mho-jwi/MA/Minitab/Auswertung/160803Präsi.pptx

Problem: Nur Variation der AUL-nicht der ABL-Temperatur
- Vermengung der Effekte von Membrantemperatur und Temperaturdifferenz
- Bei geringen Temperaturdifferenzen (T_AUL = ca. 21 °C) hohe Fehler

Temperaturaußreißer beseitigt
Bei Tm = 25 (T_AUL = 30) läuft der Wärmetransport in die entgegengesetzte Richtung, der k-Wert weicht stark von den anderen ab, sonst keine Anderen Randbedingungen gegenüber den
Bei ca. 18 °C gibt es einen sehr großen Sprung, unwahrscheinlich.
Evtl. durch Nähe zu T_ABL

## Slide 2

Wirkung auf Sensible Größen scheint aber Hauptsächlich von den Temperaturen beeinflusst zu werden

Nur ein Haupteffekt betrachtet, der Wahrscheinlichste
Tm
Wiederanstieg des k-Wertes bei Temperaturen um den Gefrierpunkt (vereisen?)

## Slide 3

Auch Bei den latenten Größen kommt der Haupteinfluss aus den Temperaturgrößen
Gleiches Problem wie eben, keine Trennung von dT und Tm möglich

Manuell keine Effekte erkennbar
