mho-jwi/MA/(B) Klimaprüfstand/Doku/Luftanschluesse.pptx

## Zuluft-Sorptionstrockner

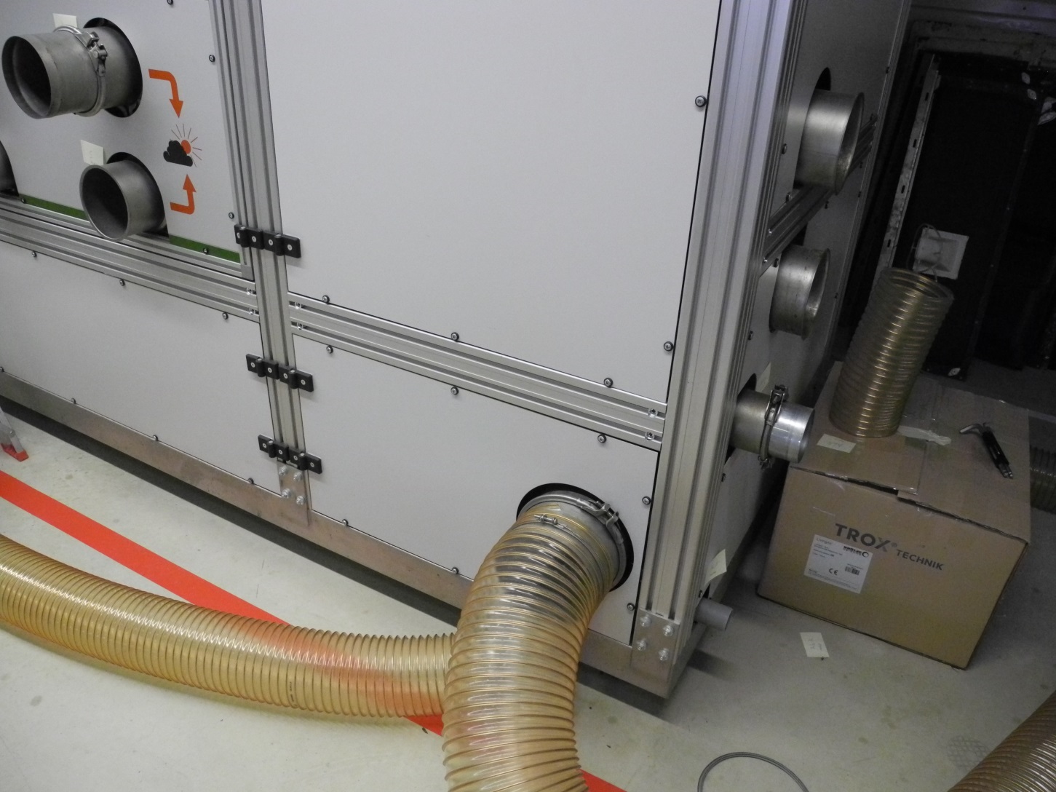
[picture p7: figure]

Ø 200 mm

## Prüfstand-Prüfling

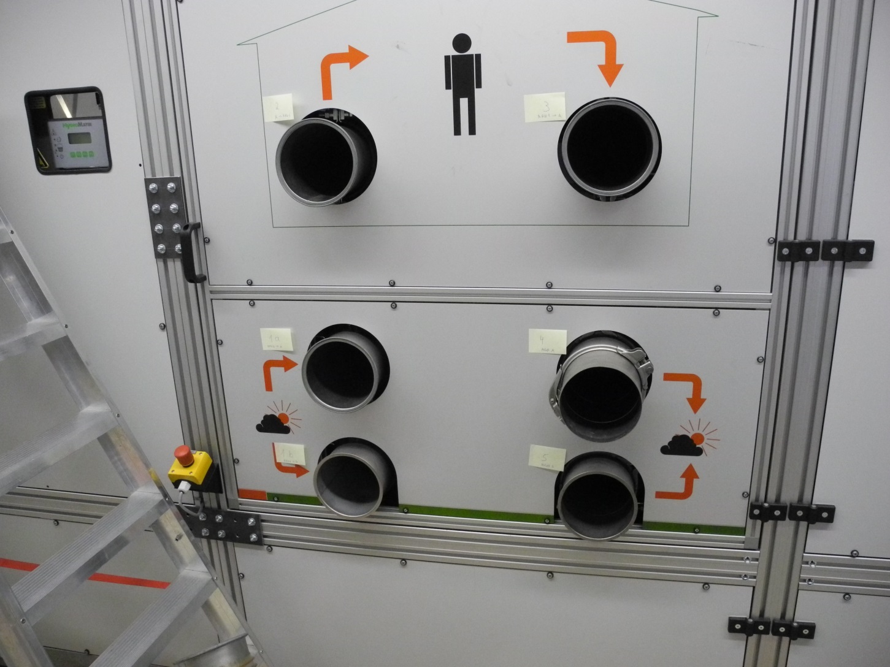
[picture p8: figure]

Ø 150 mm

## Abluft-Sorptionstrockner

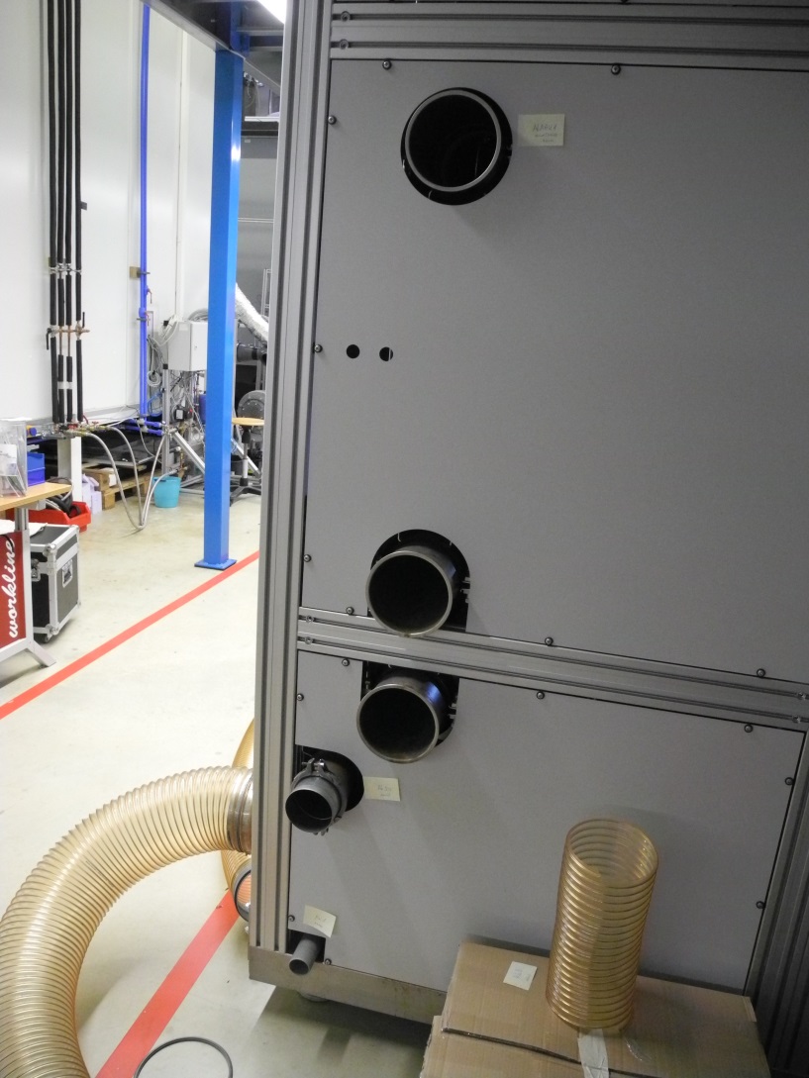
[picture p9: figure]

Ø 100 mm

## Sorptionstrockner

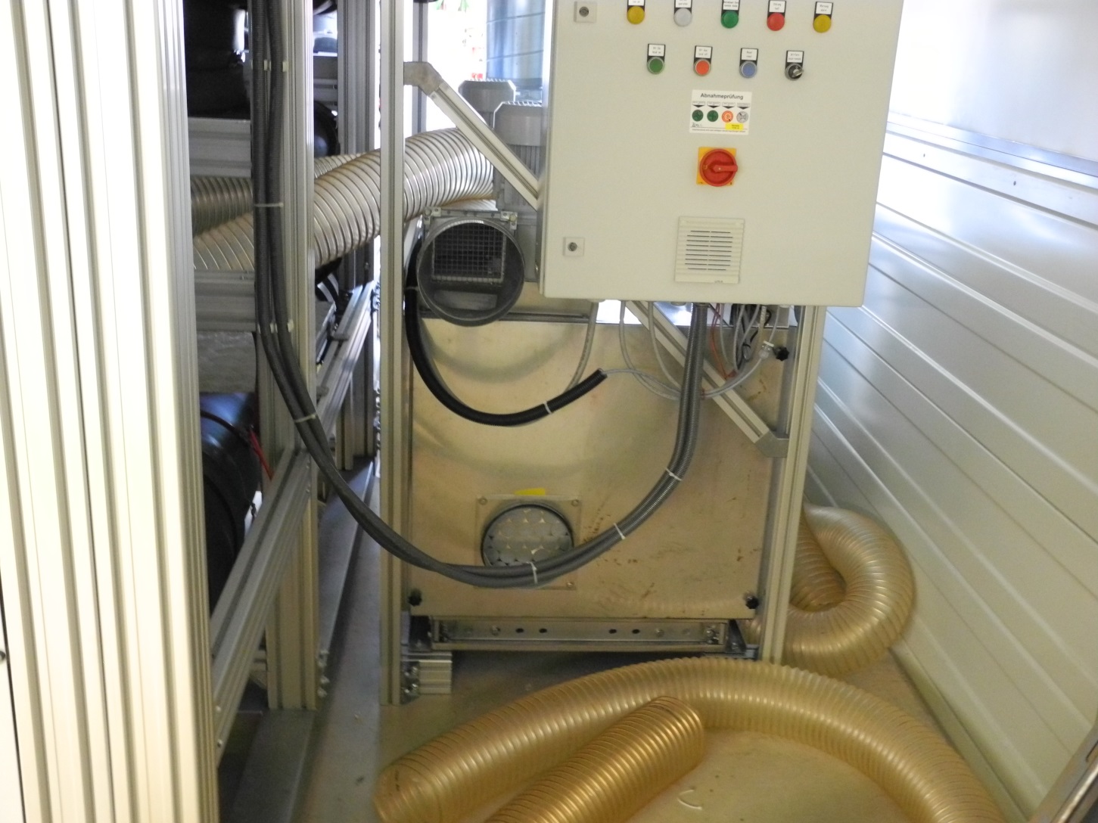
[picture p10: figure]

Ø 195 mm

## Lüfter

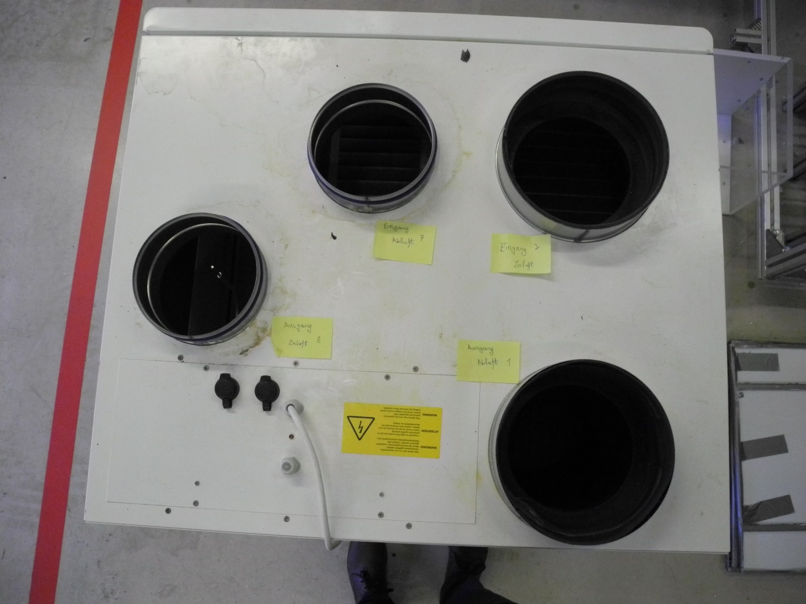
[picture p11: figure]

Ø 160 mm
(Außendurch-messer mit Gummilippe)

ohne Falz und Gummilippe

Ø 210 mm

## Bestellung

- DN 200 Luftschlauch
- Adapterstücke Lüftung:
