mho-jwi/MA/(B) Klimaprüfstand/Spezifikationen/KühlmöglichkeitenV2.pptx

Ausgangssituation

25kW

Prüfstand

22kW

Kältemaschine

Sorptionstrockner

T = 12°C
V`= 6900l/h

T = 6°C
V`= 6900l/h

3kW

T = 6°C
V`= 1230l/h

7kW

T = 6°C
V`= 1000l/h

T = 12°C
V`= 1230l/h

T = 12°C
V`= 1000l/h

## Optionen

1. Tieftemperatur über KM 2 + HIL 1
  1. 2230 l/h Kühlwasser (6/12)
2. Tieftemperatur über Bosch Kältemaschine
  1. 6730 l/h (9130 l/h) Kühlwasser (6/12)
In beiden Fällen: 7,5 °C Vorlauf technisch sinnvoll? Einschränkungen?

## Slide 3

Option 1

Hier müssen Sekundärseitig 10 °C Lufttemp. erreicht werden, =>ist mit höherem Massenstrom und den 8°C Vorlauf die gewünschte Temp. Erreichbar?

Prüfstand

22kW

Sorptionstrockner

T = 12°C

3kW

T = 6°C
V`= 1230l/h

7kW

T = 6°C
V`= 1000l/h

Volumenstrom leicht erhöhen, dazu kann Regeltemperatur (Rücklauftemperatur auf Primärseite) leicht gesenkt werden, z.B. Normtemp = 12°C

T = 12°C

10kW

Wärme-tauscher I

T = 15 / 8 °C
V`= 1070 l/h

T = 8°C
V`= 1140 l/h

10kW

T = 8/ 15°C
V`= 1070 l/h

Wärme-tauscher II

Pinch jeweils an der kleinsten Temp., da cp von Kühlwasser > cp Luft

## Slide 4

Option 1

Kältemaschine

Prüfstand

22kW

Sorptionstrockner

3kW

T = 6/12 °C
V`= 1230 l/h

7kW

Laut Bosch
T = 6/12 °C
V`= 1000 l/h

T = 6/12 °C
V`max= 1000 l/h

10kW

Wärme-tauscher I

T = 8 / 12 °C
V`= 2142 l/h

10kW

Wärme-tauscher II

T = 8/ 12°C
V`= 2142 l/h

Pinch jeweils an der kleinsten Temp., da cp von Kühlwasser > cp Luft

## Slide 5

Option 1

Der Massenstrom, der mit dem Wärmetauscher gekühlt wird, hängt an eine Luftkreislauf mit geringer Hysterese=> es wird normalerweise nicht die volle Range von -17 bis +20°C genutzt werden sondern nur eine kleine Spanne.

25kW

5000 l/h
-17°C

Kältemaschine

1400 l/h ????

20°C

Prüfstand

22kW

3600 l/h
-17 °C???

20°C ???

Kältemaschine

20kW

4100 l/h
-20°C

500 l/h ????

## Slide 6

Mit einem 25 kW Wärmetauscher würde die Leistung genau aufgehen, aber die Temperaturdifferenz zwischen Primär- und Sekundärkreislauf ist geringer als angegeben, daher wird ein 30 kW Wärmetauscher gewählt und die ein höherer Massenstrom durchgesetzt

Option 2

Kältemaschine

T = 8/12°C
V`= 5357l/h
(Bei 25 kW)

25kW

Prüfstand

T = 12°C

22kW

3kW

Sorptionstrockner

T = 8°C
V`= 1230l/h

T = 12°C

7kW

T = 8°C
V`= 1000l/h

Die Temperaturdifferenz zwischen Primär- und Sekundärkreislauf ist geringer als angegeben, daher wird ein 15 kW Wärmetauscher gewählt und die ein höherer Massenstrom durchgesetzt,
Unklar ist die Regelung der Wärmetauscher. Evtl kann der Sorptionstrocker, bzw. der die AHU das nicht selber und man muss eine eigene Regelung mittels eines Bypasses und Drosselklappen implementieren

30kW

Wärme-tauscher I

T = 8/12 °C
V`=6428 l/h

Wärme-tauscher II

15 kW

T = 8/ 12°C
V`= 3214 l/h

## Fragen intern

- Kann ich messen welche Temperatur an den WT rauskommt?
- Welche Temperaturdifferenz zwischen Primär- und Sekundärseite brauch ich im Pinch normalerweise bei einem WT?
- Gibt es Faustformeln mit der ich ermitteln kann welche Auswirkungen eine kleiner Temperaturdifferenz auf die zusätzlich benötigte Leistung hat?
- Wie hoch ist die maximale Strömungsgeschwindigkeit in einer Leitung?
- Gibt es noch eine zweite Kältemaschine? Wo finde ich die? Was kann die?
- Gibt es sonst noch Kühleinheiten mit denen ich die Temperatur aus der Fernkälte einfach auf 6 °C Vorlauf drücken kann, ohne das was Einfriert?
- Kann ich tatsächlich einfach so die Sollrücklauftemperatur in der Steuerung ändern?
- Kann ich den sich entsprechend ergebenen Wärmestrom mit der Annahme einer Konstanten Leistungsübertragung berechnen? Wie sonst (Faustformel)?
- Wie kann ich auf die Steuerung der WT zugreifen?
- Wenn ich größere Wärmeübertrager einbauen will, mit wem spreche ich da? Gibt es da Beschränkungen?

## Slide 8

T = 6/12°C
V`= 1000l/h

Sorp. Trockner

T = 6/12°C
V`= 6900l/h

AHU2

T = 6/12°C
V`= 1230l/h

AHU1

Prüfling B

Prüfling A

## Slide 9
