mho-jwi/MA/(B) Klimaprüfstand/Auslegung/Steuerung_Kuehlung/Regelung Kühlkreisläufe.docx

Regelung Kühlkreisläufe

Tieftemperatur:

Es wird ein Signal an die Kältemaschine übertragen

Ansonsten Ventil vorhanden

Fernkälte AHU1 : Steuermotor da, Proportionalventil nicht

Fernkälte Sorptionstrockner, keine Infos zur Steuerung
