mho-jwi/MA/Vorlage_Latex_dt/Chapters/Formeln.tex

Formeln für die Masterarbeit

Versuchsplanauslegung
	Bewertungsgrößen für die Versuchsplanauswahl
	\squrt{det(A^T*A)}*V(S)
