mho-jwi/MA/(A) Literatur/Paper zu Enthalpieübetragern/AVT_Projekt/Ausschnitt, AVT Projekt, Sebastian Koester.pptx

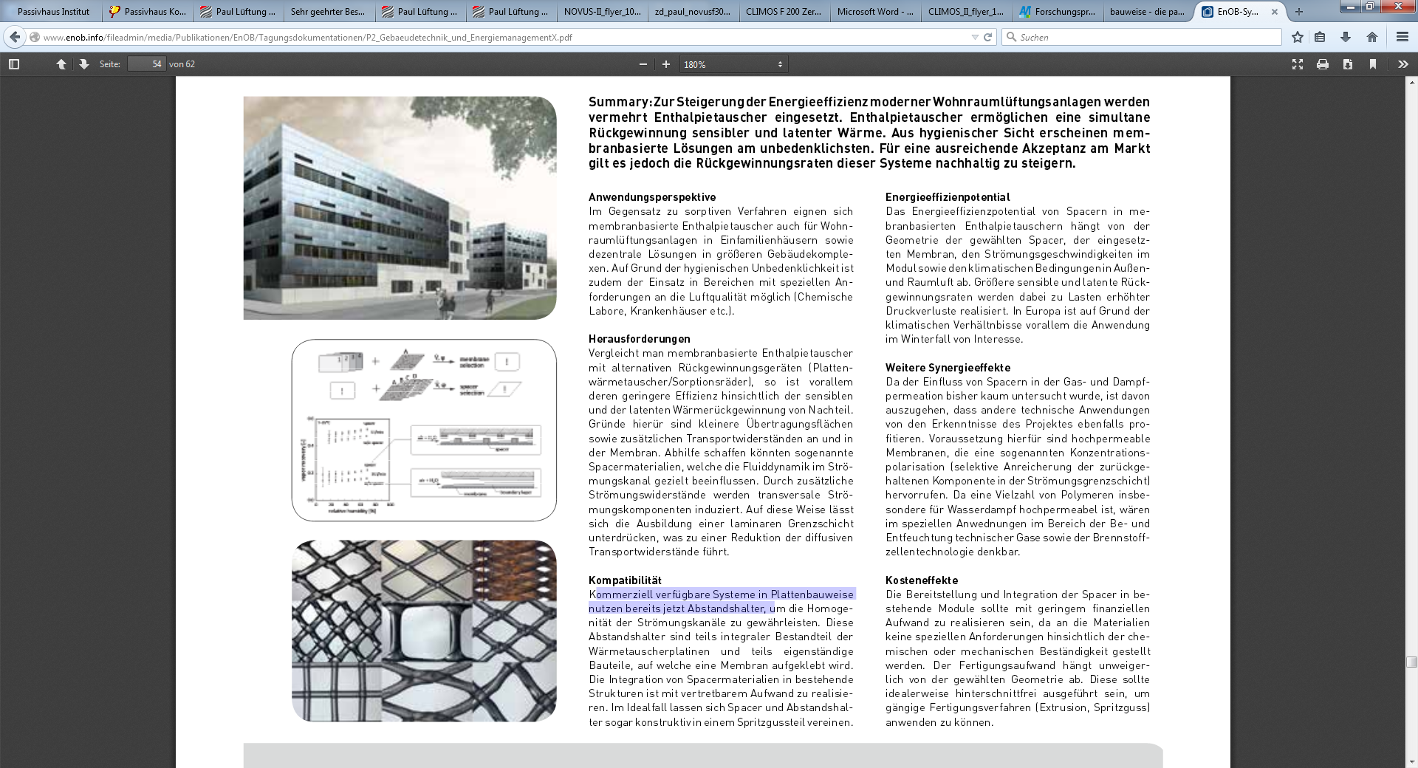
[picture p19: figure]
