mho-jwi/MA/Day_tracker.pptx

27.06.
- Kalibriermessungen mit Silikatkissen
  - Aufbauen des Versuch
  - Durchführen
  - Abbauen
  - Erste Datenaufbereitung
- Wassernachfüllen Fernkälte-Vorkühler-Trockner
- Fenster-Abluft
- Sorpitonstrocknersicherung
- PVC-Stücke für Sensoraufnahme angebracht und bestückt

## Slide 2

28.06
- Endgültiger Abbau Kalibrierversuch
- Einbau Feuchtesensoren
- Box Verschließen
- Boschprofile anbringen
- Datenaufbereitung der Kalibriermessung abschließen
- In Matlabskripte einlesen

## Slide 3
