mho-jwi/MA/Vorlage_Latex_dt/Struktur.docx

1 Einleitung
  1.1 Motivation
  1.2 Enthalpieübertrager
  1.3 Grundlagen der Membrantechnologie
  1.4 Stand der Technik
2 Physikalische Grundlagen
  2.1 Definitionen und asdf
  2.2 Grundlagen des Stofftransportes
    2.2.1 Sorption an der Membranoberfläche
    2.2.2 Diffusion durch dichte Membran
    2.2.3 Diffusion durch poröse Membran
    2.2.4 Stofftransport im Luftstrom
    2.2.5 Zusammenfassung der Transportprozesse
3 Geometrie und Aufbau des Enthalpieübertragers
4 Prüfstand/ Anlagenaufbau
  4.1 Aufbau und Systematik der „Air Handling Unit“
  4.2 Aufbau und Systematik der Anströmbox
  4.3 Genauigkeit der Versuchsrandbedingungen
  4.4 Messsensoren
    4.4.1 Position und Verteilung Temperatursensoren
    4.4.2 Position und Verteilung Feuchtesensoren
5 (Versuchsdurchführung)
6 Auswertung
  6.1 Durchströmung und Homogenität der Fortluft- und Zulufttemperatur
    6.1.1 Korrektur der Zuluft- und Fortlufttemperatur
  6.2 Empirisches Modell, welche Haupteffekte treten auf
  6.3 Einfluss von counterflow und crossflow
7 Fehleranalyse
  7.1 Sensitivitätsanalyse
8 Ausblick
