mho-jwi/MA/Vorlage_Latex_dt/Technischer_plan.pptx

FK

SORP.T.

Regenerationsluft

WÜTV

TK

AHU2

LUE

WÜT2

BF2

LH2

T3-AHU2

T2-AHU2, ϕ1-AHU2

T1-AHU2, ϕ1-AHU2

T

H

T

T

H

Vent-Prüf

T

H

TAUL, ϕAUL

Prüfbox

TABL, ϕABL

Vent-AHU2

FK

TZUL, ϕZUL

T

H

AHU1

T1-AHU1, ϕ1-AHU1

T

H

WÜT1

BF1

T3-AHU1

LH1

TFOL, ϕFOL

T2-AHU1, ϕ2-AHU1

T

T

H

T

H

T

H

## Slide 2

FK

WÜTV

SORP.T.

Regenerationsluft

AHU2

TK

WÜT2

T2-AHU2, ϕ1-AHU2

LUE

BF2

LH2

T3-AHU2

T

H

T1-AHU2, ϕ1-AHU2

T

H

T

Vent-AHU2

Vent-Prüf

TAUL, ϕAUL

5*TZUL

T

H

AHU1

FK

Prüfbox

T

H

T

TZUL-ϕ, ϕZUL

TABL, ϕABL

T1-AHU1, ϕ1-AHU1

T

H

WÜT1

BF1

LH1

T3-AHU1

T

TFOL-ϕ, ϕFOL

T

H

5*TFOL

T

T

H

T2-AHU1, ϕ2-AHU1

T

H
