mho-jwi/MA/Vorlage_Latex_dt/Pictures/Geometrie_Enthalpieuebertrager.pptx

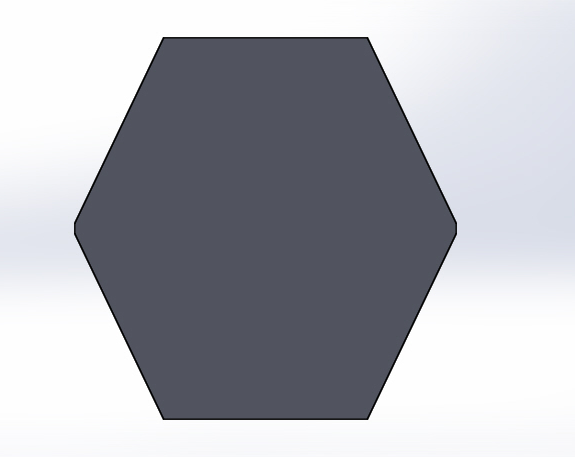
[picture p20: figure]
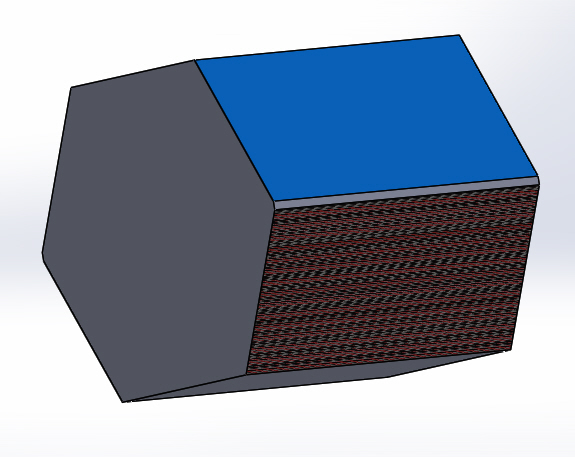
[picture p21: figure]

y

z

x
