mho-jwi/MA/Vorlage_Latex_dt/Pictures/Membran.pptx

Feed

z

Index

f

x

Q

ṁw

m

Sweep

p
