mho-jwi/MA/Vorlage_Latex_dt/Pictures/Schaubilder.pptx

Feed

Index

mf

f

m

q

ṁw

mp

p

Permeate/ sweep

## Slide 2

Feed

Ab

FOL

q

ṁw

ZUL

Permeate

AUL

## Slide 3

Transportprozesse in einer asymmetrischen Membran

4. Sorption an der Membranoberfläche

5. Diffusion und Konvektion durch poröse Membran

6. Diffusion durch Gas in z-Richtung

1. Diffusion durch Gas in z-Richtung

2. Sorption an der Membranoberfläche

3. Diffusion durch dichte Membran

1./6. Aufgrund von Diffusionsprozessen und ggf. Turbulenter Durchmischung wird Wasser zur Membran Transportier
2./5. Sorption an der hydrophilen Membranoberfläche
3. Diffusion durch dichte Membran, Triebkraft chemische Potentialdifferenz,
4. Diffusion durch poröse Membran, Triebkraft chemische Potentialdifferenz,
bei größeren Poren evtl. durch Konvektion

## Slide 4

Umgebung/ AHU1

Außenluft (AUL)

Fortluft (FOL)

Raum/ AHU2

Abluft (ABL)

Zuluft (ZUL)

Kreuz

Gegen

Kreuz

x

z

y

## Wichtige Eigenschaften des Enthalpieübertragers für die Modellbildung

- Geometrie: Cross- oder Counterflow
- Membran: Porous, Dent, combinated, dent membrane with pores

## Wichtige Annahmen

- Strömung:
  - Laminar
  - Grenzschichtbildung
  - Diffusion in Gas als Transportprozess
- Ausgleich Energie von Absorption und Desorption
- Stofftransport in der Membran nur in z-Richtung
- Stofftransport aufgrund von Diffusion in der Gasphase nur in z-Richtung, Wärmeleitung auch, wenn Pe =Re*Pr > 10 bzw 100 ist. Effekt eher bei flüssigen metallen (kleines Pe) wichtig
- mw << ml
- Stationarität
- Konstante Materialeigenschaften der Membran (über T, p und h)
- Linear Steigung von T und theta in der Membran

(o) optional, (g) gängig, (m) zwangsläufig

## Slide 7

mw

mx

mx - mw ≈ mx

## Slide 8

mwy1

mgy1

mwx1

mwx2

mgx1

mgx2

mwy2

mgy1

## Slide 9

feed

mwy1

mgy1

mwx1

mwx2

mx2 ≈ mx1

mx2 ≈ mx1

mgx1

mgx2

mwy2

mgy1

## Slide 10

mwy1

mgy1

mwx1

mwx2

mgx1

mgx2

mwy2

mgy1

## Slide 11

mwy1

mgy1

mwx1

mwx2

mgx1

mgx2

mwy2

mgy1

## Slide 12

mwy1

mgy1

mwx1

mwx2

mgx1

mgx2

mwy2

mgy1
