mho-jwi/MA/(B) Klimaprüfstand/Auslegung/Komponenten/Herstellerdatenblätter/Hygromatik_Prüfberichte Dampfluftbefeuchter.pdf

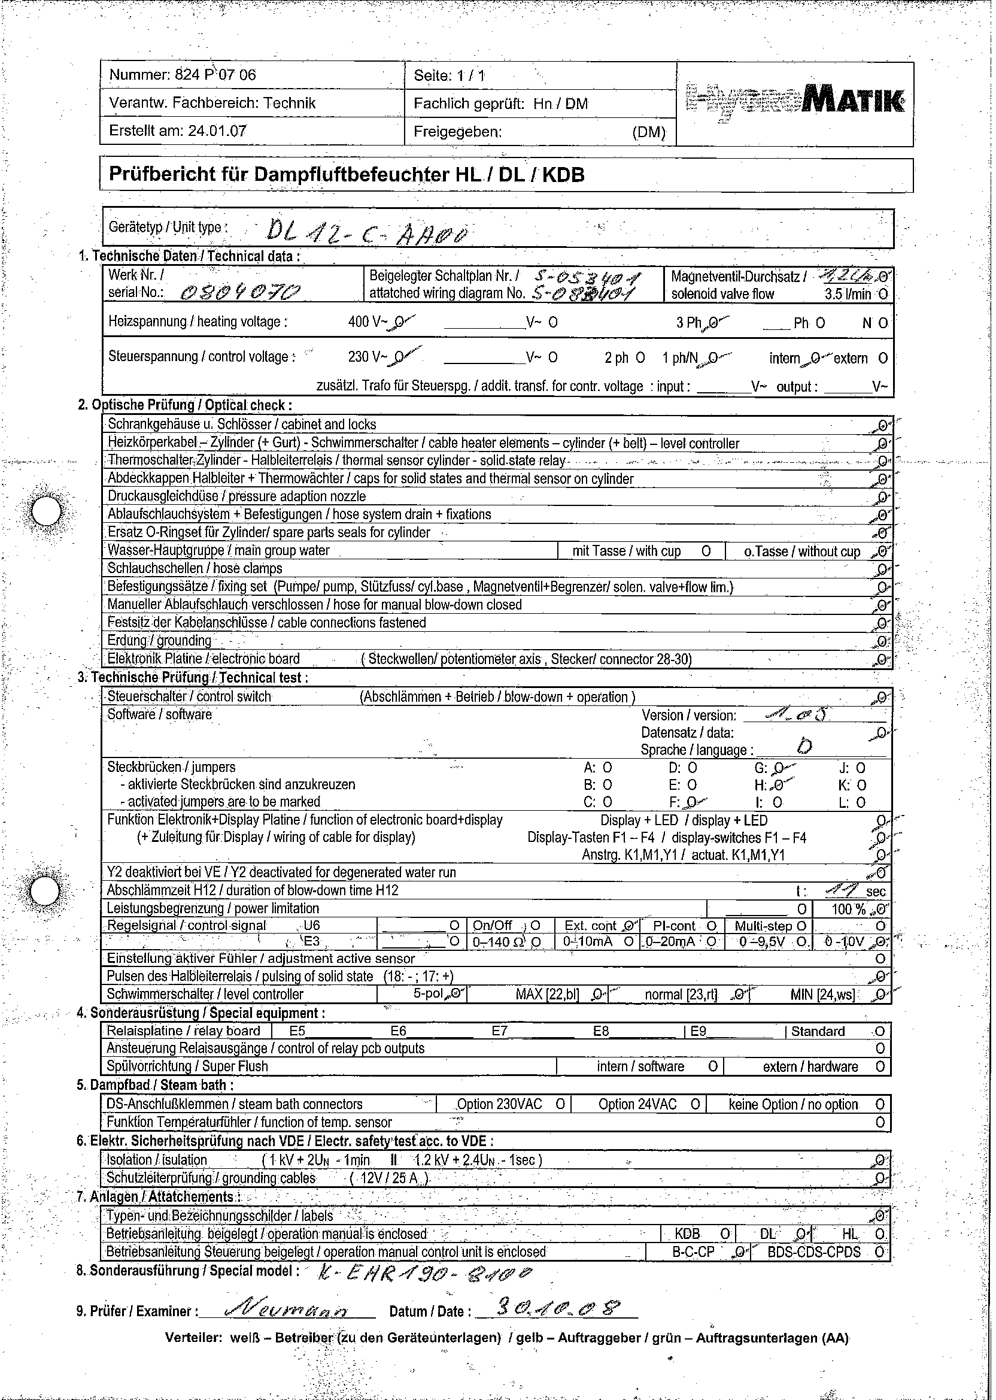
[picture p22: page 1]
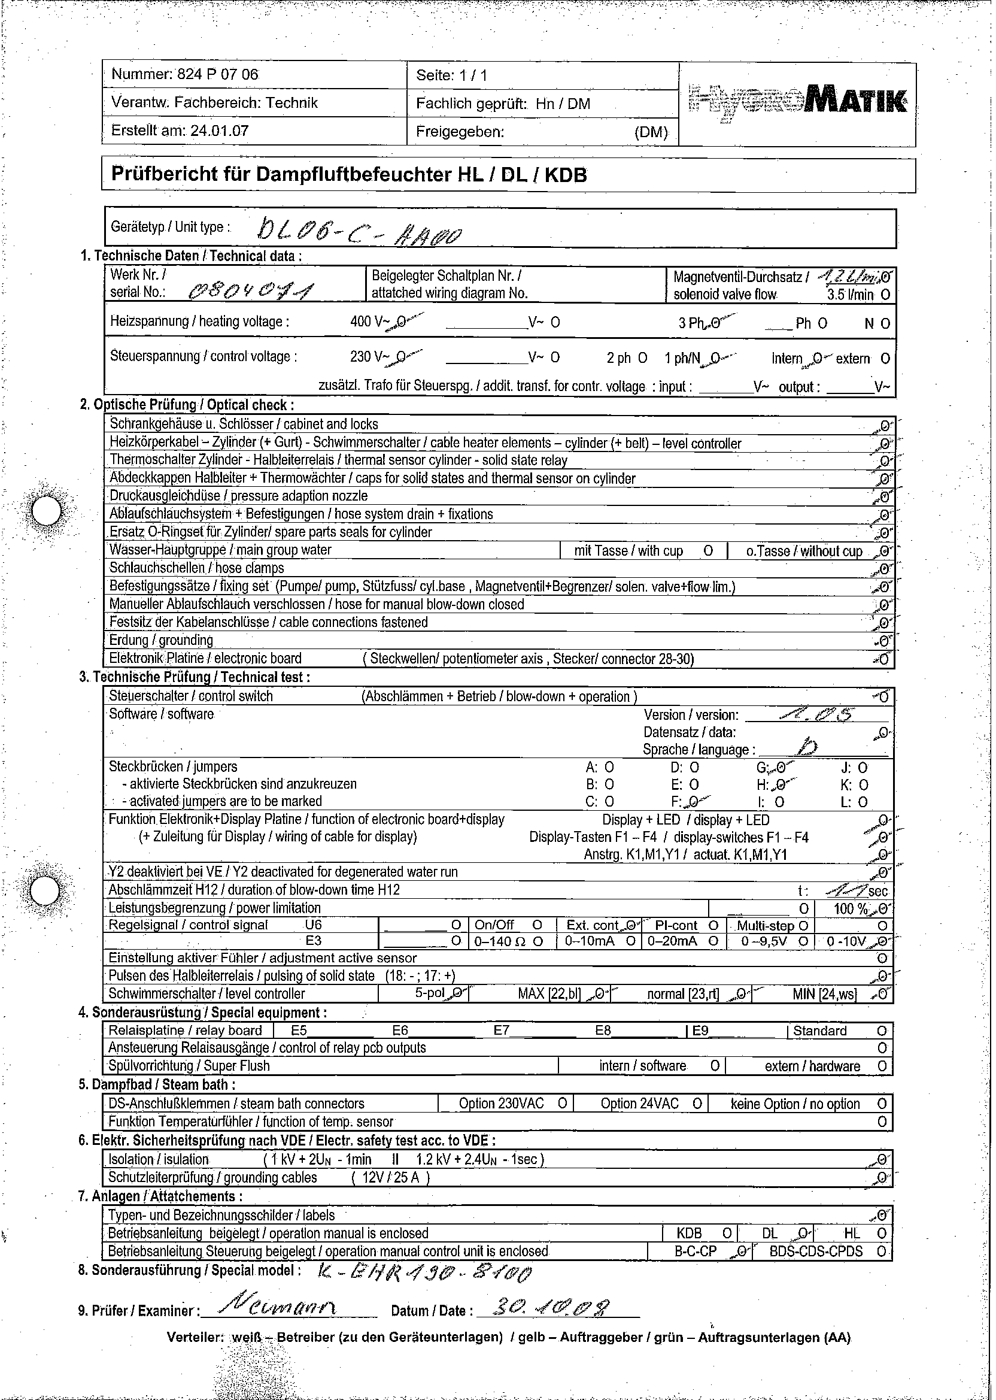
[picture p23: page 2]
