mho-jwi/MA/(A) Literatur/Paper zu Enthalpieübetragern/AVT_Projekt/AVT_Mischgasversuchsschema.jpg

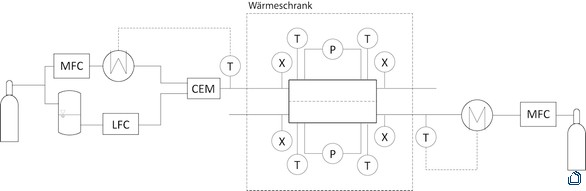
(A) Literatur/Paper zu Enthalpieübetragern/AVT_Projekt/AVT_Mischgasversuchsschema.jpg
