mho-jwi/MA/(A) Literatur/Paper zu Enthalpieübetragern/AVT_Projekt/AVT_Stofftransportschema.jpg

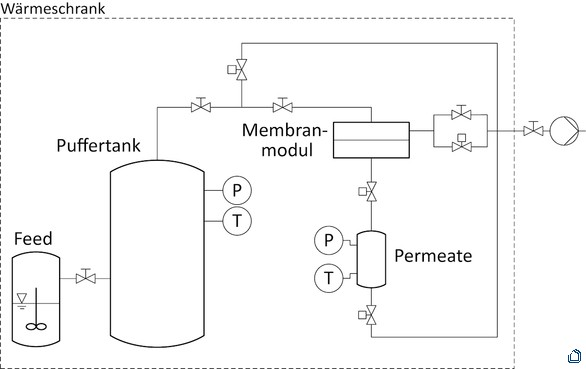
(A) Literatur/Paper zu Enthalpieübetragern/AVT_Projekt/AVT_Stofftransportschema.jpg
