mho-jwi/MA/(B) Klimaprüfstand/Bilder/20150617_165121.jpg

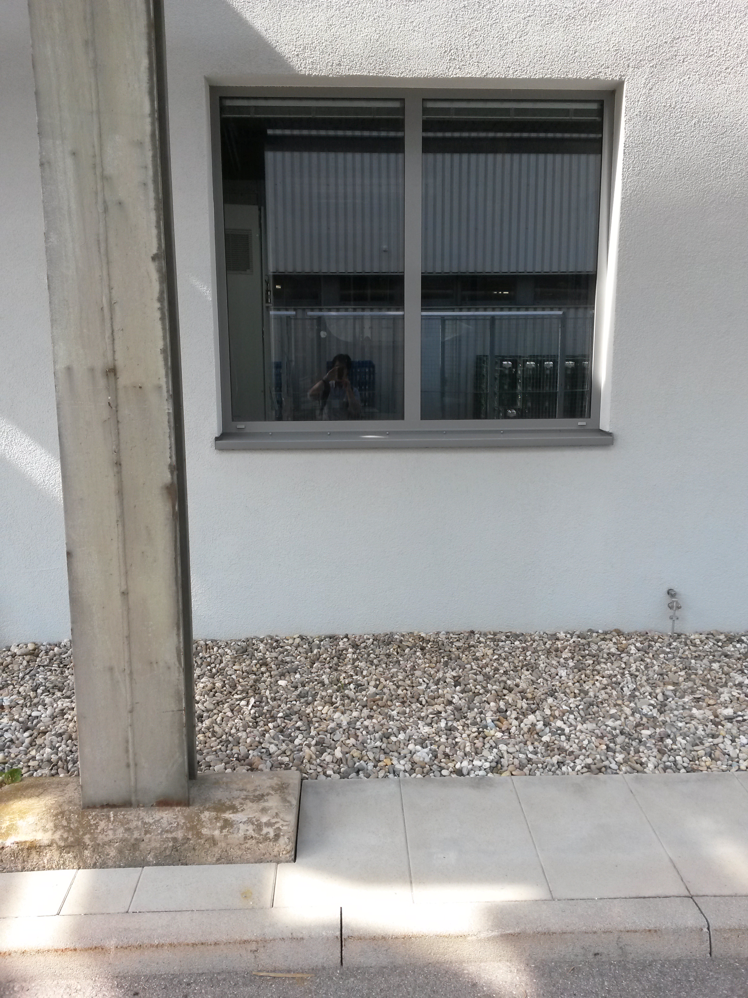
(B) Klimaprüfstand/Bilder/20150617_165121.jpg
