mho-jwi/MA/(B) Klimaprüfstand/Bilder/20150617_171242.jpg

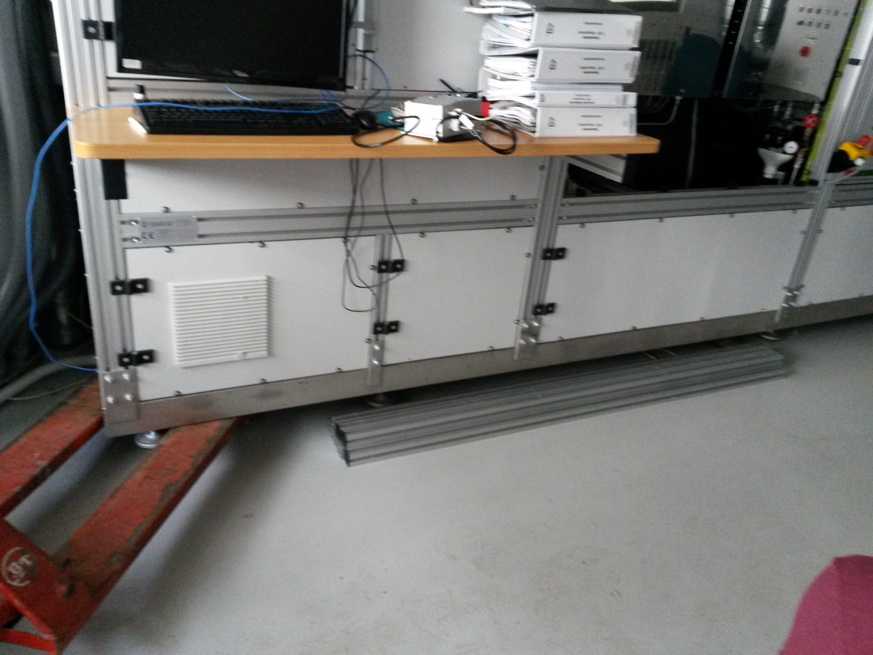
(B) Klimaprüfstand/Bilder/20150617_171242.jpg
