mho-jwi/MA/(B) Klimaprüfstand/Bilder/20150617_171433.jpg

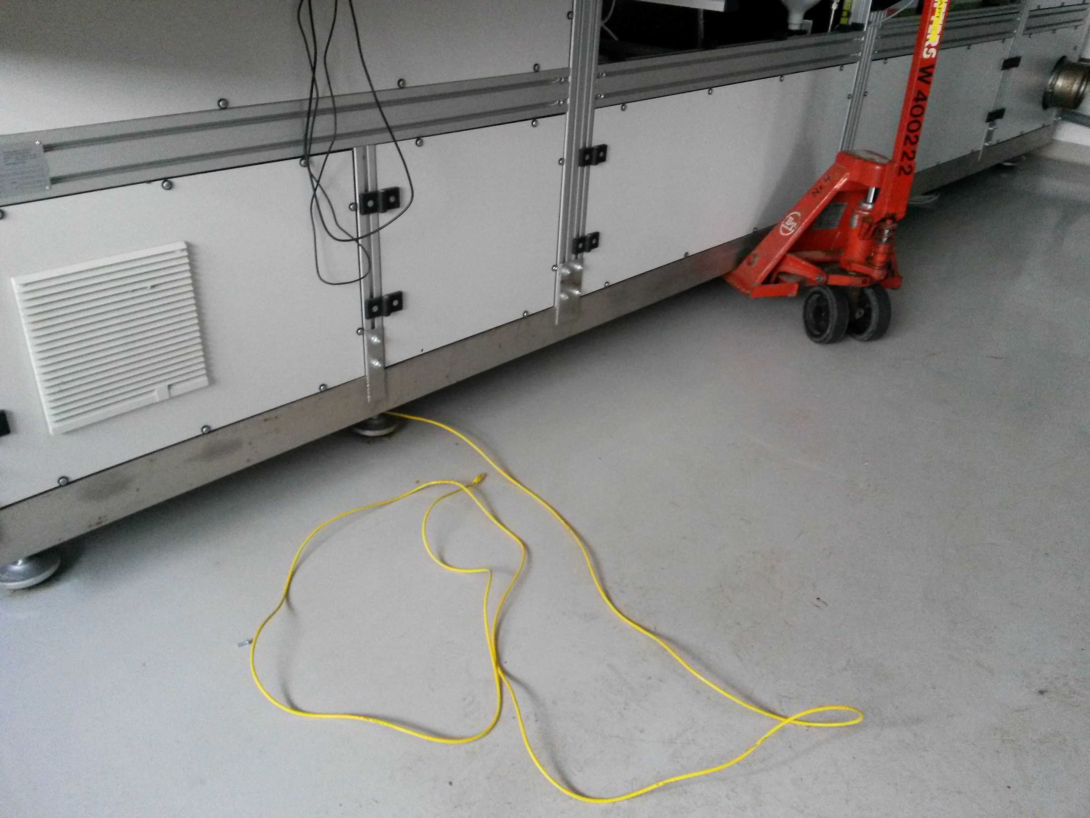
(B) Klimaprüfstand/Bilder/20150617_171433.jpg
