mho-jwi/MA/(B) Klimaprüfstand/Bilder/20150617_171909.jpg

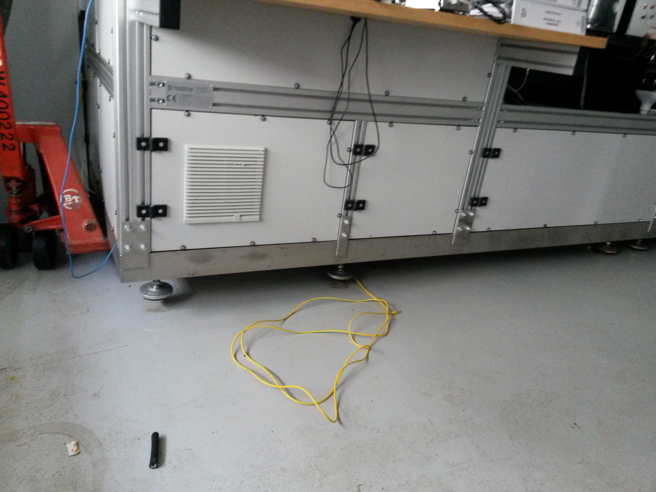
(B) Klimaprüfstand/Bilder/20150617_171909.jpg
