mho-jwi/MA/(B) Klimaprüfstand/Bilder/20150617_172515.jpg

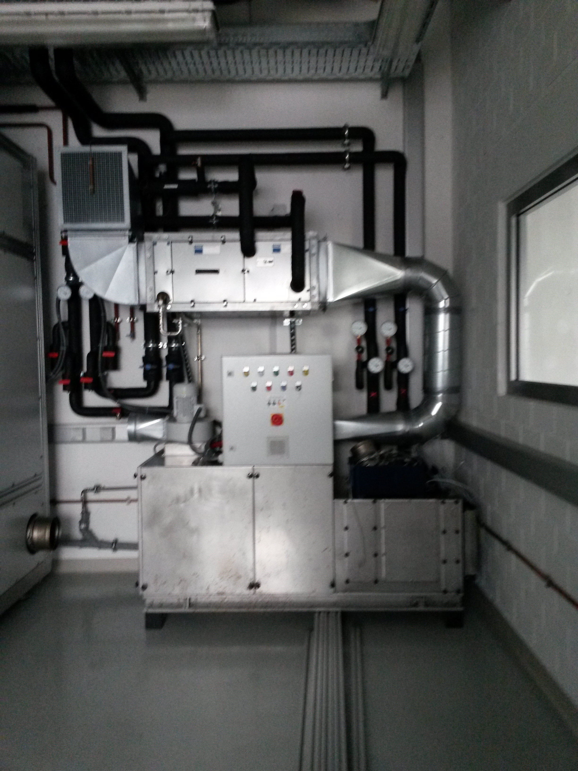
(B) Klimaprüfstand/Bilder/20150617_172515.jpg
