mho-jwi/MA/(B) Klimaprüfstand/Bilder/IMGP1656.JPG

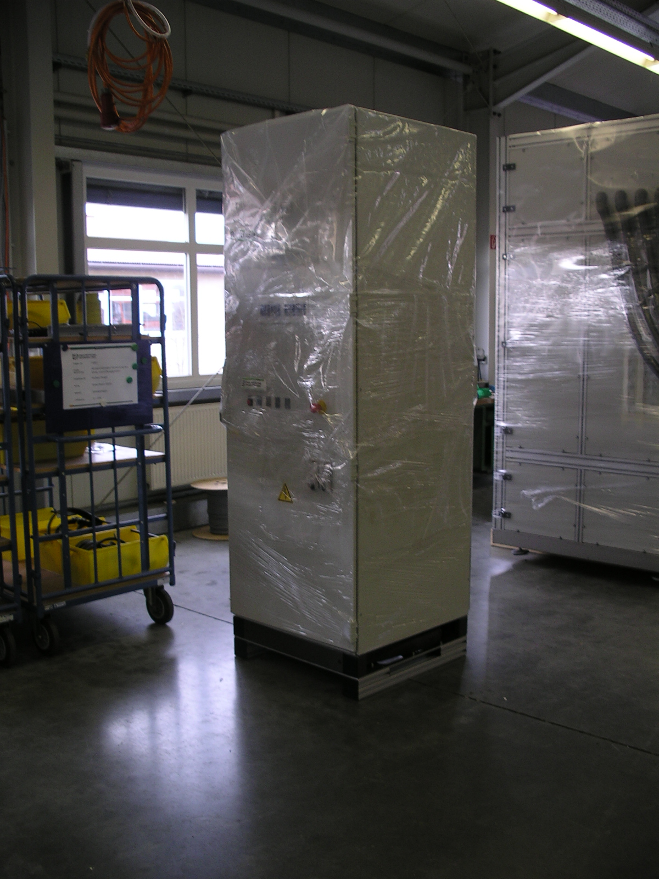
(B) Klimaprüfstand/Bilder/IMGP1656.JPG
