mho-jwi/MA/(B) Klimaprüfstand/Bilder/IMGP1657.JPG

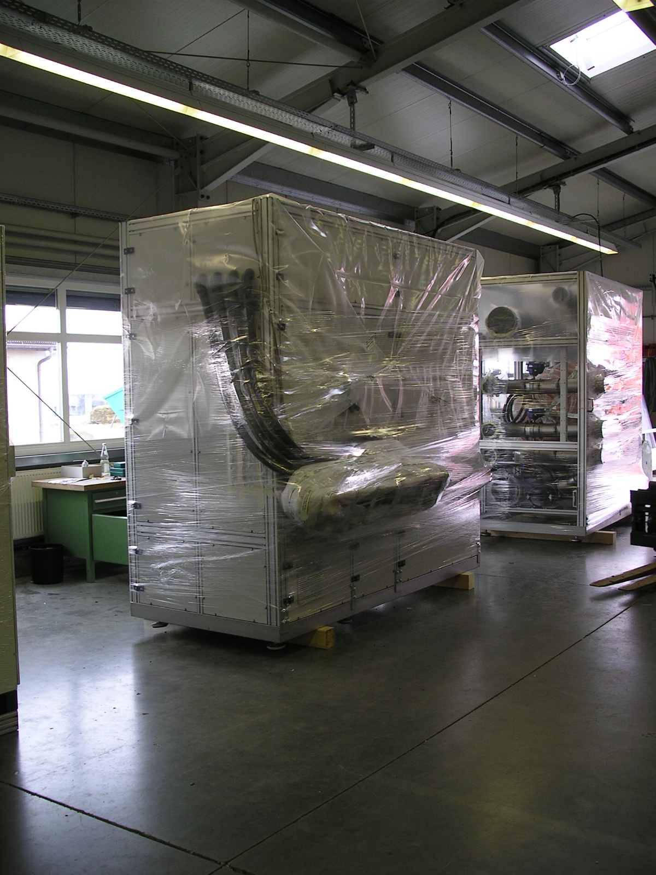
(B) Klimaprüfstand/Bilder/IMGP1657.JPG
