mho-jwi/MA/(B) Klimaprüfstand/Bilder/IMGP1658.JPG

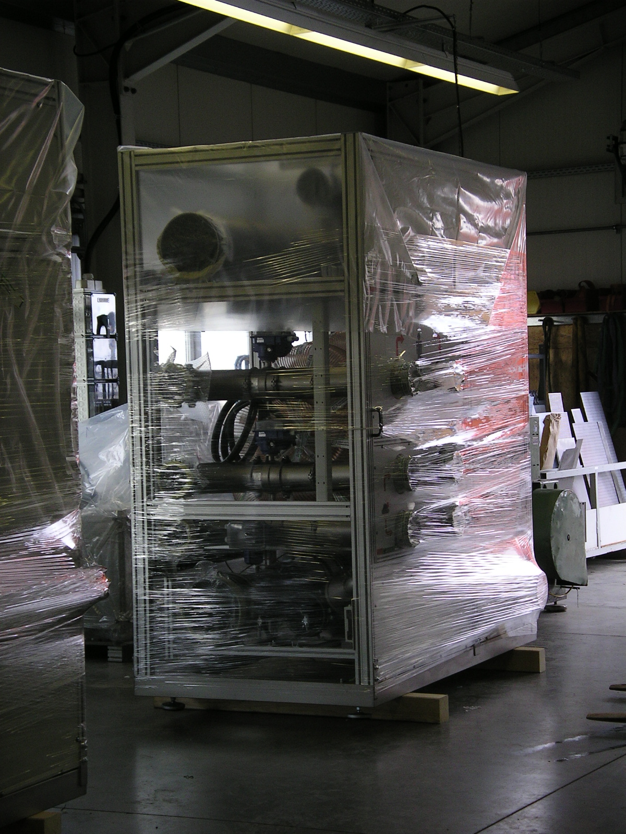
(B) Klimaprüfstand/Bilder/IMGP1658.JPG
