mho-jwi/MA/(B) Klimaprüfstand/Doku/Bilder/Fenster/DSCN5266 (2).JPG

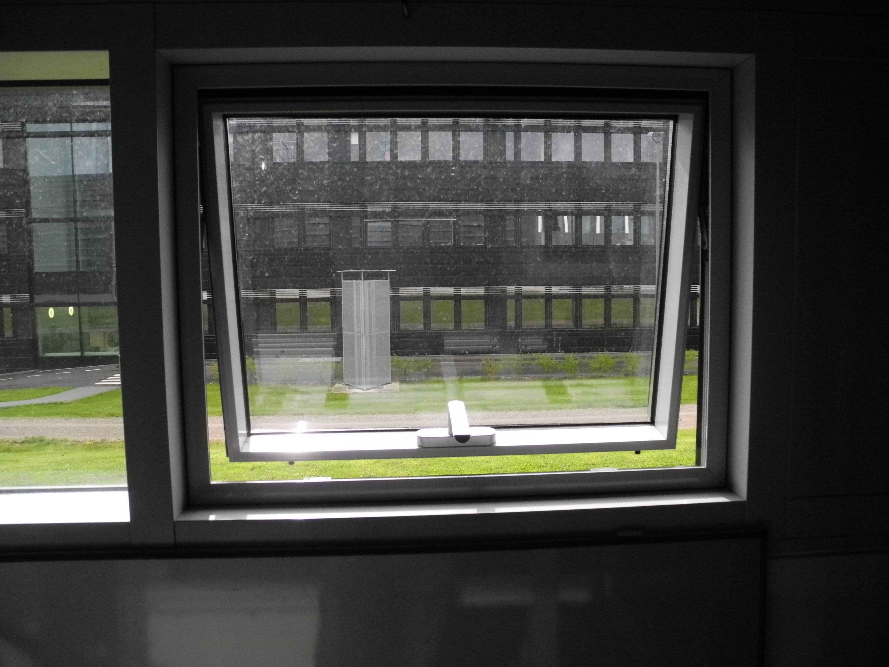
(B) Klimaprüfstand/Doku/Bilder/Fenster/DSCN5266 (2).JPG
