mho-jwi/MA/(B) Klimaprüfstand/Doku/Bilder/Fernkälte/Fernkäte_Wärmeübertrager_1/Beschriftung_FernWUT1.JPG

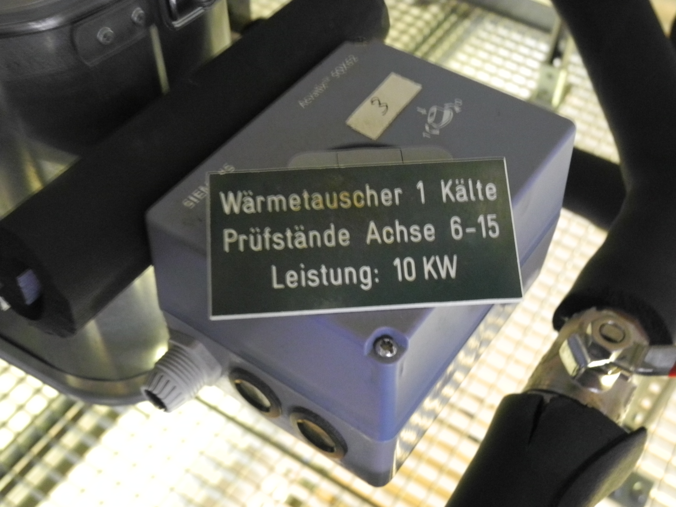
(B) Klimaprüfstand/Doku/Bilder/Fernkälte/Fernkäte_Wärmeübertrager_1/Beschriftung_FernWUT1.JPG
