mho-jwi/MA/(B) Klimaprüfstand/Doku/Bilder/Fernkälte/Fernkäte_Wärmeübertrager_2/Beschriftung_FernWUT2.JPG

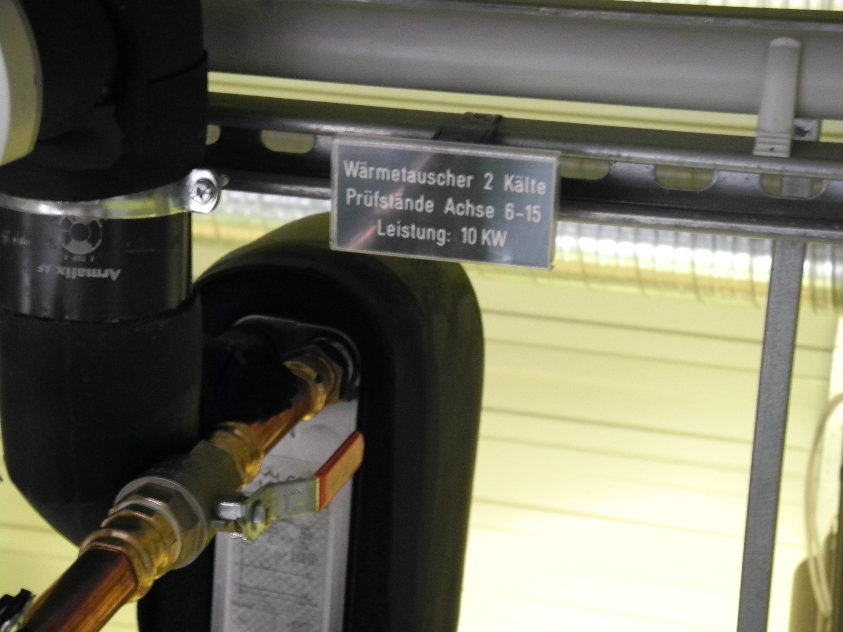
(B) Klimaprüfstand/Doku/Bilder/Fernkälte/Fernkäte_Wärmeübertrager_2/Beschriftung_FernWUT2.JPG
