mho-jwi/MA/(B) Klimaprüfstand/Doku/Bilder/Fernkälte/Fernkäte_Wärmeübertrager_2/Komponenten_FernWUT2_pic1.JPG

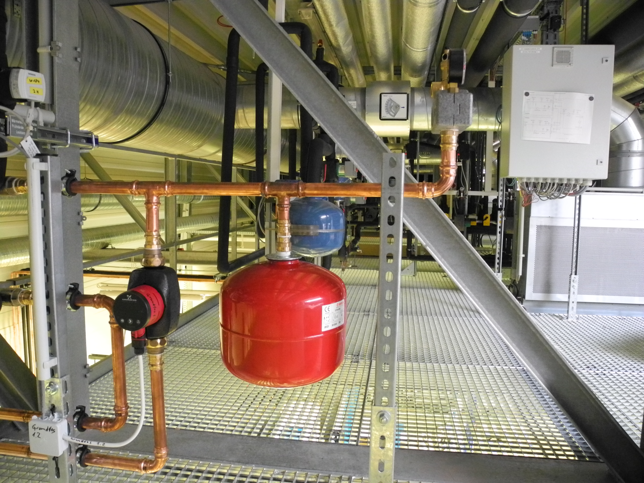
(B) Klimaprüfstand/Doku/Bilder/Fernkälte/Fernkäte_Wärmeübertrager_2/Komponenten_FernWUT2_pic1.JPG
