mho-jwi/MA/(B) Klimaprüfstand/Doku/Bilder/Lüfter/DSCN5268.JPG

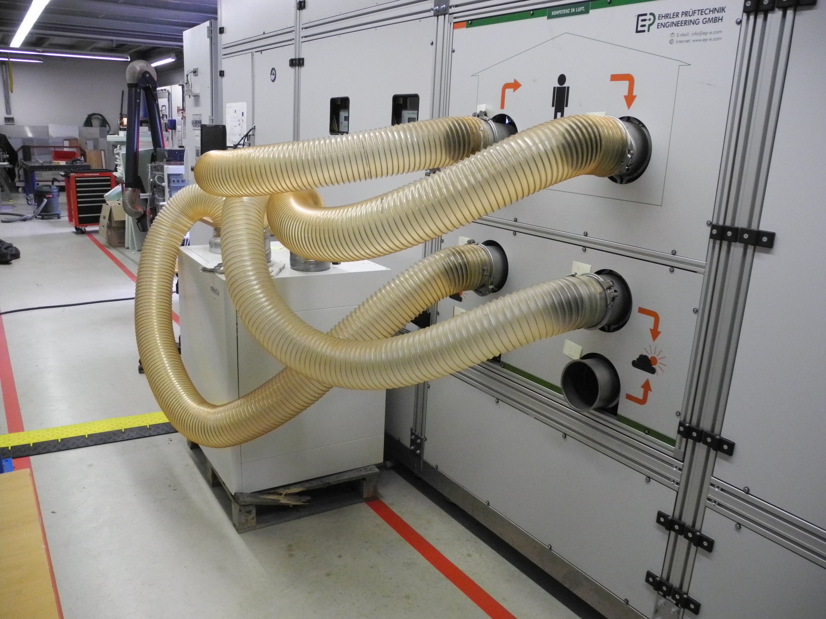
(B) Klimaprüfstand/Doku/Bilder/Lüfter/DSCN5268.JPG
