mho-jwi/MA/(B) Klimaprüfstand/Doku/Bilder/Prüfstand/Kaelteanschluss_Sorptionstrockner_pic2.JPG

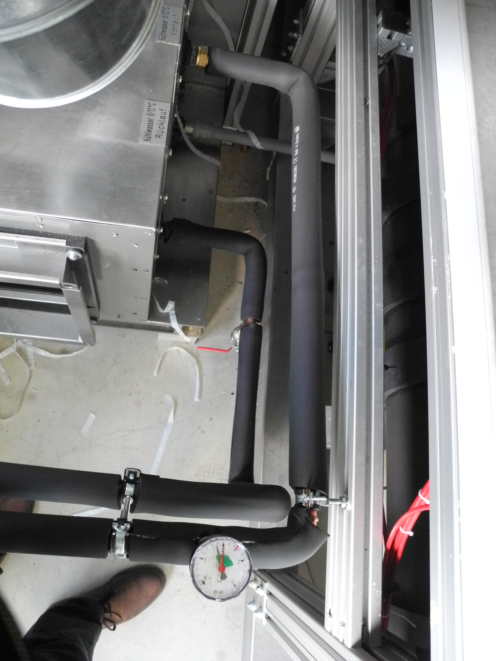
(B) Klimaprüfstand/Doku/Bilder/Prüfstand/Kaelteanschluss_Sorptionstrockner_pic2.JPG
