mho-jwi/MA/(B) Klimaprüfstand/Doku/Bilder/Prüfstand/Ventile_WUT.JPG

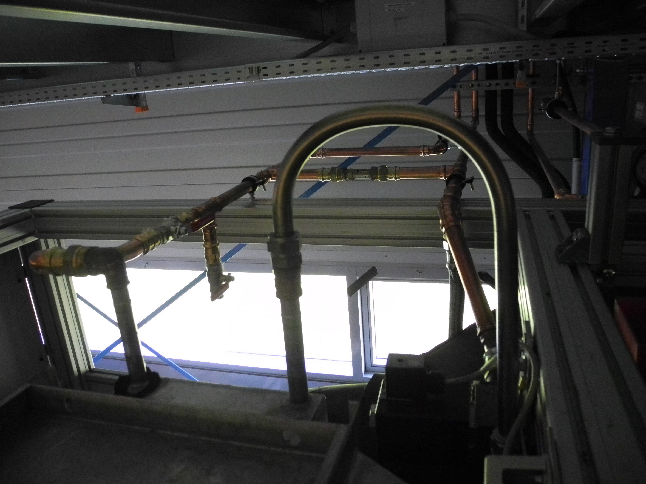
(B) Klimaprüfstand/Doku/Bilder/Prüfstand/Ventile_WUT.JPG
