mho-jwi/MA/(B) Klimaprüfstand/Doku/Bilder/Strömungsbox/DSCN5274.JPG

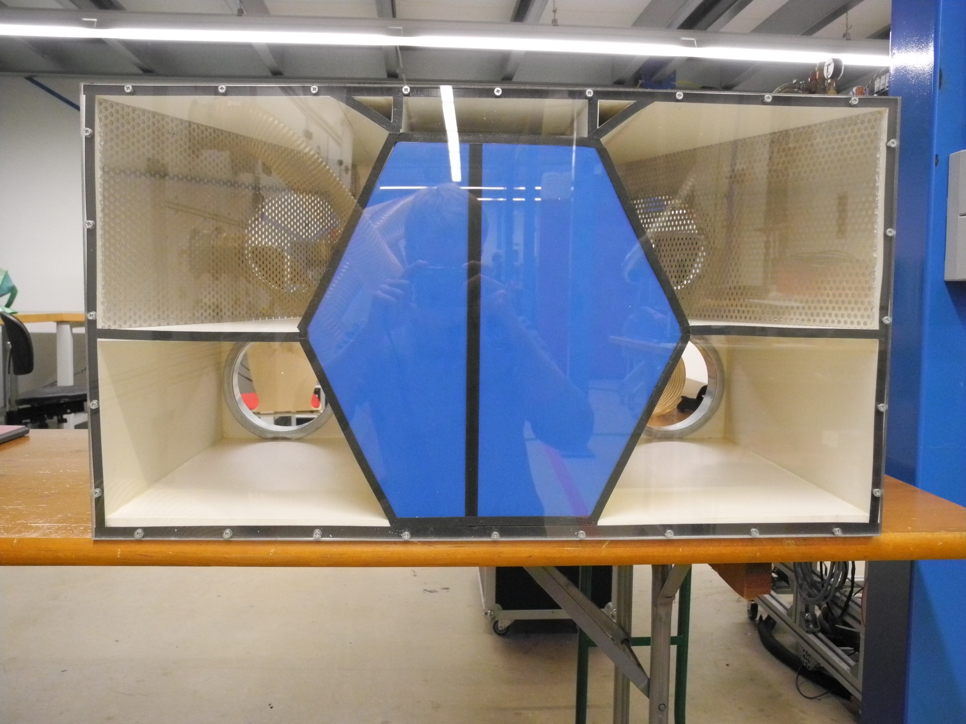
(B) Klimaprüfstand/Doku/Bilder/Strömungsbox/DSCN5274.JPG
