mho-jwi/MA/(B) Klimaprüfstand/Doku/Bilder/Strömungsbox/DSCN5276.JPG

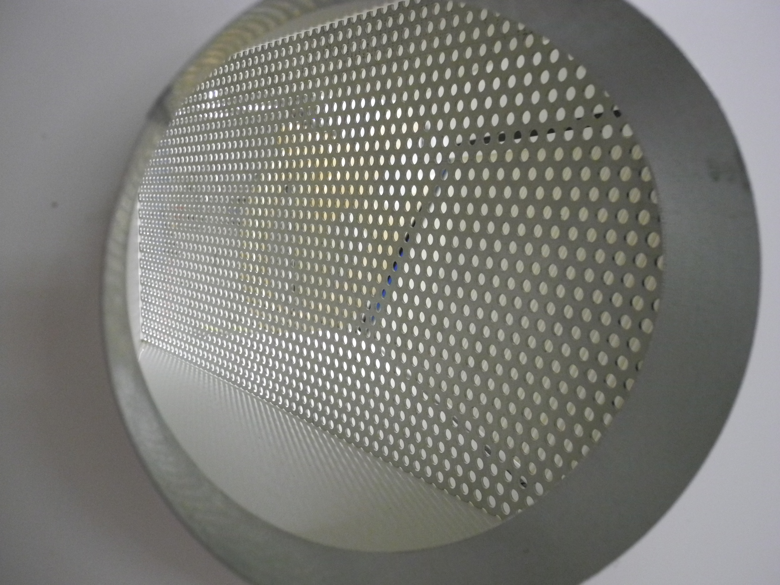
(B) Klimaprüfstand/Doku/Bilder/Strömungsbox/DSCN5276.JPG
