mho-jwi/MA/(B) Klimaprüfstand/Doku/Bilder/Strömungsbox/DSCN5277.JPG

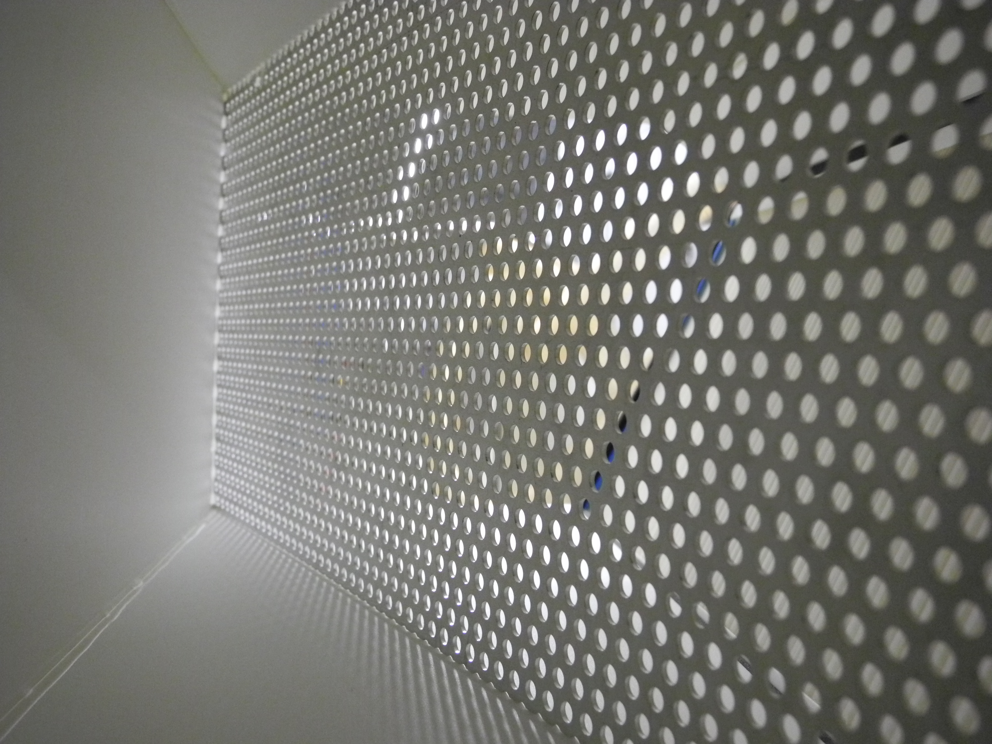
(B) Klimaprüfstand/Doku/Bilder/Strömungsbox/DSCN5277.JPG
