mho-jwi/MA/Konstruktion/Enthalpietauscher_Querschnitt.JPG

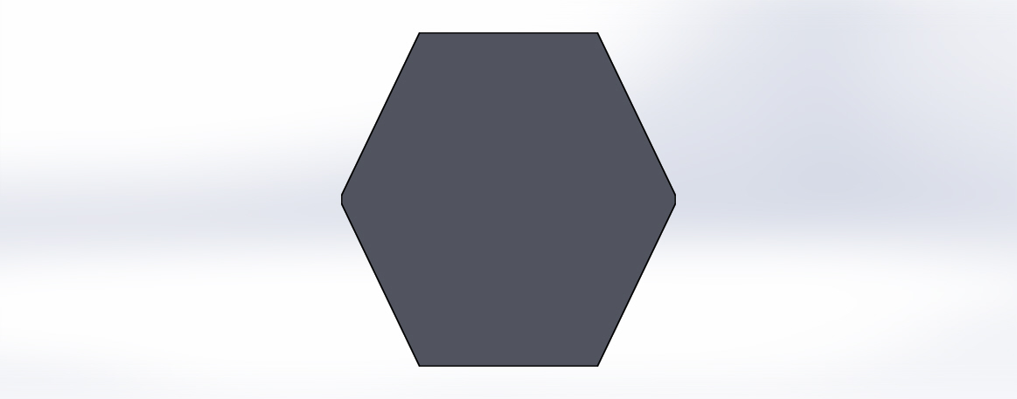
Konstruktion/Enthalpietauscher_Querschnitt.JPG
