mho-jwi/MA/Konstruktion/Enthalpietauscher_stroemung.JPG

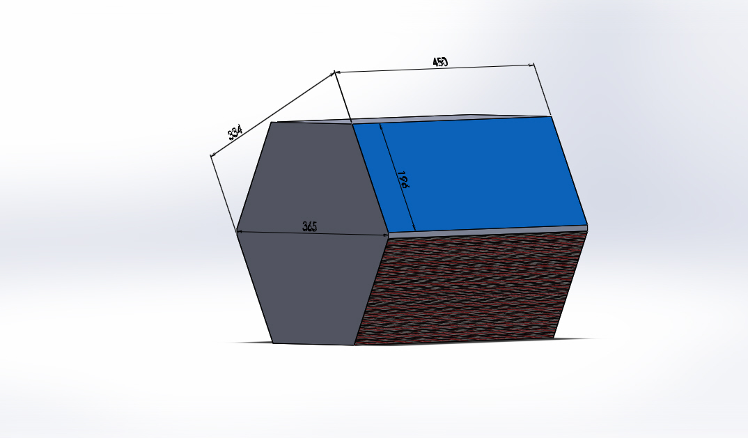
Konstruktion/Enthalpietauscher_stroemung.JPG
