mho-jwi/MA/Konstruktion/Enthalpietauscher_stroemungq.JPG

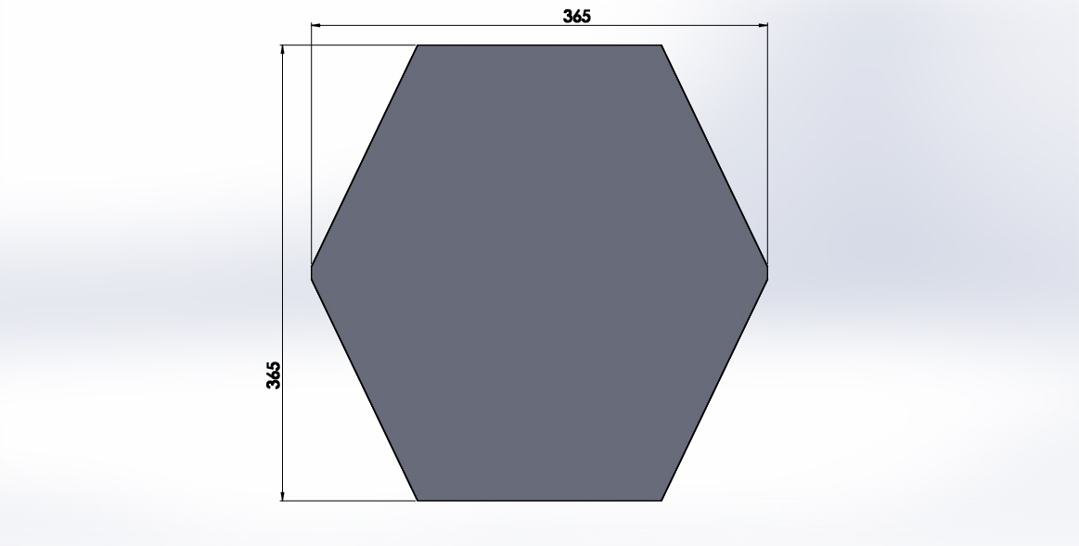
Konstruktion/Enthalpietauscher_stroemungq.JPG
