mho-jwi/MA/MA_safe/Vorlage_Latex_dt/Pictures/RWTHAACHENUNIVERSITY_sw.png

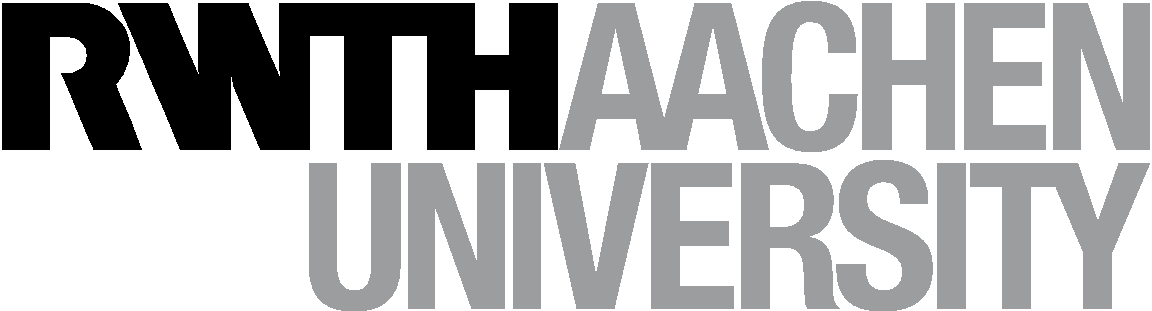
MA_safe/Vorlage_Latex_dt/Pictures/RWTHAACHENUNIVERSITY_sw.png
