mho-jwi/MA/MA_safe/Vorlage_Latex_dt/Pictures/Temperaturnetz_Koordinatensystem.jpg

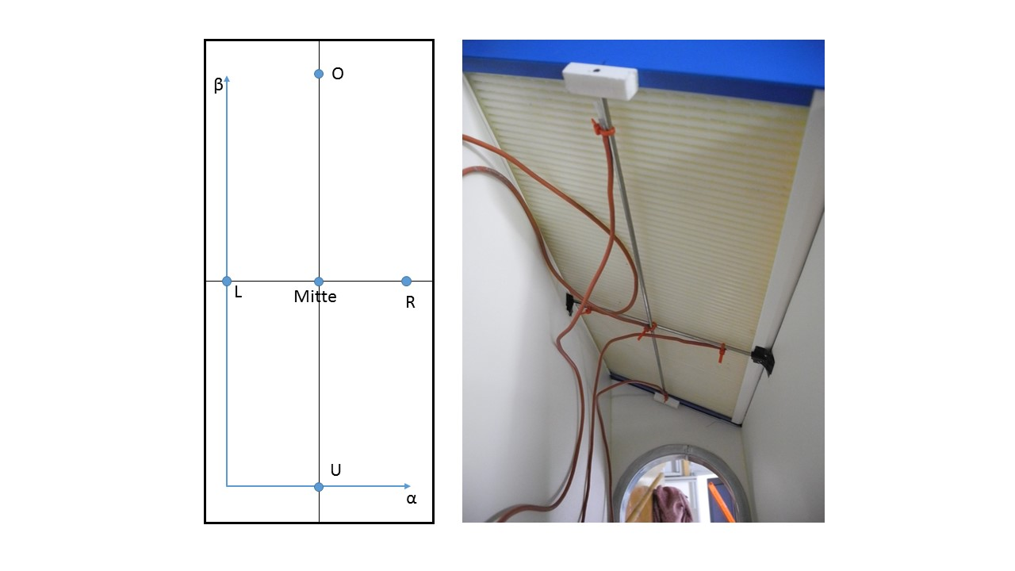
MA_safe/Vorlage_Latex_dt/Pictures/Temperaturnetz_Koordinatensystem.jpg
