mho-jwi/MA/MA_safe/Vorlage_Latex_dt/Pictures/Temperaturprofil_ueber_der_Abstroemflaeche.png

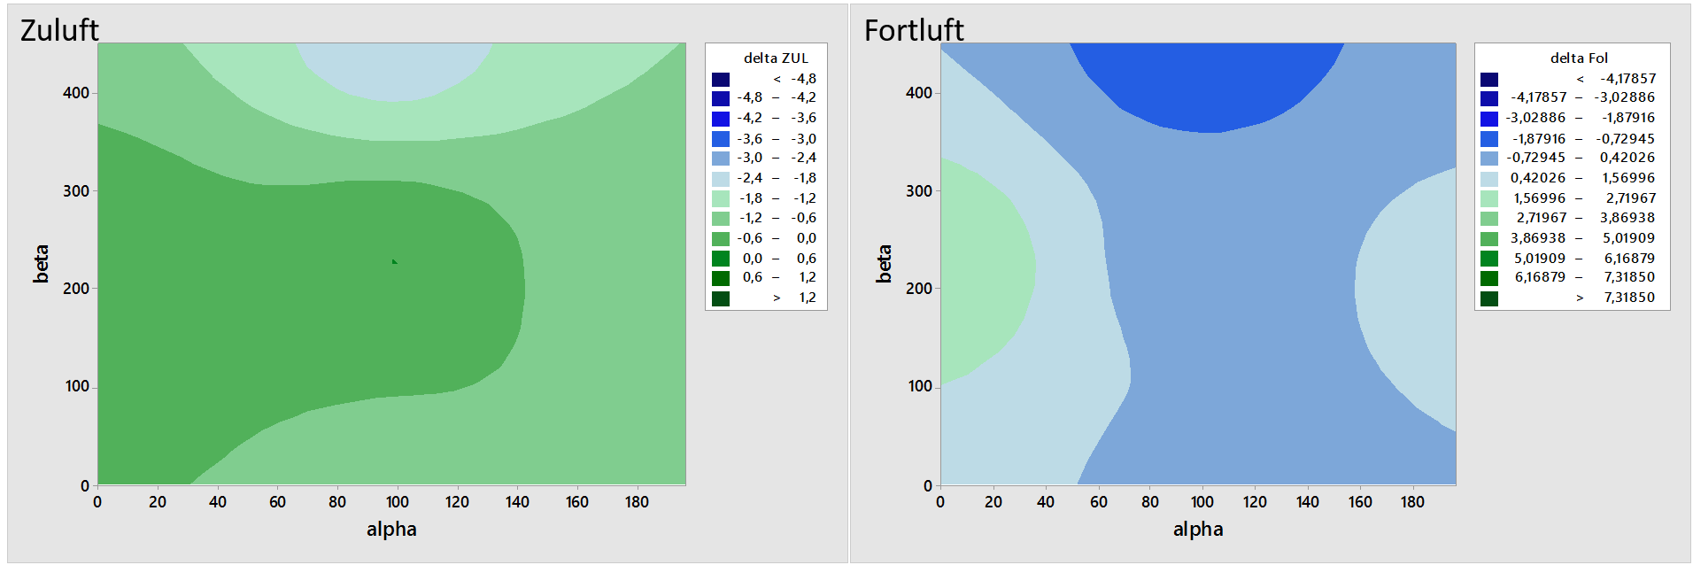
MA_safe/Vorlage_Latex_dt/Pictures/Temperaturprofil_ueber_der_Abstroemflaeche.png
