mho-jwi/MA/Vorlage_Latex_dt/Chapters/Sorptionsformel.png

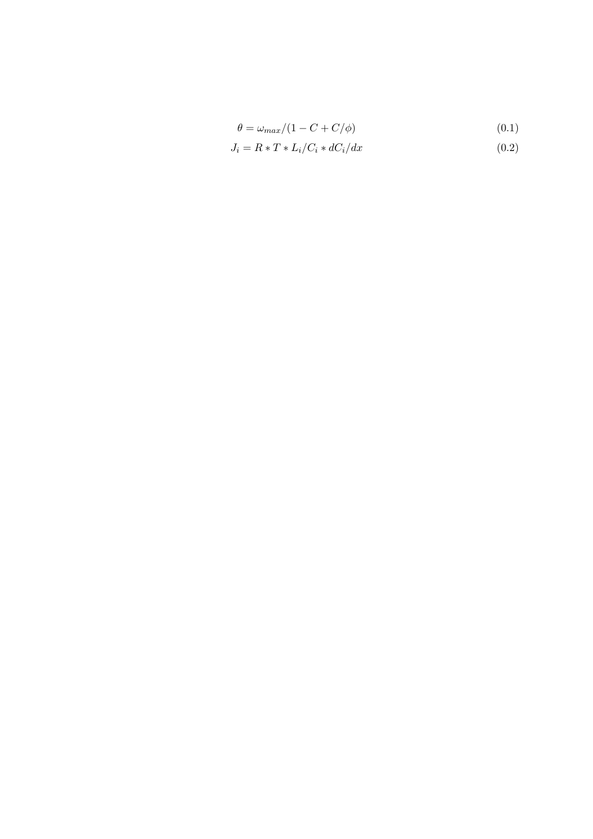
Vorlage_Latex_dt/Chapters/Sorptionsformel.png
