mho-jwi/MA/Vorlage_Latex_dt/Pictures/Technische_Uebersicht_des_Pruefstandes.jpg

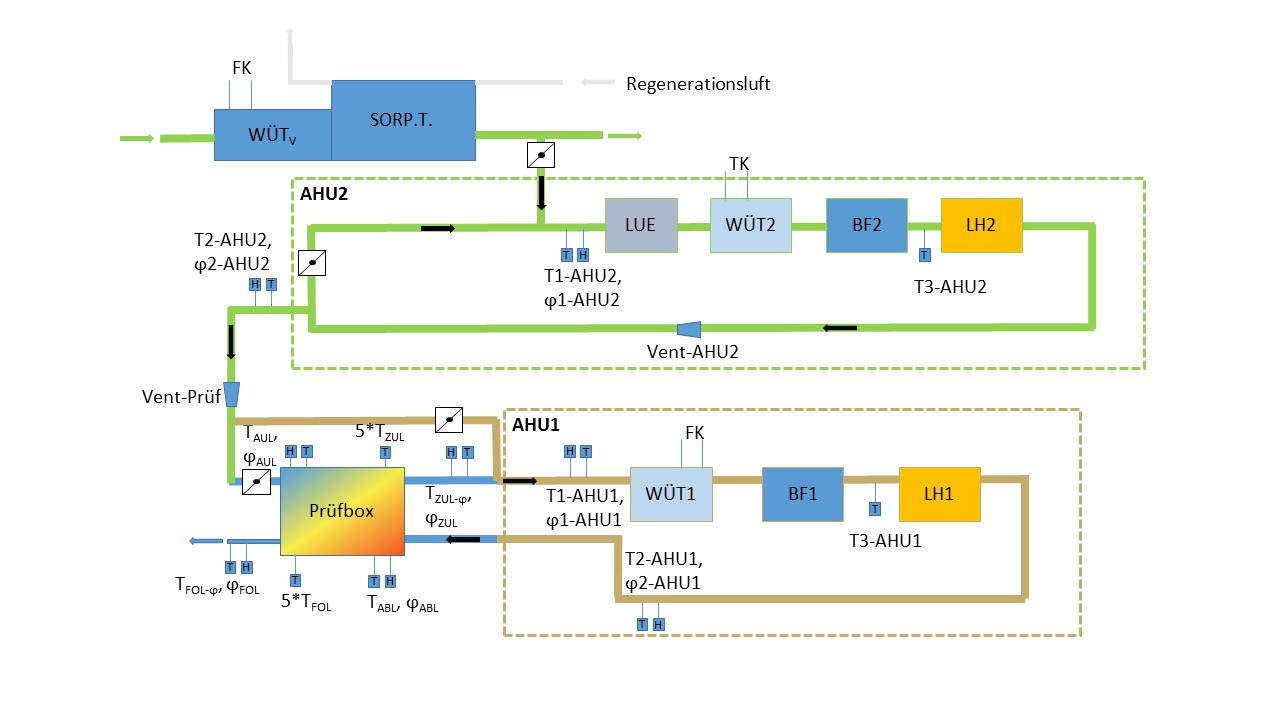
Vorlage_Latex_dt/Pictures/Technische_Uebersicht_des_Pruefstandes.jpg
