mho-jwi/MA/(B) Klimaprüfstand/Prüflinge/Gehäuseteil.SLDASM

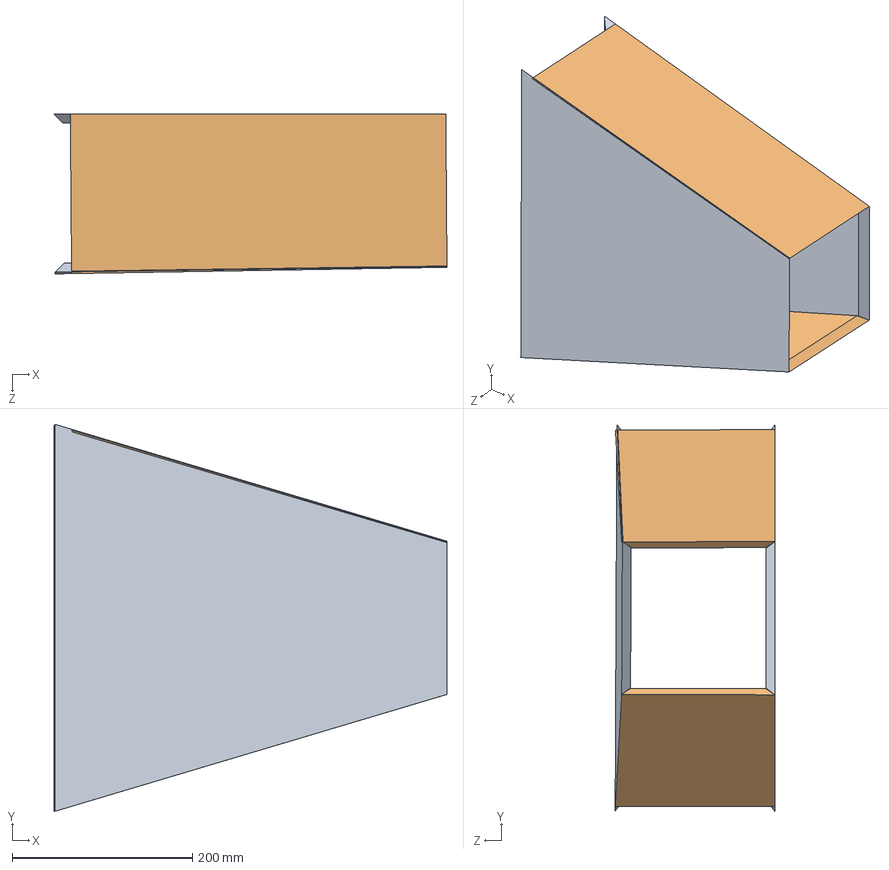
[picture p52: CAD file, 2016-06-22]
(B) Klimaprüfstand/Prüflinge/Gehäuseteil.SLDASM
436.0 x 429.6 x 177.3 mm
Gehäseseite1 x 2
Gehäseseite2 x 2
