mho-jwi/MA/Konstruktion/Baugruppe.SLDASM

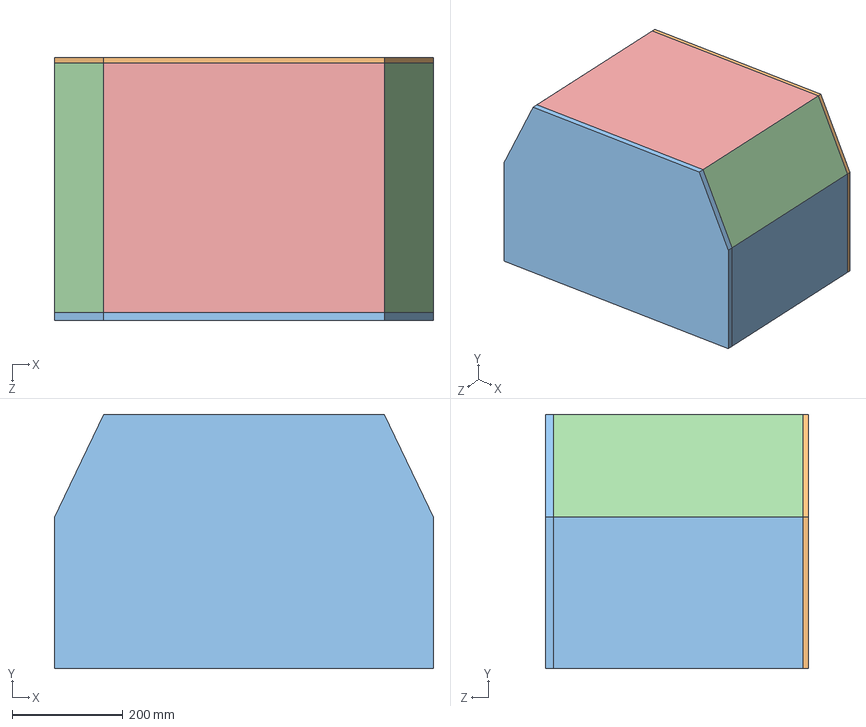
[picture p53: CAD file, 2016-06-22]
Konstruktion/Baugruppe.SLDASM
683.7 x 458.4 x 475.0 mm
Bodenplatte2
Enthalpietauscher
Seitenwand_unten x 2
Seitenwand_oben x 2
Deckenplatte
Steg_oben x 2
Steg_seitlich x 2
Diagonalplatte2 x 2
Diagonalplatte3 x 2
Plexiglasplatte
Skizze_Grundplatte
