mho-jwi/MA/(B) Klimaprüfstand/Prüflinge/Gehäseseite1.SLDPRT

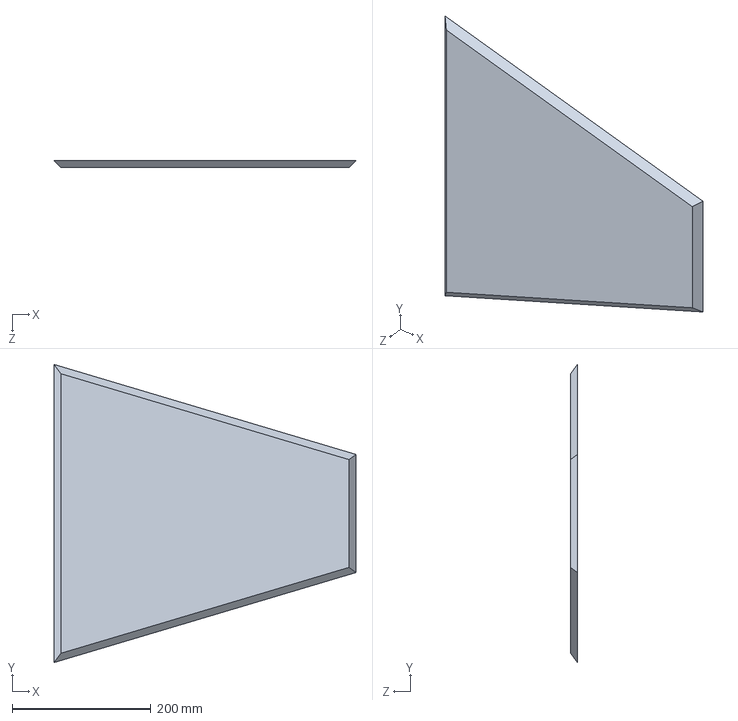
[picture p54: CAD file, 2016-06-22]
(B) Klimaprüfstand/Prüflinge/Gehäseseite1.SLDPRT
434.7 x 429.2 x 10.0 mm
