mho-jwi/MA/Konstruktion/Enthalpietauscher_stroemung.SLDPRT

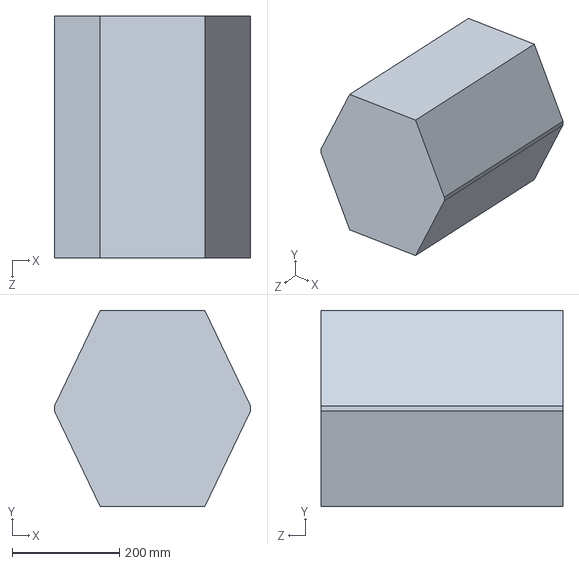
[picture p55: CAD file, 2016-07-30]
Konstruktion/Enthalpietauscher_stroemung.SLDPRT
365.0 x 365.0 x 450.0 mm
