mho-jwi/MA/(B) Klimaprüfstand/Prüflinge/Gehäseseite2.SLDPRT

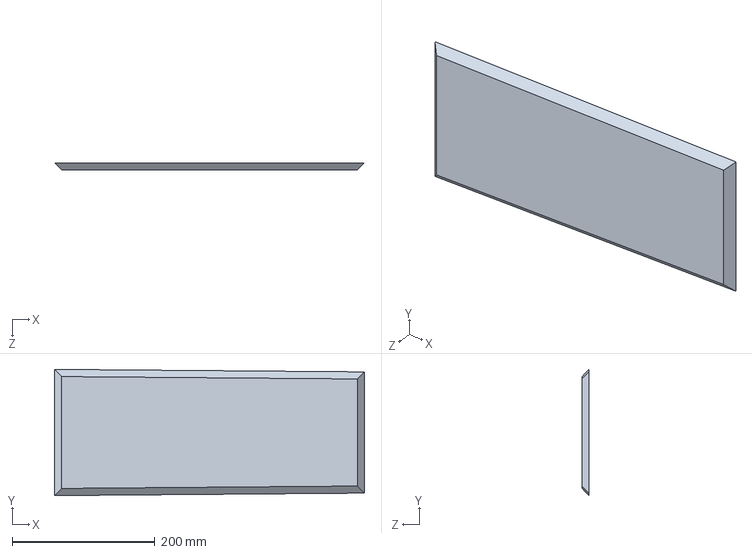
[picture p56: CAD file, 2016-06-22]
(B) Klimaprüfstand/Prüflinge/Gehäseseite2.SLDPRT
434.7 x 177.0 x 10.0 mm
