mho-jwi/MA/Konstruktion/Bodenplatte2.SLDPRT

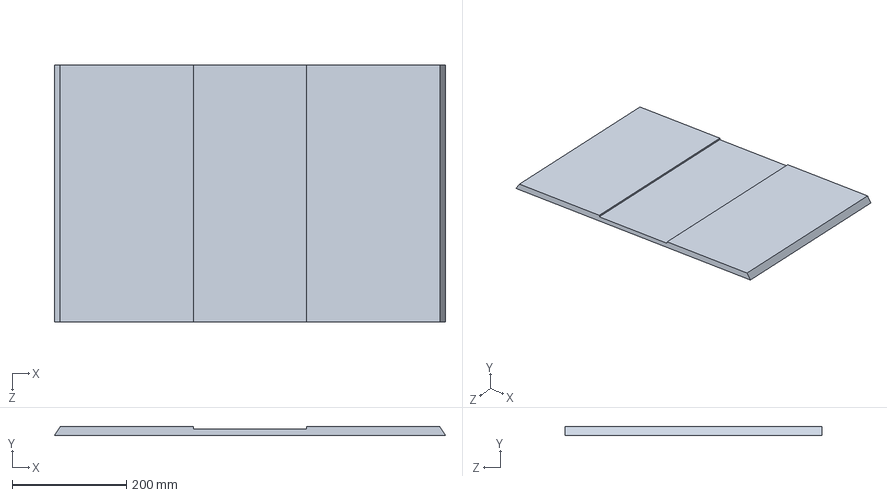
[picture p57: CAD file, 2016-06-22]
Konstruktion/Bodenplatte2.SLDPRT
683.7 x 15.0 x 450.0 mm
