mho-jwi/MA/(B) Klimaprüfstand/Prüflinge/Enthalpietauscher.SLDPRT

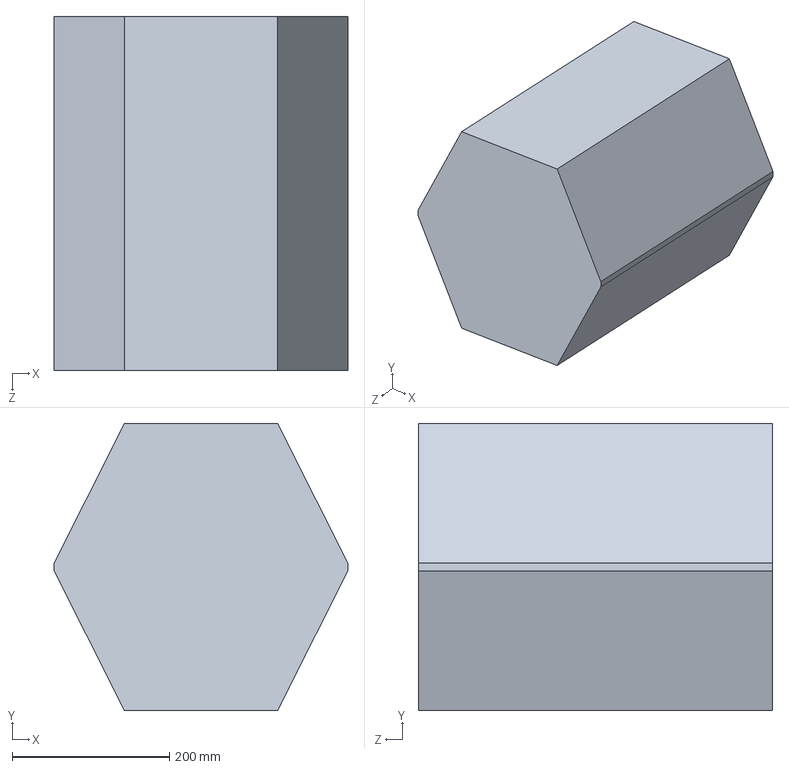
[picture p58: CAD file, 2016-06-22]
(B) Klimaprüfstand/Prüflinge/Enthalpietauscher.SLDPRT
373.2 x 365.0 x 450.0 mm
