mho-jwi/MA/Konstruktion/Diagonalplatte1.SLDPRT

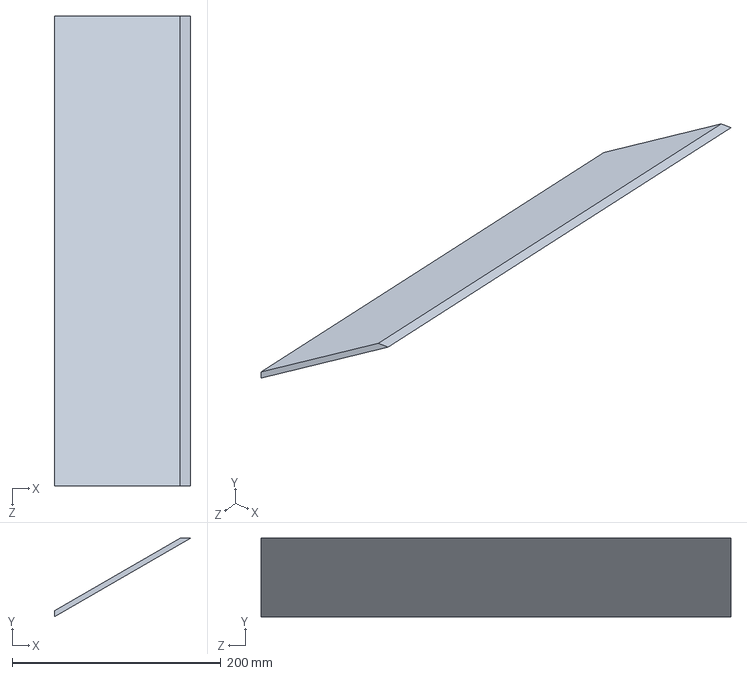
[picture p59: CAD file, 2016-06-22]
Konstruktion/Diagonalplatte1.SLDPRT
130.3 x 75.2 x 450.0 mm
