mho-jwi/MA/Konstruktion/Bodenplatte.SLDPRT

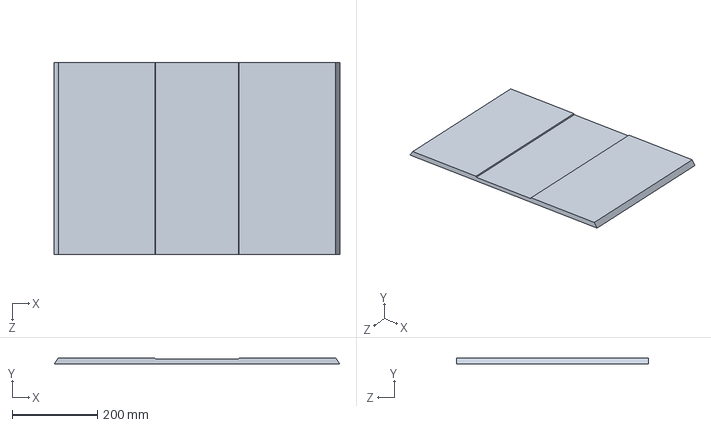
[picture p60: CAD file, 2016-06-22]
Konstruktion/Bodenplatte.SLDPRT
671.8 x 15.0 x 450.0 mm
