mho-jwi/MA/Konstruktion/Steg_oben.SLDPRT

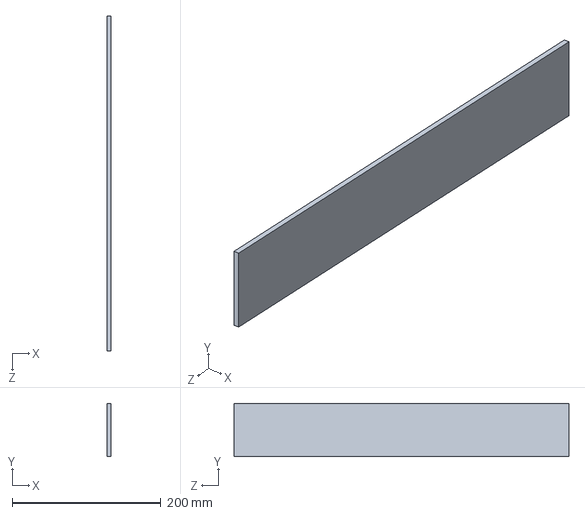
[picture p61: CAD file, 2016-06-22]
Konstruktion/Steg_oben.SLDPRT
5.00 x 71.5 x 450.0 mm
