mho-jwi/MA/Konstruktion/Seitenwand_oben.SLDPRT

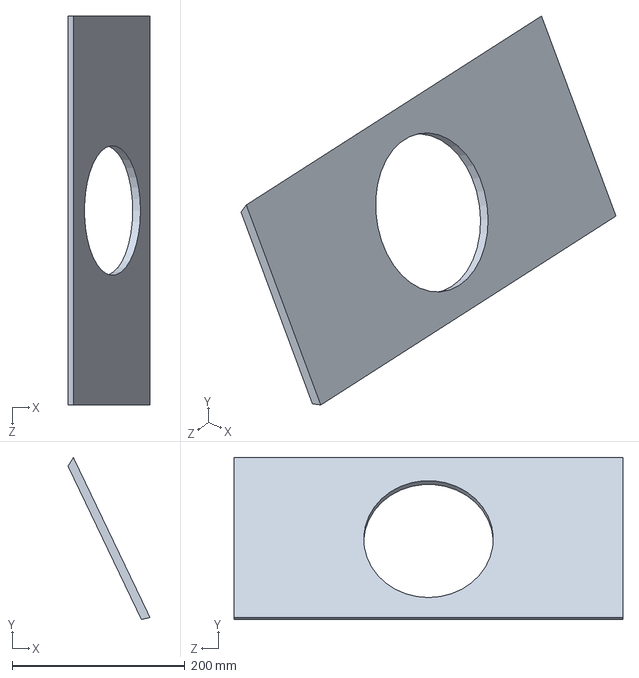
[picture p62: CAD file, 2016-06-22]
Konstruktion/Seitenwand_oben.SLDPRT
95.0 x 187.5 x 450.0 mm
