mho-jwi/MA/Konstruktion/Skizze_Grundplatte.SLDPRT

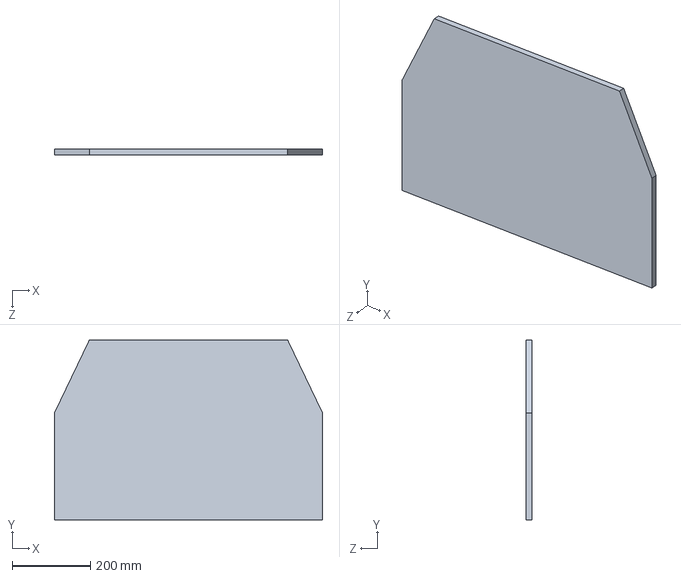
[picture p63: CAD file, 2016-06-22]
Konstruktion/Skizze_Grundplatte.SLDPRT
683.7 x 458.4 x 15.0 mm
