mho-jwi/MA/Konstruktion/Diagonalplatte2.SLDPRT

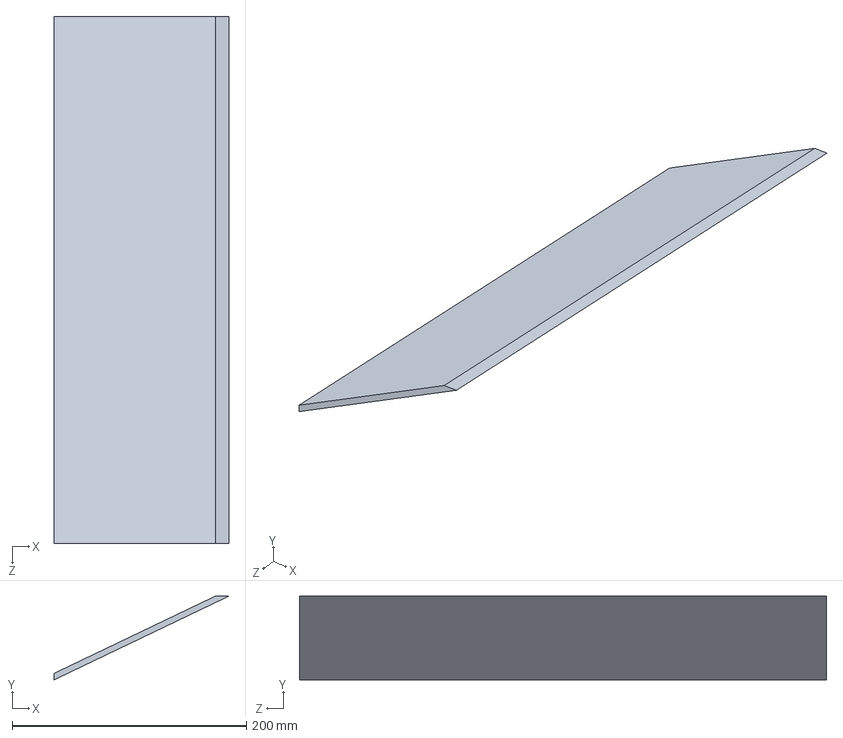
[picture p64: CAD file, 2016-06-22]
Konstruktion/Diagonalplatte2.SLDPRT
149.4 x 71.5 x 450.0 mm
