mho-jwi/MA/Konstruktion/Steg_seitlich.SLDPRT

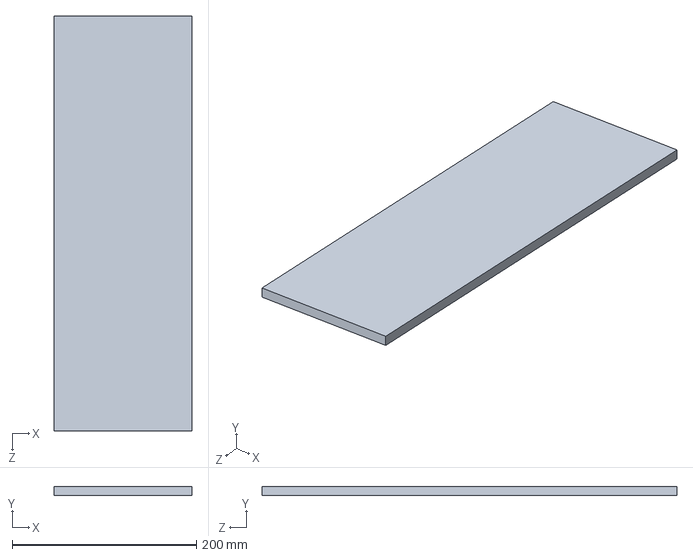
[picture p65: CAD file, 2016-06-22]
Konstruktion/Steg_seitlich.SLDPRT
149.4 x 10.0 x 450.0 mm
