mho-jwi/MA/Konstruktion/Gesamtwand.SLDPRT

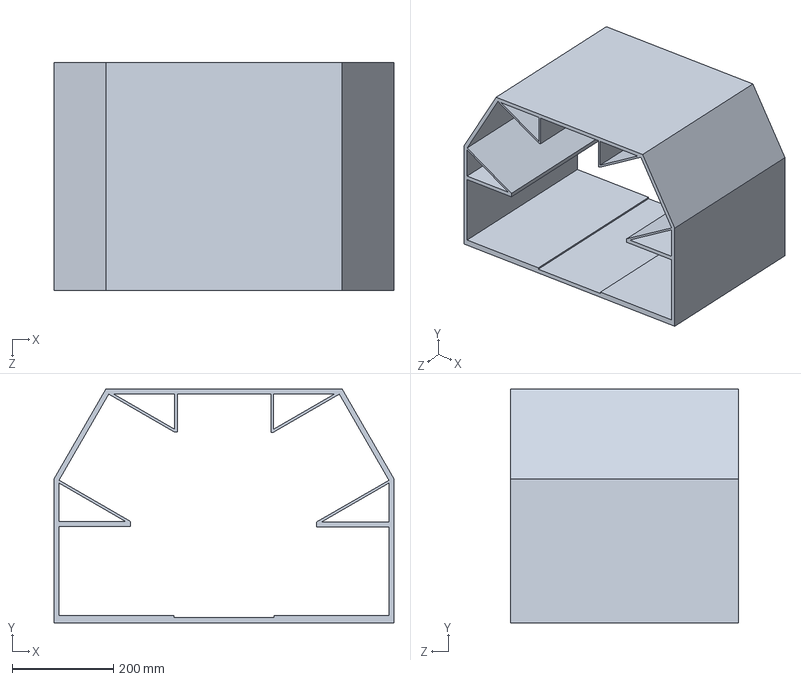
[picture p66: CAD file, 2016-06-22]
Konstruktion/Gesamtwand.SLDPRT
672.0 x 462.1 x 450.0 mm
