mho-jwi/MA/Konstruktion/Plexiglasplatte.SLDPRT

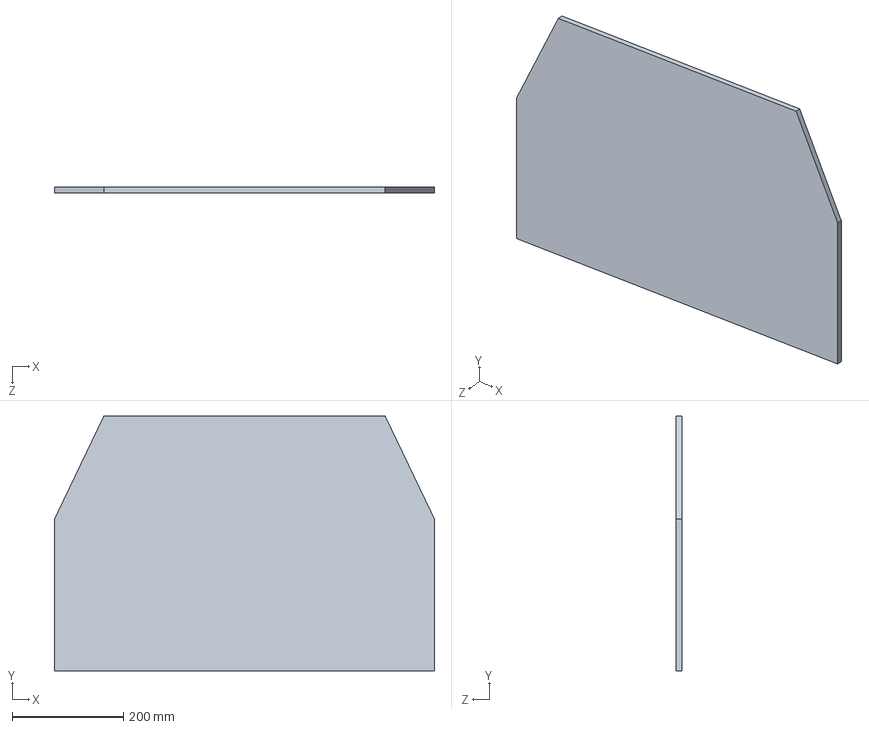
[picture p67: CAD file, 2016-06-22]
Konstruktion/Plexiglasplatte.SLDPRT
683.7 x 458.4 x 10.0 mm
