mho-jwi/MA/Konstruktion/Seitenwand_unten.SLDPRT

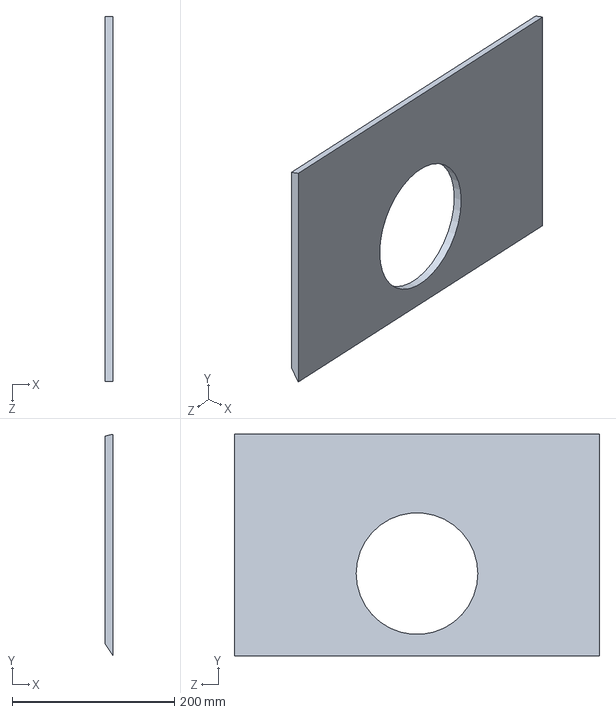
[picture p68: CAD file, 2016-06-22]
Konstruktion/Seitenwand_unten.SLDPRT
10.0 x 273.2 x 450.0 mm
