mho-jwi/MA/Konstruktion/Deckenplatte.SLDPRT

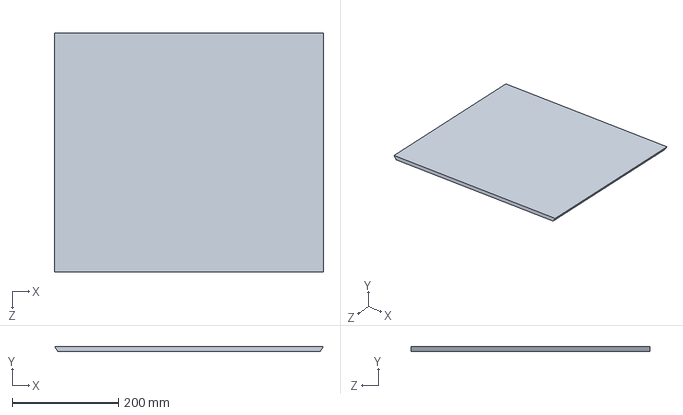
[picture p69: CAD file, 2016-06-22]
Konstruktion/Deckenplatte.SLDPRT
506.3 x 10.00 x 450.0 mm
