mho-jwi/MA/(list of files, cad)

Other CAD files:
Konstruktion/Übersicht.SLDPRT
Konstruktion/Enthalpietauscher.SLDPRT
Konstruktion/Diagonalplatte3.SLDPRT
Konstruktion/Grundskizze.SLDPRT
Konstruktion/Zeichnung_Baugruppe.SLDDRW
