mho-jwi/MA/Vorlage_Latex_dt/Prüfstandsaufbau.docx

Prüfstandsaufbau

% Bild der gesamten Prüfbox und im Angeschlossenen Zustand hinzufügen

Der Prüfstand besteht aus zwei Air Handling Units und einer Prüfbox, in der der Enthalpieübertrager installiert ist. Die Air Handling Unit 2 ist über einen DN 150 PVC-Schlauch mit der Prüfbox verbunden. So ist der Außenluftstrom zum Enthalpieübertrager übertragbar. Die Air Handling Unit 1 ist mit zwei PVC-Schläuchen mit der Prüfbox verbunden. So ist der Zuluftstrom vom Enthalpieübertrager zur Air Handling Unit 1 und der Abluftstrom von der Air Handling Unit 1 zum Enthalpieübertrager übertragbar. Ein vierter PVC-Schlauch führt den Fortluftstrom vom Enthalpieübertrager weg.

Air Handling Units

Air Handling Unit 2

Die Air Handling Unit 2 simuliert die Umgebungsluft. Dazu weißt sie einen Sorptionstrockner mit einer Vorkühleinheit und einem Ventilator auf, einen Lüfter, einen 22kW Wärmeübertrager zur Kühlung, einen elektrischen 6kW Lufterhitzer, sowie einen Dampfbefeuchter. Um Konstante Bedingungen für den Außenluftstrom zu gewährleisten werden wird in der Air Handling Unit 2 ein Luftstrom im Kreis gefördert. Hierbei können bis zu 4500 m³/h gefördert werden. Der Volumenstrom wird über ein Venturirohr gemessen. Ein weiteres Venturirohr misst den Außenluftstrom der zur Prüfbox fließt. Der Außenluftstrom beträgt maximal 450m³/h. Die Regelung der Volumenströme erfolgt jeweils über Absperrklappen, die kontinuierlich verstellbar sind. Für die Temperaturregelung ist jeweils ein Temperatursensor nach dem Lufterhitzer und dem Wärmeübertrager verbaut, außerdem befindet sich ein Temperatursensor in den Luftleitungen des Außenluftstroms und nach dem Sorptionstrockner sowie dem Dampfbefeuchter. Zur Regelung des Dampfbefeuchters ist ein Feuchtesensor mit Temperaturfühler in der Außenluftleitung verbaut. Der Sorptionstrockner wird manuell gesteuert. Um notwendige Leistung des Sorptionstrockners zu ermitteln befindet sich ein Feuchtesensor inklusive Temperatursensor in der Leitung des Außenluftstroms.

Der Wärmeübertrager wird auf der Primärseite von einem Solestrom durchflossen. Zulaufseitig weist die Sole eine Temperatur von ca. -20 °C auf. Daher ist eine Abkühlung des Außenluftstromes auf sehr kalte Temperaturen möglich.

Air Händling Unit 1

Die Air Handling Unit 1 simuliert die Abluft. Sie weist einen elektrischen 4 kW Lufterhitzer, einen 3 kW Wärmeübertrager zum kühlen und eine Dampfbefeuchter auf. Der Volumenstrom entspricht dem des Außenluftstromes. Zur Regelung der Luftbedingungen ist jeweils am Eintritt und am Austritt der AHU 1 ein Feuchtesensor mit Temperaturfühler sowie eine weiterer Temperatursensorverbaut. Außerdem ist jeweils nach dem Wärmeübertrager, dem Lufterhitzer und dem Dampfbefeuchter ein Temperatursensor verbaut. Der Temperatursensor T4_AHU1 ist außerdem mit einem Temperaturwächter verbunden, der bei 40°C auslöst. Der Temperaturwächter nimmt beim Auslösen den Lufterhitzer von der Stromversorgung.

Der Wärmeübertrager der Air Handling Unit 1 ist primärseitig an die Fernkälte angeschlossen. Der Wasserstrom besitzt eine Zulauftemperatur von ca. 8 bis 9 °C. Entsprechend ist es nicht möglich sehr kalte Temperaturen im Abluftstrom zu simulieren. Die minimale Temperatur der Abluft hängt von der Eintrittstemperatur der Luft und Leistung des Dampfbefeuchters in die Air Handling Unit 1 ab. Bei Temperaturen unter 10 bis 15 °C der Ablufttemperatur nimmt außerdem die Regeldauer stark zu. Die Temperaturdifferenz im Wärmeübertrager ist in diesem Fall so gering, dass nur eine geringe Leistung übertragen wird. Aufgrund des Wärmeübertragers tritt die Zuluft auch bei einem kalten Außenluftstrom zunächst mit erhöhter Temperatur in die Air Handling Unit 1 ein. Daher ist es während der Abkühlphase sinnvoll den Wärmeübertrager zunächst mittels des Bypasses zu überbrücken.

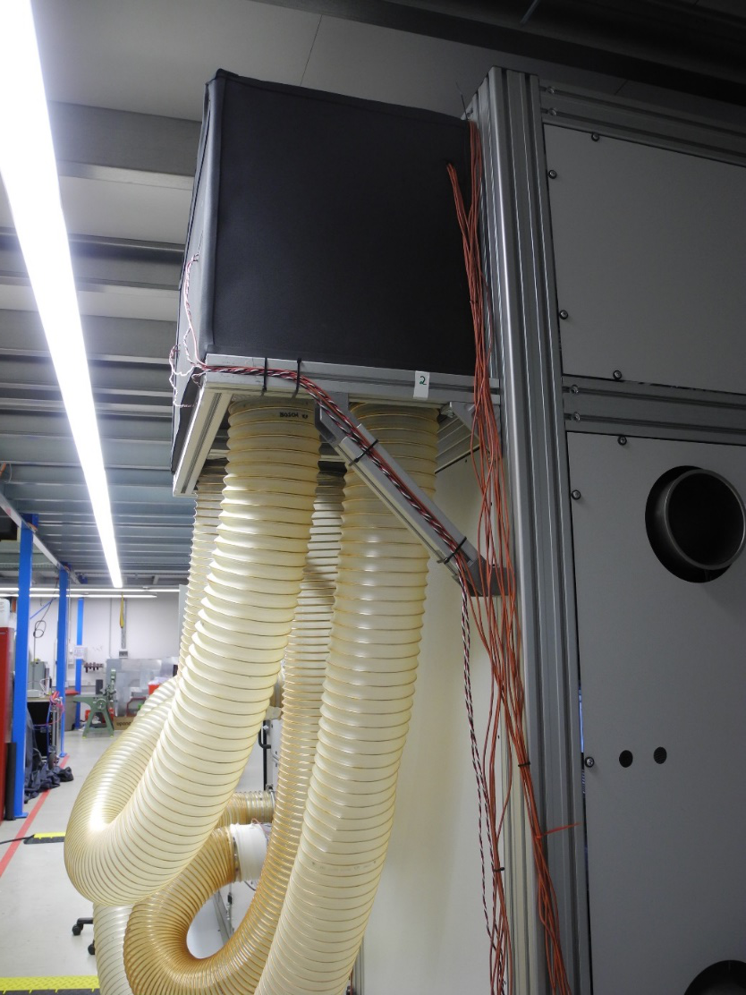
[picture p70: figure]

% Bild mit Sensoren aktualisieren

Prüfbox

Die Prüfbox dient als Halterung des Enthalpieübertragers und ermöglicht die Anströmung der Einlässe beziehungsweise die Abströmung an den Auslässen des Enthalpieübertragers.

Um die einen hohe Reproduzierbarkeit der Versuche zu gewährleisten und die Übertragungsflächen im Enthalpieübertrager gleichmäßig zu nutzen, ist eine gleichmäßige Anströmung der Einlassflächen des Enthalpieübertragers notwendig. Die Norm … beschreibt Rahmenbedingungen unter denen Experimente mit Luftströmungen reproduzierbar durchgeführt werden können. Die Norm beschreibt für einen Rohrdurchmesser von …. Eine Länge von … für die Einströmstrecke. Zur Messung der Temperatur wird ein Messpunktenetz aus … mal … Sensoren gefordert.

Diese Bedingungen sind im Rahmen dieser Masterarbeit nicht Umsetzbar. Daher wurde eine Prüfbox konstruiert, die bei einer kurzen Einströmstrecke eine möglichst gleichmäßige Anströmung gewährleistet.

Bild … zeigt die Einlassseite des Feedstroms. Die Prüfbox ist auf der Einlassseite der Luftströme jeweils mit einem Lochblech versehen. Das Lochblech ist diagonal vor der Anströmfläche des Enthalpieübertragers angeordnet. Das Lochblech erzeugt einen Staudruck. Dies führt zu einer gleichmäßigeren Anströmung des Enthalpieübertragers. Der Luftzustrom in die Prüfbox verläuft orthogonal zur Anströmfläche des Enthalpieübertragers. Die diagonale Positionierung des Lochbleches gleicht den Druckverlust der Strömung entlang der Anströmfläche aus. So ermöglicht die Prüfbox eine gleichmäßige Anströmung des Enthalpieübertragers bei einer geringen Baulänge. Die die Homogenität der Luftströmung konnte im Rahmen dieser Masterarbeit nicht überprüft werden.

% Norm anfügen

Verteilung der Sensoren

Verteilung der Temperatursensoren

Für den Feed-Strom und den Sweep-Strom sind auf der Eingangsseite jeweils ein Temperatursensor (T_AUL, T_ABL) und ein Feuchtesensor (PHI_AUL, PHI_ABL) in die Prüfbox verbaut. Der Temperatursensor wird mittels einer Messinghülse in Position gehalten. Feuchtesensor ist ebenfalls von außen an der Messinghülse befestigt. Der Abstand der beiden Sensoren beträgt so nur wenige Millimeter. Durch die kurze Distanz wird eine genaue Bestimmung des absoluten Feuchtegehalts der Luft (x_AUL, x_ABL) ermöglicht.

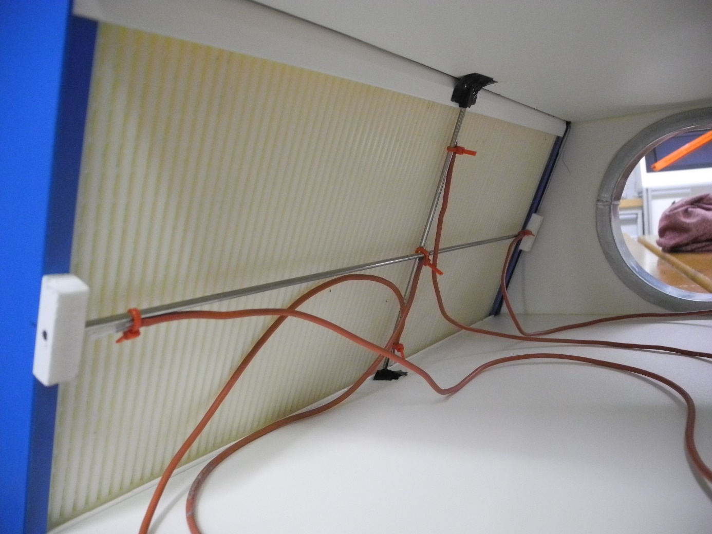
[picture p71: figure]

Bild … zeigt die Abströmseite des Sweep/Feedstroms. Auf der Abströmseite beider Ströme sind an den Abströmflächen des Enthalpieübertragers jeweils fünf Temperatursensoren (T_ZUL, T_FOL) angebracht. Diese sind jeweils Kreuzförmig angebracht. Durch die Kreuzstromgeometrie des Enthalpieübertragers entsteht ein Temperatur- und ein Feuchtegradient entlang der beta-Achse der Abströmfläche. Auch eine inhomogene Strömung durch eine ungleichmäßige Anströmung oder Durchströmung des Enthalpieübertragers führt zu Temperatur- und Feuchtegradienten über der Abströmfläche (s.Kap. Lochblech).

Ein Messung der Temperaturen nach der Norm DIN… , wie bereits in Kap… erwähnt ist im Rahmen dieser Arbeit nicht möglich. Mit der gewählten Anordnung der Sensoren sind 3 Messpunkte je Koordinaten Richtung und Fläche möglich. Dies ermöglicht eine Ermittlung der Hauptwirkungen 2. Grades der beschriebenen Einflüsse. Eine Ermittelung der Wechselwirkungen ist auf diese Weise nicht möglich.

An den Abströmseiten werden Die Feuchtesensoren (PHI_ZUL, PHI_FOL) nicht in der Prüfbox positioniert. Es steht nur ein Sensor pro Seite zur Verfügung. Eine Messung kurz hinter der Abströmfläche des Enthalpieübertragers ist nicht sinnvoll. Dort weist der Luftstrom eine hohe Inhomogenität auf. Eine Messung an dieser Stelle kann zur Messung eines lokalen Feuchtewerts führen, der stark von dem Durchschnittswert im entsprechenden Luftstrom abweicht. Daher werden die Feuchtewerte erst nach einer Durchmischungsstecke gemessen. An dieser Stelle kann von einem thermodynamisch homogenen Strom ausgegangen werden. Zur Ermittlung der korrekten absoluten Feuchte (x_ZUL, x_FOL) wird an dieser Stelle die Temperatur (T_ZUL_PHI, F_TOL_PHI) erneut gemessen.

Über die Durchmischungsstrecke ist absolute Feuchte konstant. Daher lässt sich mit den je fünf Temperaturmesssensoren in der Prüfbox die relative Feuchte direkt nach dem Enthalpieübertrager rechnen.

Für alle beschriebenen Temperaturmessungen sind PT 100 Messsensoren der Genauigkeit 1/10 Klasse B nach DIN EN 60751 verbaut. Für alle beschriebenen Feuchtemessungen sind Honeywell HIH-Feuchtesensoren verbaut. Sie besitzen eine Genauigkeit von +- 3,5 % relativer Feuchte.

Die Berechnung der absoluten Feuchte erfolgt nach der … Formel. Danach ergibt sich die absolute Feuchte in g/kg zu

wobei … die … ist …..

Die Rückrechnung zur relativen Feuchte erfolgt über den gleichen Zusammenhang. So ergibt sich die relative Feuchte zu….

Die Temperatur der konditionierten Luft lässt sich bis auf eine Genauigkeit von … einregeln. Die Feuchte der konditionierten Luft lässt sich bis auf eine Genauigkeit von… einregeln. Eine Aufzeichnung der gemessenen Temperaturen für die Sollwerte … findet sich in Abbildung…
