mho-jwi/MA/(B) Klimaprüfstand/Steuerung/Anleitung_SW_P5507_Version_001.pdf

Klimaprüfstand | Seite 1
Technische Dokumentation | Anhang SW

PNR
5507
Beschreibung Software | V1.00

T:\proj\BOSCH_SI\P5507\BG7000\SW-Doku\SW_P5507_Version_001.doc

Ä Alle Rechte bei Ehrler Prüftechnik Engineering GmbH. Jede Verfügungsbefugnis, wie Kopier- und Weitergaberecht bei uns.

INHALTSVERZEICHNIS:

Klimaprüfstand | Seite 2
Beschreibung Software | V1.00

Klimaprüfstand | Seite 3
Beschreibung Software | V1.00

## 1 Allgemeines

### 1.1. Bestimmungsgemäße Verwendung der Software

Diese Software wurde speziell für den Klimaprüfstand P5507 entwickelt. Eine andere Verwendung oder Vertrieb dieser Software ist ausdrücklich untersagt. Änderungen an der Software müssen von Ehrler Prüftechnik Engineering GmbH vorgenommen werden. Um einen stabilen Betrieb der Software zu gewährleisten sollte auf dem PC keine zusätzliche Software nachträglich installiert werden.

Für Änderungen an der Software, die nicht durch Ehrler Prüftechnik erfolgen, entfällt die Gewährleistung/Garantie durch Ehrler Prüftechnik. Dies beinhaltet auch Folgefehler oder Beschädigungen an der Hardware oder Personen!

Bitte beachten Sie die vorangehenden Kapitel, bevor Sie über die Software den Prüfstand bedienen.

### 1.1 Beteiligte Komponenten:

Das Programm wurde unter LabView 8.5 von National Instruments entwickelt und läuft unter dem Betriebssystem MS Windows XP Prof SP2.

Hardware- und Softwarevoraussetzungen:
Å | hinreichend leistungsfähiger PC
Å | Betriebssystem MS Windows XP Prof SP2
Å | Monitor mit einer Auflösung von 1680x1050
Å | NI LabVIEW Run-Time Engine 8.5 und aktueller NI DAQmx
Å | Datenerfassungskarte PCI-6229 von National Instruments
Å | Profibus-.Masterkarte Hilscher PB50
Å | 1 freier LAN-Anschluss Ethernet 100 Mbit/s für Fernsteuerung

Versionsverwaltung :

Version Doku | Version SW | Datum | Kommentar
1.00 | 1.18 | 25.03.2010 | Erstversion

Klimaprüfstand | Seite 4
Beschreibung Software | V1.00

### 1.2 Installation der Software

Die Installation der Software erfolgte durch Ehrler Prüftechnik. Die Software ist auch nur lauffähig, wenn alle beteiligten Komponenten vorhanden und funktionsfähig sind.

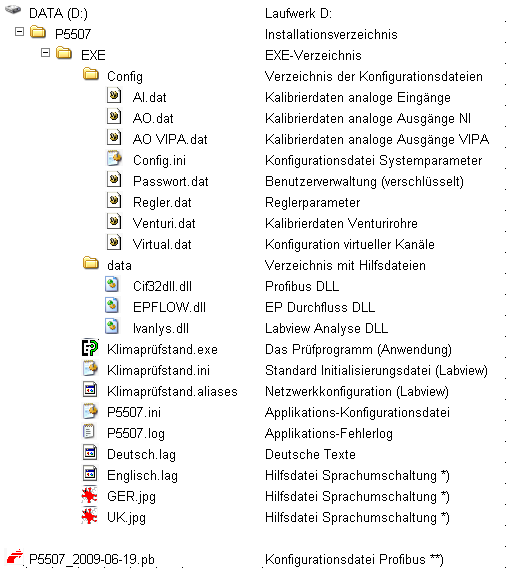
[picture p72: figure]

Verzeichnisstruktur auf Prüfrechner
*) diese Dateien müssen vorhanden sein, auch wenn keine Sprachumschaltung installiert ist **) befindet sich unter d:\ oder im Installationsverzeichnis von Sycon.

Die ausführbare Datei befindet sich unter D:\P5507\EXE\Klimaprüfstand.exe. Um ein Update der Software durchzuführen muß i.A. nur die ausführbare Datei ersetzt werden.
Die ini- und dat-Dateien dienen der Konfiguration der Software. Änderungen an diesen Dateien können zu falschen Meßwerten führen!
Vor der Installation eines Updates stets das Installationsverzeichnis sichern!

Klimaprüfstand | Seite 5
Beschreibung Software | V1.00

### 1.3 Struktur der Software

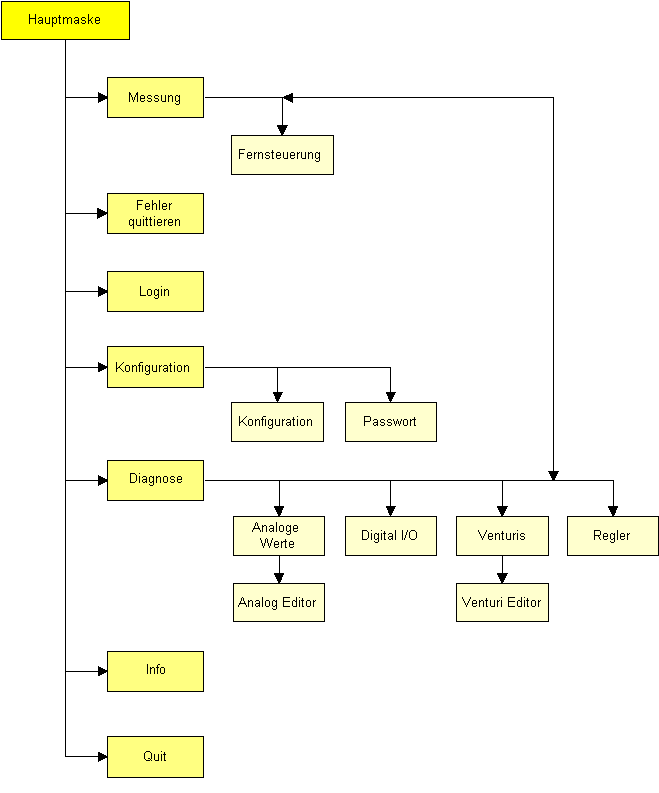
[picture p73: figure]

Softtware-Struktur 1V17

Klimaprüfstand | Seite 6
Beschreibung Software | V1.00

### 1.4 Start und Beenden des Programms

Nach Einschalten des Prüfstandes wird der PC automatisch gestartet. Die Software kann über einen Doppelklick auf das angelegte Icon auf dem Desktop oder über das Windows-Startmenü gestartet werden.

Danach erscheint das Hauptfenster (Ä 2.1 Hauptmaske).
In der Voreinstellung wird der Benutzer automatisch als „Einrichter“ angemeldet (Autologin). Ansonsten wird der Anwender aufgefordert, sich am System mit Benutzernamen und Passwort anzumelden (Ä 2.2 Login ). Wurde der Benutzer als vorhanden verifiziert, so wird eine entsprechende Statusmeldung ausgegeben, und die dem Passwortlevel zugehörigen Menüs werden frei geschaltet. Im Fehlerfall erfolgt eine Fehlermeldung und alle Zugangsrechte werden zurückgesetzt.
Um die Software zu beenden müssen Sie auf die Hauptmaske zurück. Mit <F12> gelangen Sie stets eine Menü-Ebene höher bis auf die Hauptmaske. Hier kann die Software mit der Funktionstaste <F12> beendet und anschließend das Betriebsystem heruntergefahren und die Anlage abgeschaltet werden.

## 2 Oberflächen der Software

### 2.1 Hauptmaske

In der Hauptmaske kann der Anwender unter verschiedenen Funktionen, die je nach Benutzerlevel aktiviert bzw. deaktiviert sind, auswählen.

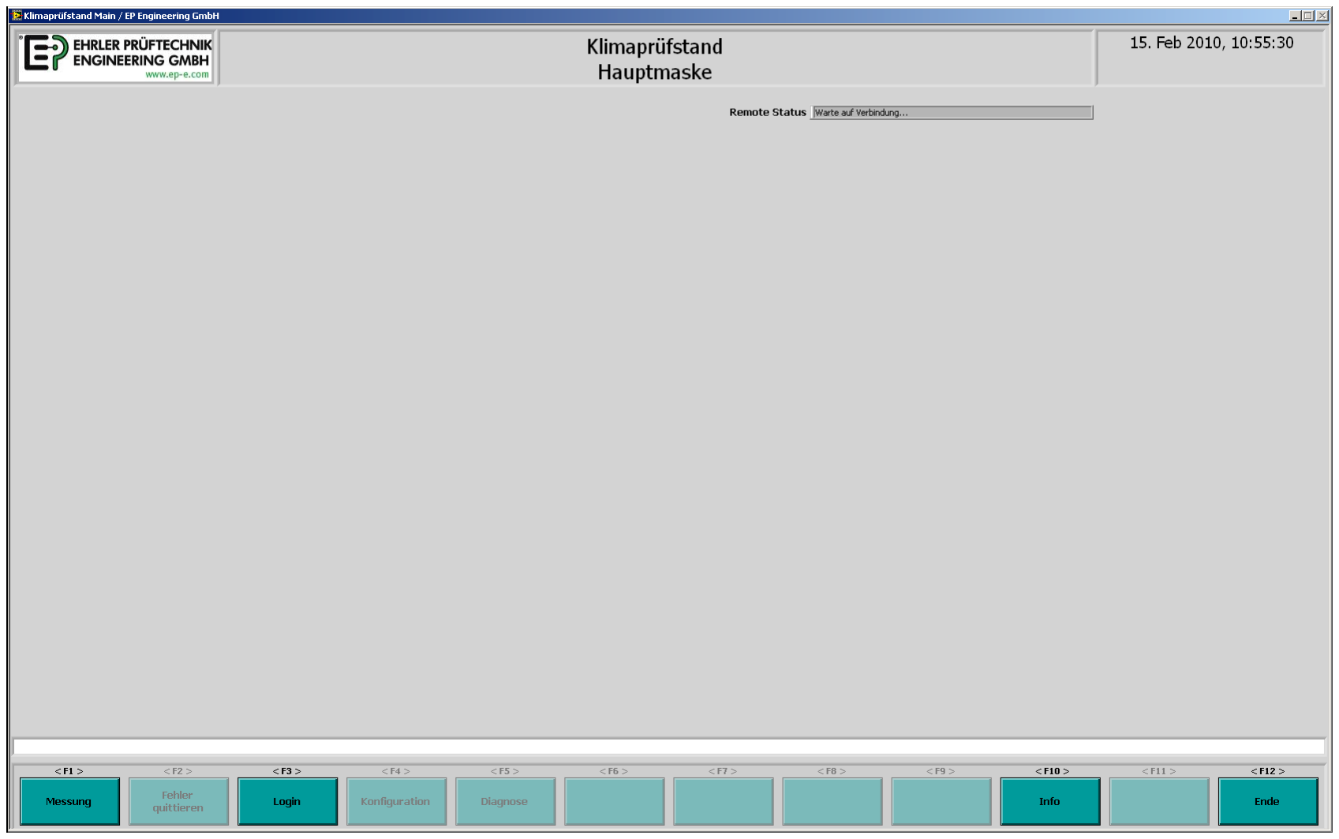
[picture p74: figure]

Hauptmaske (Berechtigungsebene: Bediener)

Klimaprüfstand | Seite 7
Beschreibung Software | V1.00

Funktionstaten (Berechtigungsebene: Einrichter & Administrator)

Das Feld Remote Status zeigt den aktuellen Zustand der Fernsteuerverbindung (TCP) an. Details zur Fernsteuerung siehe unter Ä 3.1.
Im Einzelnen können auf der Hauptmaske folgende Funktionen aufgerufen werden:
< F1 > | Messung | Ç Startet die Messmaske
< F2 > | Fehler quittieren | Ç Fehlerquittierung
< F3 > | Login | Ç Anmeldung und ggf. Wechsel der Berechtigungsebene
< F4 > | Konfiguration | Ç Konfiguration allgemeiner Systemparameter und des Pass- wortsystems
< F5 > | Diagnose | Ç Funktionen für Service, Überprüfung der Anlage und Kali- brierung der Messtechnik
< F10 > Info | Ç Zeigt Informationen über die Softwareversion und den Her-
| | steller an.
< F12 > Ende | Ç Beenden der Software

Diese Funktionen sind im weiteren Verlauf der Anleitung näher beschrieben.

Klimaprüfstand | Seite 8
Beschreibung Software | V1.00

### 2.2 Login

Die | Softwarefunktionen | sind | in | verschiedene | Berechtigungsebenen | unterteilt
(Ä 2.5 Passwort)

Automatischer Login:
Bei aktiviertem Autologin wird der Benutzer beim Programmstart automatisch mit der Berechtigungsstufe „Einsteller“ (mit einem internen Defaultnamen) angemeldet. Bis zum nächsten Login bleibt diese Berechtigungsstufe im System erhalten.

Manueller Login:
Bei deaktiviertem Autologin muss sich der Anwender beim Programmstart mit Benutzernamen und Passwort anmelden. Hierbei und bei drücken der Menütaste „Login“ auf der Hauptmaske erscheint das nachfolgende Fenster:

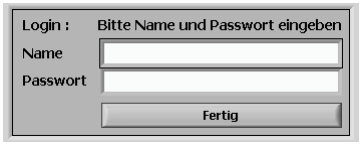
[picture p75: figure]

Wurde der Benutzer als vorhanden verifiziert, so wird eine entsprechende Statusmeldung ausgegeben und die dem eingestellten Passwortlevel zugehörigen Menüs werden frei geschaltet. Im Fehlerfall erfolgt eine Fehlermeldung und alle Zugangsrechte werden zurückgesetzt.

Klimaprüfstand | Seite 9
Beschreibung Software | V1.00

### 2.3 Maske Messung

In dieser Maske wird der halbautomatische Prüfablauf ausgeführt.
Halbautomatisch bedeutet hier, daß der Benutzer alle Vorgaben für Sollwerte und Klappenstellungen manuell vorgeben muss; die Regelung der einzelnen Regelkreise erfolgt dann automatisch.

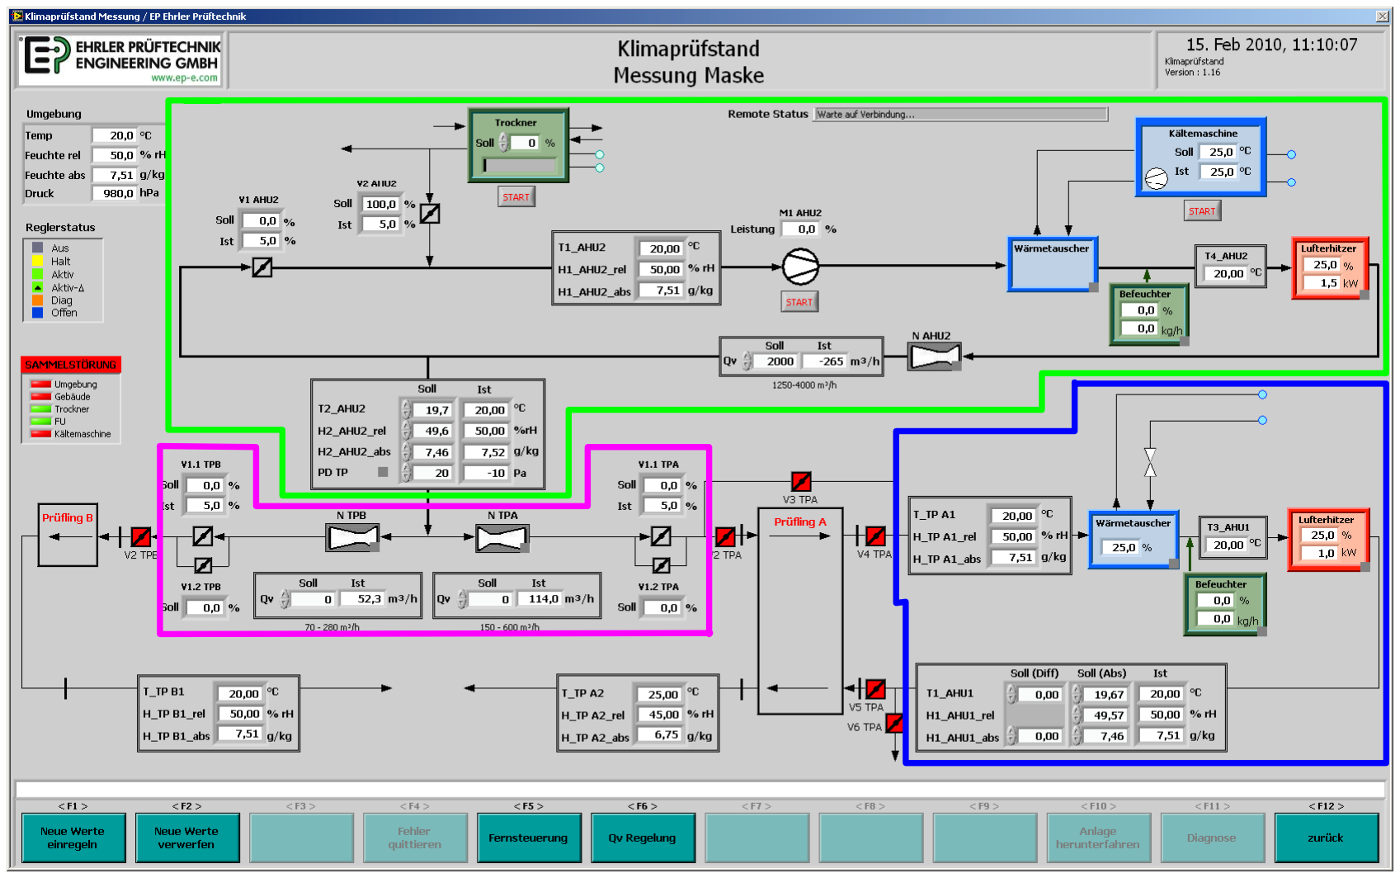
[picture p76: figure]

Messmaske: (Berechtigungsebene: Bediener)

Funktionstasten (Berechtigungsebene: Einrichter & Administrator)

### 2.3.1 Grundlegende Funktion der Messmaske:

Zur Prüfung von Gebäude-Klimageräten simuliert die Anlage zum einen die Umgebung, zum anderen das Gebäude. Dazu sind zwei Air-Handling-Units (AHU) sowie eine Volumenstromregelung vorgesehen:
AHU1 – Gebäudesimulation

AHU2 – Umgebungssimulation

Volumenstromregelung

Der Benutzer kann hier zunächst die gewünschten Sollwerte für die Umgebungssimulation (AHU2) bzw. die Gebäudesimulation (AHU1) über die mit Soll gekennzeichneten Eingabfelder vorgeben.

Klimaprüfstand | Seite 10
Beschreibung Software | V1.00

Schaltklappen können durch einen Klick mit der linken Maustaste auf das entsprechende Klappensymbol direkt betätigt werden.
Mit < F1 > werden die Sollwerte übernommen und die Regler beginnen zu arbeiten. Dabei werden diverse Betriebsbedingungen überprüft und gegebenenfalls auch Regler automatisch abgeschaltet (siehe Einzelbeschreibung der Regelkreise weiter unten).
Für Prüflinge mit internem Gebläse kann die Volumenstromregelung mit < F6 > abgeschaltet und auf reine Druckregelung für PD TP umgeschaltet werden.
Als Einrichter oder Administrator kann auch zwischen der Messmaske und der Diagnosemaske hin- und hergewechselt werden, z.B. für eine Feineinstellung eines Reglers.

### 2.3.2 Allgemeine Bedienelemente und Anzeigen

Element | Funktion

< F1 >

Ç Übernahme neuer Sollwerte. Geänderte Sollwerte werden bis zum Betätigen von F1 in roter Schrift auf gelbem Hintergrund dargestellt.

< F2 >

Ç Verwirft alle neu eingegebenen und noch nicht mit F1 bestätigten Eingaben

< F4 >

Ç Fehlerquittierung

< F5 >

Ç Aktiviert den Fernsteuerbetrieb Ä 3.1 oder schaltet ihn aus

< F6 >

Ç Schaltet zwischen Druckregelung und Volumenstromregelung um

< F10 >

Ç noch ohne Funktion

< F11 >

Ç wechselt in die Diagnosemaske ohne Zustandsänderung

< F12 >

Ç Zurück zur Hauptmaske, alle Regler werden abgeschaltet.

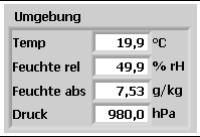
[picture p77: figure]

Anzeige der Umgebungsbedingungen

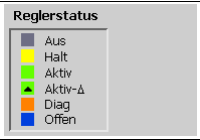
[picture p78: figure]

Legende für die Reglerzustandsanzeigen (s.u.)

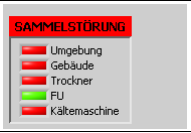
[picture p79: figure]

Anzeige für Störmeldungen.
Bei einer Störung leuchtet die Meldung „SAMMELSTÖRUNG“ auf. Die betroffenen Bereiche können an den Einzelanzeigen abgelesen werden.
Die Anzeige der Sammelstörung erfolgt zeitverzögert zur Unterdrükkung von Schaltvorgängen.

Klimaprüfstand | Seite 11
Beschreibung Software | V1.00

geschlossen

öffnen

offen

Schaltklappe, grün = offen, rot = geschlossen
Wechsel des Schaltzustandes durch Anklicken des Klappensymbols.
Der Leuchtbalken oberhalb des Klappensymbols zeigt den Istzustand der Endschalter an.

Istwertanzeige der Temperatur, der relativen und absoluten Feuchte am Gebäudeausgang des Prüflings A

Sollwertvorgabe und Istwertanzeige der Gebäudesimulation ( = Gebäudeeingang des Prüflings A.)

Istwertanzeige am Umgebungsausgang des Prüflings A

Istwertanzeige am Ausgang des Prüflings B

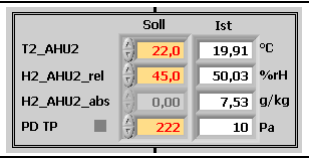
[picture p80: figure]

Sollwertvorgabe und Istwertanzeige der Umgebungssimulation ( = Umgebungseingänge Prüfling A / B )

Istwerte der Zirkulation der Umgebungssimulation

Soll- und Istwert der Klappenstellung einer Regelklappe (am Beispiel der Klappe V1 AHU2)

Klimaprüfstand | Seite 12
Beschreibung Software | V1.00

### 2.3.3 Regelkreise AHU1 Simulation Gebäude

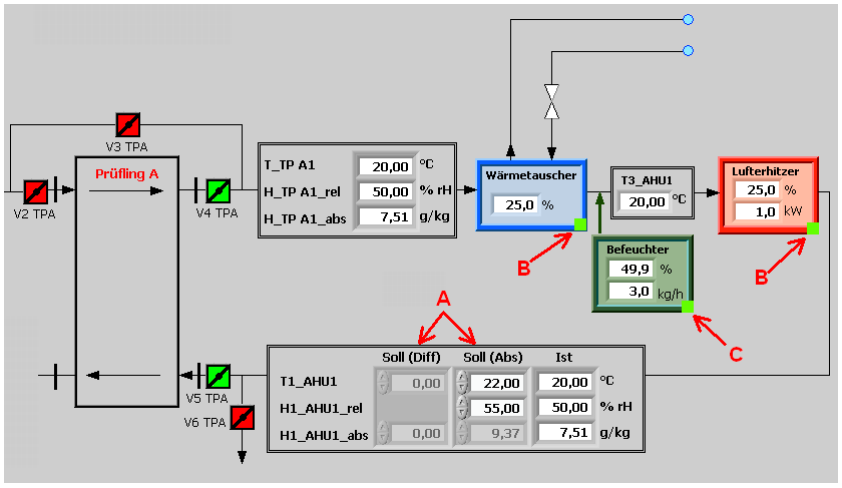
[picture p81: figure]

Messmaske: (AHU1 Simulation Gebäude)

Die Gebäudesimulation umfast einen Temperaturregler sowei einen Feuchteregler zur Simulation des Wärme- und Feuchteeintrags eines Gebäudes.

2.3.3.1 Temperaturregler T1_AHU1
Der Temperaturregler Gebäude regelt die Temperatur an der Stelle T1_AHU1. Dabei ist eine absolute Sollwertvorgabe (ÄA) oder eine Differenzvorgabe bezogen auf die Meßstelle T_TP A1 möglich. Zum Wechsel der Betriebsart F2 drücken, dies schaltet beide Sollwertfelder frei. Der jeweils zuletzt gesetzte Sollwert (Diff/Abs) bestimmt die Betriebsart.
Der Reglerzustand wird mit den Indikatoren (ÄB) angezeigt. Mögliche Zustände sind:
Aus | Der Regler ist abgeschaltet, Heizer und Kühler aus.
Halt | Der Regler ist angehalten. Die Stellwerte an den Heizer bzw. den Kühler bleiben auf ihrem aktuellen Wert ste-hen.
Aktiv | Der Regler ist aktiv, Regelung auf absoluten Sollwert.
Aktiv Diff | Der Regler ist aktiv, Regelung auf differentiellen Sollwert
Diagnose | Die Stellwerte für Heizer und Kühler wurden in der Dia-gnosemaske manuell gesetzt.

Der Reglerzustand kann manuell durch einen Rechtsklick auf den Indikator (Ä B) auf Aus oder Halt gesetzt werden.

Klimaprüfstand | Seite 13
Beschreibung Software | V1.00

Betriebsvoraussetzungen:
Å | Klappe V3 AHU1 oder V4 AHU1 geöffnet
Å | Klappe V5 AHU1 oder V6 AHU1 geöffnet
Å | Keine Vorwarnung vom Heizer (Ä siehe Überwachung)

2.3.3.2 Feuchteregler H1_AHU1
Der Feuchteregler Gebäude regelt die absolute Feuchte an der Stelle H1_AHU1. Dabei ist die Sollwertvorgabe (ÄA) auf drei Arten möglich:
Å Absolute Feuchte H1_AHU1_abs Soll (Abs)
Es wird auf die absolute Feuchte geregelt.
Å Absolute Differenz zu H_TP A1_abs: H1_AHU1_abs Soll (Diff)
Es wird auf die absolute Feuchtedifferenz zu H_TP A1 geregelt.
Å Relative Feuchte H1_AHU1_rel Soll (Abs)
Es wird auf die relative Feuchte geregelt. Der rel. Sollwert wird intern unter Berücksichtigung der Solltemperatur T1_AHU1 in eine absolute Feuchte umgerechnet, die dann als interner Sollwert für die Regelung dient.
Zum Wechsel der Betriebsart F2 drücken, dies schaltet alle drei Sollwertfelder frei. Der jeweils zuletzt gesetzte Sollwert bestimmt die Betriebsart.
Der Reglerzustand wird mit den Indikatoren (ÄB) angezeigt. Mögliche Zustände sind:
Aus | Der Regler ist abgeschaltet, Befeuchter aus.
Halt | Der Regler ist angehalten. Der Stellwert an den Be-feuchter bleibt auf dem aktuellen Wert stehen.
Aktiv | Der Regler ist aktiv, Regelung auf absoluten Sollwert.
Aktiv Diff | Der Regler ist aktiv, Regelung auf differentiellen Sollwert

Der Reglerzustand kann manuell durch einen Rechtsklick auf den Indikator (Ä B) auf Aus oder Halt gesetzt werden.

Betriebsvoraussetzungen:
Å | Klappe V3 AHU1 oder V4 AHU1 geöffnet
Å | Klappe V5 AHU1 oder V6 AHU1 geöffnet

Nachfüllen:
Wenn der Wasserstand des Befeuchters zu weit absinkt, wird automatisch heißes Wasser nachgefüllt. Dies wird durch ein Symbol neben dem Befeuchtersymbol angezeigt. Abhängig von den Regelparametern wird während der Befüllung die Befeuchterleistung für eine gewisse Zeit ggf. noch erhöht.

Klimaprüfstand | Seite 14
Beschreibung Software | V1.00

### 2.3.4 Regelkreise AHU2 Simulation Umgebung

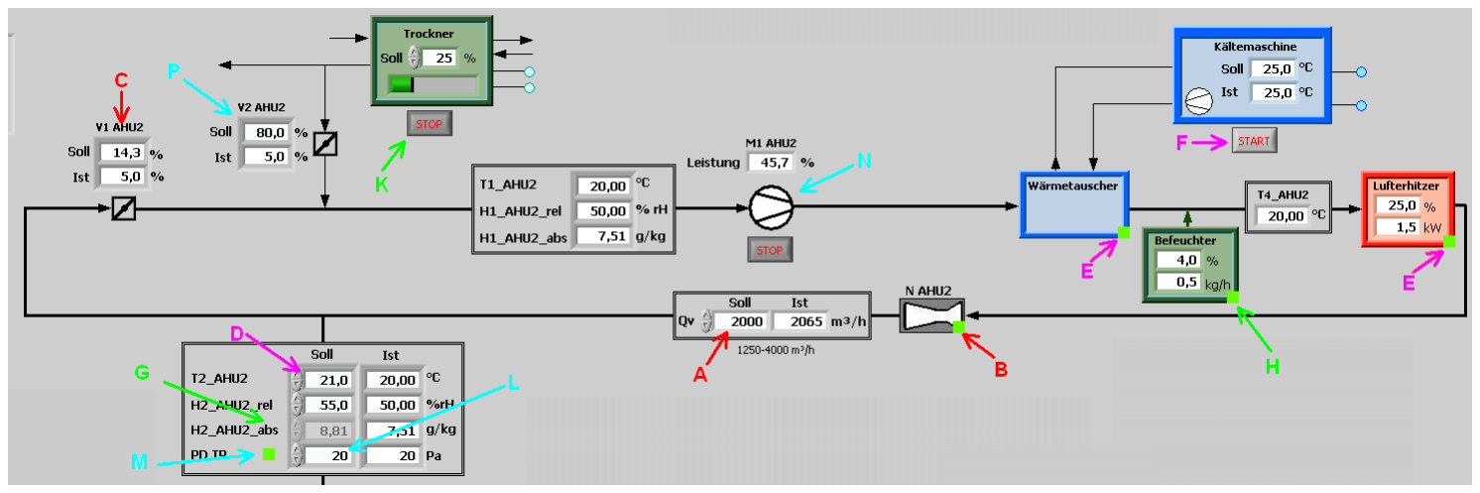
[picture p82: figure]

Messmaske: (AHU2 Simulation Umgebung)

Die Umgebungssimulation umfast einen Temperaturregler und einen Feuchteregler zur Konditionierung der simulierten Aussenluft., einen Druckregler sowie einen Durchflussregler für die Zirkulation.

2.3.4.1 Durchflussregler N AHU2
Die Konditionierung der Prüfluft erfolt in einer Ringleitung (Zirkulation); es wird zur Verbesserung der Stabilität eine deutlich höhere Luftmenge konditioniert als vom Prüfling abgenommen wird. Der Durchflussregler N AHU2 regelt die Luftmenge im Zirklulationskreis. Der Sollwerte (ÄA) hat einen Defaultwert von 2000 m³/h, die Messung des Istwertes erfolgt über die Venturi-Meßstelle N AHU2 (ÄB). Die Regelklappe V1 AHU2 (Ä C) arbeitet als Stellglied.
Der Reglerzustand wird mit den Indikator (ÄB) angezeigt. Mögliche Zustände sind:
Aus | Der Regler ist abgeschaltet, V1 AHU1 geschlossen
Halt | Der Regler ist angehalten. Die Klappe V1 AHU1 bleibt stehen.
Aktiv | Der Regler ist aktiv.

Der Reglerzustand kann manuell durch einen Rechtsklick auf den Indikator (Ä B) auf Aus oder Halt gesetzt werden.
Der Regler startet durch Sollwertänderung oder Einschalten des Gebläses. Bei einer Sollwertänderung wird ebenfalls das Gebläse und der Druckregler aktiviert.
Wird das Gebläse abgeschaltet, wird der Regler in den Zustand Halt versetzt.

Klimaprüfstand | Seite 15
Beschreibung Software | V1.00

2.3.4.2 Temperaturregler T2_AHU2
Der Temperaturregler Umgebung regelt die Temperatur an der Stelle T2_AHU2 (ÄD). Der Reglerzustand wird mit den Indikatoren (ÄE) angezeigt. Mögliche Zustände sind:
Aus | Der Regler ist abgeschaltet, Heizer und Kühler aus.
Halt | Der Regler ist angehalten. Die Stellwerte an den Heizer bzw. den Kühler bleiben auf ihrem aktuellen Wert ste-hen.
Aktiv | Der Regler ist aktiv
Diagnose | Die Stellwerte für Heizer und Kühler wurden in der Dia-gnosemaske manuell gesetzt.

Der Reglerzustand kann manuell durch einen Rechtsklick auf den Indikator (Ä E) auf Aus oder Halt gesetzt werden.

Betriebsvoraussetzungen:
Å | Gebläse M1 AHU2 (FU) läuft
Å | Keine Vorwarnung vom Heizer (Ä siehe Überwachung)
Å | Für die Kühlfunktion muss die Kältemaschine eingeschaltet sein (ÄF)

2.3.4.3 Feuchteregler H2_AHU2
Der Feuchteregler Umgebung regelt die absolute Feuchte an der Stelle H2_AHU2. Dabei ist die Sollwertvorgabe (ÄG) auf zwei Arten möglich:
Å | Absolute Feuchte H2_AHU2_abs Soll Es wird auf die absolute Feuchte geregelt.
Å | Relative Feuchte H2_AHU2_rel Soll Es wird auf die relative Feuchte geregelt. Der rel. Sollwert wird intern unter Berück- sichtigung der Solltemperatur T2_AHU2 in eine absolute Feuchte umgerechnet, die dann als interner Sollwert für die Regelung dient.

Zum Wechsel der Betriebsart F2 drücken, dies schaltet alle beide Sollwertfelder frei. Der jeweils zuletzt gesetzte Sollwert bestimmt die Betriebsart.
Der Reglerzustand wird mit den Indikatoren (ÄH) angezeigt. Mögliche Zustände sind:
Aus | Der Regler ist abgeschaltet, Befeuchter aus.
Halt | Der Regler ist angehalten. Der Stellwert an den Be-feuchter bleibt auf dem aktuellen Wert stehen.
Aktiv | Der Regler ist aktiv, Regelung auf absoluten Sollwert.

Der Reglerzustand kann manuell durch einen Rechtsklick auf den Indikator (Ä H) auf Aus oder Halt gesetzt werden.

Betriebsvoraussetzungen:
Å | Gebläse M1 AHU2 (FU) läuft
Å | Keine Vorwarnung vom Heizer (Ä siehe Überwachung)

Klimaprüfstand | Seite 16
Beschreibung Software | V1.00
Å | Für kleine Sollwerte der abs. Feuchte muss gegebenenfalls der Trockner zugeschaltet
werden (ÄK), entweder durch den Startknopf oder eine Sollwertvorgabe 25, 50, 75 oder 100%.

Nachfüllen:
Wenn der Wasserstand des Befeuchters zu weit absinkt, wird automatisch heißes Wasser nachgefüllt. Dies wird durch ein Symbol neben dem Befeuchtersymbol angezeigt. Abhängig von den Regelparametern wird während der Befüllung die Befeuchterleistung für eine gewisse Zeit ggf. noch erhöht.

2.3.4.4 Druckregler PDTP
Der Druckregler regelt den Ausgangsdruck der Umgebungssimulation. Falls die Durchflussregelung (s..u.) für den Prüflingsdurchfluss aktiviert ist, ist der Sollwert des Druckreglers (ÄL) hoch genug vorzugeben, damit die Durchflussreglung arbeiten kann.
Der Druckregler wirkt auf zwei Stellglieder, das Gebläse M1 AHU2 (ÄN) sowie die Drosselklappe V2 AHU2 (ÄP). Je nach Reglereinstellung wird die Klappe automatisch verstellt oder der Stellwert muss manuell vorgegeben werden.
Der Reglerzustand wird mit dem Indikator (ÄM) angezeigt. Mögliche Zustände sind:
Aus | Der Regler ist abgeschaltet, Gebläse aus. Die Drossel-klappe wird nicht geändert-
Halt | Der Regler ist angehalten. Die Stellwerte an das Geblä-se sowie die Regelklappe bleiben auf dem aktuellen Wert stehen.
Aktiv | Der Regler ist aktiv.
Diagnose | Die Stellwerte wurden in der Diagnosemaske manuell gesetzt.
Offen | Der Stellwert des Gebläses ist angehalten, die Drossel-klappe wird voll geöffnet.

Der Reglerzustand kann manuell durch einen Rechtsklick auf den Indikator (Ä M) auf Aus, Halt oder Offen gesetzt werden.

Der Regler startet automatisch bei Sollwertänderung oder Start des Gebläses. Umgekehrt wird das Gebläse gestartet, wenn der Regler aktiviert wird.
Beim Ausschalten des Gebläses wird der Regler in den Zustand Halt versetzt, damit die Drosselklappe V2 AHU2 stehen bleibt.

Klimaprüfstand | Seite 17
Beschreibung Software | V1.00

### 2.3.5 Regelkreise Prüflingsdurchfluss

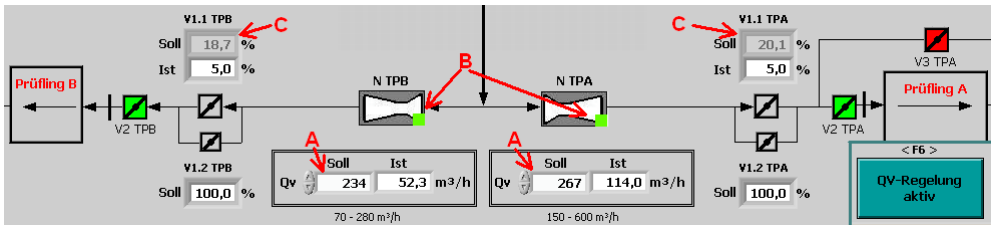
[picture p83: figure]

Messmaske: (Durchflussregler im QV-Modus)

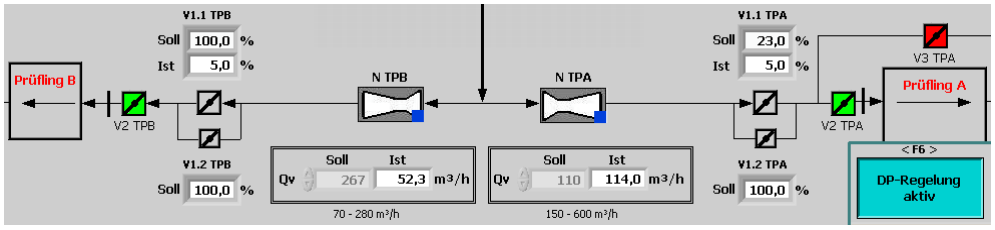
[picture p84: figure]

Messmaske: (Durchflussregler im DP-Modus)

Die Regelung für den Prüflingsdurchfluss besteht aus zwei Regelkreisen für Prüfling A und für Prüfling B. Die Funktionstaste F6 schaltet zwischen der Betriebsart QV-Regelung und DP-Regelung um. Bei DP-Regelung für (Prüflinge mit internem Gebläse) wird der Durchflussregler abgeschaltet und die Regelklappen geöffnet. Es arbeitet dann nur der Prüfdruckregler PD TP (Ä 2.3.4.4)

2.3.5.1 Durchflussregler N TPA
Der Durchflussregler N TPA regelt die Umgebungs-Luftmenge für den Prüfling A. In der Betriebsart QV-Regelung (Bild oben) erfolgt die Sollwertvorgabe über das Eingabefeld QV Soll (ÄA); die Messung des Istwertes erfolgt über die Venturi-Meßstelle N TPA (ÄB). Die Regelung verfügt über zwei Stellglieder: eine E-GAS-Klappe V1.2 TPA für die dynamische Regelung sowie eine (langsame) Regelklappe V1.1 TPA für die Grobeinstellung.
Der Reglerzustand wird mit den Indikator (ÄB) angezeigt. Mögliche Zustände sind:
Aus | Der Regler ist abgeschaltet, Regelklappen geschlossen.
Halt | Der Regler ist angehalten. Die Stellwerte an die Regelklappen bleiben auf ihrem aktuellen Wert stehen.
Aktiv | Der Regler ist aktiv, Durchflussregelung
Offen | Der Regler ist abgeschaltet, Regelklappe verstellbar, E-GAS offen

Der Reglerzustand kann manuell durch einen Rechtsklick auf den Indikator (Ä B) auf Aus oder Halt gesetzt werden.
Der Regler startet durch Sollwertänderung oder Öffnen von einer der Klappen V2 TPA oder V3 TPA. Sind beide Klappen geschlossen, so wird der Regler in den Zustand Halt versetzt (insofern ist der Zustand Aus bei geschlossenen Klappen nur kurzfristig möglich).

Klimaprüfstand | Seite 18
Beschreibung Software | V1.00

Beim Wechsel in die Betriebsart DP-Regelung (Bild unten) werden die E-GAS-Klappe und die Regelklappe geöffnet. Die Sollwerteingabe für den Durchfluss (ÄA) ist deaktiviert, dafür kann der Stellwert für die Regelklappe manuell vorgegeben werden (ÄC). Der Defaultwert hier ist 100%; eine Änderung des Stellwerts für den DP-Modus bleibt bis zum Neustart erhalten.

2.3.5.2 Durchflussregler N TPB
Der Durchflussregler N TPB regelt die Umgebungs-Luftmenge für den Prüfling B. Die Funktion ist prinzipiell identisch zu N TPA.

### 2.3.6 Datenspeicherung

Eine Datenspeicherung ist zur Zeit nicht vorgesehen, die Messwerte können aber über die Remoteschnittstelle ( Ä 3.1) abgerufen werden.

### 2.3.7 Überwachung

Fehler während des Prüfablaufs werden bei Bedarf erzeugt und in der Meldeleiste oberhalb der Funktionstasten angezeigt. Gegebenenfalls werden auch mehrere Fehler generiert (Fehlerhierarchie, insb. bei Kommunikationsfehlern oder Fehlern aus der Labview-Laufzeitumgebung). Dabei wird auf der Benutzeroberfläche immer nur der letzte (oberste) Fehler angezeigt, das Logfile speichert aber alle Fehler.
Alle Fehler müssen mit <F4> bestätigt werden und werden danach in das Logfile geschrieben.
Eine generelle Überwachung auf Not-Aus, Pneumatikausfall oder Klappen-Timeouts ist nicht vorgesehen.

Es gibt aber eine visuelle Überwachung für einzelne Teilbereiche der Anlage. Dabei werden diverse Digitaleingänge abgefragt und bei einer Störung ggf. Regler abgeschaltet:

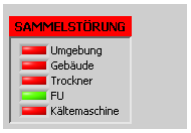
[picture p85: figure]

Anzeige für Störmeldungen.
Bei einer Störung leuchtet die Meldung „SAMMELSTÖRUNG“ auf. Die betroffenen Bereiche können an den Einzelanzeigen abgelesen werden.
Die Anzeige der Sammelstörung erfolgt mit 2 Sekunden Verzögerung zur Unterdrückung von Schaltvorgängen.

Anzeige für Vorwarnung
Bei drohender Überschreitung der inneren Temperatur eines Lufterhitzers leuchtet die Meldung „Warnung“ auf und die zugehörigen Regler werden abgeschaltet.

Tabelle der überwachten Eingänge:

Klimaprüfstand | Seite 19
Beschreibung Software | V1.00

Umgebung
Kanal | Beschreibung | Sollzustand IO | Reaktion NIO
DI 15 | STB Heizung Umgebung IO | Ein | Störung
DI 28 | Temperaturregler Kühlung Umgebung IO | Ein | Störung
DI 32 | Temperaturregler Heizung Umgebung IO | Ein | Störung
DI 34 | Motorschutz Heizung Umgebung ausgelöst | Aus | Störung
DI 35 | Motorschutz Befeuchter Umgebung ausgelöst | Aus | Störung
DI 33 | Vorwarnung Heizung Umgebung | Aus | Vorwarnung

Gebäude
Kanal | Beschreibung | Sollzustand IO | Reaktion NIO
DI 08 | Temperaturregler Kühlung Gebäude IO | Ein | Störung
DI 09 | Motorschutz Heizung Gebäude ausgelöst | Aus | Störung
DI 10 | Temperaturregler Heizung Gebäude IO | Ein | Störung
DI 12 | Motorschutz Befeuchter Gebäude ausgelöst | Aus | Störung
DI 14 | STB Heizung Gebäude IO | Ein | Störung
DI 11 | Vorwarnung Heizung Gebäude | Aus | Vorwarnung

Trockner
Wenn Trockner laufen soll (DO00 Sorbtionstrockner Ein = 1):
Kanal | Beschreibung | Sollzustand IO | Reaktion NIO
DI 16 | Sorptionstrockner läuft | Ein | Störung
DI 17 | Sorptionstrockner kein Alarm | Ein | Störung
DI 18 | Sorptionstrockner bereit | Ein | Störung

Wenn Trockner ausgeschaltet (DO00 Sorbtionstrockner Ein = 0):
Kanal | Beschreibung | Sollzustand IO | Reaktion NIO
DI 16 | Sorptionstrockner läuft | Aus | Störung

FU (Gebläse)
Kanal | Beschreibung | Sollzustand IO | Reaktion NIO
DI 24 | Motorschutz FU ausgelöst | Aus | Störung
DI 25 | FU Fehler | Aus | Störung
DI 26 | FU läuft | = DO14 FU Start | Störung
DI 27 | Thermoel.Motor FU ausgelöst | Aus | Störung

Kältemaschine
Kanal | Beschreibung | Sollzustand IO | Reaktion NIO
DI 29 | Wasserstand Kältemaschine IO | Ein | Störung
DI 30 | Kältemaschine bereit | Ein | Störung

Klimaprüfstand | Seite 20
Beschreibung Software | V1.00

### 2.4 Konfiguration

Die Konfiguration der Anlage gliedert sich in Systemparameter und Paßwortsystem. Diese Menüs sind nur der höchsten Benutzerebene (Administrator) zugänglich.
Als Systemparameter bezeichnet man per Prüfstandsprogramm einstellbare Daten, die jedoch nicht vom zu testenden Prüfling abhängen.

Achtung: Daten sollten in diesem Menü nur mit Vorsicht geändert werden.

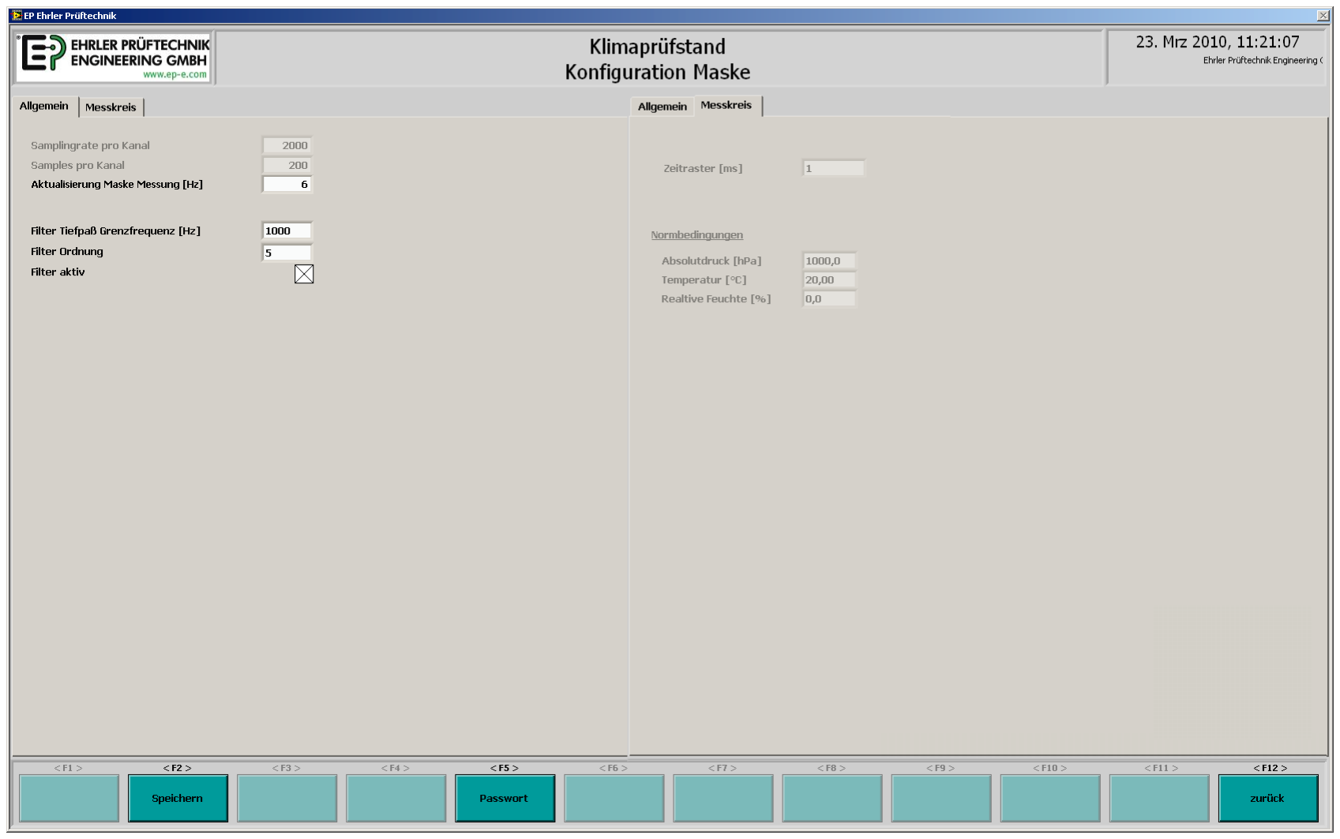
[picture p86: figure]

Maske Konfiguration (Register: Allgemein // Messkreis – gemeinsame Darstellung)

### 2.4.1 Bedienelemente und Anzeigen

Element | Funktion
< F2 > | Speichern geänderter Parameter
< F5 > | Verzweigt in das Passwort-Menü
< F10 > | Zurück ins Hauptmenü
Allgemein | Parameterseite für allgemeine Einstellungen
Messkreis | Parameterseite für Messungsvorgaben

Klimaprüfstand | Seite 21
Beschreibung Software | V1.00

### 2.4.2 Allgemein

PARAMETER | BESCHREIBUNG
Aktualisierung Maske Messung [Hz] Time Nozzles [s] | Aktualisierungsrate der angezeigten Messwerte
Filter Tiefpaß Grenzfrequenz [Hz] | Butterworth-Filter für analoge Eingänge, Grenzfrequenz
Filter Ordnung | Butterworth-Filter Ordnung
Filter aktiv | Butterworth-Filter ein/aus
Samlingrate pro Kanal | Abtastfrequenz pro Kanal, nur zur Information
Samples pro Kanal | Messwerte je Kanal pro DAQ-Zyklus, nur zur Information

### 2.4.3 Messkreis

PARAMETER | BESCHREIBUNG
Absolutdruck [hPa] | Absolutdruck für Normbedingungen
Temperatur [°C] | Temperatur für Normbedingungen
Relative Feuchte [%] | Feuchte für Normbedingungen
Filter aktiv | Butterworth-Filter ein/aus
Samlingrate pro Kanal | Abtastfrequenz pro Kanal, nur zur Information
Zeitraster [ms] | Vormittelung der Messwerte, nur zur Information

Anmerkung:
Die meisten Parameter sind für diese Anwendung nicht änderbar bzw. werden nicht benötigt (deshalb sind z.B. die Normbedingungen abgeblendet).

Klimaprüfstand | Seite 22
Beschreibung Software | V1.00

### 2.5 Passwortverwaltung

Dieses Menü dient zur Speicherung der Benutzernamen mit Passwörtern und der dazugehörigen Berechtigungsebenen. Es ist nur zugänglich aus der Maske „Konfiguration“.

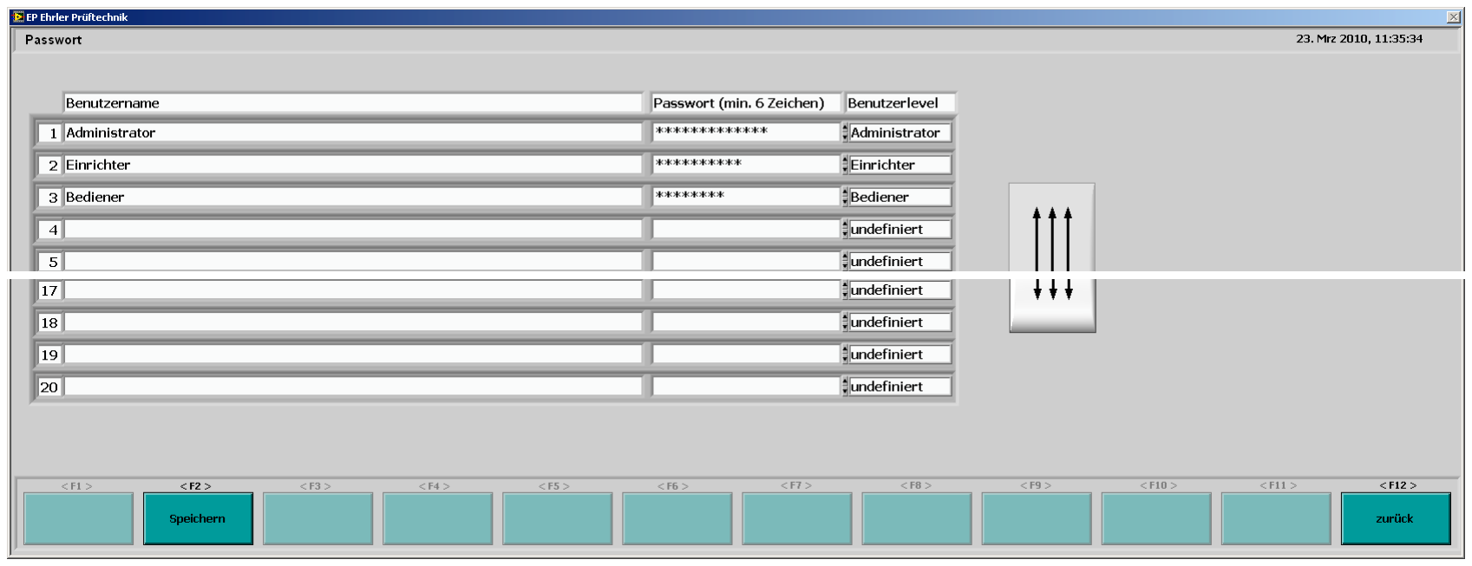
[picture p87: figure]

Maske Passwortverwaltung (Auschnitte)

Es können bis zu 40 Benutzer abgespeichert werden. In der linken Spalte wird der Benutzername, in der mittleren Spalte das Passwort (durch Sternchen überblendet) und in der rechten Spalte der Benutzerlevel eingegeben.
Ein gültiger Benutzereintrag besteht aus einem beliebigen Benutzernamen (betreffendes Feld nicht leer), einem Passwort aus mindestens sechs Zeichen und einer Berechtigungsebene, die nicht „undefiniert“ ist.

Bei Auslieferung sind folgende Benutzer angelegt:

Benutzername | Passwort | Berechtigung
Administrator | Administrator | Administrator
Einrichter | Einrichter | Einrichter
Bediener | Bediener | Bediener

Rechte:

PASSWORTLEVEL | BESCHREIBUNG
Undefiniert | Keine Rechte.
Bediener | Kann nur Messungen durchführen.
Einrichter | Kann Diagnose-Menüs einsehen
Administrator | Kann alle Teile der Software bedienen, auch das Konfigurationsmenü samt Passwortsystem sowie die Kalibrierdaten editieren.

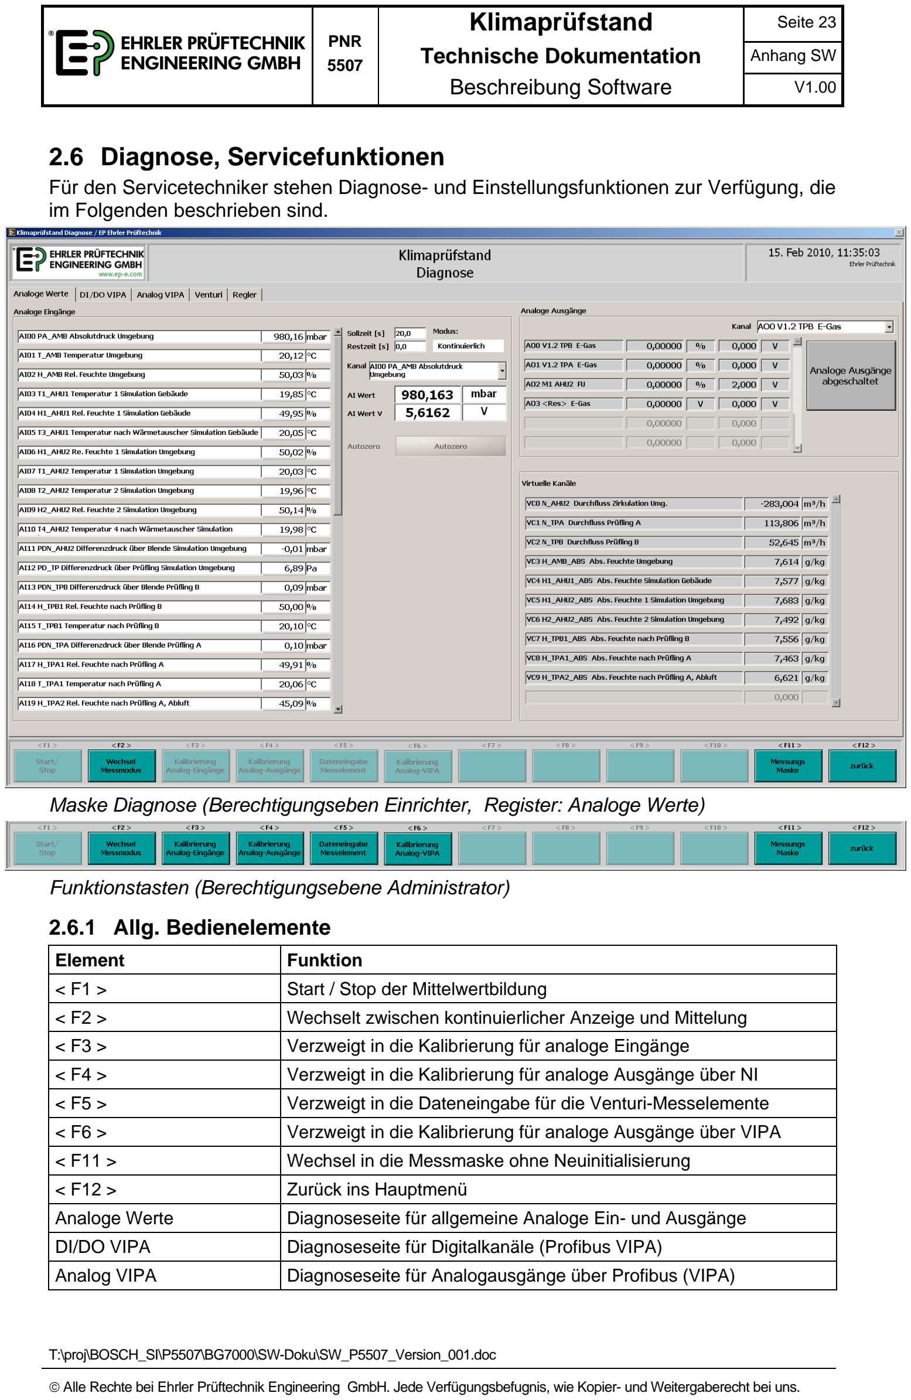
[picture p88: page 23]

Klimaprüfstand | Seite 23
Beschreibung Software | V1.00

### 2.6 Diagnose, Servicefunktionen

Für den Servicetechniker stehen Diagnose- und Einstellungsfunktionen zur Verfügung, die im Folgenden beschrieben sind.

Maske Diagnose (Berechtigungseben Einrichter, Register: Analoge Werte)

Funktionstasten (Berechtigungsebene Administrator)

### 2.6.1 Allg. Bedienelemente

Element | Funktion
< F1 > | Start / Stop der Mittelwertbildung
< F2 > | Wechselt zwischen kontinuierlicher Anzeige und Mittelung
< F3 > | Verzweigt in die Kalibrierung für analoge Eingänge
< F4 > | Verzweigt in die Kalibrierung für analoge Ausgänge über NI
< F5 > | Verzweigt in die Dateneingabe für die Venturi-Messelemente
< F6 > | Verzweigt in die Kalibrierung für analoge Ausgänge über VIPA
< F11 > | Wechsel in die Messmaske ohne Neuinitialisierung
< F12 > | Zurück ins Hauptmenü
Analoge Werte | Diagnoseseite für allgemeine Analoge Ein- und Ausgänge
DI/DO VIPA | Diagnoseseite für Digitalkanäle (Profibus VIPA)
Analog VIPA | Diagnoseseite für Analogausgänge über Profibus (VIPA)

Klimaprüfstand | Seite 24
Beschreibung Software | V1.00
Venturi | Diagnoseseite für Durchflussmessungen
Regler | Diagnose und Parametrierung der Regler

### 2.6.2 Analoge Werte

Analoge Eingänge:
Auf der linken Seite werden alle Analogeingangskanäle (AI) mit ihren Meßwerten und Einheiten angezeigt.
In der Mitte werden Details zu einem ausgewählten Kanal angezeigt.
PARAMETER | BESCHREIBUNG
Sollzeit [s] | Messzeit für Mittelwertbildung
Restzeit [s] | Zeigt die verbleibende Zeit bis zum Messungsende bei Mittelwertbil-dung
Modus: | Kontinuierlich: Meßwerte werden kontinuierlich aktualisiert Mittelwert: gleitende Mittelwertbildung über vorgegebene Zeit
Kanal | Einstellen des aktiven Kanals für die Detailanzeige, den Autozero sowie die Kalibrierung (mit <F3>).
AI Wert | Meßwert des eingestellten Kanals
AI Wert V | Spannungswert des eingestellten Kanals an der Meßkarte
Autozero | Für Relativdruckkanäle kann mit dem Autozero-Button ein automati-scher Nullpunktsabgleich gestartet werden. Dazu darf kein Druck am entsprechenden Sensor anliegen !

Ä Dies betrifft alle analogen Eingänge, sowohl AI00..AI31 über NI-Hardware als auch AI32..AI39 über VIPA-Module.

Analoge Ausgänge:
In der oberen rechten Hälfte des Fensters kann die Funktionalität der AO-Kanäle getestet werden.
Über den Taster auf der rechten Seite können die gesamten analogen Ausgänge abgeschaltet bzw. eingeschaltet werden.
Die Auswahl „Kanal“ bestimmt, welcher Kanal mit <F4> kalibriert werden kann.
Die analoge Ausgänge werden wie folgt dargestellt:
Kanalname | skalierter Wert | Spannung

Über die Eingabe des gewünschten Wertes im Feld „skalierter Wert“ wird der entsprechende Spannungswert auf den Ausgang gelegt und im Feld „Spannung“ angezeigt.

Ä Dies betrifft nur die analogen Ausgänge AO01..AO03 die über NI-Hardware ausgegeben werden.

Klimaprüfstand | Seite 25
Beschreibung Software | V1.00

Virtuelle Kanäle:
In der unteren rechten Hälfte des Fensters werden alle virtuellen Kanäle angezeigt. Virtuelle Kanäle sind keine direkten Messwerte, sondern werden aus mehreren Größen berechnet. Dies sind die Durchflussmesswerte, die absoluten Feuchten und die aus den absoluten Feuchten berechneten relativen Feuchten.
Zur Feuchterechnug siehe 3.2 !.

### 2.6.3 Digitale Kanäle

Diagnosemaske für die digitalen Kanäle, die über die VIPA-Module angeschlossen sind.

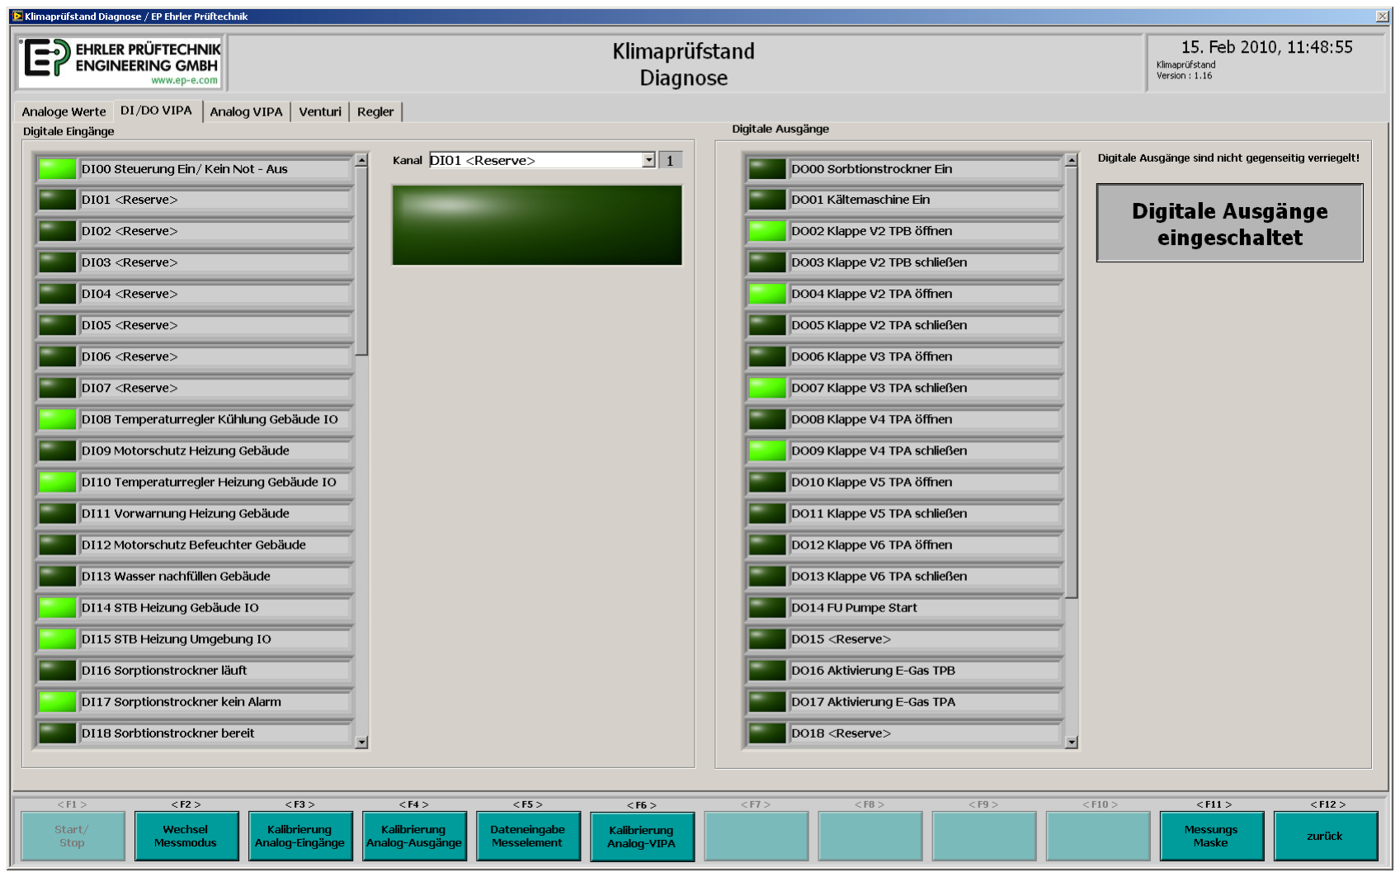
[picture p89: figure]

Maske Diagnose (Register: DI/DO VIPA)

Digitale-Eingänge
Auf der linken Seite werden die einzelnen digitalen Eingänge mit ihrem boolschen Wert dargestellt. Ein hellgrüner Indikator zeigt ein vorhandenes Eingangssiganl (ein, true) an. Mit dem Auswahlfeld Kanal kann ein Kanal für die vergrößerte Anzeige ausgewählt werden (z.B. bei Fehlersuche in der Anlage nützlich).
Digitale-Ausgänge
Auf der rechten Seite werden die einzelnen digitalen Ausgänge mit ihrem boolschen Wert dargestellt. Durch Anklicken der grünen Anzeigen kann der Schaltzustand des Ausgangs geändert werden., solange der Button Digitale Ausgänge eingeschaltet aktiv ist.

Digitale Ausgänge sind nicht untereinander verriegelt und Änderungen werden sofort in der Anlage wirksam !

Klimaprüfstand | Seite 26
Beschreibung Software | V1.00

### 2.6.4 Analog VIPA

Diagnosemaske für zusätzliche Analoausgänge über VIPA-Module.

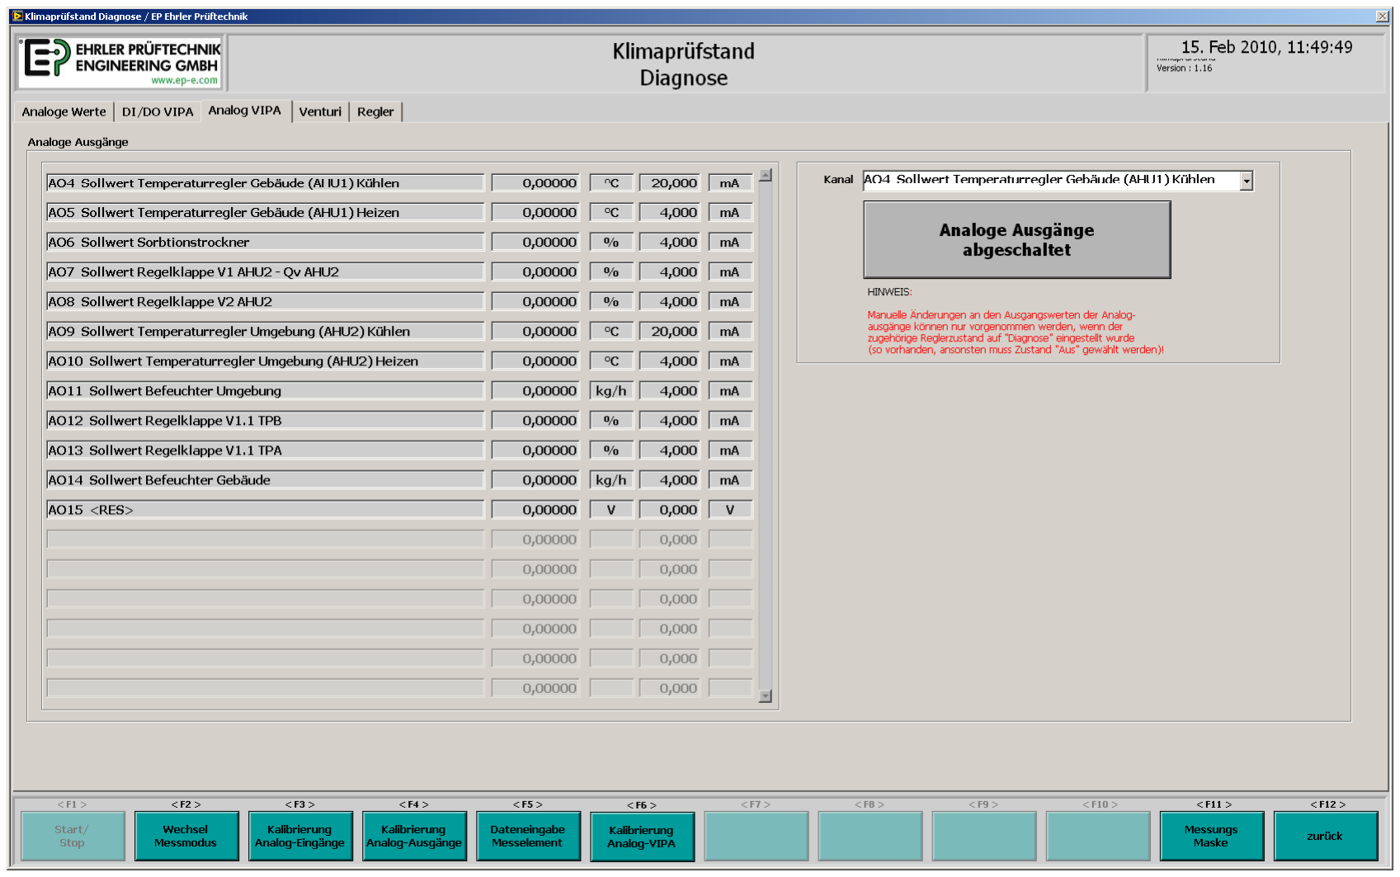
[picture p90: figure]

Maske Diagnose (Register: Analog VIPA)

Über den Taster auf der rechten Seite können die gesamten analogen Ausgänge abgeschaltet bzw. eingeschaltet werden.
Die Auswahl „Kanal“ bestimmt, welcher Kanal mit <F6> kalibriert werden kann.
Die analoge Ausgänge werden wie folgt dargestellt:
Kanalname | skalierter Wert Strom

Über die Eingabe des gewünschten Wertes im Feld „skalierter Wert“ wird der entsprechende Spannungswert auf den Ausgang gelegt und im Feld „Spannung“ angezeigt.

Ä Dies betrifft nur die analogen Ausgänge AO04..AO15, die über VIPA-Hardware ausgegeben werden.
Manuelle Änderungen an den Ausgangswerten der Analogausgänge können nur vorgenommen werden, wenn der zugehörige Reglerzustand auf "Diagnose" eingestellt wurde (so vorhanden, ansonsten muss Zustand "Aus" gewählt werden)!

Klimaprüfstand | Seite 27
Beschreibung Software | V1.00

### 2.6.5 Venturi

Diagnosemaske für die Venturiauswertung.

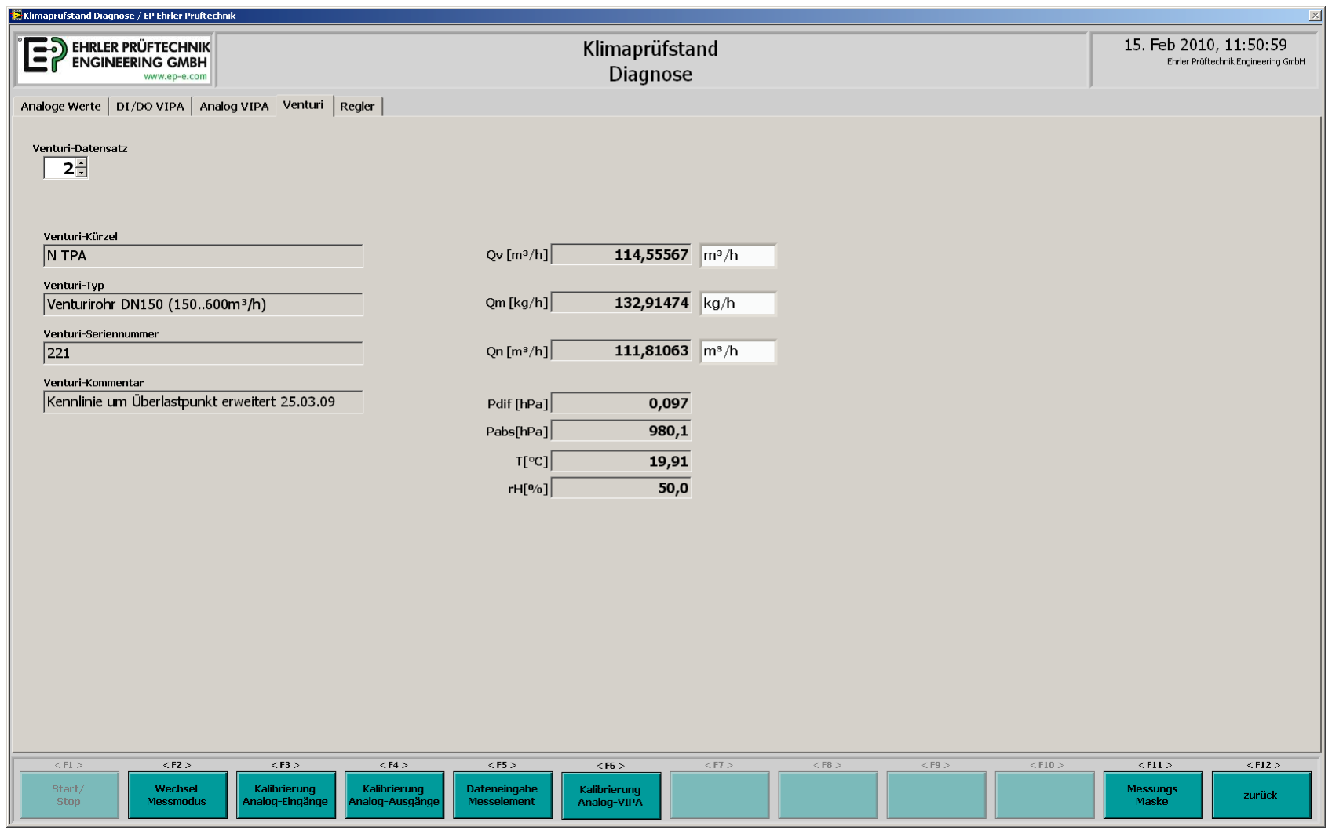
[picture p91: figure]

Maske Diagnose (Register: Venturi)

PARAMETER | BESCHREIBUNG
Venturi Datensatz | Auswahl des angezeigten Venturielements 1...3. Das hier ausgewählte Element kann dann auch mit < F5 > editiert werden.
Kürzel, Typ, Serien-nummer, Kommentar | Informationen aus dem Kalibrierdatensatz des Elements
Qv [m³/h] | Aktuell berechneter Volumenstrom des Elements *)
Qm [kg/h] | Aktuell berechneter Massenstrom des Elements *)
Qn [m³/h] | Aktuell berechneter Normvolumenstrom des Elements *)
Pdif [h] | Differenzdruck (Wirkdruck) am Messelement.
Pabs, T, rH | Absolutdruck, Temperatur und Feuchte am Messelement.

*) Die hier angezeigten Messwerte sind aus den Sensordaten berechnete theoretische Werte. Es wird nicht berücksichtigt, ob das Messelement tatsächlich durchströmt wird !

Klimaprüfstand | Seite 28
Beschreibung Software | V1.00

### 2.6.6 Regler

Diagnosemaske für Inbetriebnahme und Konfiguration der Regler .

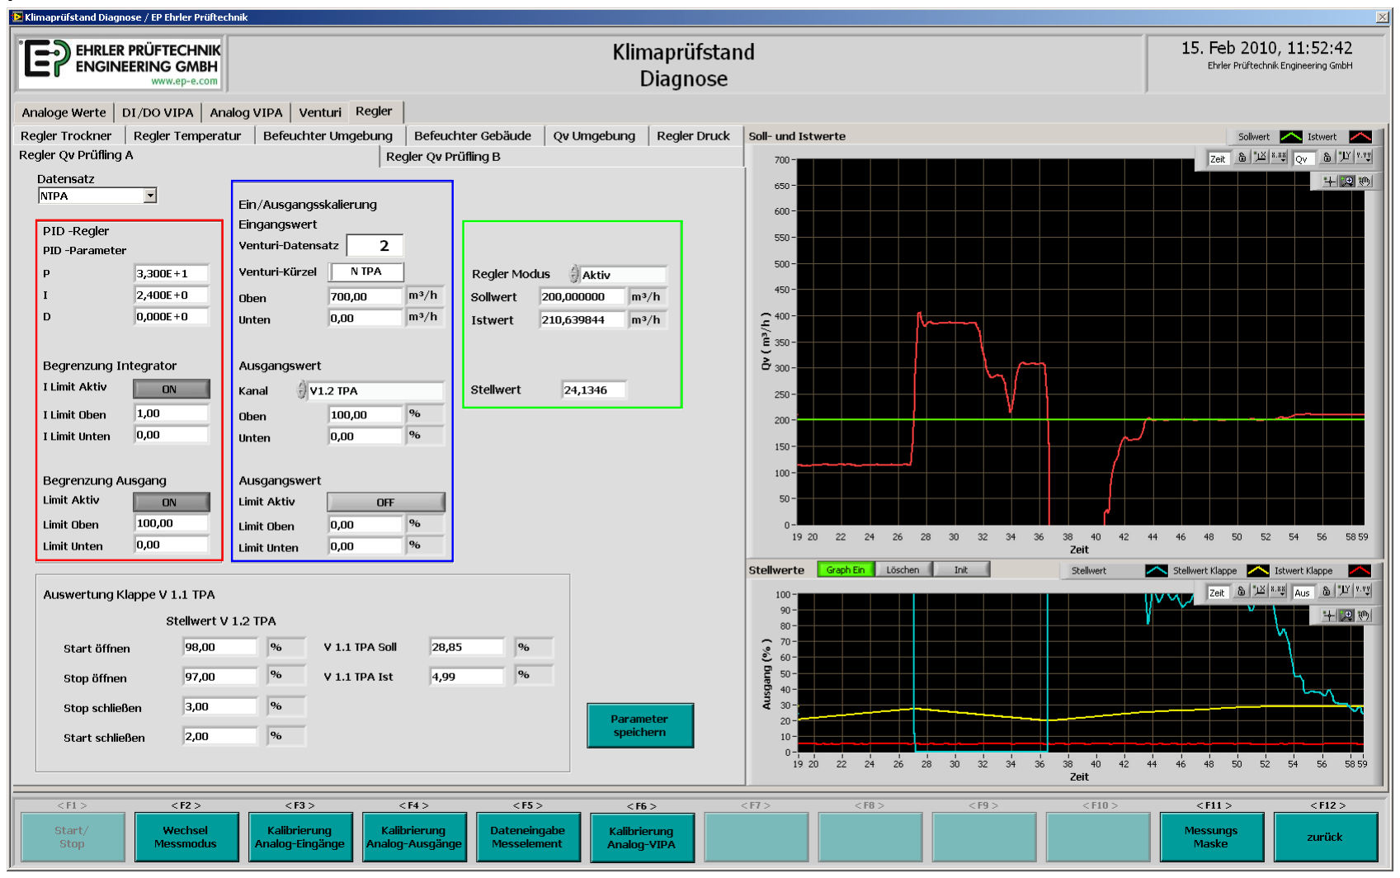
[picture p92: figure]

Maske Diagnose (Register: Regler Qv Prüfling A)
In der Reglerdiagnose können alle Regler parametriert und das Regelverhalten grafisch betrachtet werden. Je nach Anwendung sind unterschiedliche Reglertypen implementiert. Im nächsten Abschnitt werden zunächst die grundlegenden Konzepte betrachtet, die Besonderheiten einzelner Regelkreise folgen danach.

2.6.6.1 Allgemeines
Alle Regler haben ein Auswahlfeld Regler Modus zum Setzen der Betriebsart.
Mit Ausnahme des Reglers für den Trockner haben alle Regler zudem ein oder mehrere Sollwert Eingabefelder, eine Istwert-anzeige sowie ein oder mehrere Anzeigen für den Stellwert.

Der hier am häufigsten verwendete Regler ist ein üblicher PID-Regler, der ggf. durch Zusatzfunktionen erweitert wurde.
Die Eingangsgrößen Istwert und Sollwert der Regler sind normierte Größen im Wertebereich 0...1. Auf die Regelabweichung (Sollwert-Istwert) werden zunächst die üblichen P-, I- und D-Algorithmen getrennt angewendet. Der Ausgang des I-Anteils kann über die Parameter Begrenzung Integrator im Hub begrenzt werden, das verkürzt die Erholzeit nach Störungen, bei denen kein Regelerfolg zu erzielen war. Die Summe aller drei Anteile P,I und D ergibt dann den Reglerausgang, der über die Funktion Begrenzung Ausgang nochmals begrenzt werden kann.

Klimaprüfstand | Seite 29
Beschreibung Software | V1.00

Die Verbindung zwischen den physikalischen Regelgrößen und der normierten Einund Ausgabe des PID-Reglers erfolgt über die Ein/Ausgangsskalierung.
Soll- und Istwert werden so skaliert, daß der Eingangswert oben auf 1 und der Eingangswert unten auf 0 abgebildet wird. Die so normierten Werte werden dann an den PID-Regler übergeben (s.o.)
Der Reglerausgang wird dann zurückskaliert, sodaß ein Wert von 0 auf den Ausgangswert unten und ein Wert von 1 auf den Ausgangswert oben abgebildet wird. Der so gebildete Stellwert kann dann noch über Ausgangswert Limit begrenzt werden und wird dann an die zugeordneten Stellglieder übergeben.

In der oberen Grafik auf der rechten Seite der Maske werden Soll- und Istwert dargestellt, in der unteren Grafik der/die Stellwert(e) und ggf. noch Istwerte von Regelklappen.
Die Grundskalierung der Y-Achsen wird so vorhanden der Ein/Ausgangsskalierung entnommen oder ist fest vorgegeben.
Die Grafik kann über folgende Bedienelemente beinflusst werden:
Aktiviert die Aufzeichnung oder hält die Darstellung an
Löscht die Kurven ohne Änderung des Maßstabes

Löscht die Kurven und setzt die Skalierungen auf Defaultwerte

Labview-Standard Zoom- und Pan-Funktionen Labview-Standard Skalierungsfunktionen für die Achsen

Änderungen an den Reglerparametern werden sofort aktiv. Für eine dauerhafte Speicherung der Änderungen ist die Funktionstaste Parameter speichern zu betätigen.

2.6.6.2 Analoge Ausgänge und Regler in der Diagnose
Alle Regler benutzen analoge Ausgänge für die Ansteuerung der Stellglieder. Gleichzeitig sollen die analogen Ausgänge in der Diagnose auch manuell verstellbar sein. Daher wurde die Verarbeitung der Analogausgänge wie folgt implementiert:

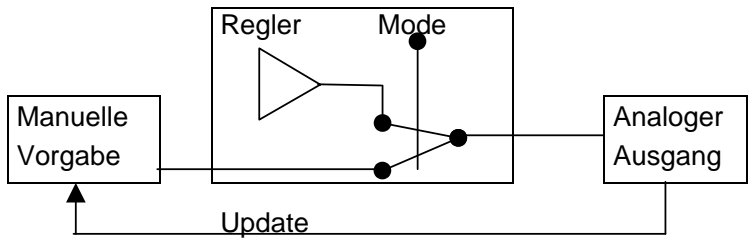
[picture p93: figure]
Manuelle Vorgabe; Regler; Mode; Analoger Ausgang; Update

Wenn der Regler aktiv ist, steuert sein Ausgangssignal den Analogausgang. Im Modus Aus oder Diagnose wird die manuelle Vorgabe durchgereicht. Die Eingabefelder für die manuelle Vorgabe werden dem aktuellen Zustand nachgeführt. Beim Setzen des Zustands Aus eines Regler wird normalerweise der Ausgang auf 0 gesetzt, dementsprechend auch die manuelle Vorgabe.Der Zustand Diagnose wurde für die Regler vorgesehen, bei denen eine manuelle Defaultvorgabe von 0 im Zustand Aus kein sicherer Zustand wäre.

Klimaprüfstand | Seite 30
Beschreibung Software | V1.00

2.6.6.3 Regler Qv Prüfling A

Istwertkanal: VC01 N_TPA Durchfluss Prüfling A | m³/h | virtueller Kanal
Stellwert 1: | AO01 V1.2 TPA E-Gas | % | analoger Ausgang NI
Stellwert 2: | AO13 Sollwert Regelklappe V1.1 TPA | % | analoger Ausgang VIPA

Algorithmus für Stellwert 1: PID-Regler wie unter Allgemeines beschrieben Algorithmus für Stellwert 2: Wenn der Verstellbereich der E-Gas-Klappe nicht ausreicht, wird gegebenenfalls die parallel angeordnete Klappe V1.1 TPA geöffnet oder geschlossen. Dazu sind folgende Zusatzparameter vorgesehen:

PARAMETER | BESCHREIBUNG
Start öffnen | Wenn Stellwert 1 diesen Wert überschreitet, beginnt die Klappe V1.1 TPA zu öff-nen. Dazu wird deren Sollwert kontinuierlich mit einer definierten Steigung erhöht.
Stop öffnen | Wenn Stellwert 1 diesen Wert unterschreitet, wird die Klappe V1.1 TPA angehal-ten.
Stop schließen | Wenn Stellwert 1 diesen Wert überschreitet, wird die Klappe V1.1 TPA angehal-ten.
Start schließen | Wenn Stellwert 1 diesen Wert unterschreitet, beginnt die Klappe V1.1 TPA zu schließen. Dazu wird deren Sollwert kontinuierlich mit einer definierten Steigung verringert.
(Steigung) | Die Verstellgeschwindigkeit der Klappe ist mit 0,7 % / sec fest eingestellt

Besondere Betriebsarten:

MODE | STELLWERT 1 | STELLWERT 2
Aus | Manuelle Vorgabe (0%) | Manuelle Vorgabe (0%)
Anhalten | Alter Wert | Alter Wert
Offen *) | 100 % | Offen-Wert (Default 100%)

Die Betriebsart offen wird bei DP-Reglung in der Messmaske verwendet, um die Strecke zu öffnen.

2.6.6.4 Regler NTPB

Identisch zu Regler NTPA.

Istwertkanal: VC02 N_TPB Durchfluss Prüfling B | m³/h | virtueller Kanal
Stellwert 1: | AO00 V1.2 TPB E-Gas | % | analoger Ausgang NI
Stellwert 2: | AO12 Sollwert Regelklappe V1.1 TPB | % | analoger Ausgang VIPA

Klimaprüfstand | Seite 31
Beschreibung Software | V1.00

2.6.6.5 Regler Trockner

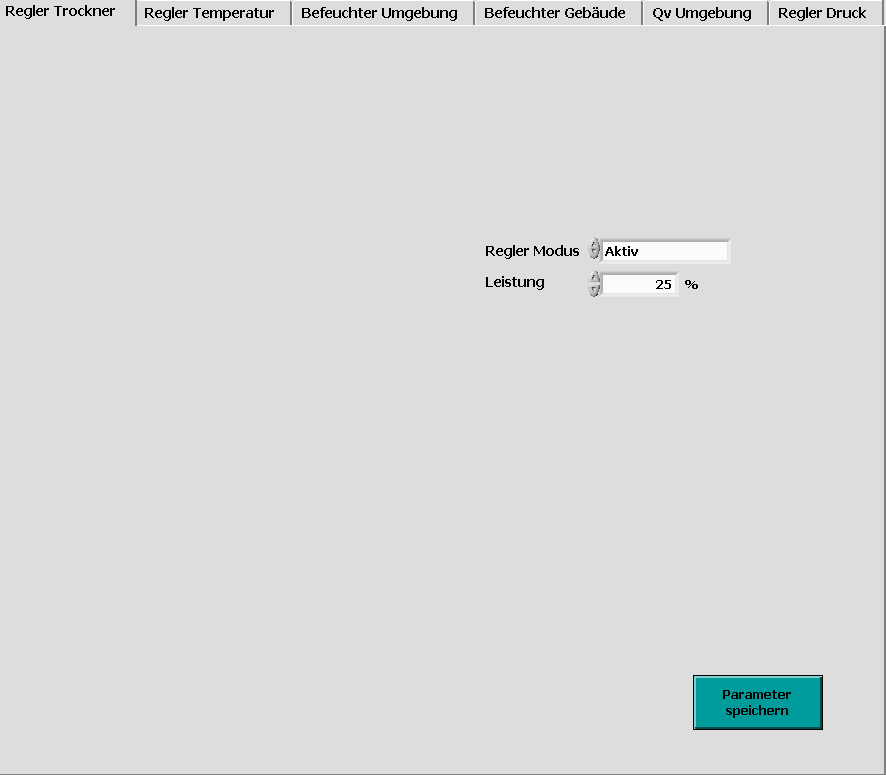
[picture p94: figure]

Register: Regler Trockner

Stellwert: | AO06 Sollwert Sorptionstrockner | % | analoger Ausgang VIPA

Derzeit wird der Trockner nicht geregelt, sondern nur manuell gestellt. Dementsprechend beschränkt sich die Regelfunktion auf das Setzen des Analogausgangs.
Die Grafik wird nicht verwendet.

Der Trockner selbst erkennt nur 5 unterschiedliche Eingangssignale zur Steuerung seiner Leistung: 0, 25; 50; 75 und 100%.

Klimaprüfstand | Seite 32
Beschreibung Software | V1.00

2.6.6.6 Regler Temperatur Gebäude

Die Temperaturregler für Gebäude und Umgebung verwenden jeweils zwei externe Hardware-Regler für den Kühler und den Heizer. Der Software-Regler versorgt diese mit den Sollwerten.
Das Auswahlfeld Datensatz unterscheidet zwischen der Gebäude- und der Umgebungsregelung:

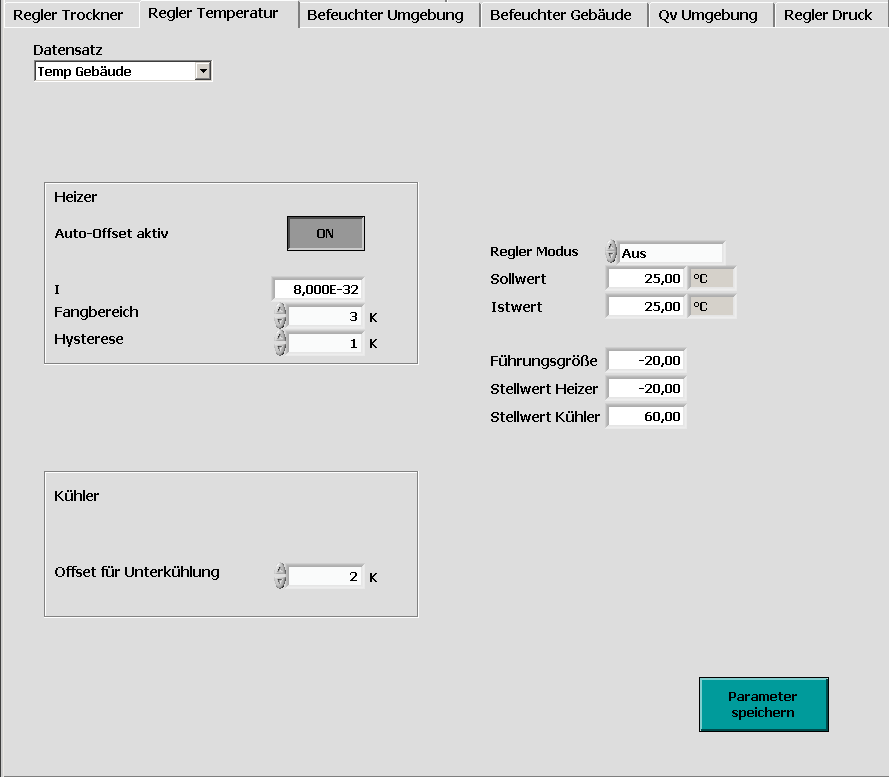
[picture p95: figure]

Register: Regler Temperatur

Regler Temperatur Gebäude:
Istwertkanal: AI03 | T1_AHU1 Temperatur 1 Simulation Gebäude °C analoger Eingang NI
Bezugskanal: AI18 | T_TPA1 Temperatur nach Prüfling A | °C analoger Eingang NI
Stellwert 1: | AO05 Sollwert T-Regler Geb (AHU1) Heizen | °C analoger Ausgang VIPA
Stellwert 2: | AO04 Sollwert T-Regler Geb (AHU1) Kühlen | °C analoger Ausgang VIPA

Algorithmus für Stellwert 1: Stellen mit überlagertem I-Regler
Algorithmus für Stellwert 2: Stellen mit festem Offset zum Sollwert

Klimaprüfstand | Seite 33
Beschreibung Software | V1.00

Der Regler unterstützt sowohl eine absolute Regelung (interner Sollwert = fester Sollwert) als auch eine Differenzregelung (Über- oder Untertemperatur bezogen auf den Bezugskanal, interner Sollwert = Bezugskanal+Sollwertdifferenz)
Der interne Sollwert (Führungsgröße) wird zunächst direkt an den Heizregler ausgegeben (Stellwert 1), der Kühlregler erhält einen um einen Offset reduzierten Stellwert 2. Dadurch wird immer auf den Zielwert zugeheizt, was dynamischer ist als die relativ träge Kühlung. In der Praxis bleibt aber bei ausschließlicher Verwendung der Hardwareregler ein bleibender Regelfehler, da die Sensoren der Hardwareregler in Strömungsrichtung gesehen vor dem Istwertsensor eingebaut sind.
Bei aktiviertem Auto-Offset wird daher der Heizregler nachgeführt. Sobald der Istwert sich in einem definierten Fangbereich um den Sollwert befindet, wird ein I-Regler zugeschaltet, der den Stellwert 1 an den Heizregler langsam nachführt, bis die Abweichung ausgeglichen ist. Stellwert 2 an den Kühlregler ist davon nicht betroffen !
Die Nachführung ist danach solange aktiv, bis der Istwert das um die Hysterese erweiterte Fenster des Fangbereichs verlässt.
PARAMETER | BESCHREIBUNG
Auto-Offset aktiv | Schaltet die Sollwertnachführung für den Heizregler ein oder aus
I | Integratorzeitkonstante für die Nachführung
Fangbereich | Breite des Fensters um den Sollwert für Start der Nachführung
Hysterese | Erweiterung des Fensters um den Sollwert für Abbruch der Nachführung.
Offset für Unterkühlung | Verminderung des Stellwerts für den Kühler bezogen auf den Sollwert

Beispiel: Istwert = 17°C, Sollwert=25°C; Fangbereich = 3K, Hysterese=1K, Regler starten; die Nachführung beginnt, sobald der Istwert 22°C erreicht hat. Die Nachführung ended, sobald der Istwert >29 oder <21°C wird. Die Nachführung endet also auch, wenn der Sollwert auf einen Wert von ausserhalb von Istwert É4K gesetzt wird.

Betriebsarten:

MODE | STELLWERT 1 | STELLWERT 2
Aus | -20°C Ä Heizer aus | 60°C Ä Kühler aus
Anhalten | Alter Wert | Alter Wert
Aktiv | Sollwert *) | Sollwert - Offset Unterkühlung
Aktiv-Diff | Bezugswert + Sollwertdifferenz *) | Bezugswert+Sollwertdifferenz - Offset Unterkühlung
Diagnose | Manuelle Vorgabe (-20°C) | Manuelle Vorgabe (60°C)
*) ggf. zuzüglich Nachführung

Klimaprüfstand | Seite 34
Beschreibung Software | V1.00

2.6.6.7 Regler Temperatur Umgebung

Der Temperaturegler Umgebung ist prinzipiell identisch zum Temperaturregler des Gebäudes, nur wird hier keine Differenzregelung unterstützt. Der Modus Aktiv-Diff kann nicht gewählt werden.

Istwertkanal: AI08 | T2_AHU2 Temperatur 2 Simulation Umg. | °C analoger Eingang NI
Stellwert 1: | AO10 Sollwert T-Regler Umg (AHU2) Heizen | °C analoger Ausgang VIPA
Stellwert 2: | AO09 Sollwert T-Regler Umg (AHU2) Kühlen | °C analoger Ausgang VIPA

Klimaprüfstand | Seite 35
Beschreibung Software | V1.00

2.6.6.8 Regler Feuchte Gebäude

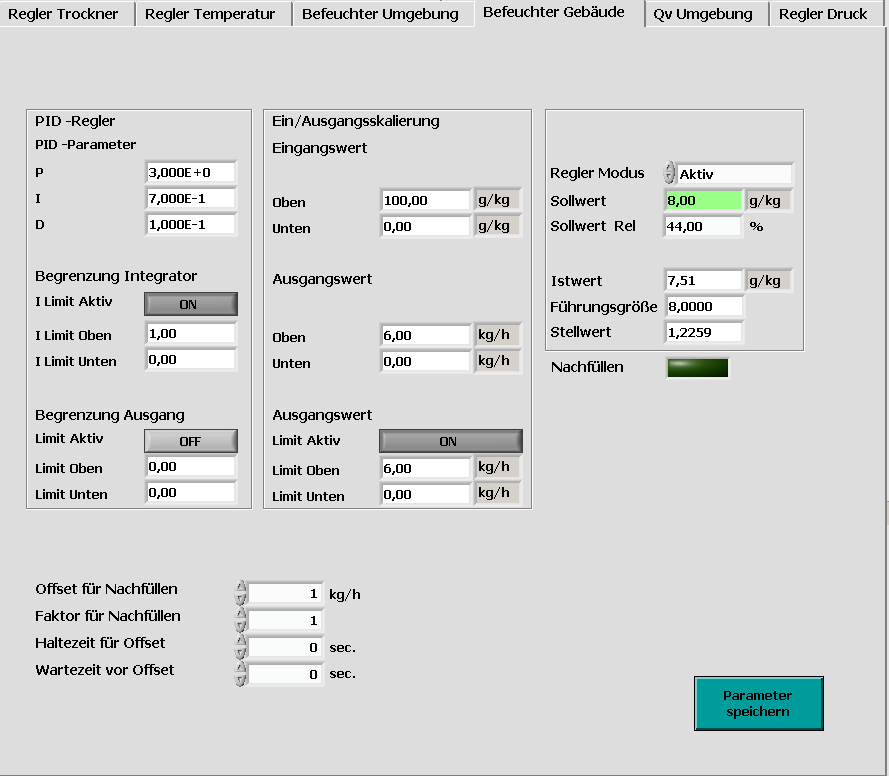
[picture p96: figure]

Register: Befeuchter Gebäude

Istwertkanal: VC04 H1_AHU1_ABS
| Abs. Feuchte Simulation Gebäude | g/kg | virtueller Kanal
Bezugskanal: VC08 H_TPA1_ABS
| Abs. Feuchte nach Prüfling A | g/kg | virtueller Kanal
Stellwert: | AO14 Sollwert Befeuchter Gebäude | kg/h | analoger Ausgang VIPA
Algorithmus für Stellwert : | PID-Regler mit Zusatzfunktion bei Nachfüllen

Der Feuchteregler Gebäude regelt prinzipiell immer die absolute Feuchte an der Stelle H1_AHU1. Daher ist die Führungsgröße immer eine absolute Feuchte.Die Sollwertvorgabe ist dagegen auf verschiedene Weise möglich:
Å Sollwert = absolute Feuchte (Modus Aktiv mit abs. Sollwert)
Dies ist die normale, einfachste Betriebsart.

Klimaprüfstand | Seite 36
Beschreibung Software | V1.00
Å | Sollwert = relative Feuchte (Modus Aktiv mit rel. Sollwert)
Der Sollwert ist hier die gewünschte relative Feuchte an der Stelle H1_AHU1. Daher muss dieser Sollwert umgerechnet werden in eine absolute Führungsgröße.
Dazu wird die absolute Feuchte aus der relativen Vorgabe, dem internen Sollwert des Temperaturreglers Gebäude sowie dem Umgebungsdruck berechnet.
Å Sollwert = absolute Feuchtedifferenz zu einem Bezugskanal (Modus Aktiv-Diff mit abs. Sollwert)
Der Sollwert ist hier eine gewünschte absolute Feuchtedifferenz zum Messpunkt vor dem Befeuchter (Ausgang des Prüflings A). Die Führungsgröße ist daher der Messwert der absoluten Feuchte H_TPA1_ABS zuzüglich dem Differenzsollwert.
Der jeweils aktive Sollwert abs/diff wird durch ein grün hinterlegtes Eingabefeld markiert. Der Befeuchter besteht aus einem Wassertank, aus dem Wasser durch Erhitzen verdampft wird. Von Zeit zu Zeit muss der Tank daher nachgefüllt werden. Dies regelt der Befeuchter selbst und gibt dabei ein Digitalsignal aus. Dieses Signal ist durch den Indikator Nachfüllen auf der Maske sichtbar. Da während des Nachfüllens die Wassertemperatur sinkt, sinkt auch die Leistung des Befeuchters. Zur Kompensation wird daher beim Nachfüllen der Stellwert an den Befeuchter vorübergehend erhöht.
Die Parameter dafür sind:
PARAMETER | BESCHREIBUNG
Offset für Nachfüllen | Additive Stellwerterhöhung
Faktor für Nachfüllen | Multiplikative Stellwerterhöhung
Haltezeit für Offset | Nachlaufzeit für Stellwerterhöhung
Wartezeit vor Offset | Verzögerungszeit vor der Stellwerterhöhung

Der erhöhte Stellwert u* errechnet sich aus dem Stellwert u zu: u* = u Å Faktor + Offset.

Besondere Betriebsarten:

MODE | STELLWERT
Aus | Manuelle Vorgabe (0 kg/h)
Anhalten | Alter Wert

2.6.6.9 Regler Feuchte Umgebung

Die Funktionsweise des Regler für die Umgebungsfeuchte ist prinzipiell identisch zum Feuchteregler Gebäude, es gibt hier aber keine Differenzregelung.
Istwertkanal: VC06 H2_AHU2_ABS
| Abs. Feuchte Simulation Umgebung | g/kg | virtueller Kanal
Stellwert: | AO11 Sollwert Befeuchter Umgebung | kg/h | analoger Ausgang VIPA
Bei relativem Sollwert wird die absolute Feuchte aus der relativen Vorgabe, dem internen Sollwert des Temperaturreglers Umgebung sowie dem Absolutdruck, gebildet aus Umgebungsdruck PA_AMB + Diferenzdruck PD_TP, berechnet.

Klimaprüfstand | Seite 37
Beschreibung Software | V1.00
2.6.6.10 | Regler QV Umgebung

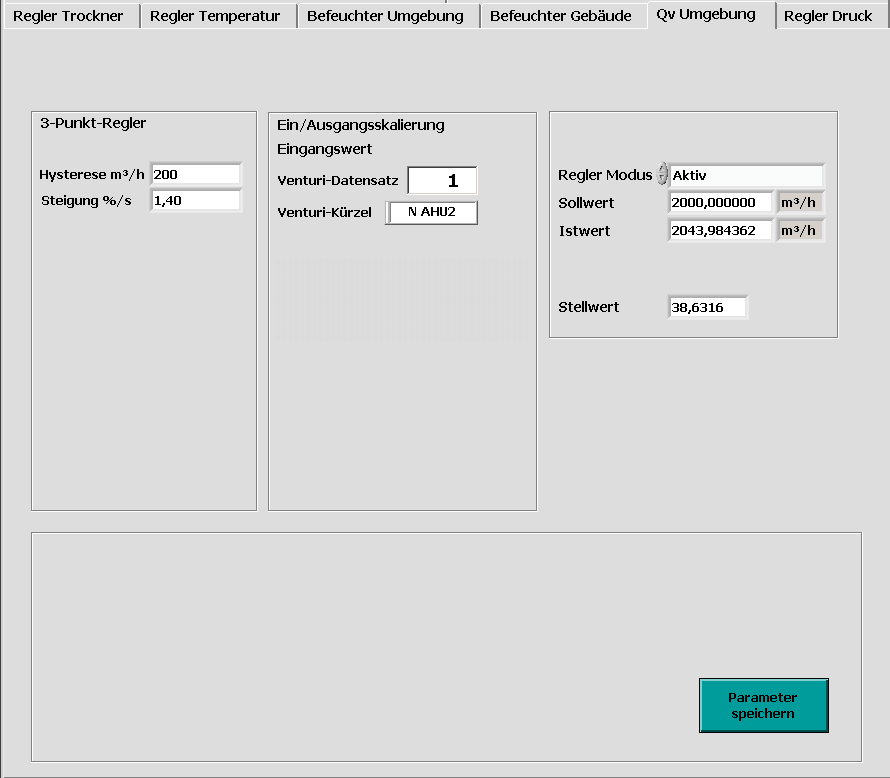
[picture p97: figure]

Register: Qv Umgebung

Istwertkanal: VC00 N_AHU2 Durchfluss Zirkulation Umg | m³/h | virtueller Kanal
Stellwert: | AO7 | Sollwert Regelklappe V1 AHU2 | % | analoger Ausgang VIPA
Algorithmus für Stellwert : | 3-Punkt-Regler mit Hysterese
Der Durchflussregler für die Zirkulationsluftmenge arbeitet als einfacher Dreipunktregler. Weicht der Istwert um mehr als die Hysterese vom Sollwert ab, wird die Regelklappe V1 AHU2 mit konstanter Geschwindigkeit verstellt, bis der Istwert wieder im Hysteresfenster ist.
PARAMETER | BESCHREIBUNG
Hysterese | Zulässige Abweichung vom Sollwert ohne daß die Regelklappe verstellt wird
Steigung | Verstellgeschwindigkeit der Regelklappe

Klimaprüfstand | Seite 38
Beschreibung Software | V1.00
2.6.6.11 | Regler Druck

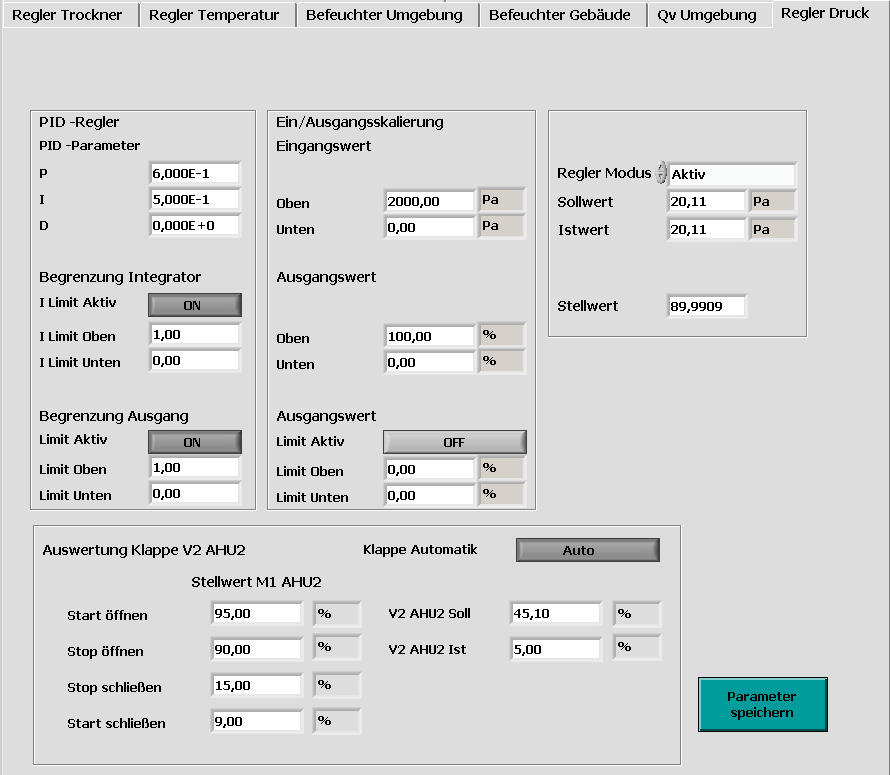
[picture p98: figure]

Register: Regler Druck

Istwertkanal: AI12 | PD_TP Differenzdruck über Prüfling | Pa | analoger Eingang NI
Stellwert 1: | AO02 M! AHU2 FU | % | analoger Ausgang N
Stellwert 2: | AO08 Sollwert Regelklappe V2 AHU2 | % | analoger Ausgang VIPA

Algorithmus für Stellwert 1: PID-Regler wie unter Allgemeines beschrieben
Algorithmus für Stellwert 2: Bei Betrieb mit Trockner (Überdruck !) oder bei Prüflingen mit integriertem Gebläse (Unterdruck !) kann es sein, daß der Dynamikbereich des Gebläses (FU) nicht ausreicht um den Prüfdruck einzuregeln. Dann muss gegebenenfalls die Drosselklappe Klappe V2 AHU2 geöffnet oder geschlossen werden. Dazu sind folgende Zusatzparameter vorgesehen:
PARAMETER | BESCHREIBUNG
Klappe Auto-matik | Im Automatikbetrieb der Drosselklappe wird die Klappe automatisch verstellt, ent-sprechend den folgenden Parametern. Im Manuellbetrieb kann die Klappenstellung von Hand vorgegeben werden.

Klimaprüfstand | Seite 39
Beschreibung Software | V1.00
Start öffnen | Wenn Stellwert 1 diesen Wert überschreitet, beginnt die Klappe V2 AHU2 zu öff-nen. Dazu wird deren Sollwert kontinuierlich mit einer definierten Steigung erhöht.
Stop öffnen | Wenn Stellwert 1 diesen Wert unterschreitet, wird die Klappe V2 AHU2 angehal-ten.
Stop schließen | Wenn Stellwert 1 diesen Wert überschreitet, wird die Klappe V2 AHU2 angehal-ten.
Start schließen | Wenn Stellwert 1 diesen Wert unterschreitet, beginnt die Klappe V2 AHU2 zu schließen. Dazu wird deren Sollwert kontinuierlich mit einer definierten Steigung verringert.
(Steigung) | Die Verstellgeschwindigkeit der Klappe ist mit 0,7 % / sec fest eingestellt

Besondere Betriebsarten:

MODE | STELLWERT 1 | STELLWERT 2
Aus (Auto) | Manuelle Vorgabe (0%) | 100%
Anhalten (Auto) | Alter Wert | Alter Wert
Offen (Auto) | Alter Wert | 100%
Aus (Manuell) | Manuelle Vorgabe (0%) | Offen-Wert (Default 100%)
Anhalten (Manuell) | Alter Wert | Offen-Wert (Default 100%)
Offen (Manuell) | Alter Wert | Offen-Wert (Default 100%)
Diagnose | Manuelle Vorgabe (0%) | Manuelle Vorgabe (0%)

Klimaprüfstand | Seite 40
Beschreibung Software | V1.00

### 2.7 Editor, Analog-Kanäle

In dieser Maske werden die Konfigurationsdaten der Analog-Kanäle eingestellt. Diese Konfigurationsdaten werden in der Skalierrechnung verwendet.
Die Skalierrechnung ist in folgende Schritte eingeteilt:
a) Ermitteln des Wertes der Eingangsgröße
b) Je nach Interpolationsmethode
1) Einrechnen des automatisch berechneten Polynoms aus den Stützstellen (s.u.).
2) Einrechnen des manuell eingegeben Polynoms (s.u.).
3) Lineare Interpolation zwischen den Stützstellen.
c) Gain (Verstärkung) und danach Offset (Nullpunkt),
d) Ggf. Begrenzung (s.u.).
e) Ausgabe skalierte Größe

Bei analogen Eingängen ist die Eingangsgröße i.d.R. die Spannung am Wandlereingang, die skalierte Größe (Ausgangsgröße) z.B. ein Druck oder eine Temperatur usw.
Bei analogen Ausgängen ist die Eingangsgröße z.B. ein Massenstrom, ein Druck usw.; die Ausgangsgröße ist dann eine Spannung am Digital-Analog-Wandler.

### 2.7.1 Allg. Bedienelemente

Element | Funktion
< F2 > | Löscht eine Zeile in der Stützstellentabelle
< F3 > | Fügt eine neue Zeile vor der aktiven Zeile ein
< F4 > | Fügt eine neue Zeile nach der aktiven Zeile ein
< F5 > | Speichern aller Parameterseiten
< F12 > | Zurück ins Diagnosemenü
Allgemeines | Parameterseite für allgemeine Einstellungen
Kenndaten | Parameterseite für phys. Größen und Gain-/Offset
Stützstellen | Stützstellentabelle

Klimaprüfstand | Seite 41
Beschreibung Software | V1.00

### 2.7.2 Allgemeines

Im ersten Teilmenü können allgemeine Daten eingestellt/eingesehen werden:

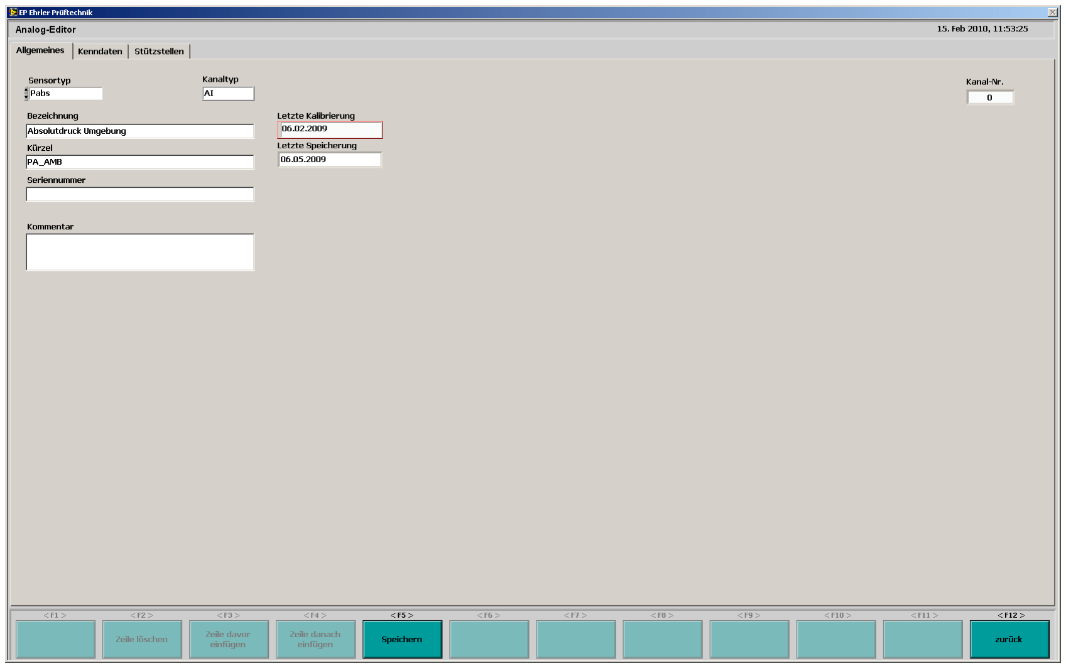
[picture p99: figure]

Maske Editor (Register: Allgemeines)

PARAMETER | BESCHREIBUNG
Sensortyp | Auswahlfeld für die Art des Sensors, bei AO-Kanälen undefiniert
Kanaltyp | AI (für Analogeingänge) oder AO (für Analogausgänge)
Kanal-Nr. | Physikalischer Messkanal; nur Anzeige
Bezeichnung | Bezeichnung (in Langform) des Kanals. Wird auch später in einigen Menüs angezeigt
Kürzel | Kürzel für den Kanal, wie PDLFE, PALFE o.ä.. Wird auch später in einigen Menüs angezeigt
Seriennummer | Seriennummer des Sensors
Kommentar | Eingabemöglichkeit eines beliebigen Kommentars
Letzte Kalibrierung | Datum der letzten Kalibrierung. Muss vom Bediener selbst eingegeben werden.
Letzte Speicherung | Datum der letzten Speicherung. Der Wert dieses Feldes wird vom System automatisch gesetzt und kann nur gelesen werden

Klimaprüfstand | Seite 42
Beschreibung Software | V1.00

### 2.7.3 Kenndaten

Teilmenü für die Eingabe der Kenndaten des Skalierers (ohne Stützstellen)

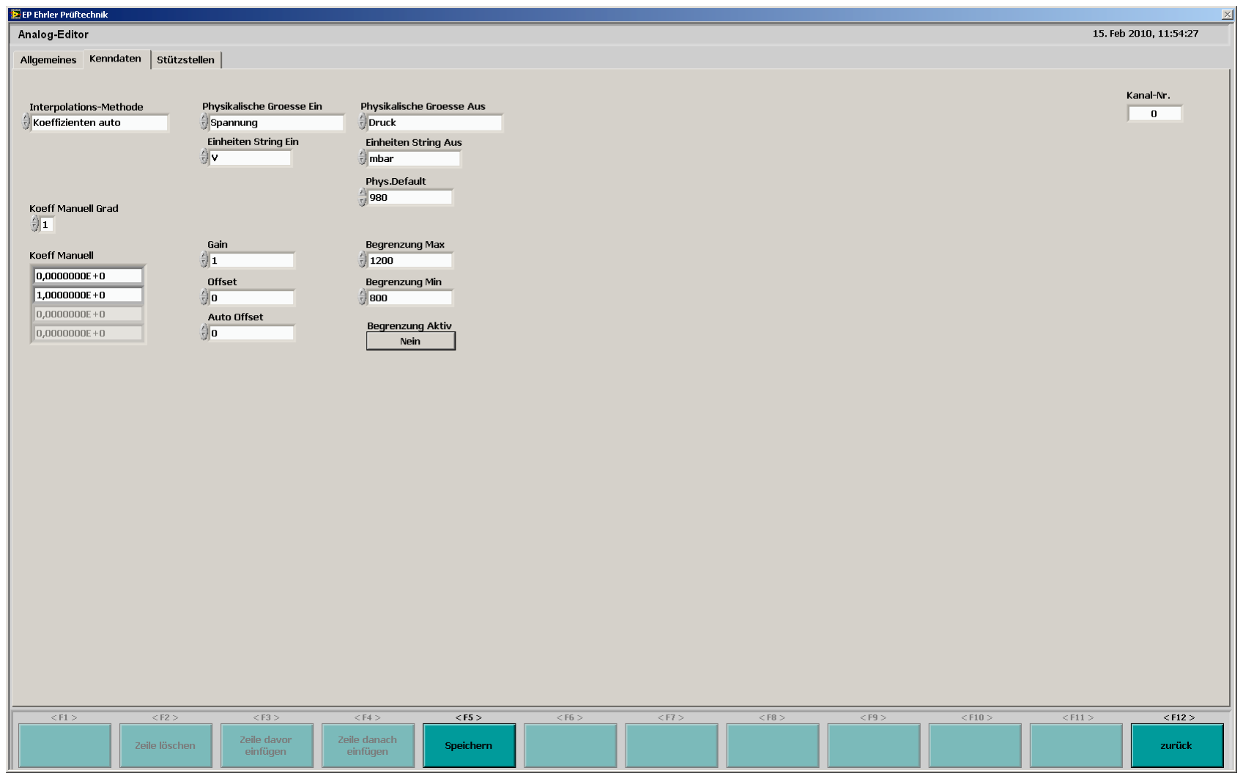
[picture p100: figure]

Maske Editor (Register: Kenndaten)

PARAMETER | BESCHREIBUNG
Interpolations-Methode | Wahl der Interpolationsmethode. Es gibt drei Möglichkeiten: 1) Koeffizienten auto: Verwendung der Stützstellen und dem daraus er-rechneten Polynom (siehe nächstes Teilmenü) 2) Koeffizienten manuell: Verwendung des manuellen Polynoms (auf diesem Teilmenü links unten) 3) linear interpoliert: Verwendung der Stützstellen (siehe nächstes Teil-menü), zwischen den Stützstellen wird linear interpoliert. Ausserhalb der ersten bzw. letzten Stützstelle wird der Ausgangwert auf den Wert der ersten bzw. letzten Stützstelle begrenzt.
Physikalische Größe Ein | Die physikalische Eingangsgrösse des Skalierers. Bei Analogeingangs-kanälen ist in aller Regel SPANNUNG einzustellen.
Einheiten String Ein | Hier kann die Einheit für die physikalische Eingangsgrösse eingestellt werden. Die Auswahlwerte werden vom System anhand der gewählten physikalischen Grösse eingestellt.
Phyisklaische Größe Aus | Die physikalische Ausgangsgrösse des Skalierers. Bsp. bei Differenz-druck oder Absolutdruck ist hier DRUCK einzustellen.
Einheiten String Aus | Hier kann die Einheit für die physikalischen Ausgangsgröße eingestellt werden. Die Auswahlwerte werden vom System anhand der gewählten physikalischen Größe eingestellt .

Klimaprüfstand | Seite 43
Beschreibung Software | V1.00
Gain | Gain (extra Spreizung) des gewählten Kanals. Wird nach der Interpolati-on eingerechnet
Offset | Offset (extra Versatz) des gewählten Kanals. Wird nach der Interpolation verwendet, direkt nach Gain eingerechnet. Der Wert ist in der oben ein-gestellten Einheit (Einheiten String Aus) einzugeben.
AutoOffset | Wird von der Autozero-Funktion verwendet und wird wie „Offset“ ver-rechnet. Durch Nullsetzen des „AutoOffset“ wird die durch Autozero vor-genommene Offsetkorrektur aufgehoben.
Begrenzung Max | Obere Begrenzung des Ausgangswertes des Skalierers. Der Wert ist in der oben eingestellten Einheit (Einheiten String Aus) einzugeben.
Begrenzung Min | Untere Begrenzung des Ausgangswert des Skalierers. Der Wert ist in der oben eingestellten Einheit (Einheiten String Aus) einzugeben.
Begrenzung Aktiv | Gibt an, ob die Begrenzung des Ausgangswert des Skalierers aktiv sein soll.
Koeff Manuell Grad | Grad des Koeffizientenpolynoms (nur bei Verwendung des Interpolati-onsmethode „Koeffizienten manuell“).
Koeff Manuell | Die Koeffizienten des manuellen Polynoms (nur bei Verwendung des Interpolationsmethode „Koeffizienten manuell“)

Klimaprüfstand | Seite 44
Beschreibung Software | V1.00

### 2.7.4 Stützstellen

Teilmenü für die Eingabe der Stützstellen des Skalierers:

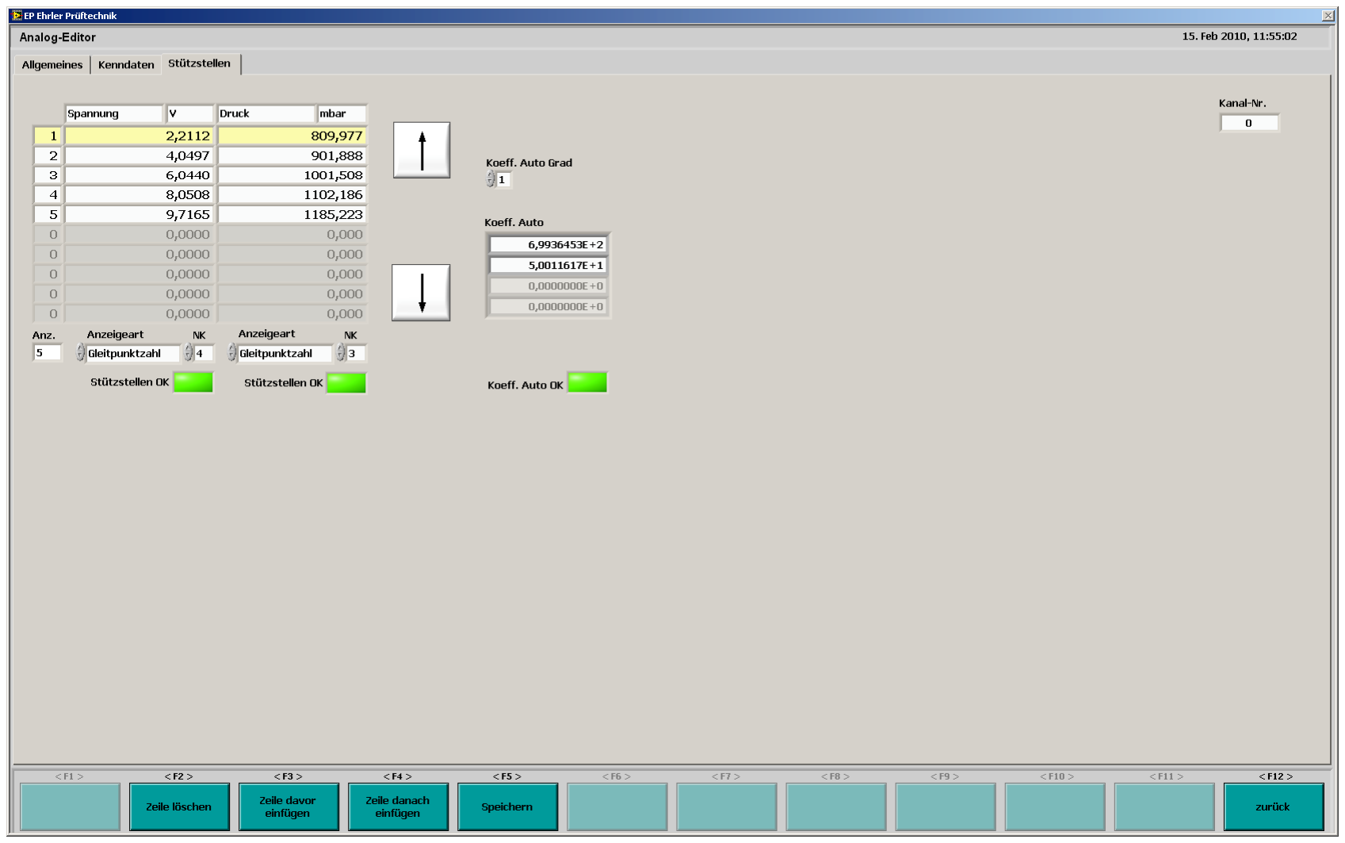
[picture p101: figure]

Maske Editor (Register: Stützstellen)

Hier können die Kenndaten bei Verwendung einer Interpolationsart mit Stützstellen eingegeben werden.

Links ist die Tabelle mit den Werten für die Stützstellen angeordnet (max 40 Stützstellen). Rechts sind die berechneten Polynomkoeffizienten angegeben

PARAMETER | BESCHREIBUNG
Tabelle Überschrift (linke Hälfte) | Physikalische Art und Einheit der Eingangsgröße des Skalierers.
Tabelle Überschrift (rechte Hälfte) | Physikalische Art und Einheit der Ausgangsgröße des Skalierers.
Tabellen Spalte (linke Hälfte) | Eingabewerte für die Eingangsgröße.
Tabellen Spalte (rechte Hälfte) | Eingabewerte für die Ausgangsgröße

Klimaprüfstand | Seite 45
Beschreibung Software | V1.00
Anzeigeart | Art der Darstellung der Werte der Ein- bzw. Ausgangsgröße. Wertebereich: Gleitpunktzahl (z.B: 12.345) Scientific: (z.B: 1,2345E+1) Engineering (z.B. 12,345E+0) (also in Dreierschritten im Exponent)
NK | Nachkommastellen für die Werte der Ein- bzw. Ausgangsgröße
Stützstellen OK (linke Hälfte) | Reines Anzeigefeld. Zeigt an, ob die Werte für die Eingangsgröße gültig sind. Die Liste der Werte für die Eingangsgröße muss streng stetig stei-gend sein (Grün: OK, Rot: Fehler).
Stützstellen OK (rechte Hälfte) | Reines Anzeigefeld. Zeigt an, ob die Werte für die Ausgangsgröße gültig sind. Die Liste der Werte für die Ausgangsgröße muss streng stetig stei-gend oder streng stetig fallend sein (Grün: OK, Rot: Fehler).
Feld Pfeil oben | Weiter oben stehende Tabellenwerte ansehen (wenn mehr als 10)
Feld Pfeil unten | Weiter unten stehende Tabellenwerte ansehen (wenn mehr als 10).
Koeff.Auto Grad | Eingabefeld Grad des Polynoms bei Interpolationsart „Koeffizienten auto“
Koeff. Auto | Die berechneten Koeffizienten aus der Stützstellentabelle und der Anga-be des Polynomgrades unter Verwendung der Methode der Abweichung der kleinsten Quadrate.
Koeff. Auto OK | Feld, das anzeigt, ob alle Eingabewerte OK sind, d.h. die Werte der bei-den Spalten der Stützstellen-Tabelle gültig sind und die Polynomrech-nung erfolgreich war.

Achtung: Änderung der Kalibrierdaten sollten nur mit äußerster Vorsicht vorgenommen werden, zudem sind diese mit Ehrler Prüftechnik abzustimmen. Änderungen können zu falschen Meßwerten führen!

Sensoren müssen regelmäßig überprüft werden

Klimaprüfstand | Seite 46
Beschreibung Software | V1.00

### 2.8 Editor, Venturi

In diesem Menü können die Kenndaten der Venturielemente eingegeben werden.

### 2.8.1 Allg. Bedienelemente

Element | Funktion
< F5 > | Speichern aller Parameterseiten
< F12 > | Zurück ins Diagnosemenü
Allgemein | Parameterseite für allgemeine Einstellungen
Kenndaten | Parameterseite für Kalibrierdaten
Sensorzuordnung | Parameterseite zur Definition der verwendeten Sensoren

### 2.8.2 Allgemeines

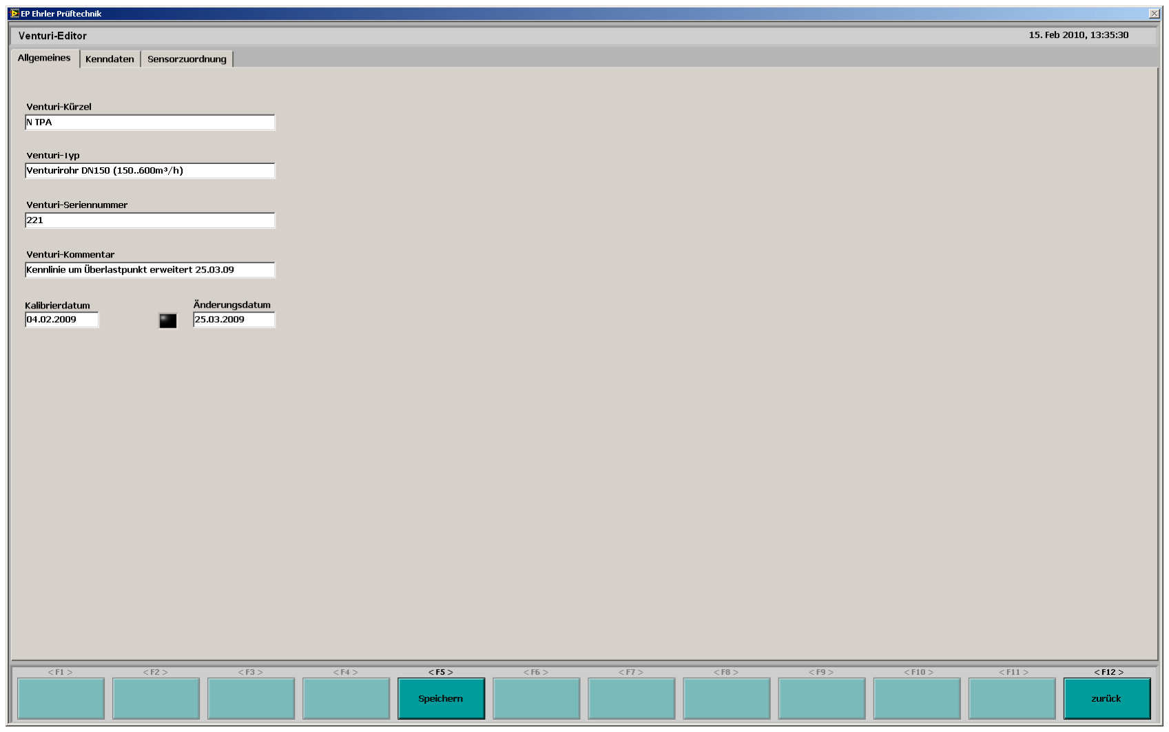
[picture p102: figure]

Maske Venturi-Editor (Register: Allgemeines)

PARAMETER | BESCHREIBUNG
Venturi-Kürzel | Texteingabefeld, Kürzel der Düse
Venturi-Typ | Texteingabefeld, Typ der Düse
Venturi-Seriennummer | Texteingabefeld, Seriennummer der Düse
Ventuir-Kommentar | Texteingabefeld, allgemeinesKommentarfeld.
Kalibrierdatum | Texteingabefeld, Datum der Kalibrierung
Änderungsdatum | Reines Anzeigefeld: Datum der letzten Speicherung

Klimaprüfstand | Seite 47
Beschreibung Software | V1.00

### 2.8.3 Kenndaten

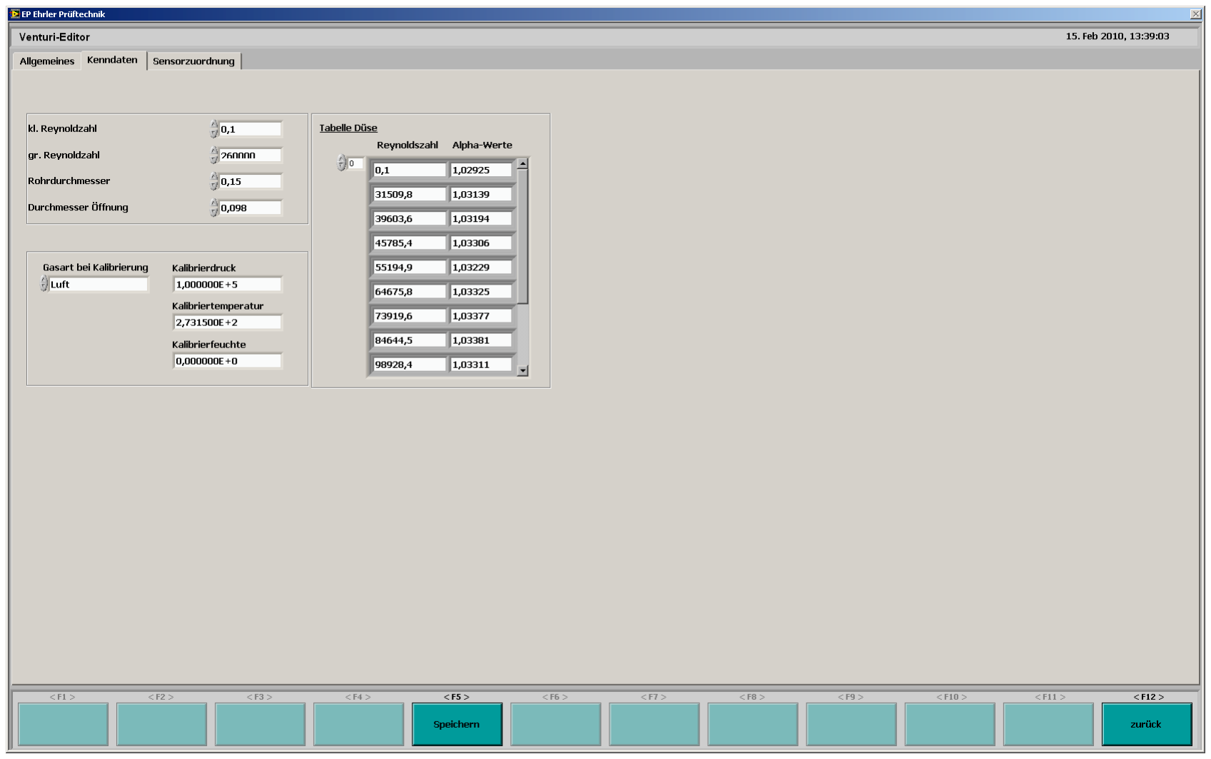
[picture p103: figure]

Maske Venturi-Editor (Register: Kenndaten)

PARAMETER | BESCHREIBUNG
Kl. Reynoldszahl | Anzeige der kleinsten Reynoldszahl (wird beim Speichenr automa-tisch gesetzt)
Gr. Reynoldszahl | Anzeige der größten Reynoldszahl (wird beim Speichenr automa-tisch gesetzt)
Rohrdruchmesser | Durchmesser des Rohres in [m]
Durchmesser Öffnung | Innendurchmesser des Venturielements in [m]
Gasart bei Kalibrierung | Gasart mit der die Kalibrierung durchgeführt wurde
Kalibrierdruck [Pa] | Druck mit der die Düse kalibriert wurde [Pa]
Kalibriertemperatur [K] | Temperatur mit der die Düse kalibriert wurde [K]
Kalibrierfeuchte [0..1] | Feuchte bei der die Kalibrierung durchgeführt wurde [0..1]
Tabelle Düse | Tabelle der Reynoldszahlen und der dazugehörigen Alpha-Werte

Klimaprüfstand | Seite 48
Beschreibung Software | V1.00

### 2.8.4 Sensorzuordnung

Im Menü Sensorzuordnung wird definiert, welche Sensoren die Eingangsdaten für die Venturiberechnung liefern.

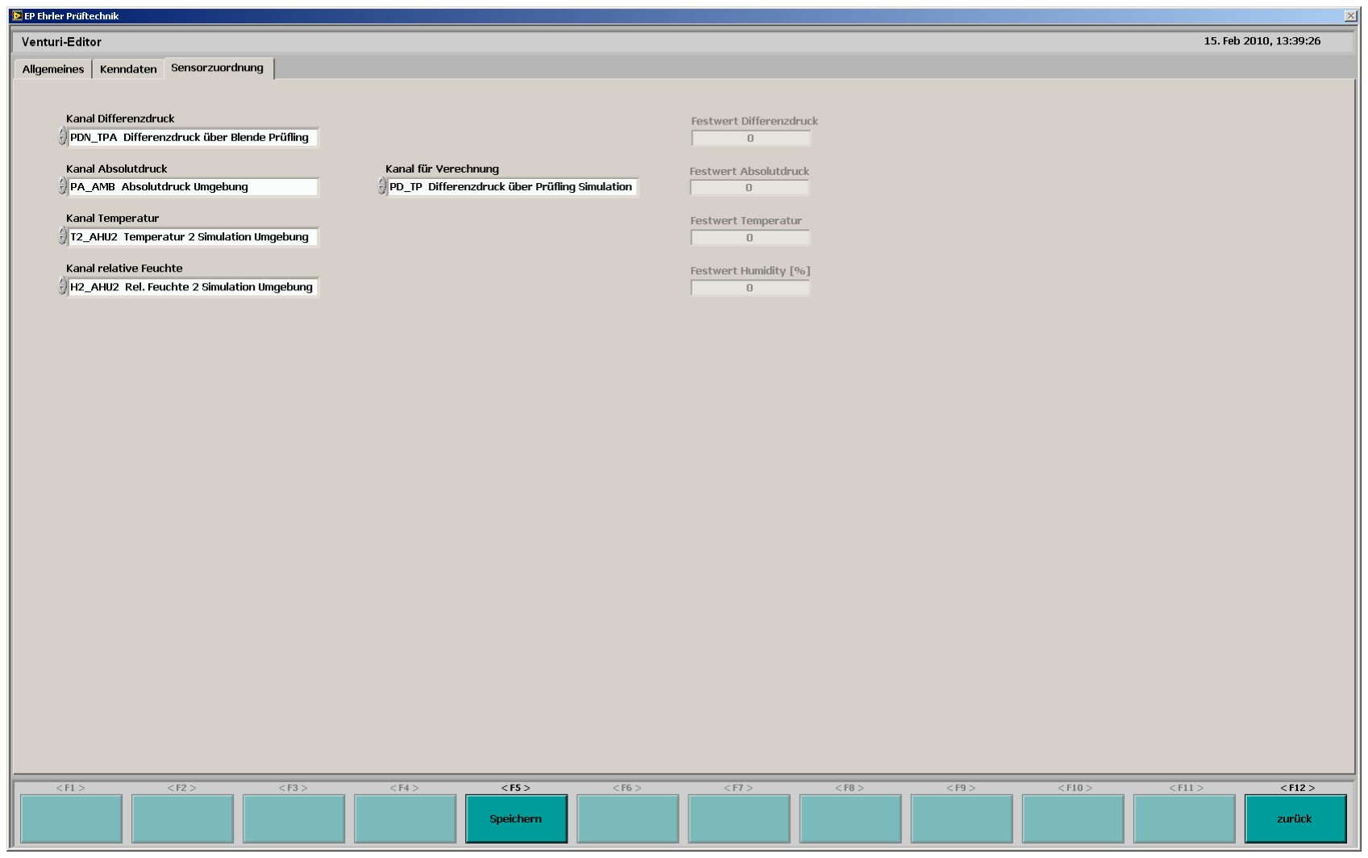
[picture p104: figure]

Maske Venturi-Editor (Register: Sensorzuordnung)

PARAMETER | BESCHREIBUNG
Kanal Differenzdruck | Auswahl Messkanal für Differenzdruck über dem Element
Kanal Absolutdruck | Auswahl Messkanal für Absolutdruck am Eingang des Elements
Kanal für Verrechnung | Auswahl Messkanal für Verrechnung mit dem Absolutdruck; der hier angegebene Kanal wird zum Absolutdruckkanal addiert.
Kanal Temperatur | Auswahl Messkanal für Temperatur am Eingang des Elements
Kanal relative Feuchte | Auswahl Messkanal für rel. Feuchte am Eingang des Elements. Siehe hierzu auch Feuchterechnung Ä 3.2
Festwert ... | Eingabemöglichkeit für feste Werte eines Kanals, wenn die ent-sprechende Kanalauswahl auf „Festwert“ eingestellt wurde.

Achtung: Änderung der Kalibrierdaten sollten nur mit äußerster Vorsicht vorgenommen werden, zudem sind diese mit Ehrler Prüftechnik abzustimmen. Änderungen können zu falschen Meßwerten führen!

Klimaprüfstand | Seite 49
Beschreibung Software | V1.00

## 3 Weitere Funktionen

### 3.1 Fernsteuerung

De Prüfstand verfügt über eine Fernabfrage und -steuerung über die Ethernet-Schnittstelle. Sobald die Software gestartet ist, wird auf eine eingehende TCP-Verbindung auf Port 6342 gewartet. Der Prüfstand arbeitet somit als Server.
Nach erfolgreichem Verbindungsaufbau können über diese Verbindung zunächst alle Messdaten und digitalen Stati abgefragt werden (Fernabfrage). Dies ist unabhängig von der aktuell angezeigten Oberflächenmaske.
Ist die Messmaske aktiv und die Fernsteuerung mit dem Button F5 aktiviert, ist auch die Fernsteuerung möglich. Hierbei können Sollwerte gesetzt, Reglerzustände und digitale Signale geändert werden. Der Funktionsumfang entspricht den Bedienmöglichkeiten, die auch auf der Messmaske zur Verfügung stehen.
Für die Client-Seite stehen Interfacefunktionen in Labview zur Verfügung. Diese sowie der Befehlssatz für die Fernsteuerung sind in einer separaten Anleitung beschrieben (YYYY-MM-TT_xyz_Beschreibung_der_TCP-Schnittstelle.pdf).
Der Zustand der TCP-Verbindung wird in der Hauptmaske und der Messmaske in einem Statusfeld angezeigt. Unerwartete Verbindungsabbrüche werden mit einem Fehlercode im Logfile (s.u.) dokumentiert sowie einem Popup-Fenster kurz angezeigt. Danach wird wieder auf eine neue Verbindung gewartet.

### 3.2 Feuchteberechnung

Die Ermittlung und Berechnung der relativen und absoluten Feuchten im System ist relativ aufwändig. An jeder Feuchtemessstelle ist ein Sensor für relative Feuchte (Ñ) vorgesehen, zusätzlich ein Temperatursensor (TR) im Rohr. Die Berechnung der absoluten Feuchte (x) aus diesen Messwerten hat sich jedoch als zu ungenau herausgestellt, da die Temperaturverteilung in den Rohrleitungen mit großer Nennweite zu ungleichmäßig ist. Daher wurden zusätzliche Messkanäle für die Erfassung der in den Feuchtesensoren integrierten Temperatursensoren (TÑ) nachgerüstet.
Dann berechnet sich die absolute Feuchte zu
x = f Ñ x (ÑÜá TÑ, P ).
Das Ergebnis wird in der Software als virtueller Messkanal behandelt.
Aus der absoluten Feuchte x wird dann die relative Feuchte im Rohr (ÑR ) zurückgerechnet zu
ÑR = f x Ñ (xÜâ TR, P ).
Das Ergebnis wird ebenfalls als virtueller Messkanal behandelt.
Die Umrechnungsfunktionen f Ñ x und f x Ñ wurden gemäß Kundenwunsch nach den Formeln der IAWPS¹
von 2008 implementiert.

Alle relativen Feuchtewerte in der Messmaske geben daher die zurückgerechneten relativen Feuchten ÑR an !

1
International Association for the Properties of Water and Steam

| Klimaprüfstand | Seite 50
Beschreibung Software | V1.00

Bei der Sensordefinition der Venturi-Messelemente werden für den Feuchtekanal die Kanäle der relativen Feuchtesensoren (Ñ) angegeben. Die Berechnung des Durchflusses verwendet jedoch automatisch die zugeordneten virtuellen Kanäle (ÑR).

Tabelle der Zuordnungen:

Eingangskanäle | Absoluter Feuchtekanal | Relativer Feuchtekanal
Feuchte Umgebung H_AMB
AI02 | H_AMB | Rel. Feuchte Umgebung | VC03 | H_AMB_ABS | VC10 | H_AMB_REL
AI32 | T_HAMB | T-Sensor im Feuchtesensor
AI00 | PA_AMP | Absolutdruck Umgebung
AI01 | T_AMB | Temperatur Umgebung

Feuchte 1 Simulation Gebäude H1_AHU1
AI04 | H1_AHU1 | Rel. Feuchte 1 Sim. Gebäude | VC04 | H1_AHU1_ABS | VC11 | H1_AHU1_REL
AI33 | T_H1_AHU1 | T-Sensor im Feuchtesensor
AI00 | PA_AMP | Absolutdruck Umgebung
AI03 | T1_AHU1 | Temperatur 1 Sim. Gebäude

Feuchte 1 Simulation Umgebung H1_AHU2
AI06 | H1_AHU2 | Rel. Feuchte 1 Sim. Umgebung | VC05 | H1_AHU2_ABS | VC12 | H1_AHU2_REL
AI34 | T_H1_AHU2 | T-Sensor im Feuchtesensor
AI00 | PA_AMP | Absolutdruck Umgebung
AI07 | T1_AHU2 | Temperatur 1 Sim. Umgebung

Feuchte 2 Simulation Umgebung H2_AHU2
AI09 | H2_AHU2 | Rel. Feuchte 2 Sim. Umgebung | VC06 | H2_AHU2_ABS | VC13 | H2_AHU2_REL
AI35 | T_H2_AHU2 | T-Sensor im Feuchtesensor
AI00 | PA_AMP | Absolutdruck Umgebung | +
AI12 | PD_TP | Differenzdruck über Prüfling
AI08 | T2_AHU2 | Temperatur 2 Sim. Umgebung

Feuchte nach Prüfling B H_TPB1
AI14 | H_TPB1 | Rel. Feuchte nach Prüfling B | VC07 | H_TPB1_ABS | VC14 | H_TPB1_REL
AI36 | T_H_TPB1 | T-Sensor im Feuchtesensor
AI00 | PA_AMP | Absolutdruck Umgebung
AI15 | T_TPB1 | Temperatur nach Prüfling B

Feuchte nach Prüfling A H_TPA1
AI17 | H_TPA1 | Rel. Feuchte nach Prüfling A | VC08 | H_TPA1_ABS | VC15 | H_TPA1_REL
AI37 | T_H_TPA1 | T-Sensor im Feuchtesensor
AI00 | PA_AMP | Absolutdruck Umgebung
AI18 | T_TPA1 | Temperatur nach Prüfling A

Feuchte nach Prüfling A Abluft H_TPA2
AI19 | H_TPA2 | Rel. Feuchte nach Prüfling A | VC09 | H_TPA2_ABS | VC16 | H_TPA2_REL
AI38 | T_H_TPA2 | T-Sensor im Feuchtesensor
AI00 | PA_AMP | Absolutdruck Umgebung
AI20 | T_TPA2 | Temperatur nach Prüfling A

Klimaprüfstand | Seite 51
Beschreibung Software | V1.00

### 3.3 Log-Datei

In der Datei P5507.log werden alle wichtigen Punkte protokolliert:
Å | Start und Ende der Software
Å | Alle Fehlermeldungen
Diese Datei befindet sich im Verzeichnis der EXE-Datei.
Datum | Zeit | Benutzer | Fehler | Text
20.04.2009 | 14:34:32 | progstart | XXXX | Start Programm
20.04.2009 | 14:34:36 | autologin | 6686 | Fehler Eingänge Analog ### CH 22 IST_31A1 (-0,01%)
20.04.2009 | 14:35:31 | autologin | XXXX | Ende Programm
20.04.2009 | 14:39:13 | progstart | XXXX | Start Programm
20.04.2009 | 14:40:46 | autologin | XXXX | Ende Programm
20.04.2009 | 14:41:31 | progstart | XXXX | Start Programm
20.04.2009 | 14:45:03 | autologin | 9059 | Fehler Autozero, Offset zu groß ### (8,96 hPa)
20.04.2009 | 15:08:48 | autologin | XXXX | Ende Programm
Beispielauszug aus Logdatei

### 3.4 Konfigurationsdateien

-- Nur zur Information --
Achtung: Unsachgemäße Änderungen an diesen Dateien können falsche Messwerte oder Funktionsstörungen verursachen.
Wir empfehlen die Änderung von Konfigurationsdaten ausschließlich über die entsprechenden Menüs der Software vorzunehmen.
Zudem empfiehlt sich die Sicherung aller unten aufgeführten Dateien vor Änderungen an den Konfigurationsdaten, vor einer Kalibrierung sowie vor einem Software-Update !
Datei | Verzeichnis | Bedeutung
P5507.ini | EXE-Verzeichnis | Grundlegende Programmeinstellungen, Änderungen hier nur durch EP !
Deutsch.lag | EXE-Verzeichnis | Sprachdatei deutsch
Englisch.lag | EXE-Verzeichnis | Sprachdatei englisch *)
GER.jpg, UK.jpg | EXE-Verzeichnis | Grafikdateien für Sprachumschaltung *)
Config.ini | Config-Verzeichnis | Systemparameter Ä können teilw. über die Maske Konfiguration geändert wer-den.
Passwort.dat | Config-Verzeichnis | Speichert Benutzer und Passwörter (verschlüsselt)
AI.dat | Config-Verzeichnis | Kalibrierdaten der analogen Eingänge der NI-Karte(n) Ä können über die Maske Diagnose / Kalibrierung AI verändert werden
AO.dat | Config-Verzeichnis | Kalibrierdaten der analogen Ausgänge der NI-Karte(n) Ä können über die Maske Diagnose / Kalibrierung AO verändert werden
AO VIPA.dat | Config-Verzeichnis | Kalibrierdaten der analogen Ausgänge der VIPA-Module Ä können über die Maske Diagnose / Kalibrierung AO verändert werden
Venturi.dat | Config-Verzeichnis | Kalibrierdaten der Venturielemente Ä können über die Maske Diagnose / Düse-neditor verändert werden
Regler.dat | Config-Verzeichnis | Parametetrieung der Regler Ä können über die Maske Diagnose / Regler verändert werden

*) diese Dateien müssen vorhanden sein, auch wenn keine Sprachumschaltung installiert ist !

Klimaprüfstand | Seite 52
Beschreibung Software | V1.00

## 4 Fehlermeldungen

Auftretende Fehler werden normalerweise im Klartext gemeldet.
Auf der Oberfläche der Software erscheint aber nur der „oberste“ Fehler in einer Fehlerkette. Zur Ansicht eventueller vorgelagerter Fehler muss der Fehler zunächst quittiert werden, dann kam im Logfile nachgesehen werden.

### 4.1 Fehlergruppen

FEHLER-NR | FEHLERMELDUNG
5000 .. 8999 | Fehler in der Bibliothek
9000 .. 9999 | Anwendungsfehler
< 0 | Fehler aus der Labview-Runtimeumgebung

### 4.2 Fehlerursachen

Anwendungsfehler sind meist Timeouts durch nicht funktionierende Schaltelemente wie Klappen o.ä.
Bibliotheksfehler werden meist durch Hardwareprobleme der Meßtechnik verursacht oder von Fehlern in den Konfigurationsdateien.
Runtimefehler können gelegentlich durch PC-Probleme oder als Folge unvollständig abgefangener Fehlermöglichkeiten auftreten.
Ist nach der Quittierung eines Fehlers dieser immer noch vorhanden, kann mit Hilfe der Diagnosemasken der Fehler oft weiter eingegrenzt werden.
Gegebenenfalls kann auch EP Hilfestellung bei der Fehlerbehebung geben; in diesem Fall bitte vor einer Anfrage an EP die Logdatei sowie alle Konfigurationsdateien sicheren und für den Versand per E-Mail vorbereiten.
