mho-jwi/MA/MA_safe/Vorlage_Latex_dt/build/physikalische Grundlagen.pdf

BA 007

# Bachelorarbeit

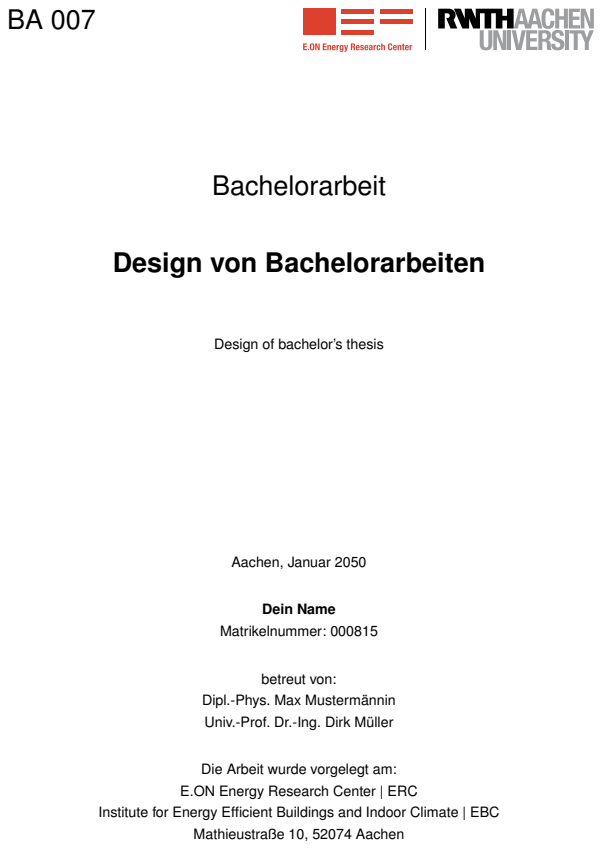
[picture p105: page 1]
Aachen, Januar 2050; Dein Name; Matrikelnummer: 000815; betreut von:; Mathieustraße 10, 52074 Aachen

Design von Bachelorarbeiten

Design of bachelor’s thesis

Dipl.-Phys. Max Mustermännin
Univ.-Prof. Dr.-Ing. Dirk Müller

Die Arbeit wurde vorgelegt am:
E.ON Energy Research Center | ERC

Institute for Energy Efficient Buildings and Indoor Climate | EBC

Kurzfassung

Überall dieselbe alte Leier. Das Layout ist fertig, der Text lässt auf sich warten. Damit das Layout nun

nicht nackt im Raume steht und sich klein und leer vorkommt, springe ich ein: der Blindtext. Genau zu diesem Zwecke erschaffen, immer im Schatten meines großen Bruders »Lorem Ipsum«, freue ich mich jedes Mal, wenn Sie ein paar Zeilen lesen. Denn esse est percipi - Sein ist wahrgenommen werden.

Und weil Sie nun schon die Güte haben, mich ein paar weitere Sätze lang zu begleiten, möchte ich diese Gelegenheit nutzen, Ihnen nicht nur als Lückenfüller zu dienen, sondern auf etwas hinzuweisen, das es ebenso verdient wahrgenommen zu werden: Webstandards nämlich. Sehen Sie, Webstandards sind das Regelwerk, auf dem Webseiten aufbauen. So gibt es Regeln für HTML, CSS, JavaScript oder auch XML; Worte, die Sie vielleicht schon einmal von Ihrem Entwickler gehört haben. Diese Standards sorgen dafür, dass alle Beteiligten aus einer Webseite den größten Nutzen ziehen.Testtest

Im Gegensatz zu früheren Webseiten müssen wir zum Beispiel nicht mehr zwei verschiedene Webseiten für den Internet Explorer und einen anderen Browser programmieren. Es reicht eine Seite, die - richtig angelegt - sowohl auf verschiedenen Browsern im Netz funktioniert, aber ebenso gut für den Ausdruck oder die Darstellung auf einem Handy geeignet ist. Wohlgemerkt: Eine Seite für alle Formate. Was für eine Erleichterung. Standards sparen Zeit bei den Entwicklungskosten und sorgen dafür, dass sich Webseiten später leichter pflegen lassen. Natürlich nur dann, wenn sich alle an diese Standards halten. Das gilt für Browser wie Firefox, Opera, Safari und den Internet Explorer ebenso wie für die Darstellung in Handys. Und was können Sie für Standards tun? Fordern Sie von Ihren Designern und Programmieren einfach standardkonforme Webseiten. Ihr Budget wird es Ihnen auf Dauer danken. Ebenso möchte ich Ihnen dafür danken, dass Sie mich bin zum Ende gelesen

Diese Kurzzusammenfassung hat 300 Wörter

Abstract

Er hörte leise Schritte hinter sich. Das bedeutete nichts Gutes. Wer würde ihm schon folgen, spät in der Nacht und dazu noch in dieser engen Gasse mitten im übel beleumundeten Hafenviertel? Gerade jetzt, wo er das Ding seines Lebens gedreht hatte und mit der Beute verschwinden wollte! Hatte einer seiner zahllosen Kollegen dieselbe Idee gehabt, ihn beobachtet und abgewartet, um ihn nun um die Früchte seiner Arbeit zu erleichtern? Oder gehörten die Schritte hinter ihm zu einem der unzähligen Gesetzeshüter dieser Stadt, und die stählerne Acht um seine Handgelenke würde gleich zuschnappen? Er konnte die Aufforderung stehen zu bleiben schon hören. Gehetzt sah er sich um. Plötzlich erblickte er den schmalen Durchgang. Blitzartig drehte er sich nach rechts und verschwand zwischen den beiden Gebäuden.

Beinahe wäre er dabei über den umgestürzten Mülleimer gefallen, der mitten im Weg lag. Er versuchte, sich in der Dunkelheit seinen Weg zu ertasten und erstarrte: Anscheinend gab es keinen anderen Ausweg aus diesem kleinen Hof als den Durchgang, durch den er gekommen war. Die Schritte wurden lauter und lauter, er sah eine dunkle Gestalt um die Ecke biegen. Fieberhaft irrten seine Augen durch die nächtliche Dunkelheit und suchten einen Ausweg. War jetzt wirklich alles vorbei, waren alle Mühe und alle Vorbereitungen umsonst? Er presste sich ganz eng an die Wand hinter ihm und hoffte, der Verfolger würde ihn übersehen, als plötzlich neben ihm mit kaum wahrnehmbarem Quietschen eine Tür im nächtlichen Wind hin und her schwang. Könnte dieses der flehentlich herbeigesehnte Ausweg aus seinem Dilemma sein?

Langsam bewegte er sich auf die offene Tür zu, immer dicht an die Mauer gepresst. Würde diese Tür seine Rettung werden? Er hörte leise Schritte hinter sich. Das bedeutete nichts Gutes. Wer würde ihm schon folgen, spät in der Nacht und dazu noch in dieser engen Gasse mitten im übel beleumundeten Hafenviertel? Gerade jetzt, wo er das Ding seines Lebens gedreht hatte und mit der Beute verschwinden wollte! Hatte einer seiner zahllosen Kollegen dieselbe Idee gehabt, ihn beobachtet und abgewartet, um ihn nun um die Früchte seiner Arbeit zu erleichtern? Oder gehörten die Schritte hinter ihm zu einem der unzähligen Gesetzeshüter dieser Stadt, und die stählerne Acht um seine Handgelenke würde gleich zuschnappen? Er konnte die Aufforderung stehen zu bleiben schon hören. Gehetzt sah er sich um. Plötzlich erblickte er den schmalen Durchgang. Blitzartig drehte er sich nach rechts und verschwand zwischen den beiden Gebäuden. Beinahe wäre er dabei über den umgestürzten Mülleimer gefallen, der mitten im Weg lag. Er versuchte, sich in der Dunkelheit seinen Weg zu ertasten und erstarrte: Anscheinend gab es keinen anderen Ausweg aus diesem kleinen Hof als den Durchgang, durch den er gekommen war. Die Schritte wurden lauter und lauter, er sah eine dunkle Gestalt um die Ecke biegen. Fieberhaft irrten seine Augen durch die nächtliche Dunkelheit und suchten einen Ausweg. War jetzt wirklich alles vorbei, waren alle Mühe und alle Vorbereitungen umsonst? Er presste sich ganz eng an die Wand hinter ihm und hoffte, der Verfolger würde ihn übersehen, als plötzlich neben ihm

Dieser Abstract hat 500 Wörter

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

## Nomenklatur

Formelzeichen und Einheiten

Symbol | Bedeutung | Einheit
A | Fläche | m²
cp | spezifische Wärmekapazität bei konstantem Druck | J/(kg·K)
C | Wärmekapazität | W/kg
H | Enthalpie | J
H˙ | Enthalpiestrom | J/s
E | Exergie | J
e | spezifische Exergie | J/kg
m˙ | Massenstrom | kg/s
p | Druck | Pa
Q˙ | Wärmestrom | W
R | spezifische Gaskonstante | J/(kg·K)
S | Entropie | J/K
S˙ | Entropiestrom | W/K
T | Temperatur | K
t | Zeit | s
U | innere Energie | J
UT | Wärmedurchgangskoeffizient | W/(kg·K)
h | Wärmeübergangskoeffizient | W/(m² ·K)
V | Volumen | m³
V˙ | Volumenstrom | m³ /s
W˙ | Leistung | W
Y | Wasserbeladung der Luft | g/kg

v

griechische Formelzeichen

Symbol | Bedeutung | Einheit
ηC | Carnot-Wirkungsgrad | —
Φ | thermische Leistung | W
% | Massendichte | kg/m³
σ | Temperaturspreizung | K
ϑ | Temperatur | ◦C
∆ϑ | Temperaturdifferenz | K

Indizes und Abkürzungen

Symbol | Bedeutung
0 | Referenzzustand (ambient dead state)
A | Außen/Umgebung
CH | chemisch
CV | Kontrollvolumen (control volume)
DSC | Dynamische Differenzkalorimetrie (differential scanning calorimetry)
e | über die Systemgrenze (external)
F | Volumenstrom
FW | Fassadenwärmeübertrager
gen | erzeugt (generated)
In | Eingang (input)
KN | kinetisch
KRM | Kapillarrohrmatte
LabVIEW | Programmiersprache und Entwicklungsumgebung für die Messdatener-
| fassung der Firma National Instruments
L | Luft
LWS | Latentwärmespeicher
m | Mittelwert
Ob | Oberfläche
PCM | Latentwärmespeichermaterial (phase change material)
PH | physikalisch
| Fortsetzung auf der nächsten Seite

Indizes und Abkürzungen

Symbol | Bedeutung
PT | potentiell
Q | auf einen Wärmestrom bezogen
R | Rücklauf
Reg | Speicherregeneration
T | Temperatur
∆ t | Zeitschritt der Länge ∆ t
t | technisch
V | Vorlauf
V | Verlust (Exergieanalyse)
W | Wärmeträgermedium

## Abbildungsverzeichnis

1.1 RWTH-Aachen-Logo | 5

viii

## Tabellenverzeichnis

1.1 Das ist eine Testtabelle | 5

ix

## Vorwort

Lorem ipsum dolor sit amet, consectetuer adipiscing elit, sed diam nonummy nibh euismod tincidunt ut laoreet dolore magna aliquam erat volutpat. Ut wisi enim ad minim veniam, quis nostrud exerci tation ullamcorper suscipit lobortis nisl ut aliquip ex ea commodo consequat. Duis autem vel eum iriure dolor in hendrerit in vulputate velit esse molestie consequat, vel illum dolore eu feugiat nulla facilisis at vero et accumsan et iusto odio dignissim qui blandit praesent luptatum zzril delenit augue duis dolore te feugait nulla facilisi (Tabelle 1.1). Lorem ipsum dolor sit amet, consectetuer adipiscing elit, sed diam nonummy nibh euismod tincidunt ut laoreet dolore magna aliquam erat volutpat.Ut wisi enim ad minim veniam, quis nostrud exerci tation ullamcorper suscipit lobortis nisl ut aliquip ex ea commodo consequat. Duis autem vel eum iriure dolor in hendrerit in vulputate velit esse molestie consequat, vel illum dolore eu feugiat nulla facilisis at vero et accumsan et iusto odio dignissim qui blandit praesent luptatum zzril delenit augue duis dolore te feugait nulla facilisi. Nam liber tempor cum soluta nobis eleifend option congue nihil imperdiet doming id quod mazim placerat facer possim assum. Ut wisi enim ad minim veniam, quis nostrud exerci tation ullamcorper suscipit lobortis nisl ut aliquip ex ea commodo consequat. Duis autem vel eum iriure dolor in hendrerit in vulputate velit esse molestie consequat, vel illum dolore eu feugiat nulla facilisis at vero et accumsan et iusto odio dignissim qui blandit praesent luptatum zzril delenit augue duis dolore te feugait nulla facilisi. Nam liber tempor cum soluta nobis eleifend option congue nihil imperdiet doming id quod mazim placerat facer possim assum.

x

## 1 Teil2

1.1 Modell

1.1.1 Stotransport

## Die im untersuchten Enthalpieübertrager verwendete Membran

## besteht aus einer dichten Grundschicht und einer porösen Stütz-

## schicht. Der Stofftransport lässt sich analog zur Elektrotech-

## nik als eine Kette von in Reihe geschalteten Prozessen darstel-

## len. Eine Übersicht über die in Reihe geschalteten Prozesse gibt

Abbildung??.

## Im ersten Schritt diffundiert der Wasserdampf durch den Luft-

## strom der Feedseite. Dies geschieht auf Grund eines Konzen-

## trationsgradienten. Der Konzentrationsgradient entsteht durch

das Ableiten des Wassermassenstroms durch die Membran.

## In einem zweiten Schritt absorbiert die Membranoberfläche den

Wasserdampf.

## Im dritten Schritt folgt die Diffusion durch die dichte Grund-

schicht der Membran.

## Im vierten Schritt desorbiert das Wasser an der sweepseitigen

Oberfläche der Membran in die Luft.

1

Abbildung 1.1: Transportprozesse

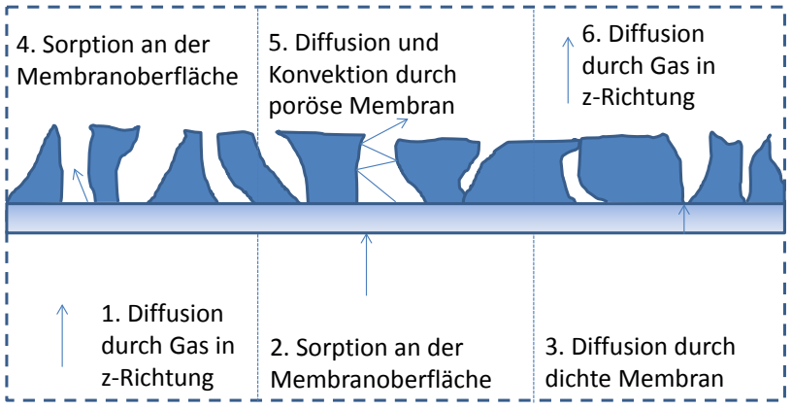
[picture p106: figure]
1. Diffusion durch Gas in z-Richtung; 2. Sorption an der Membranoberfläche; 3. Diffusion durch dichte Membran; 4. Sorption an der Membranoberfläche; 5. Diffusion und Konvektion durch poröse Membran; 6. Diffusion durch Gas in z-Richtung

## In einem fünften Schritt wird der Wasserdampf durch die po-

## röse Membran transportiert und verteilt sich in einem sechs-

## ten Schritt im Sweepstrom. Diese Diffusionsprozesse durch die

## Poren und den Luftstrom werden durch Konzentrationsgradi-

enten verursacht.

## Wie oben beschrieben führt die Betrachtung der 6 Prozessschrit-

## te als Reihenschaltung zu einer zutreffenden Beschreibung des

## Stofftransportes. Dies geschieht analog zur Elektrotechnik. Ent-

## sprechend ergibt sich der Gesamtwiderstand Wg es der Mem-

## bran

Wg es = Wd +Wp | (1.1)

## aus einer Addition der Einzelwiderstände von dichter Membran

Wd und poröser Membran Wp.

## Im Fall von parallel geschalteten Widerständen, zum Beispiel

## beim Auftreten von Poren in der dichten Membran, kann der

## Gesamtwiderstand analog zu

## 1 Wg es

=

1 Wd
+
1 Wp | (1.2)

## gebildet werden. Beispiele hierfür sind das Auftreten von Poren

## in einer dichten Membran oder allgemein das parallele Statt-

finden von konvektiven und diffusiven Stofftransportprozessen.

Sorption an Membranoberäche

## Die Triebkraft des Sorptionsprozesses ist eine Differenz im che-

## mischen Potential. Meist werden hydrophile Membranenma-

## terialien für die dichte Membran eingesetzt. Daher entsteht an

## der Feed-Seite eine höherer Potentialdifferenz. Neben der Af-

## finität des Membranmaterials ist die maximale Aufnahmeka-

## pazität der Membran ausschlaggebend für die Gleichgewichts-

## konzentration des Wassers in der Membranoberfläche. Dieses

## Lösungs-Gleichgewichtsmodell ist insbesondere von Lösungen

## anderer Aggregatzustände bekannt, z.B. von Salzlösungen oder

## Wasser-Luft-Lösungen. Die Beschreibung des Sorptionsprozes-

## ses mit physikalischen Modellen ist schwierig. Daher hat sich

## für die Beschreibung des Sorptionsprozesses ein halbempiri-

## sches Modell durchgesetzt, das sich in den meisten Veröffent-

## lichungen wiederfindet, z.B. in ? oder ?. Demnach stellt sich in

## der Membranoberfläche eine Feuchtebeladung Θ von

Θ =

ωmax
1−c +

c
Φ

(1.3)

## ein. Wobei ωmax die maximal mögliche Feuchte im Membran-

## material angibt, c eine Materialkonstante darstellt, die den Ein-

## fluss der Wasseraffinität der Membran wiederspiegelt, und Φ

die Luftfeuchte im Luftstrom ist.

Diusion durch dichte Membran

## Die Diffusion durch die dichte Membran ist im vorliegenden

## Fall der einflussreichste Prozessschritt auf die Transportgeschwin-

## digkeit. Bei diesem Schritt ist der Widerstand am größten. Die

## Triebkraft ist hier - wie für alle Diffusionsprozesse - das chemi-

sche Potential.

## Unter der Annahme einer homogenen dichten Membran und

## konstanter thermodynamischer Randbedingungen (Druck und

## Temperatur) in der Membran ergibt sich eine lineare Konzen-

## trationsverteilung über die Z-Achse der Membran. In der Li-

## teratur wird der Zusammenhang für den örtlichen Gradienten

## des chemischen Potentials und der übertragenen Stoffmenge

## ebenfalls als linear angenommen.(s.? Entsprechend ist für den

## Stoffmengentransport aus physikalischen Membranmodellen

## die Gleichung

n˙

00 = −cwM ∗bwM ∗

dµwM
d z

(1.4)

## bekannt, wobei n˙

## 00 der Stoffmengenstrom des Wassers über die

## Membran ist und bwM die Beweglichkeit der diffundierenden

## Moleküle angibt. ? Für den Diffusionsmassenstrom Jw ergibt

## sich ein proportionaler Zusammenhang zum Gradienten des

## chemischen Potentials µ

Jw = −Lw ∗

## dµw

d x

(1.5)

,

wobei Lw der Proportionalitätsfaktor ist.

## Das chemische Potential eines Stoffes i ist definiert als Summe

## aus einem druckabhängigen Potentialterm, einem Standard-

## potentialterm und einem konzentrationsabhängigen Potenti-

## alterm zu

## µi(T,p,ci) = µ

◦
i

(T,p

◦

## )+R∗T ∗ln(ai(T,p

◦

## ,ci))+vi∗(p−p

◦
) (1.6)

,

## wobei P

## - der Standarddruck ist, R die ideale Gaskonstante ¹

, ai
die Aktivität des Stoffes i und vi das Molvolumen des Stoffes i.

## Der Druckterm

## vi ∗(p − p

◦
) = 0 | (1.7)

entfällt unter der Voraussetzung einer idealen Gasmischung.

## Der Standardpotentialterm µ

◦
i

(T,p

◦

## ) entfällt unter der Annah-

## me von Isothermie entlang der z-Achse über die Membran. Da

## die dichte Membran sehr dünn ist, ist diese Annahme gerecht-

fertigt.

## Der konzentrationsabhängige Potentialterm hängt im Wesent-

lichen von der Aktivität der diffundierenden Komponente ab.

## Die Aktivität ist für Lösungen als

ai = γi ∗ci | (1.8)

1Gaskonstante = 8.314 J/mol/K

## definiert, wobei γi der Aktivitätskoeffizient der Komponente i

## ist. Der Aktivitätskoeffizient gibt das Verhältnis aus aktivem und

## realem Stoffmengenanteil an. Er nähert sich für kleine Konzen-

## trationen dem Wert Eins. Da eine dichte Membran betrachtet

## wird, ist die Annahme sinnvoll. Die oben beschriebenen An-

## nahmen wurden auch von Zhang und Niu getroffen und mit

experimentellen Ergebnissen validiert ?.

## Aus den Annahmen folgt, dass der konzentrationsabhängige Po-

## tentialterm sich zu

## RT ∗ln(ai(T,p

◦
,ci)) = RT ∗ln(ci) | (1.9)

vereinfacht.

## Unter den getroffenen Annahmen ergibt sich für den Stoffmen-

## gentransport von Wasser durch die Membran die Gleichung

Jw =

−Lw ∗RT
cw

∗

## dcw

d x

(1.10)

## Daher lässt sich unter der Voraussetzung einer linearen Vertei-

## lung von cw über die z-Richtung der Membran ein linearer Zu-

## sammenhang des Stoffmengentransports von der Konzentra-

## tionsdifferenz mit einem Diffusionskoeffizienten Dw beschrei-

## ben. So folgt die Gleichung:

Jw = Dw ∗

cw f m −cw sm
δ

(1.11)

,

## wobei cw f m und cw sm die Stoffmengenkonzentrationen in der

## feedseitigen beziehungsweise in der sweepseitigen Membrano-

berfläche darstellen.

Diusion durch poröse Membran

## Der Stofftransport durch die poröse Membran setzt sich aus ei-

## nem Diffusionsprozess und einem Konvektionsprozess zusam-

## men. Eine Konvektion in x- oder y-Richtung findet auf Grund

## der Porenausrichtung nicht statt. Die Konvektion in z-Richtung

## entsteht durch den Permeatstrom. Die Diffusion ergibt sich auf

Grund des Konzentrationsgradienten.

Stotransport im Luftstrom

## Bei der Beschreibung des Transports der Wassermoleküle durch

## die Gasphase führt die Annahme einer laminaren Luftströmung

in x-Richtung zu einer deutlichen Vereinfachung des Modells.

## Im Fall laminarer Strömung kommt es nicht zum konvektiven

## Stoffaustausch in z-Richtung. Der Transport der Wassermole-

## küle in z-Richtung lässt sich unter dieser Annahme mit Hilfe

## von Diffusionsmodellen beschreiben. Die Betrachtung turbu-

## lenter Stofftransportprozesse ist in der Regel mit aufwendigen

## Strömungssimulationen verbunden. Eine Beschränkung auf la-

## minare Effekte kann somit den Rechenaufwand bei Simulatio-

nen erheblich reduzieren.

## Da die Turbulenz stark von der Geometrie des Strömungska-

## nals und der Strömungsgeschwindigkeit abhängt, ist diese An-

## nahme nicht uneingeschränkt gültig. Insbesondere Spacerma-

## terialien werden bewusst dazu eingesetzt, die Turbulenz in den

## Strömungskanälen zu erhöhen. Eine erhöhte Turbulenz führt

## zu einer Abnahme der Konzentrationsüberhöhung an den Mem-

## branoberflächen und wirkt sich positiv auf die Sorptionsgeschwin-

digkeit an der Membranoberfläche aus.

## Konzentrationsüberhöhungen entstehen durch einen konvek-

## tiven Fluss. Der Permeatfluss durch die Membran zieht auf Grund

## der Kontinuitätsgleichungen einen konvektiven Massenstrom

## in z-Richtung nach sich. Da die Membran selektiv ist, diffun-

## dieren nur einige Stoffe, in diesem Fall die Wassermoleküle durch

## die Membran. Entsprechend nimmt die Konzentration der an-

## deren Stoffe an der Membranoberfläche zu. Der Konzentrati-

## onsgradient des Wassers über die Membran ist daher geringer

## und somit auch die Triebkraft des Stofftransportes. Die Auswir-

## kungen der Konzentrationspolarisation sind aber im hier be-

## trachteten Fall gering, da der Permeatstrom im Vergleich zum

Gesamtmassenstrom gering ist.

1.1.2 Zusammenfassend

## Literaturverzeichnis

[Streblow 2010] STREBLOW, Dr.-Ing. R.: Thermal Sensation and ComfortModel for Inhomogeneous Indoor Environments, RWTH Aachen University, Diss., 2010

11

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

## A Wichtiger Anhang 1

Weit hinten, hinter den Wortbergen, fern der Länder Vokalien und Konsonantien leben die Blindtexte. Abgeschieden wohnen Sie in Buchstabhausen an der Küste des Semantik, eines großen Sprachozeans. Ein kleines Bächlein namens Duden fließt durch ihren Ort und versorgt sie mit den nötigen Regelialien. Es ist ein paradiesmatisches Land, in dem einem gebratene Satzteile in den Mund fliegen. Nicht einmal von der allmächtigen Interpunktion werden die Blindtexte beherrscht – ein geradezu unorthographisches Leben. Eines Tages aber beschloß eine kleine Zeile Blindtext, ihr Name war Lorem Ipsum, hinaus zu gehen in die weite Grammatik. Der große Oxmox riet ihr davon ab, da es dort wimmele von bösen Kommata, wilden Fragezeichen und hinterhältigen Semikoli, doch das Blindtextchen ließ sich nicht beirren.

A.1 Die Versalien

Es packte seine sieben Versalien, schob sich sein Initial in den Gürtel und machte sich auf den Weg. Als es die ersten Hügel des Kursivgebirges erklommen hatte, warf es einen letzten Blick zurück auf die Skyline seiner Heimatstadt Buchstabhausen, die Headline von Alphabetdorf und die Subline seiner eigenen Straße, der Zeilengasse. Wehmütig lief ihm eine rhetorische Frage über die Wange, dann setzte es seinen Weg fort. Unterwegs traf es eine Copy. Die Copy warnte das Blindtextchen, da, wo sie herkäme wäre sie zigmal umgeschrieben worden und alles, was von ihrem Ursprung noch übrig wäre, sei das Wort ündünd das Blindtextchen solle umkehren und wieder in sein eigenes, sicheres Land zurückkehren. Doch alles Gutzureden konnte es nicht überzeugen und so dauerte es nicht lange, bis ihm ein paar heimtückische Werbetexter auflauerten, es mit Longe und Parole betrunken machten und es dann in ihre Agentur schleppten, wo sie es für ihre Projekte wieder und wieder mißbrauchten.

Und wenn es nicht umgeschrieben wurde, dann benutzen Sie es immernoch. Weit hinten, hinter den Wortbergen, fern der Länder Vokalien und Konsonantien leben die Blindtexte. Abgeschieden wohnen Sie in Buchstabhausen an der Küste des Semantik, eines großen Sprachozeans. Ein kleines Bächlein namens Duden fließt durch ihren Ort und versorgt sie mit den nötigen Regelialien. Es ist ein paradiesmatisches Land, in dem einem gebratene Satzteile in den Mund fliegen. Nicht einmal von der allmächtigen Interpunktion werden die Blindtexte beherrscht – ein geradezu unorthographisches Leben. Eines Tages aber beschloß eine kleine Zeile Blindtext, ihr Name war Lorem Ipsum,

13 hinaus zu gehen in die weite Grammatik. Der große Oxmox riet ihr davon ab, da es dort wimmele von bösen Kommata, wilden Fragezeichen und hinterhältigen Semikoli, doch das Blindtextchen ließ sich nicht beirren. Es packte seine sieben Versalien, schob sich sein Initial in den Gürtel und machte sich auf den Weg. Als es die ersten Hügel des Kursivgebirges erklommen hatte, warf es einen letzten Blick zurück auf die Skyline seiner Heimatstadt Buchstabhausen, die Headline von Alphabetdorf und die Subline seiner eigenen Straße, der Zeilengasse. Wehmütig lief ihm eine rhetorische Frage über die Wange, dann setzte es seinen Weg fort. Unterwegs traf es eine Copy. Die Copy warnte das Blindtextchen, da, wo sie herkäme wäre sie zigmal umgeschrieben worden und alles, was von ihrem Ursprung noch übrig wäre, sei das Wort ünd"

## B Ähnlich wichtiger Anhang

Es gibt im Moment in diese Mannschaft, oh, einige Spieler vergessen ihnen Profi was sie sind. Ich lese nicht sehr viele Zeitungen, aber ich habe gehört viele Situationen. Erstens: wir haben nicht offensiv gespielt. Es gibt keine deutsche Mannschaft spielt offensiv und die Name offensiv wie Bayern. Letzte Spiel hatten wir in Platz drei Spitzen: Elber, Jancka und dann Zickler. Wir müssen nicht vergessen Zickler. Zickler ist eine Spitzen mehr, Mehmet eh mehr Basler. Ist klar diese Wörter, ist möglich verstehen, was ich hab gesagt? Danke. Offensiv, offensiv ist wie machen wir in Platz. Zweitens: ich habe erklärt mit diese zwei Spieler: nach Dortmund brauchen vielleicht Halbzeit Pause. Ich habe auch andere Mannschaften gesehen in Europa nach diese Mittwoch. Ich habe gesehen auch zwei Tage die Training. Ein Trainer ist nicht ein Idiot! Ein Trainer sei sehen was passieren in Platz. In diese Spiel es waren zwei, drei diese Spieler waren schwach wie eine Flasche leer! Haben Sie gesehen Mittwoch, welche Mannschaft hat gespielt Mittwoch? Hat gespielt Mehmet oder gespielt Basler oder hat gespielt Trapattoni? Diese Spieler beklagen mehr als sie spielen! Wissen Sie, warum die Italienmannschaften kaufen nicht diese Spieler? Weil wir haben gesehen viele Male solche Spiel! Haben

15

## Eigenständigkeitserklärung

Hiermit versichere ich, dass ich die vorliegende Arbeit selbstständig und ohne Benutzung anderer als der angegebenen Hilfsmittel angefertigt habe. Alle Stellen, die wörtlich oder sinngemäÿ übernommen sind, sind als solche kenntlich gemacht. Die Arbeit ist in gleicher oder ähnlicher Form noch nicht als Prüfungsarbeit eingereicht worden. Ich erkläre mich damit einverstanden, dass die vorliegende Arbeit in der Lehrstuhlbibliothek und Datenbank aufbewahrt und für den internen Gebrauch kopiert werden darf.

Aachen, den 23. Juli 2016

Name hier bitte einfügen
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
