mho-jwi/MA/(B) Klimaprüfstand/Spezifikationen/Prüfstand/P5507_Aufbaulayout-Klimaprüfstand_zur Freigabe.pdf

P5507: Aufbaulayout - Klimaprüfstand 1V00 | Seite 1 von 4

P5507: Aufbaulayout - Klimaprüfstand 1V00 | Seite 2 von 4

P5507: Aufbaulayout - Klimaprüfstand 1V00 | Seite 3 von 4

P5507: Aufbaulayout - Klimaprüfstand 1V00 | Seite 4 von 4
