mho-jwi/MA/(B) Klimaprüfstand/Auslegung/Komponenten/Herstellerdatenblätter/Cherry_Bedienungsanleitung_Tastatur.pdf

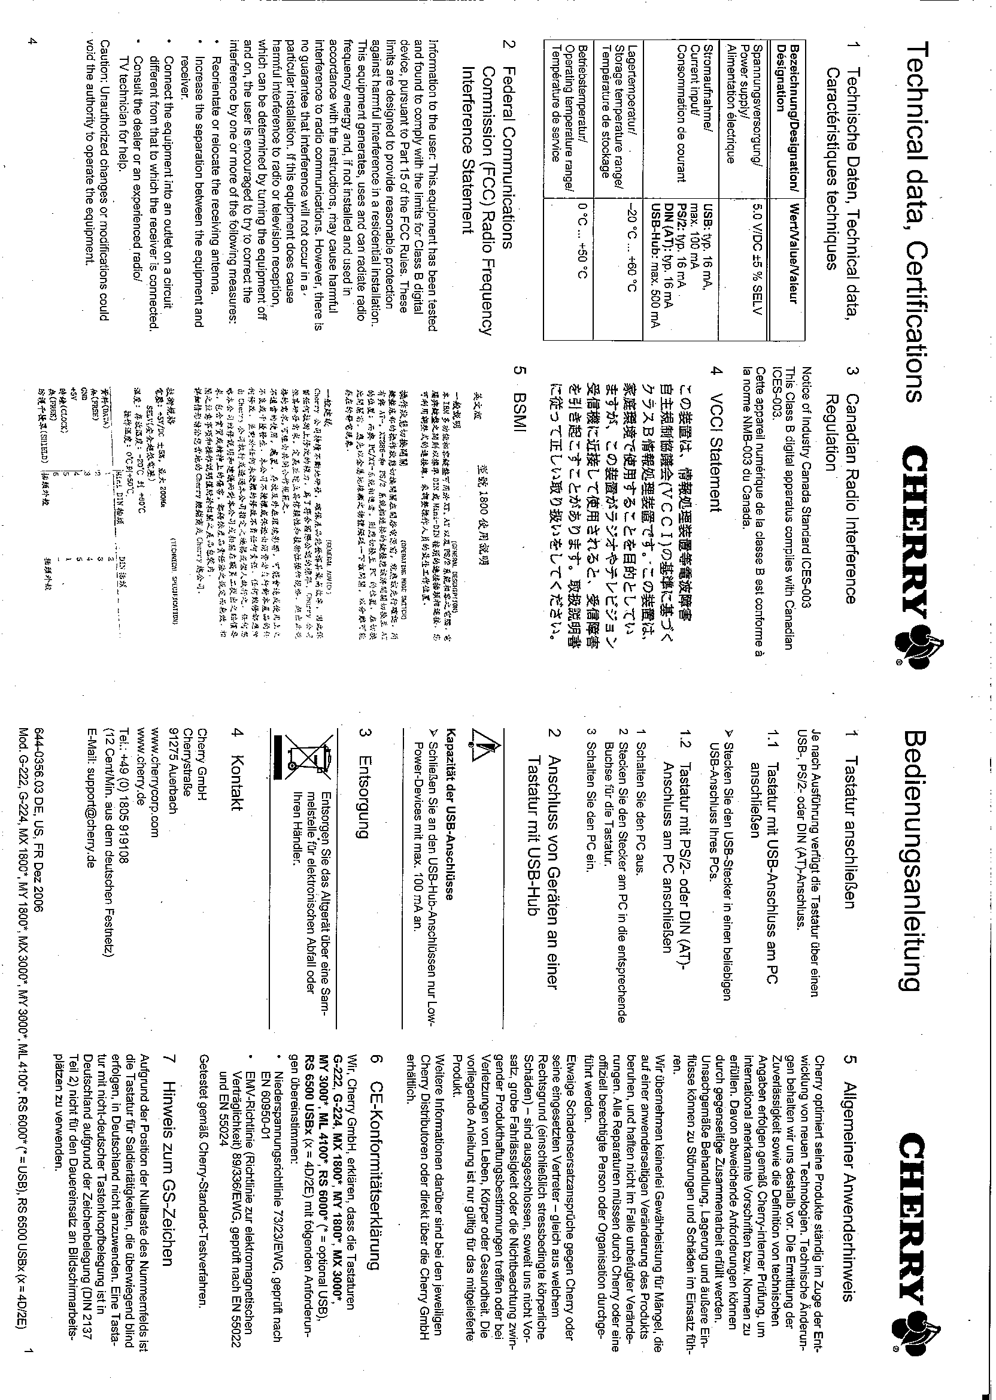
[picture p107: page 1]
