mho-jwi/MA/(B) Klimaprüfstand/Auslegung/Komponenten/Herstellerdatenblätter/Sicherheitsbaugruppe_Gebrauchsanleitung.pdf

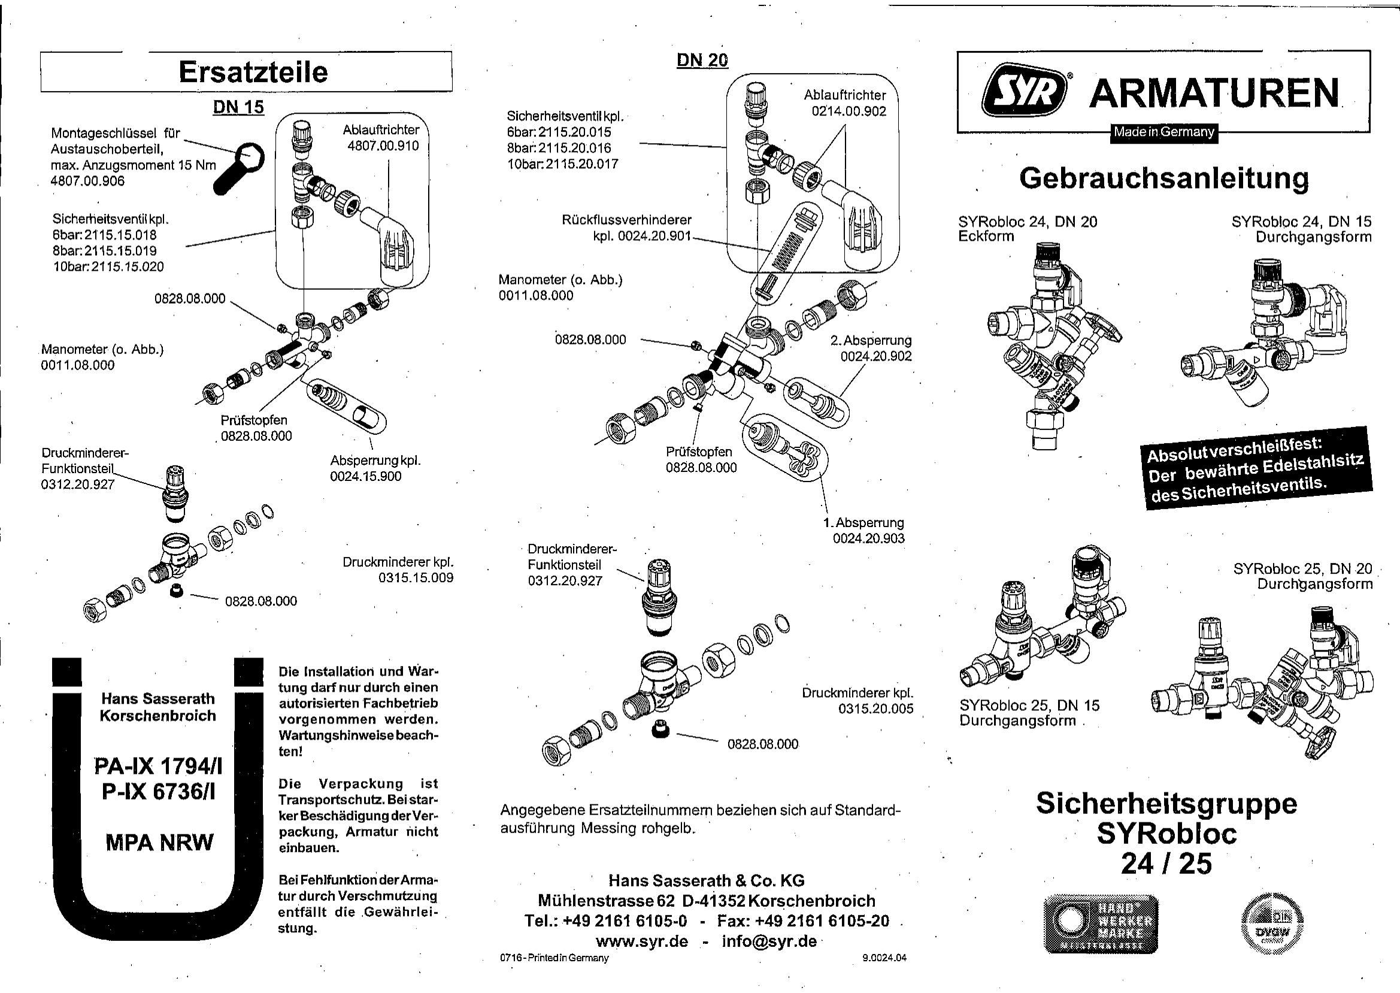
[picture p108: page 1]
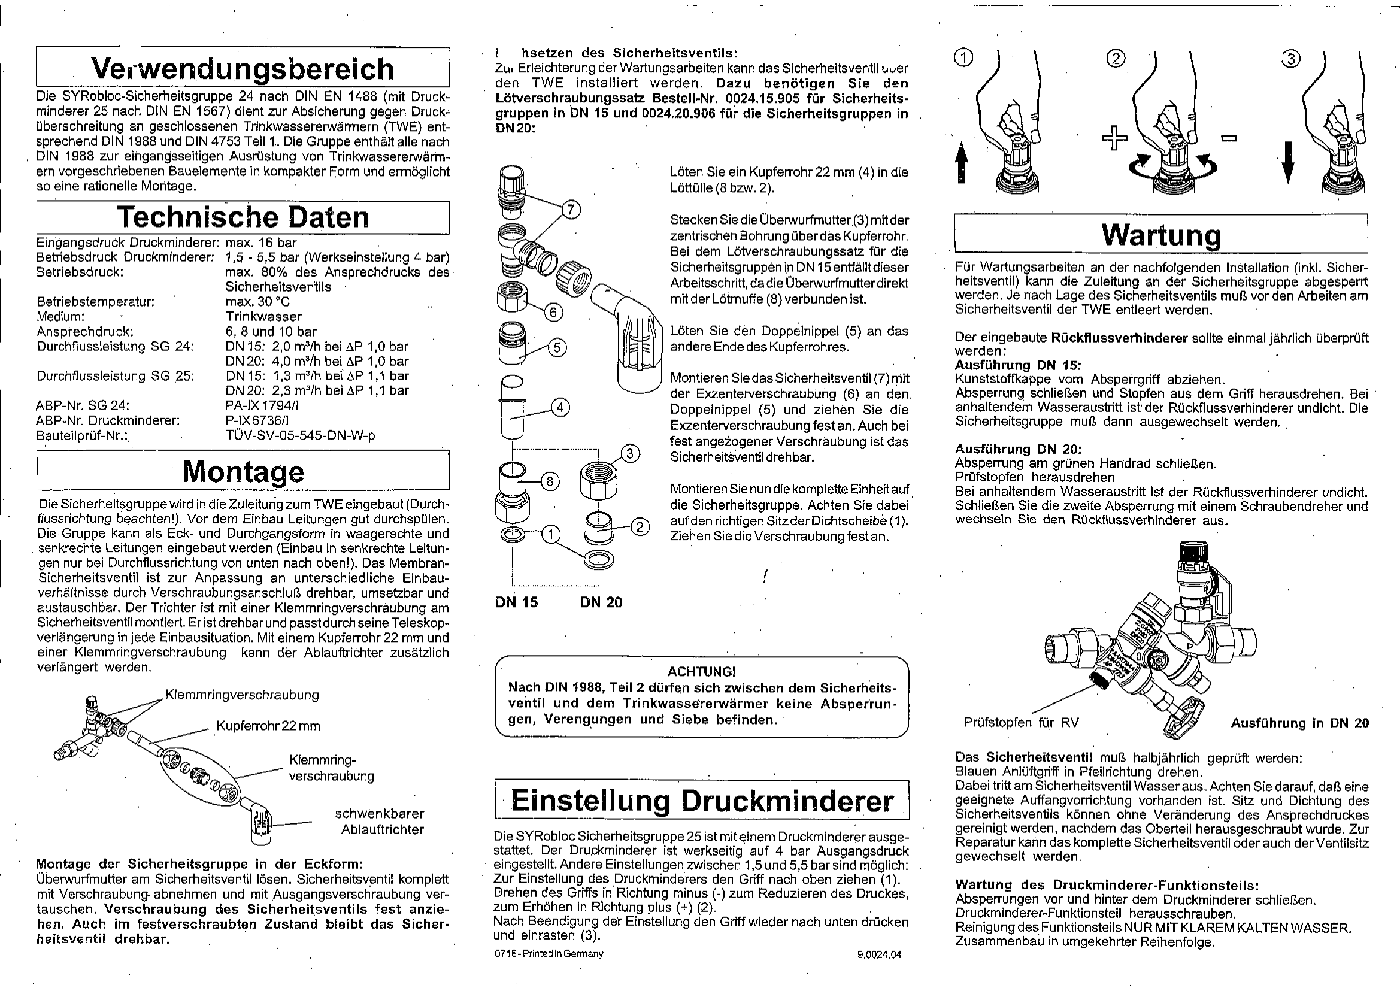
[picture p109: page 2]
