mho-jwi/MA/(B) Klimaprüfstand/Auslegung/Komponenten/Herstellerdatenblätter/Siekerkotte_Betriebsanleitung.pdf

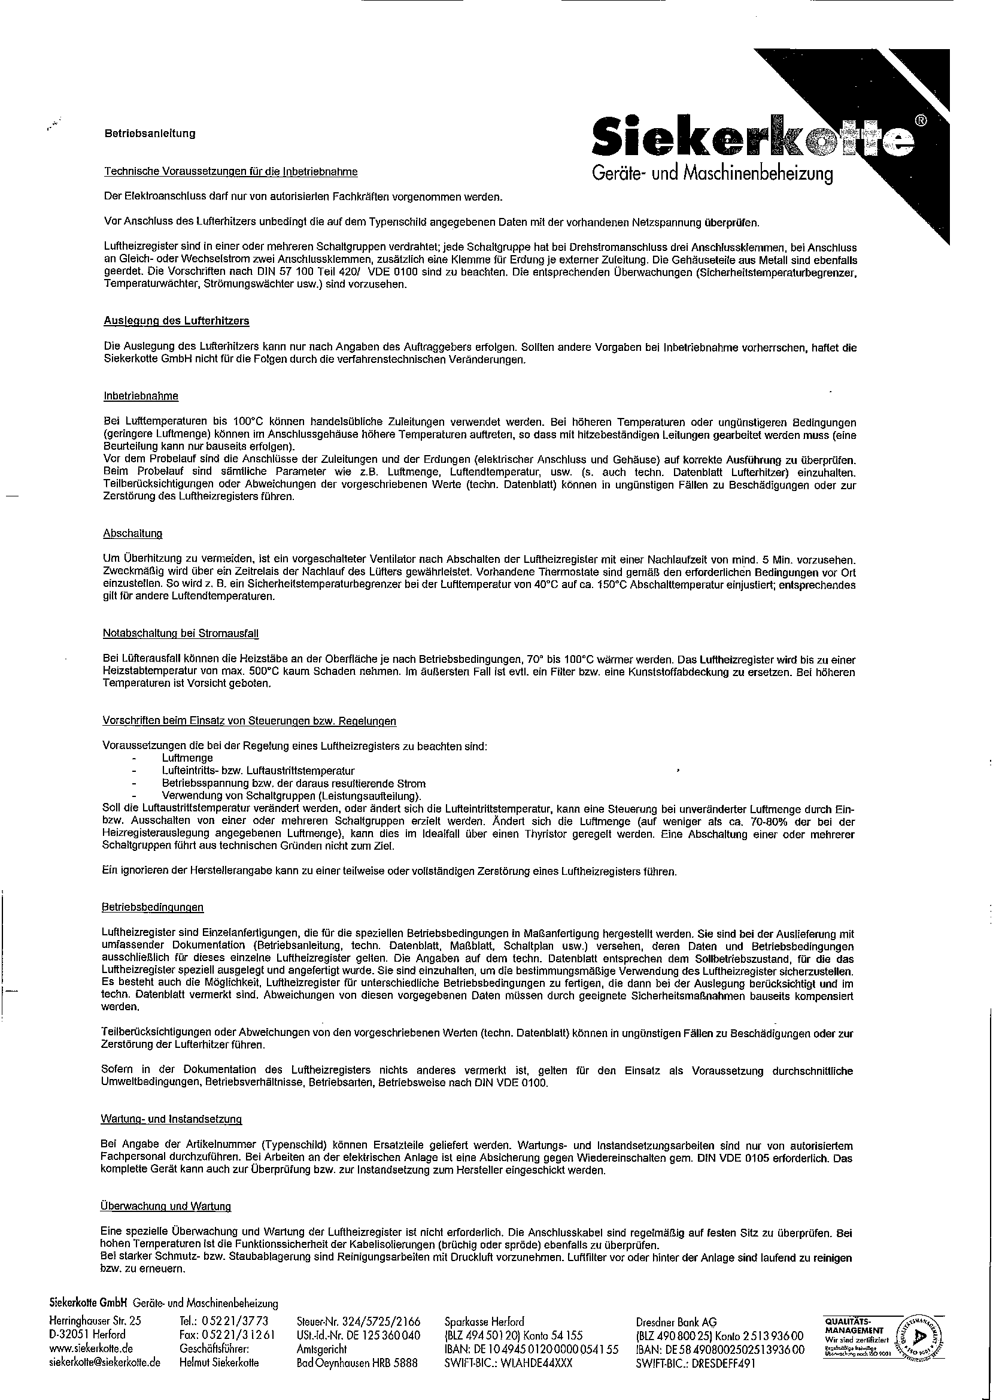
[picture p110: page 1]
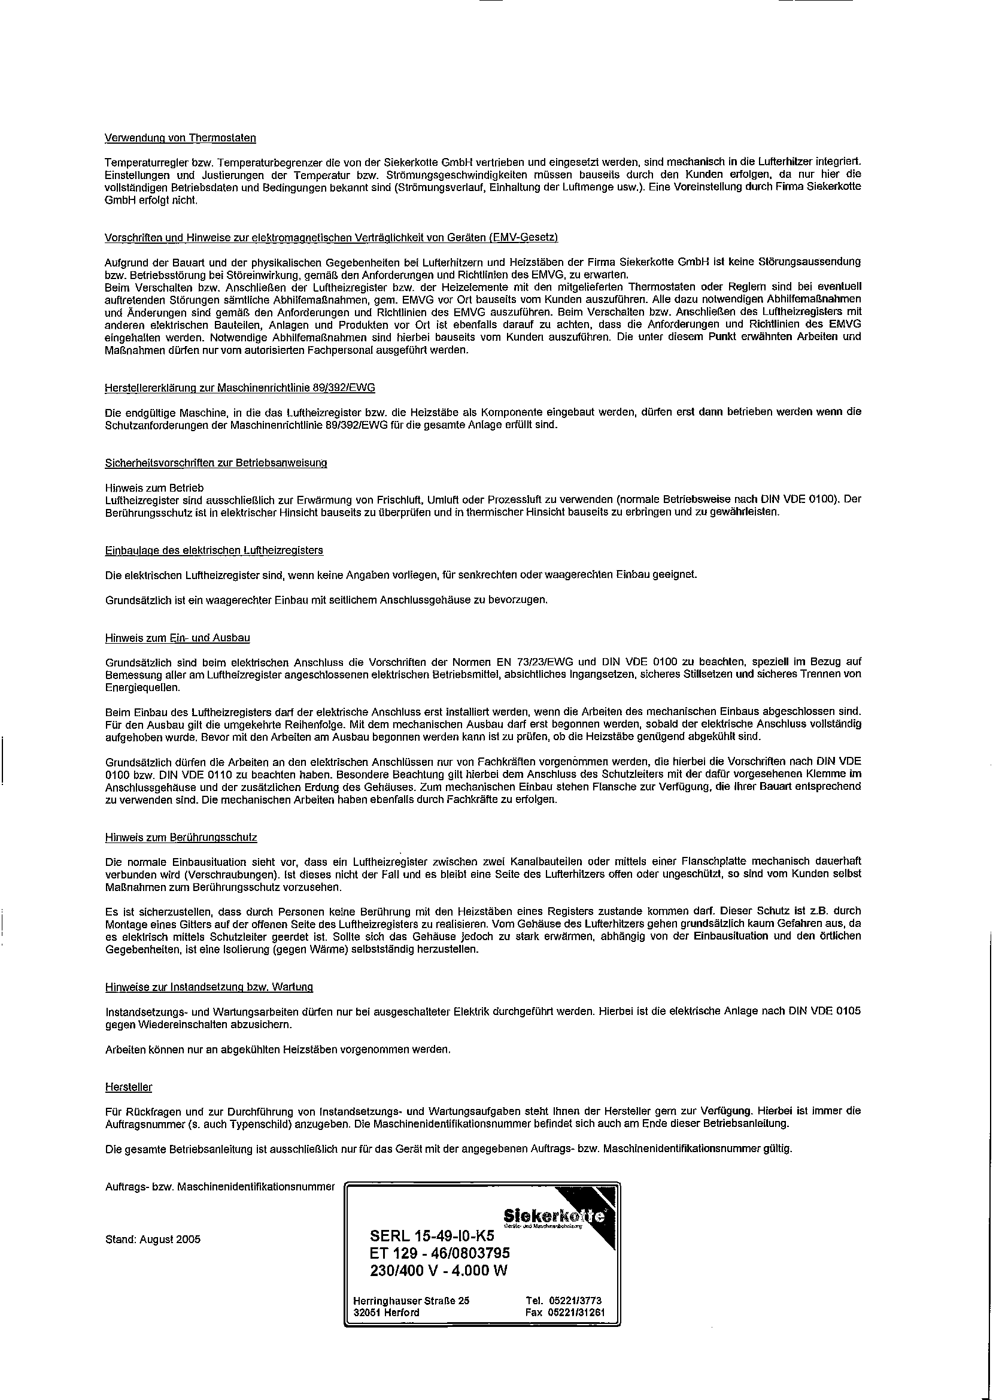
[picture p111: page 2]
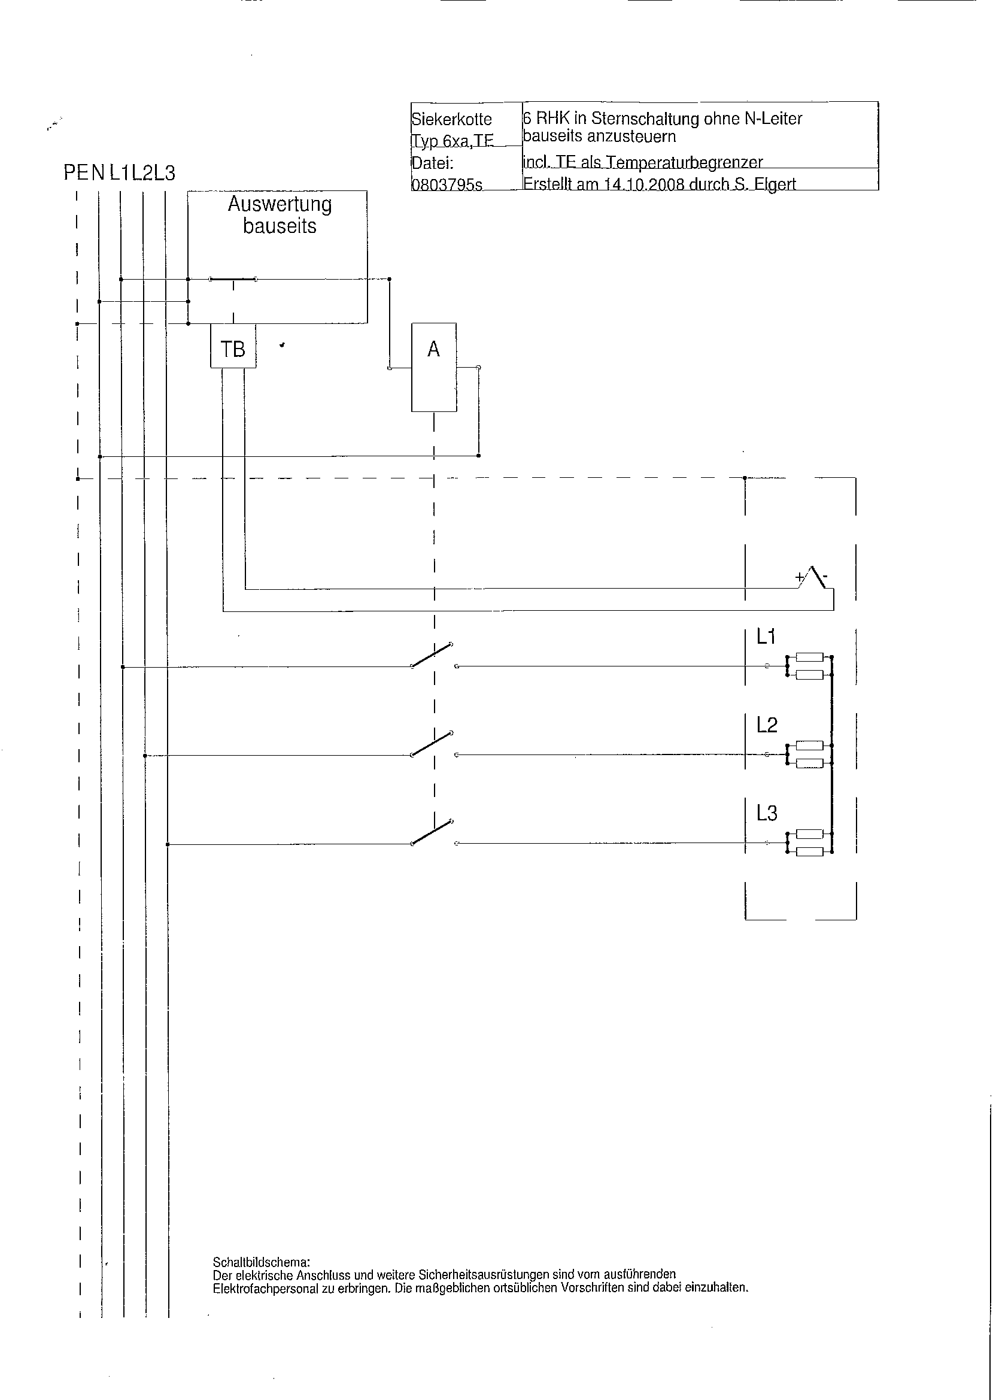
[picture p112: page 3]
