mho-jwi/MA/(B) Klimaprüfstand/Auslegung/Komponenten/Herstellerdatenblätter/Siemens_Anleitung RCCB  FI.pdf

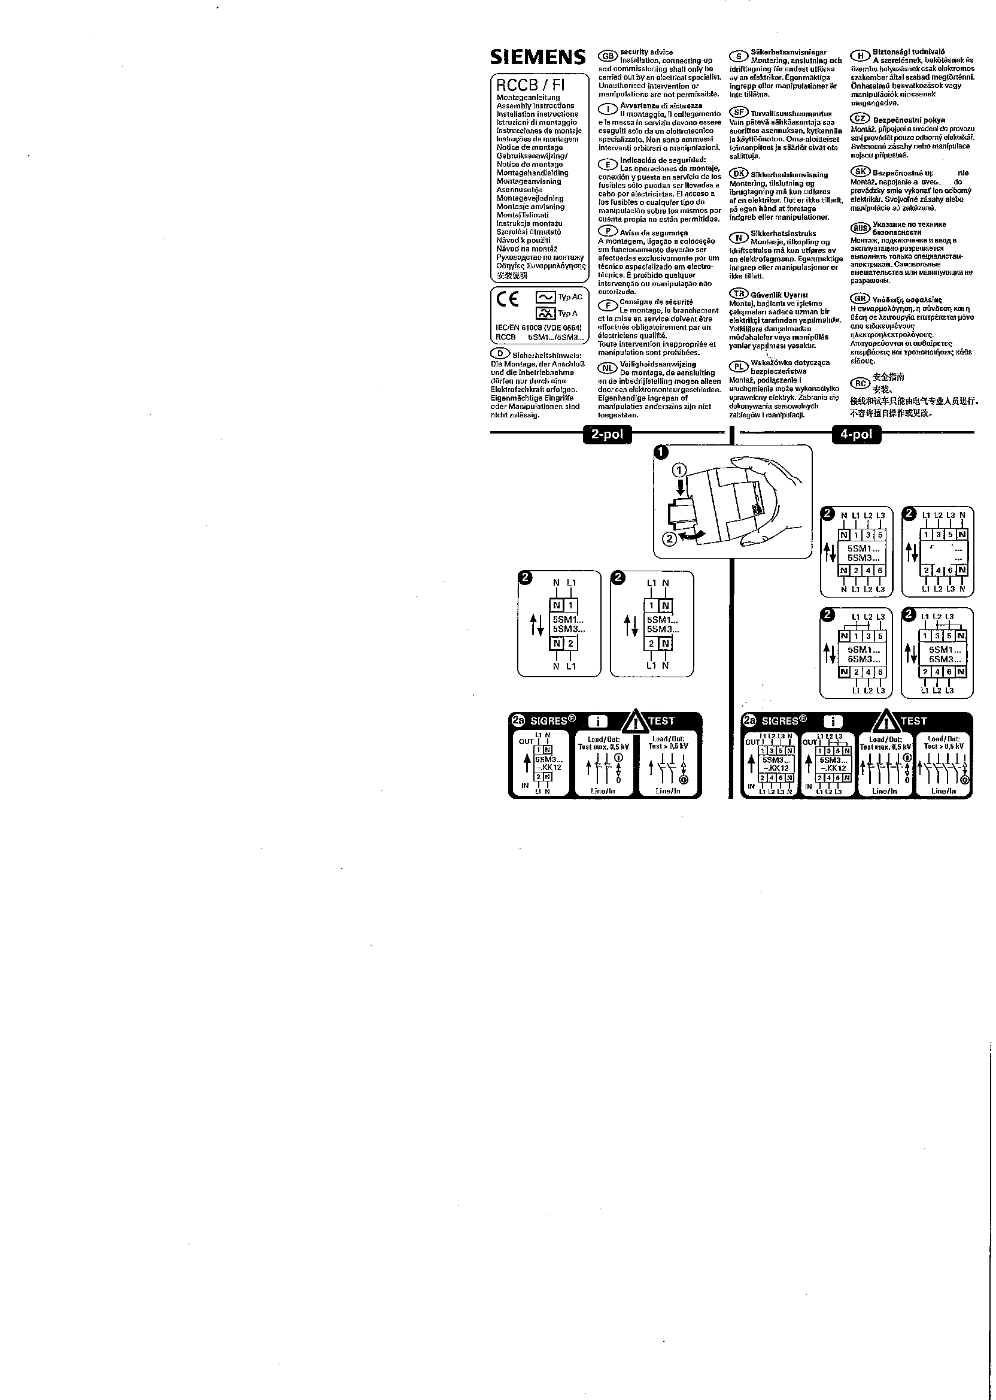
[picture p113: page 1]
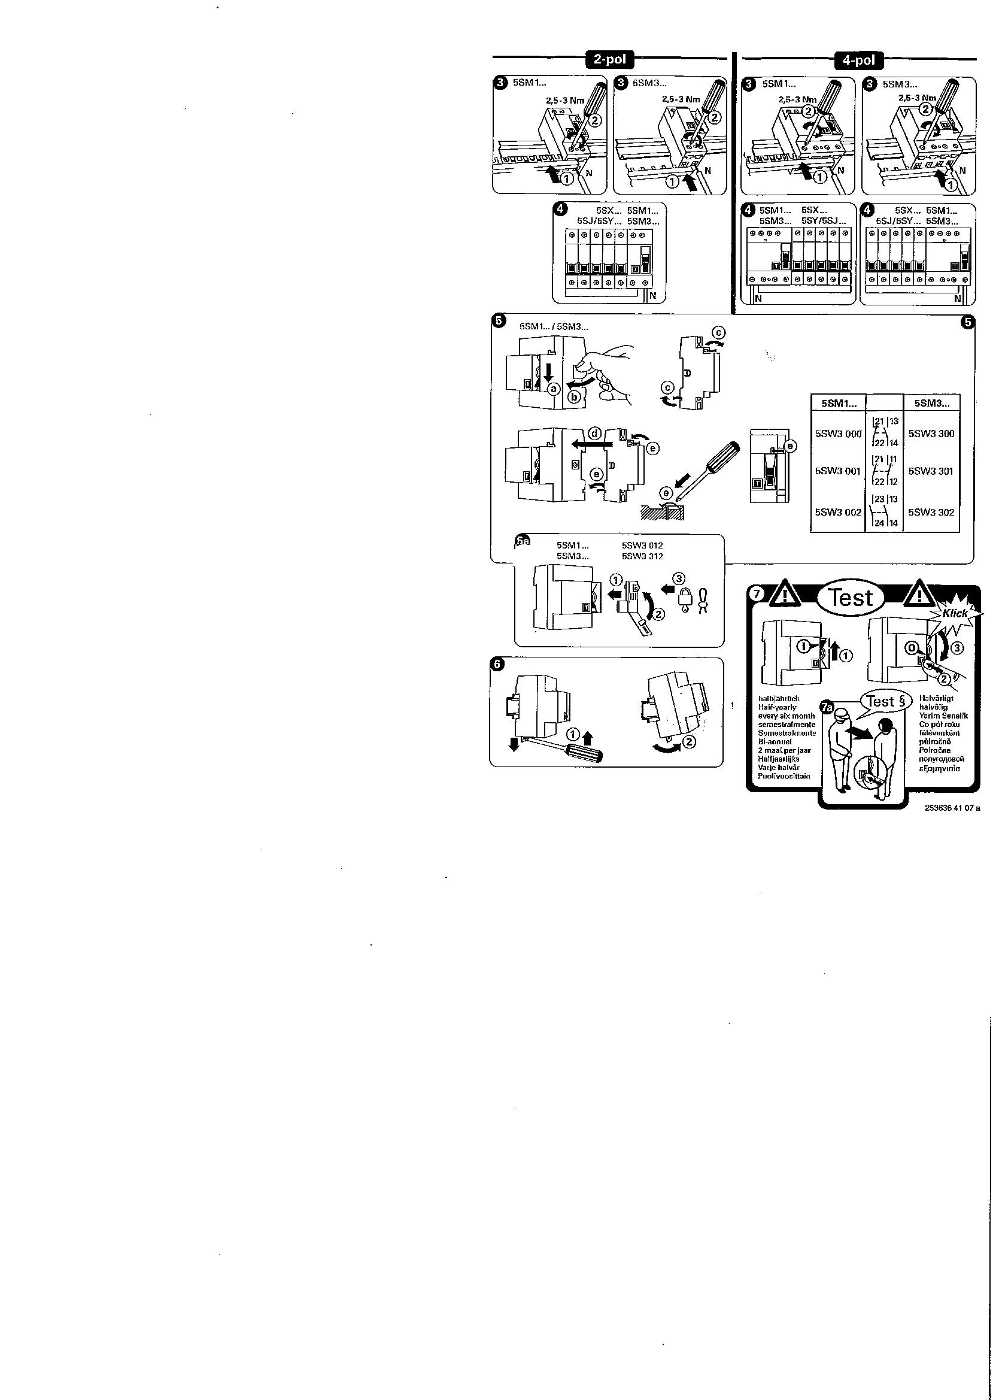
[picture p114: page 2]
