mho-jwi/MA/(B) Klimaprüfstand/Auslegung/Komponenten/Herstellerdatenblätter/Traco_Installationsanleitung.pdf

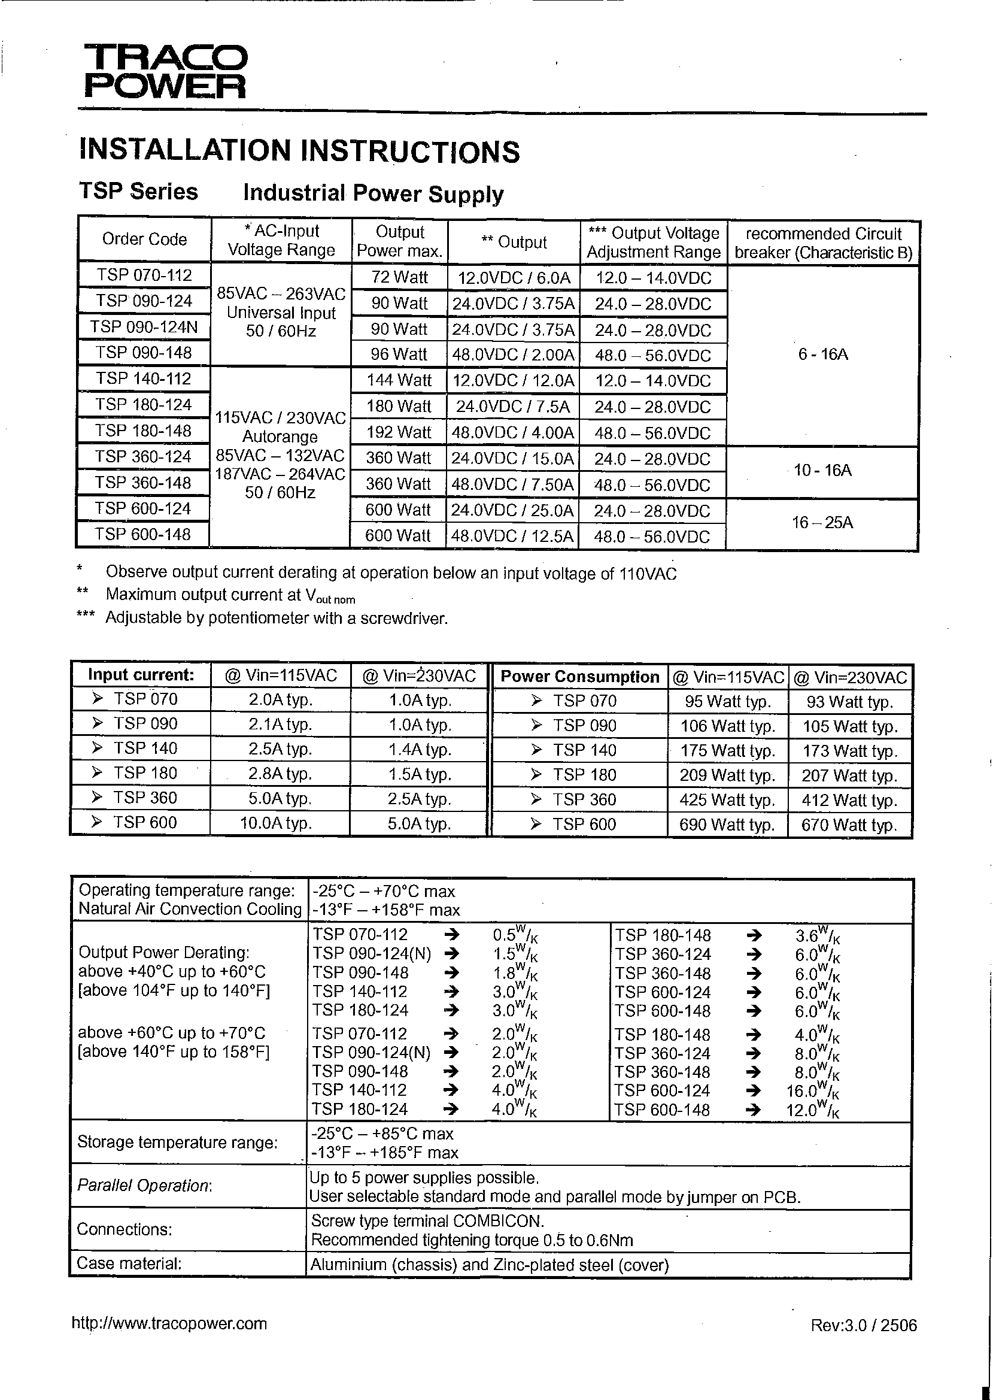
[picture p115: page 1]
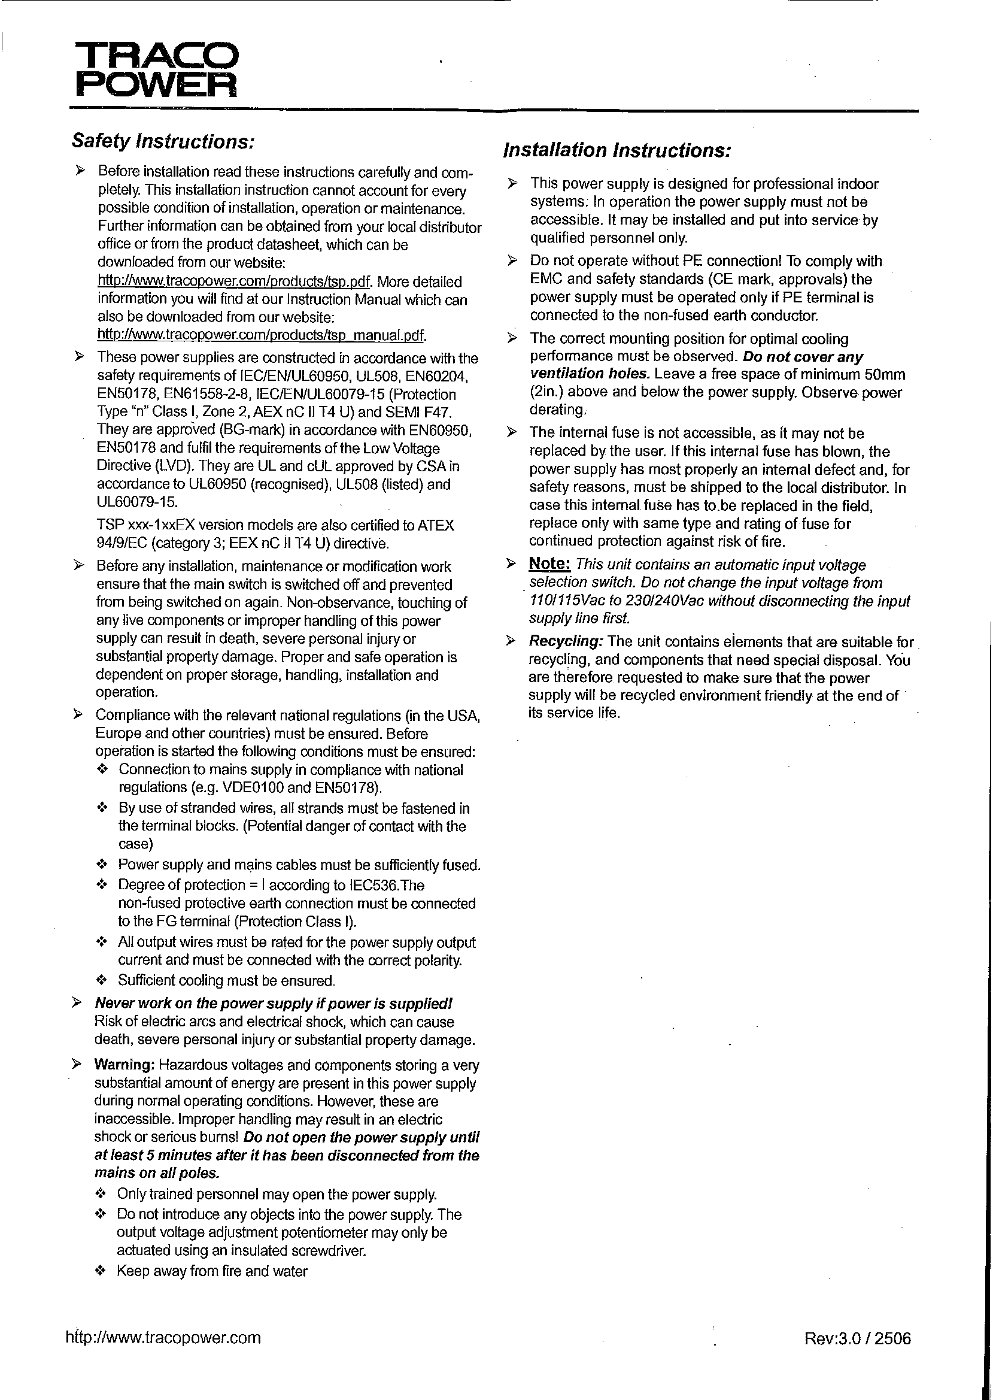
[picture p116: page 2]
