mho-jwi/MA/(B) Klimaprüfstand/Spezifikationen/Kühlwasserversorgung/Betriebsanleitung Kältemaschine ebc/5.Technische Daten und Beschreibung der Kälteanlage (1).pdf

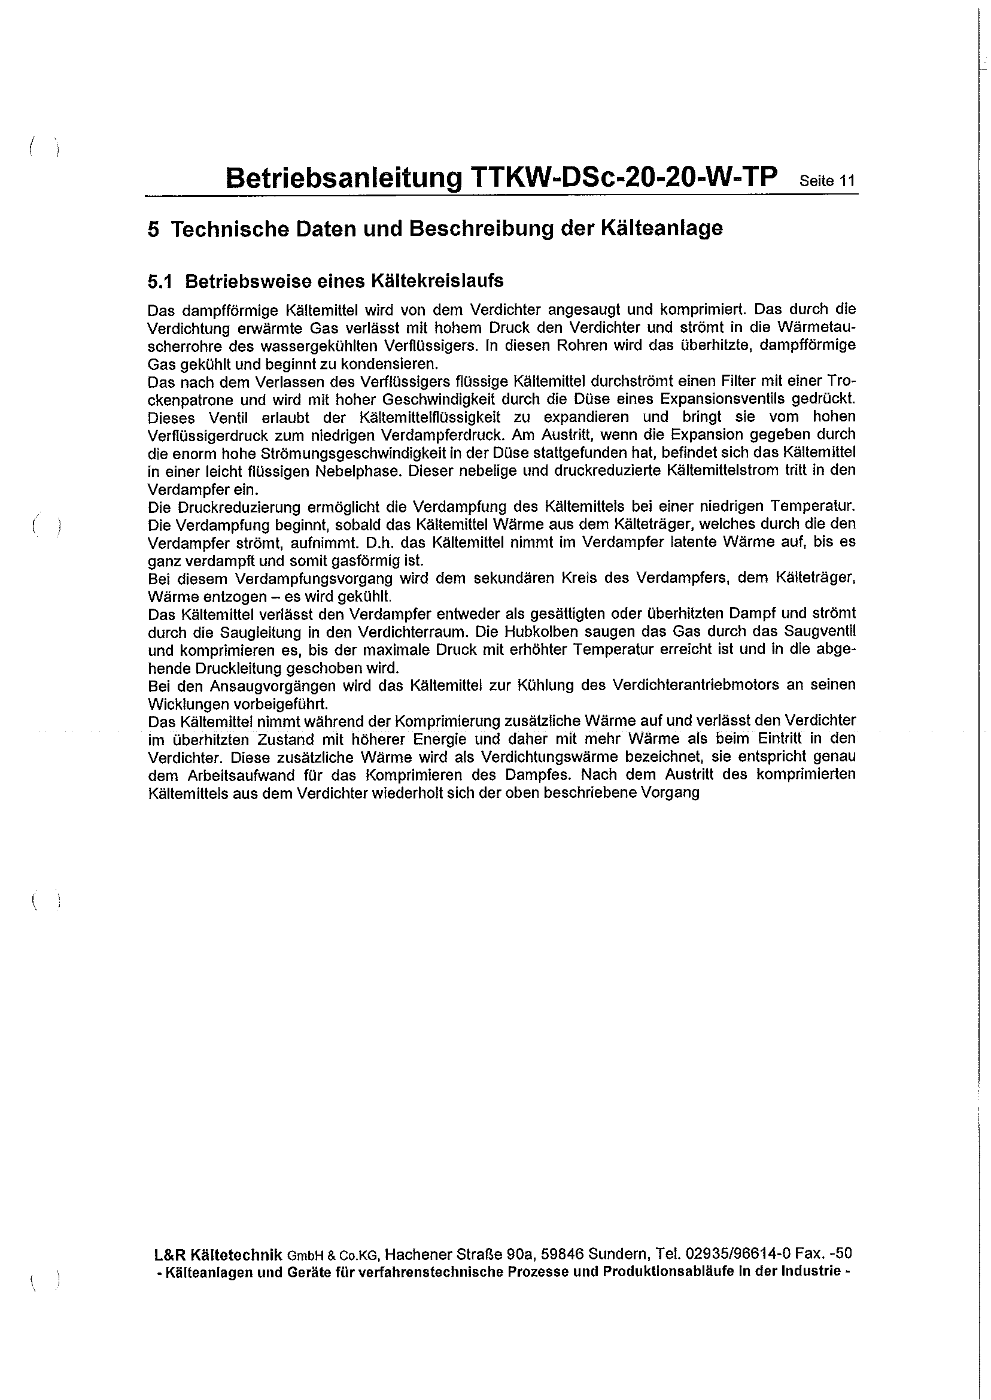
[picture p117: page 1]
