mho-jwi/MA/(B) Klimaprüfstand/Spezifikationen/Kühlwasserversorgung/Betriebsanleitung Kältemaschine ebc/5.Technische Daten und Beschreibung der Kälteanlage (2).pdf

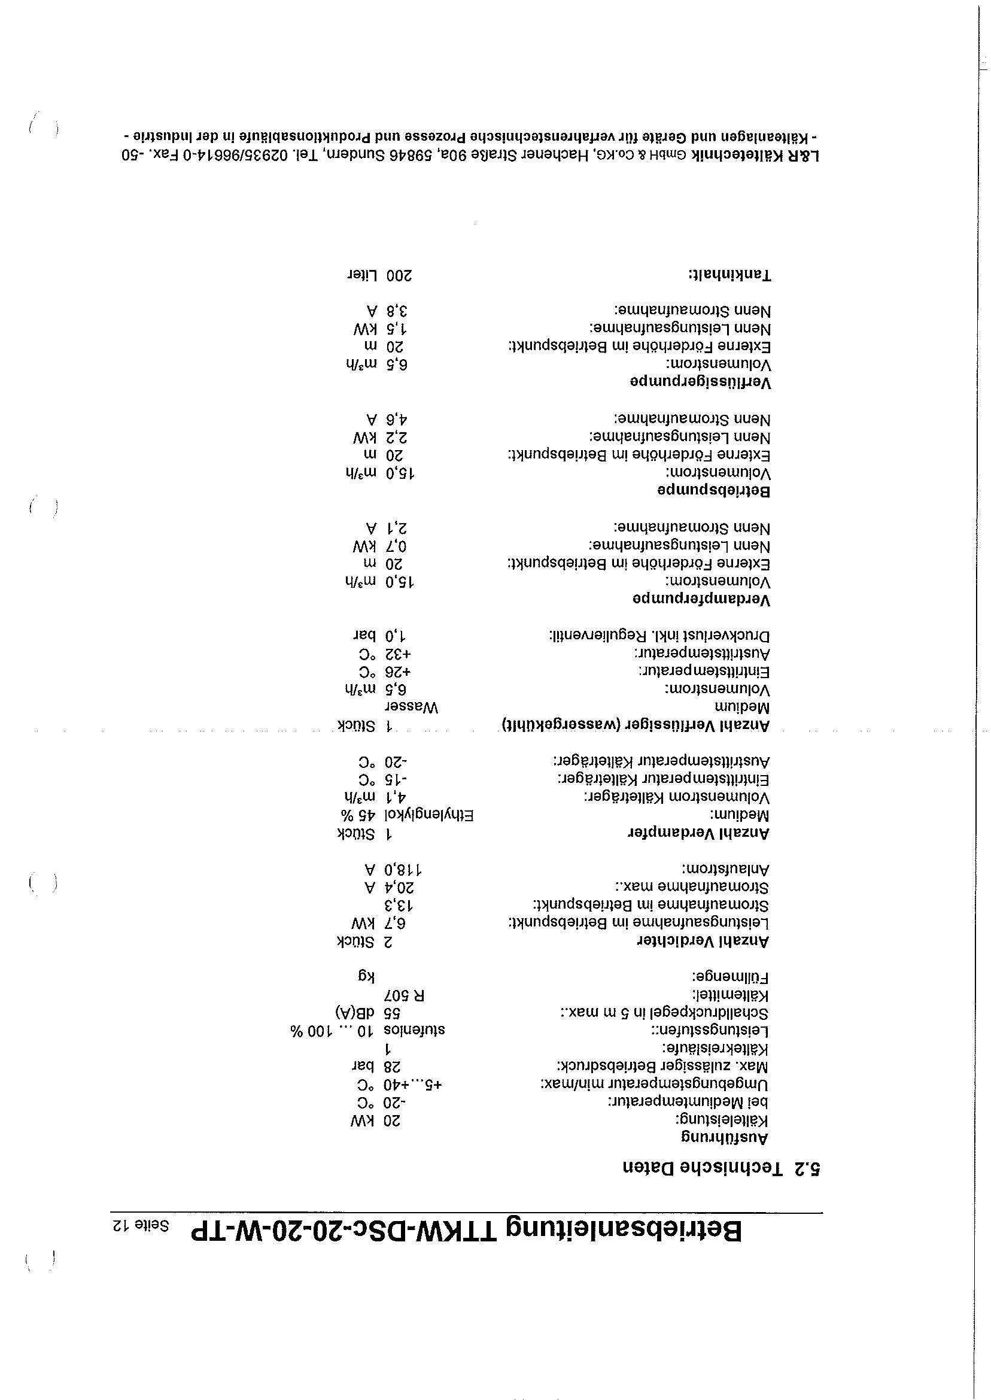
[picture p118: page 1]
