mho-jwi/MA/(B) Klimaprüfstand/Spezifikationen/Kühlwasserversorgung/Betriebsanleitung Kältemaschine ebc/5.Technische Daten und Beschreibung der Kälteanlage (3).pdf

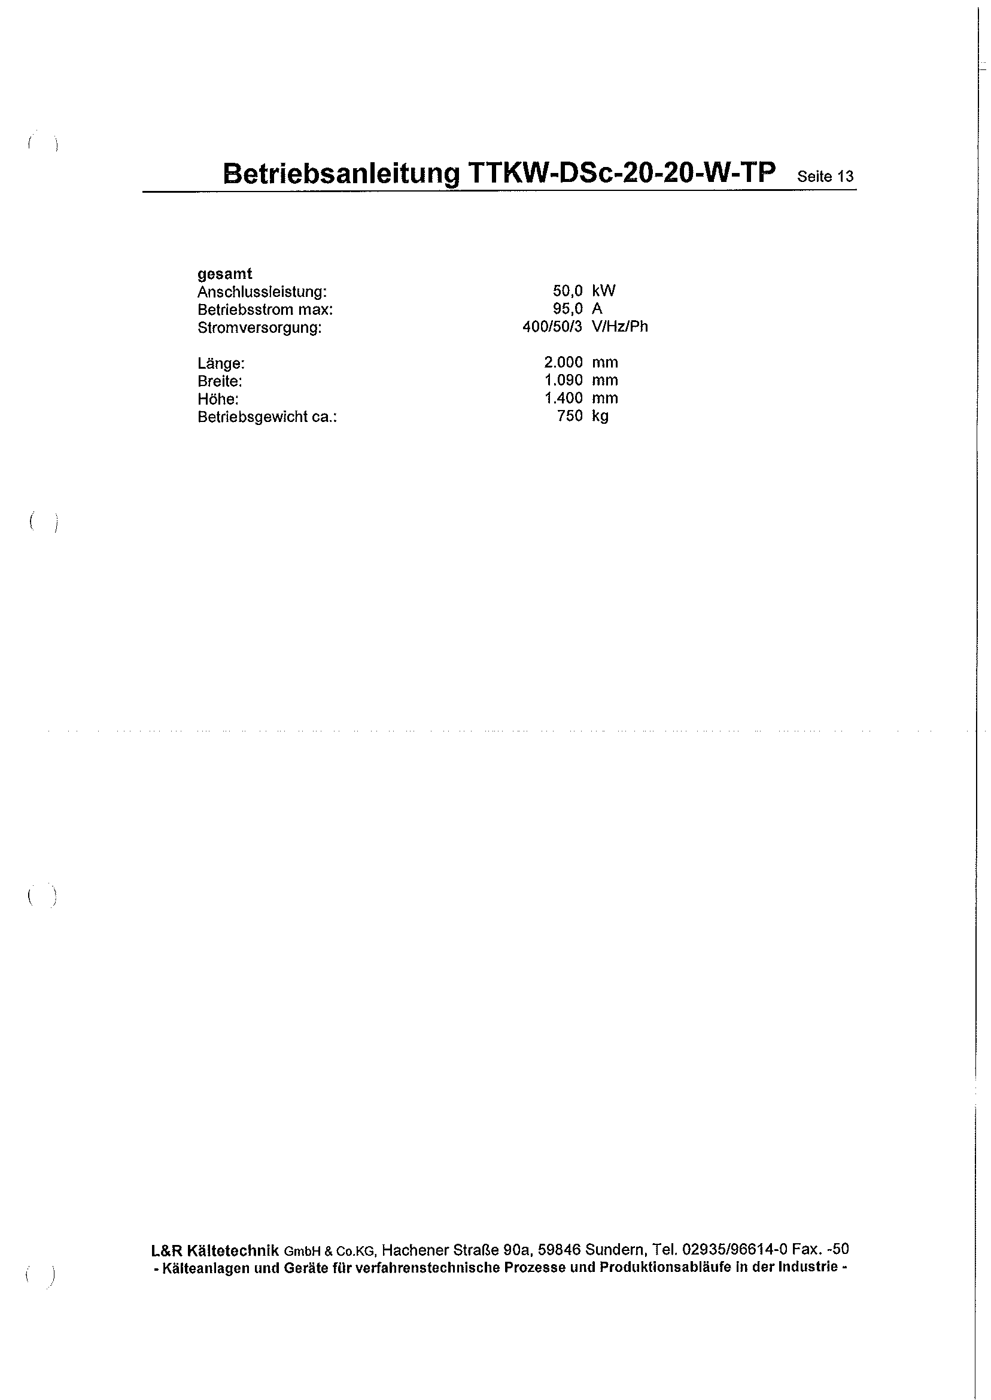
[picture p119: page 1]
