mho-jwi/MA/(B) Klimaprüfstand/Auslegung/Komponenten/Herstellerdatenblätter/Traco_Test Report.pdf

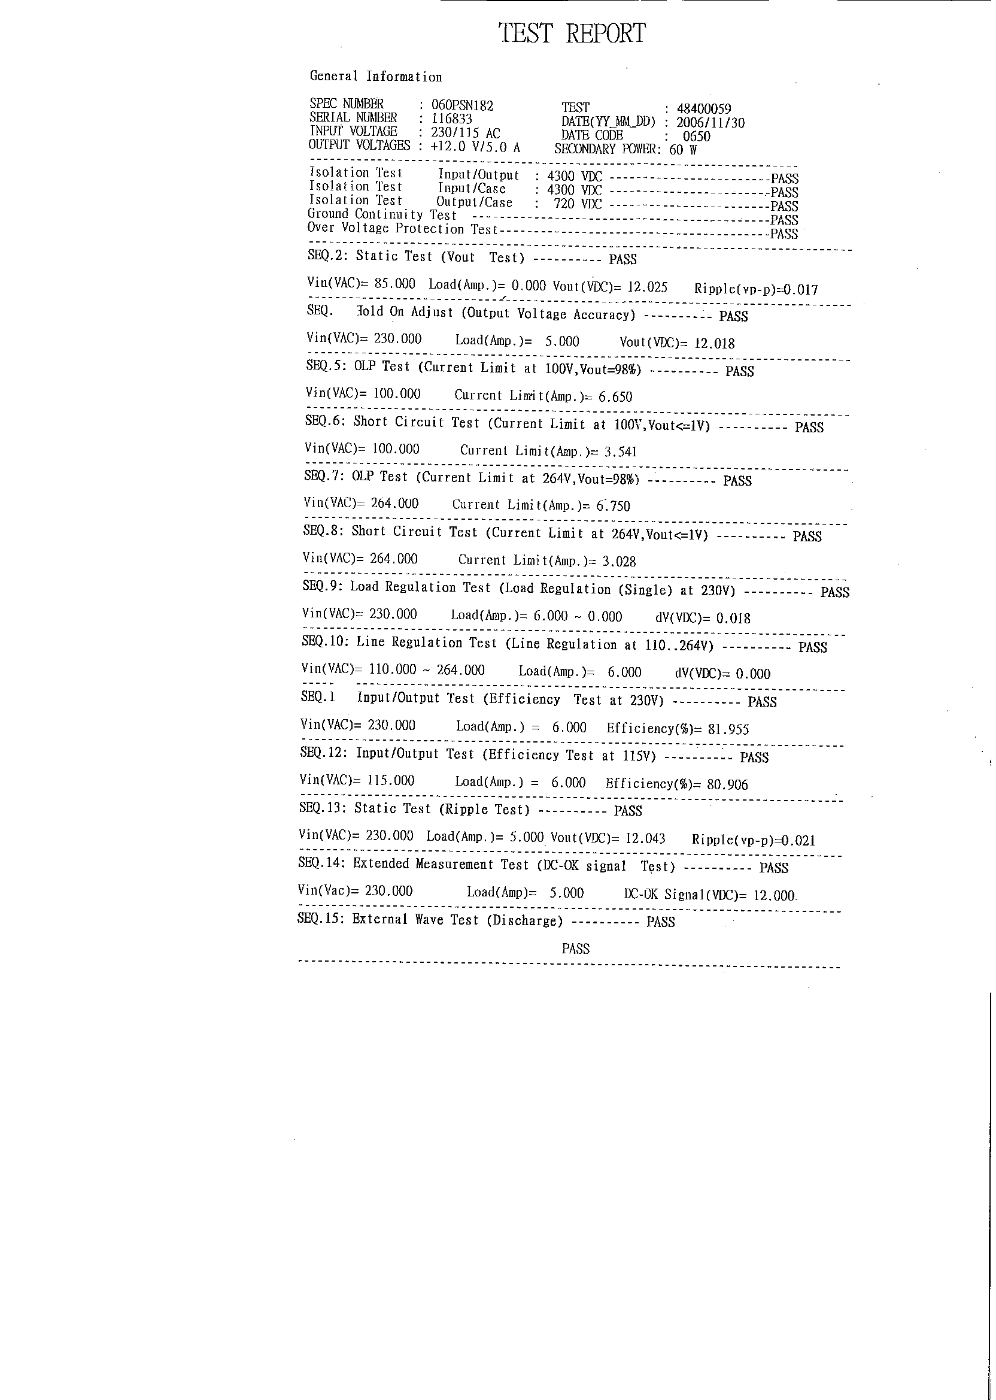
[picture p120: page 1]
