mho-jwi/MA/(B) Klimaprüfstand/Steuerung/P5507/Doku/Kalibrierung/WKS01528-2009-02_EPI1393_P5507-001_TemperatursensorT_TPA2.pdf

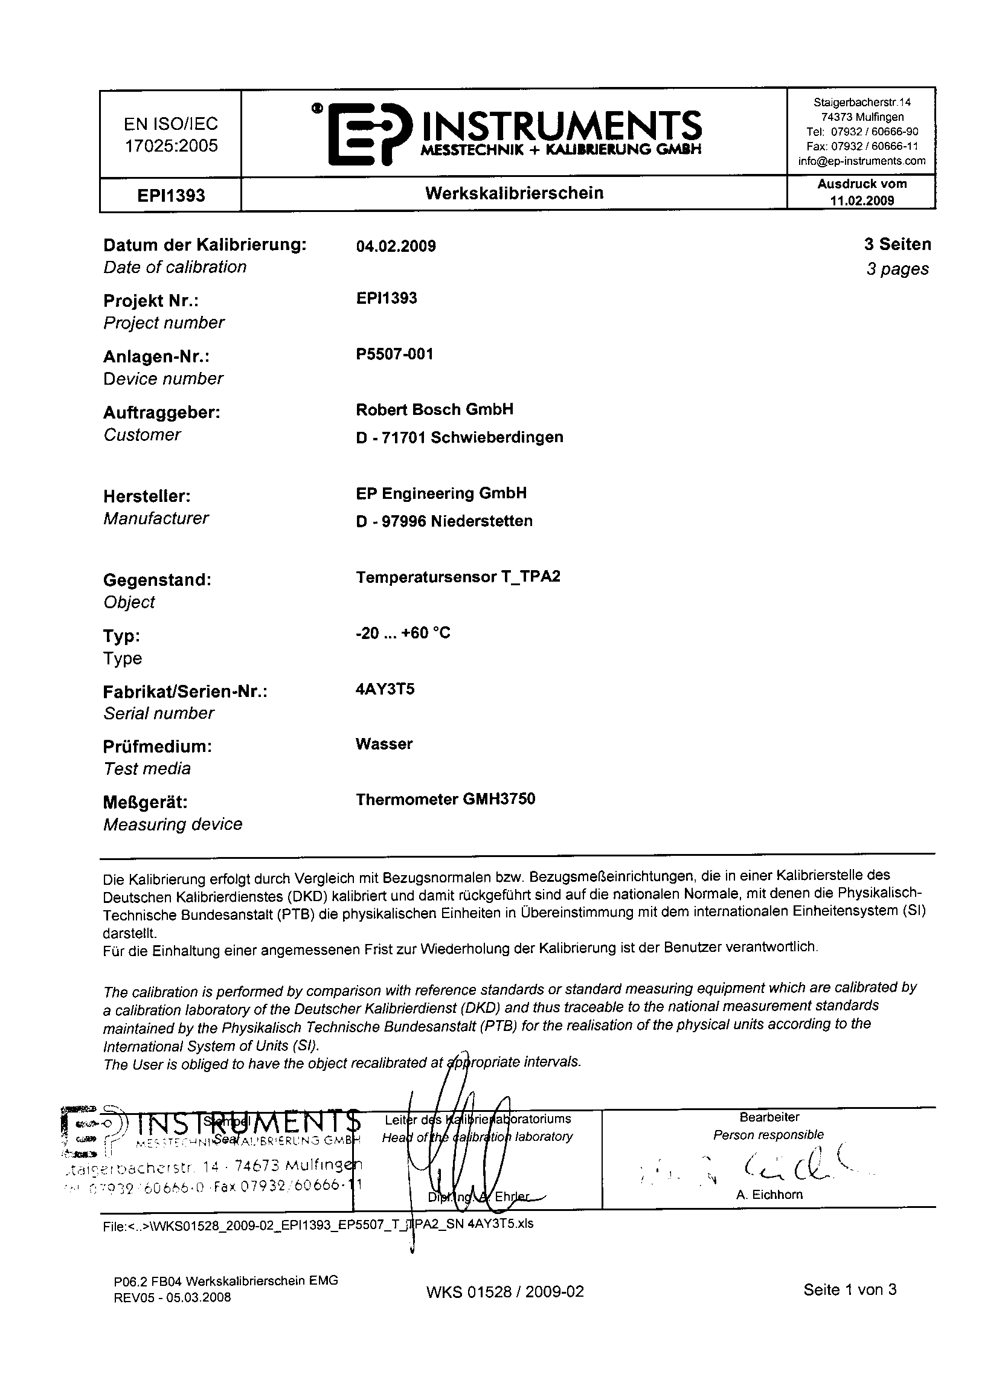
[picture p121: page 1]
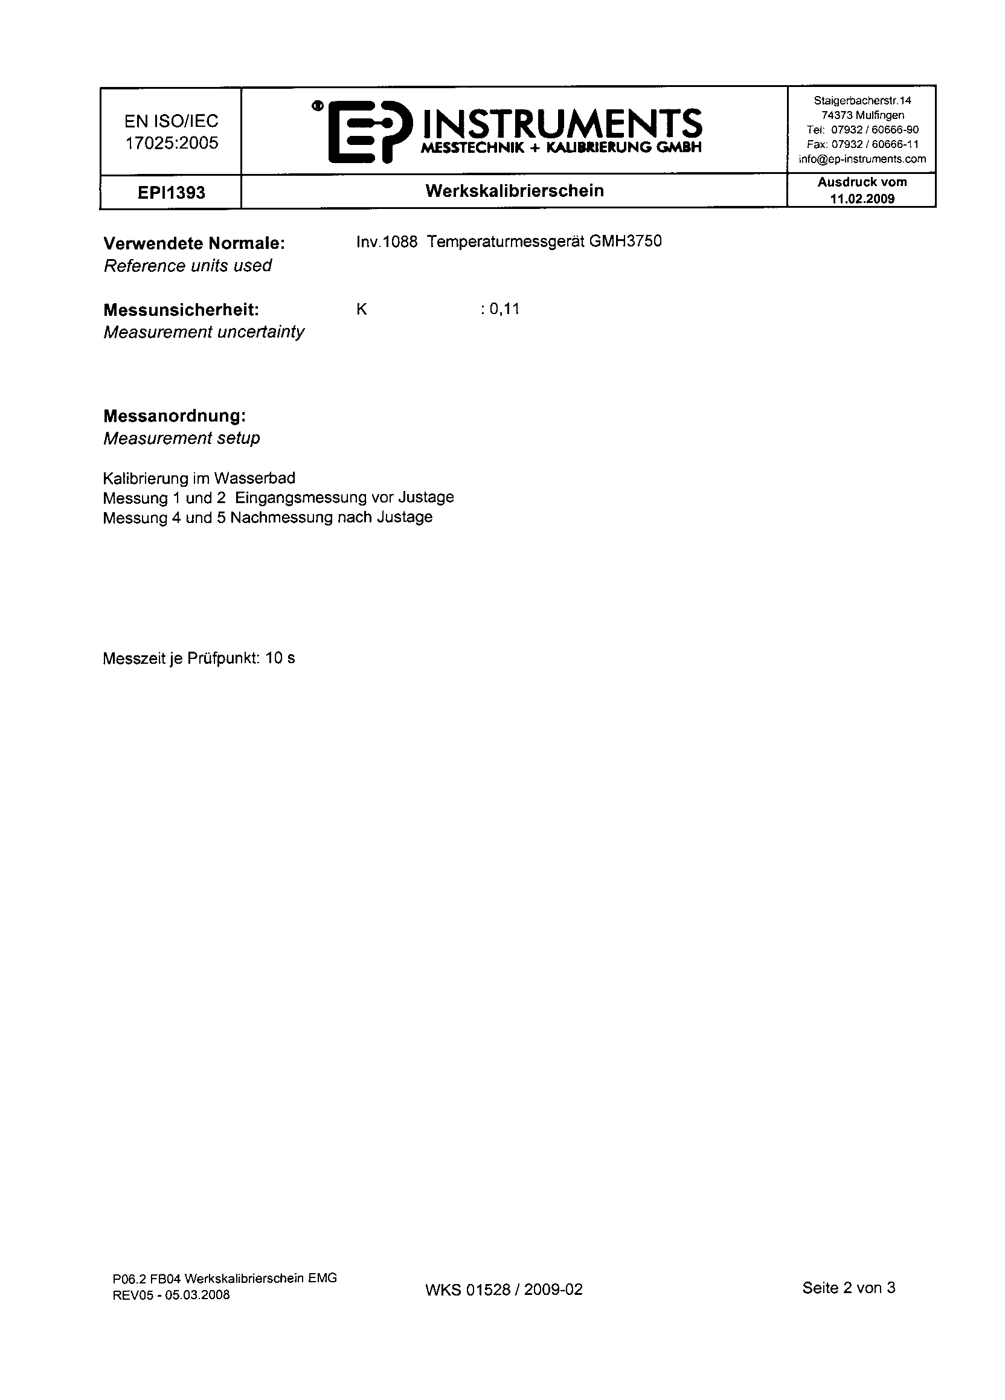
[picture p122: page 2]
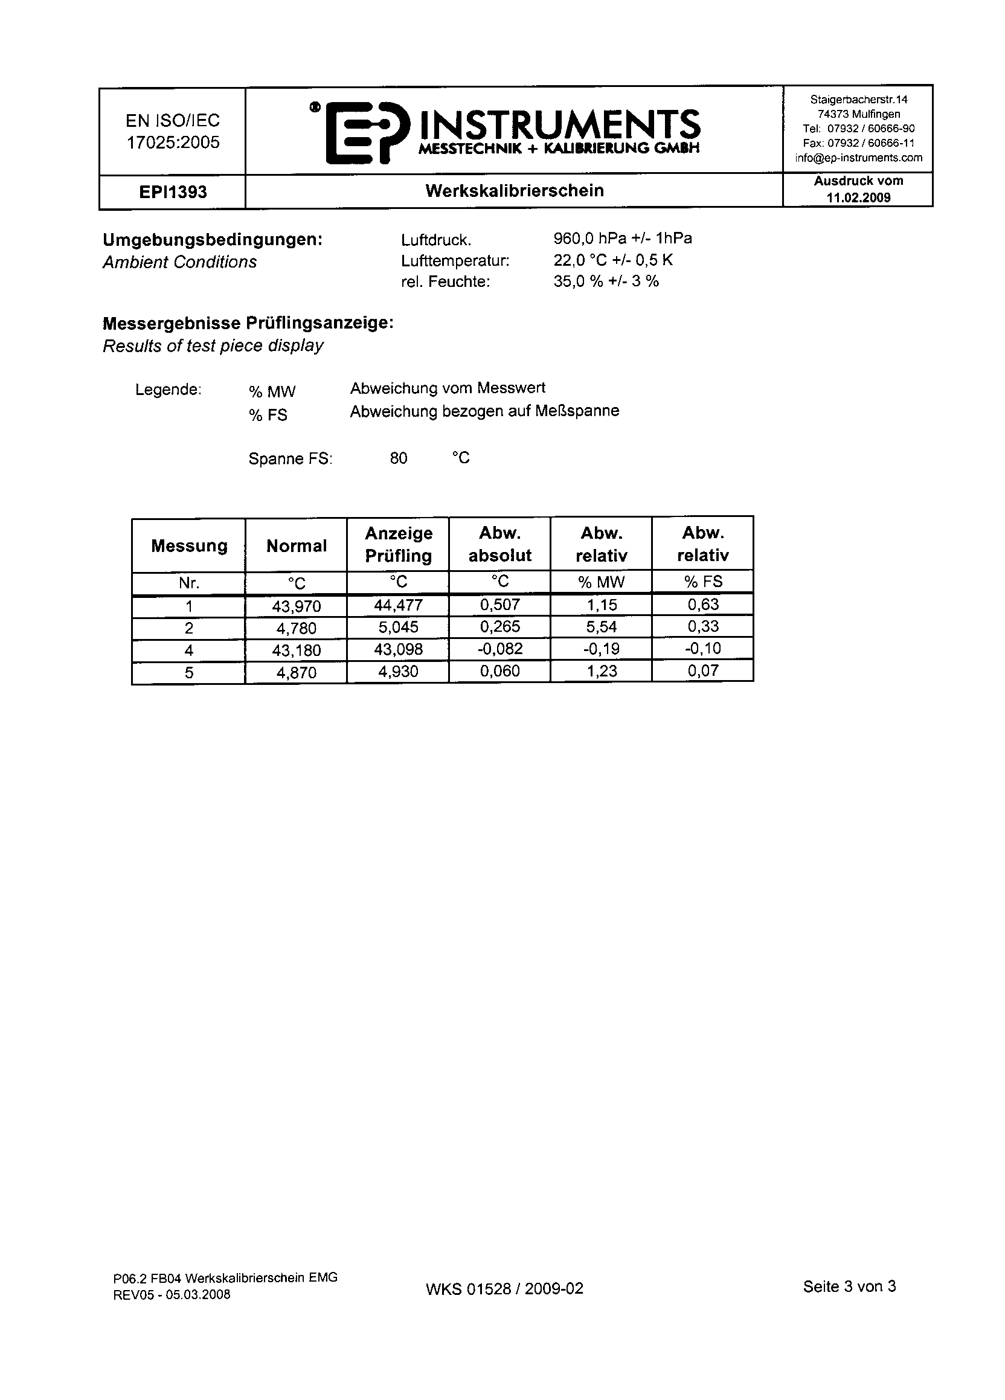
[picture p123: page 3]
