mho-jwi/MA/(B) Klimaprüfstand/Steuerung/P5507/Doku/Kalibrierung/WKS01529-2009-02_EPI1393_P5507-001_TemperatursensorT_TPB1.pdf

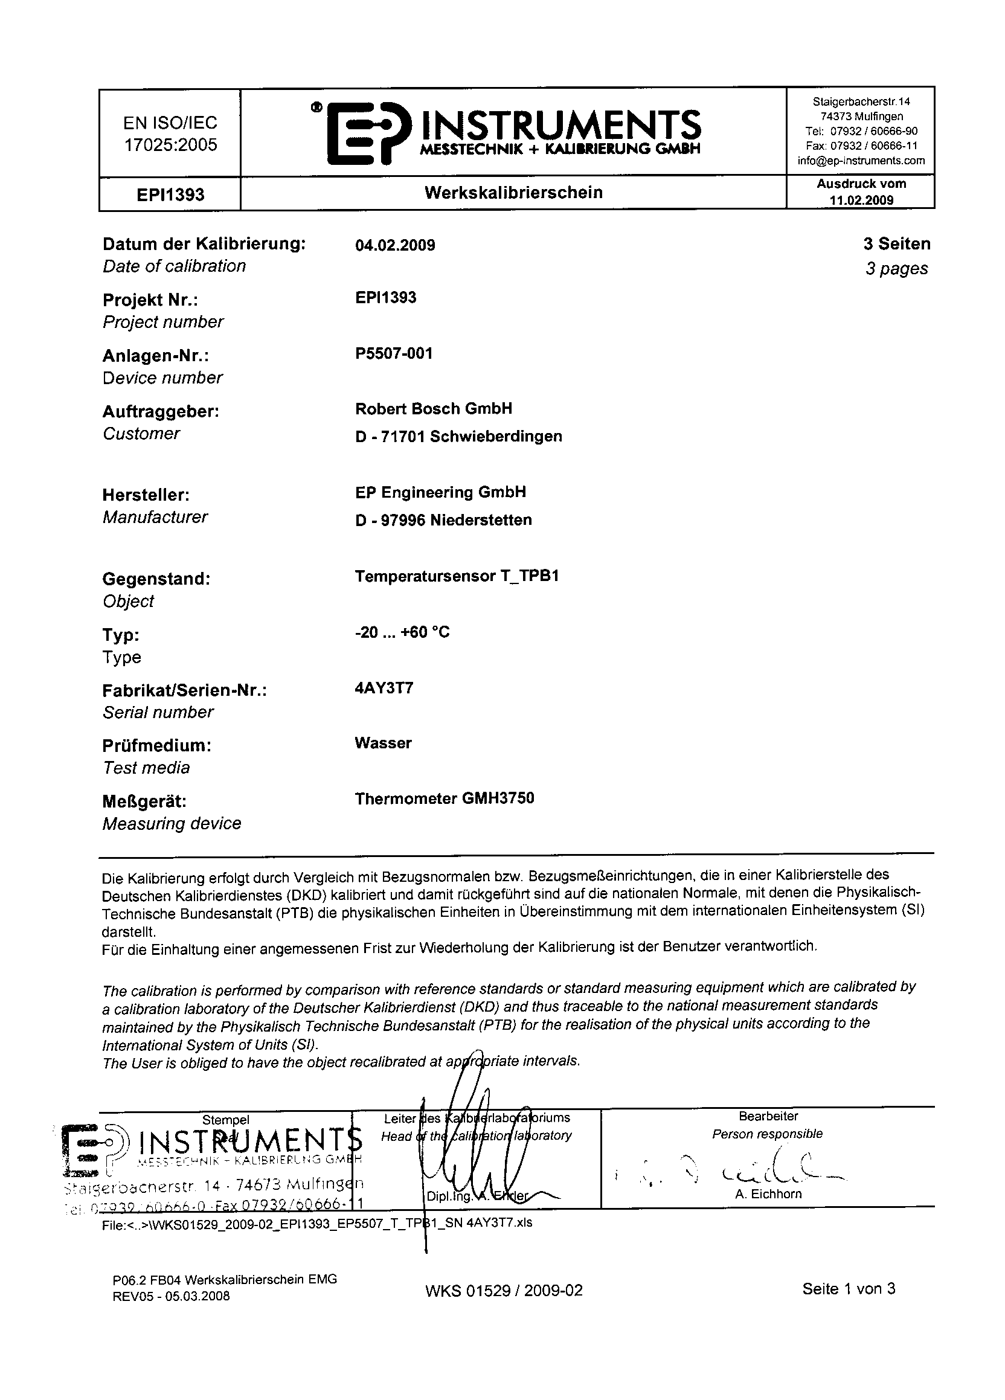
[picture p124: page 1]
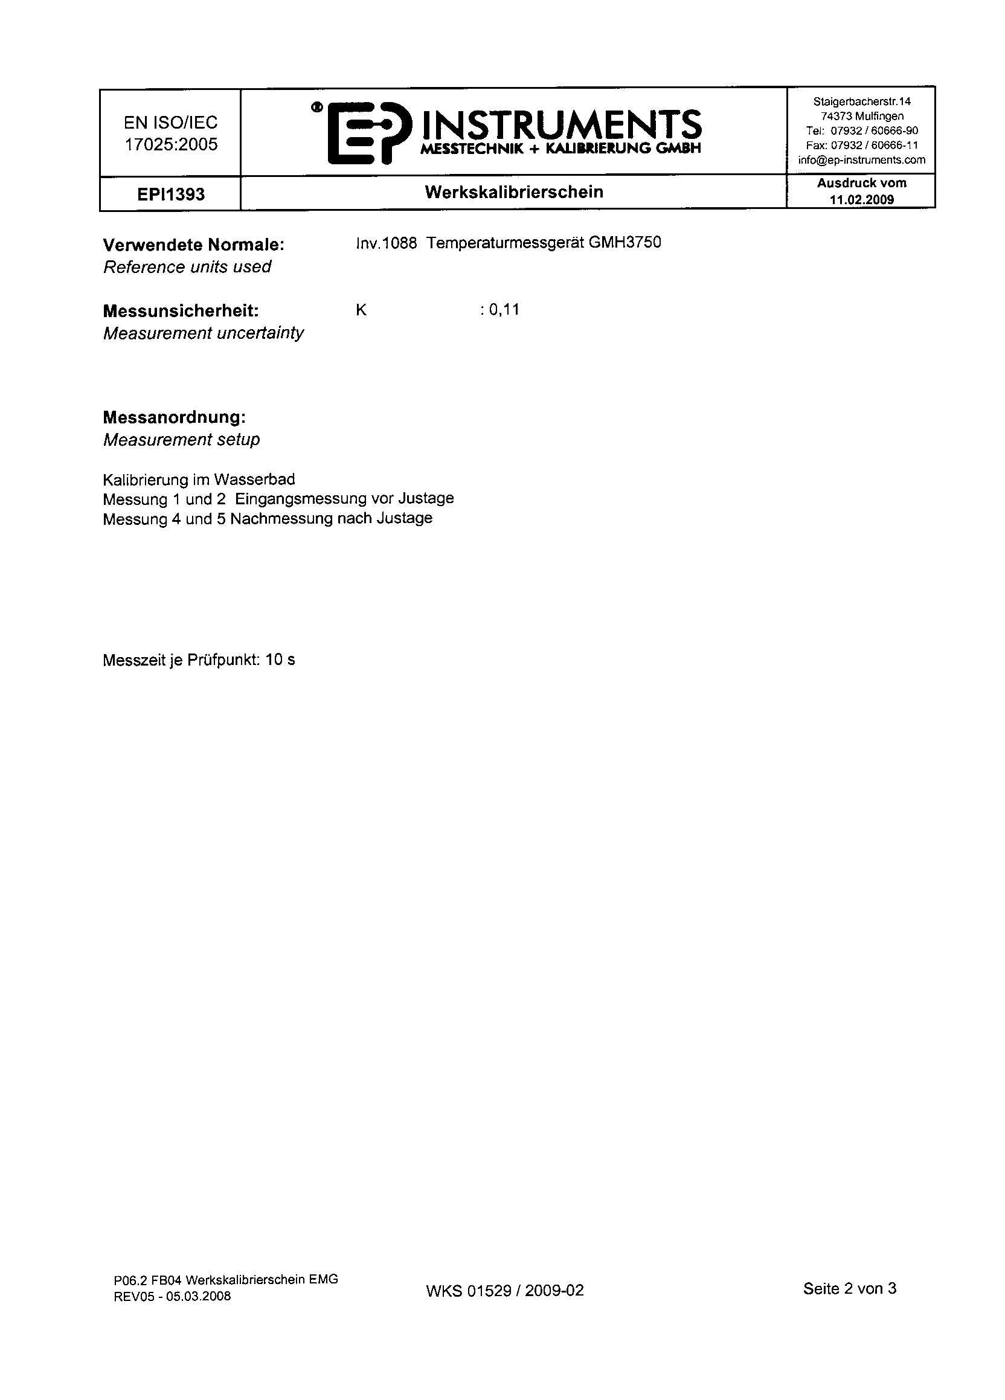
[picture p125: page 2]
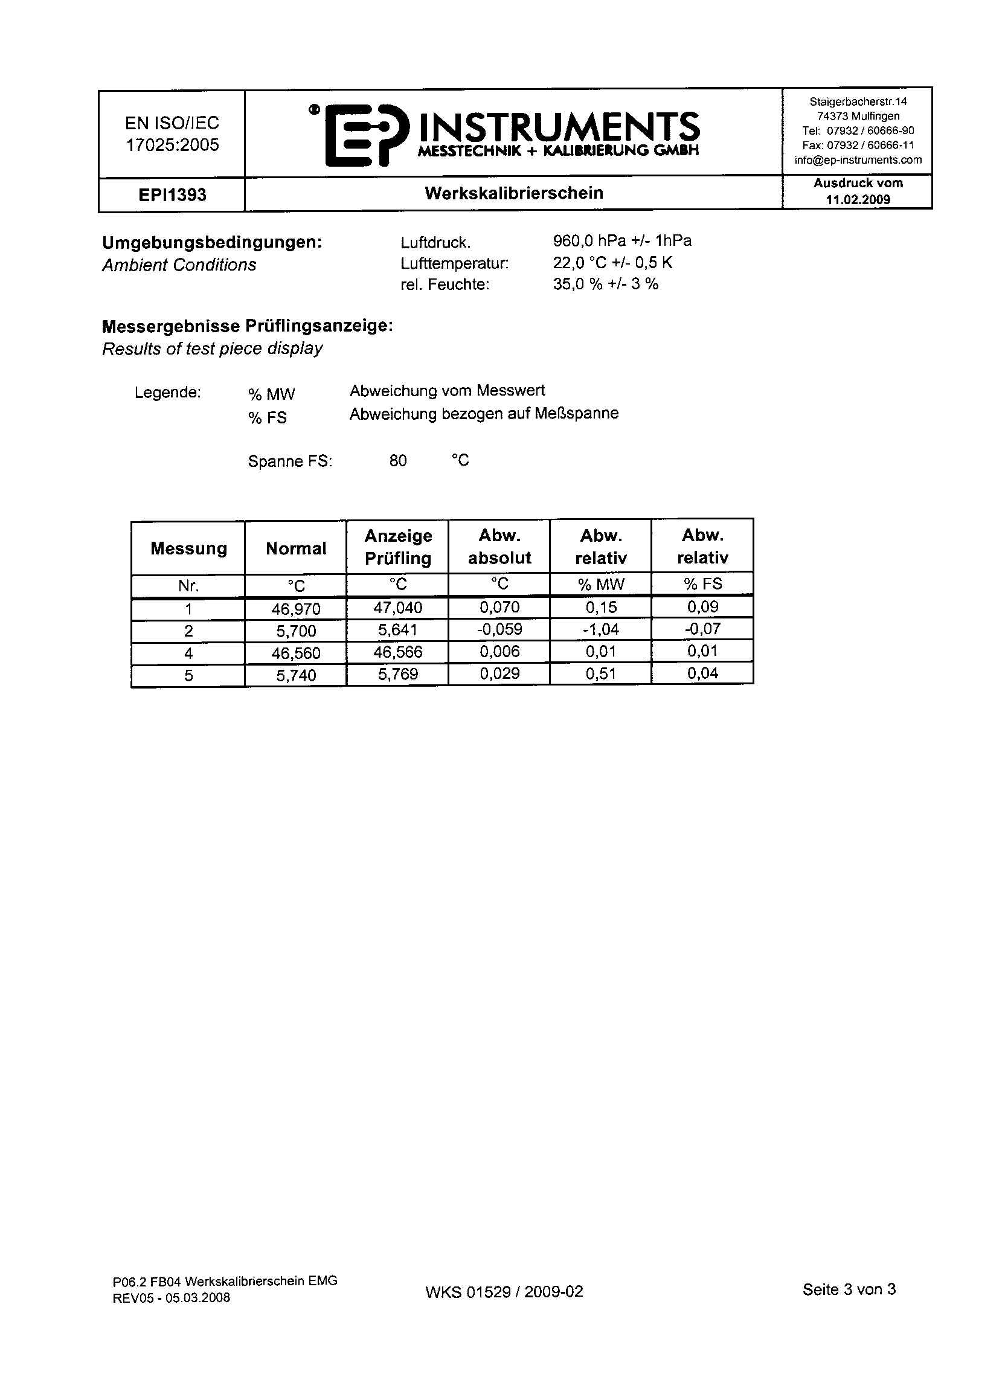
[picture p126: page 3]
