mho-jwi/MA/(B) Klimaprüfstand/Steuerung/P5507/Doku/Kalibrierung/WKS01530-2009-02_EPI1393_P5507-001_TemperatursensorT4_AHU1.pdf

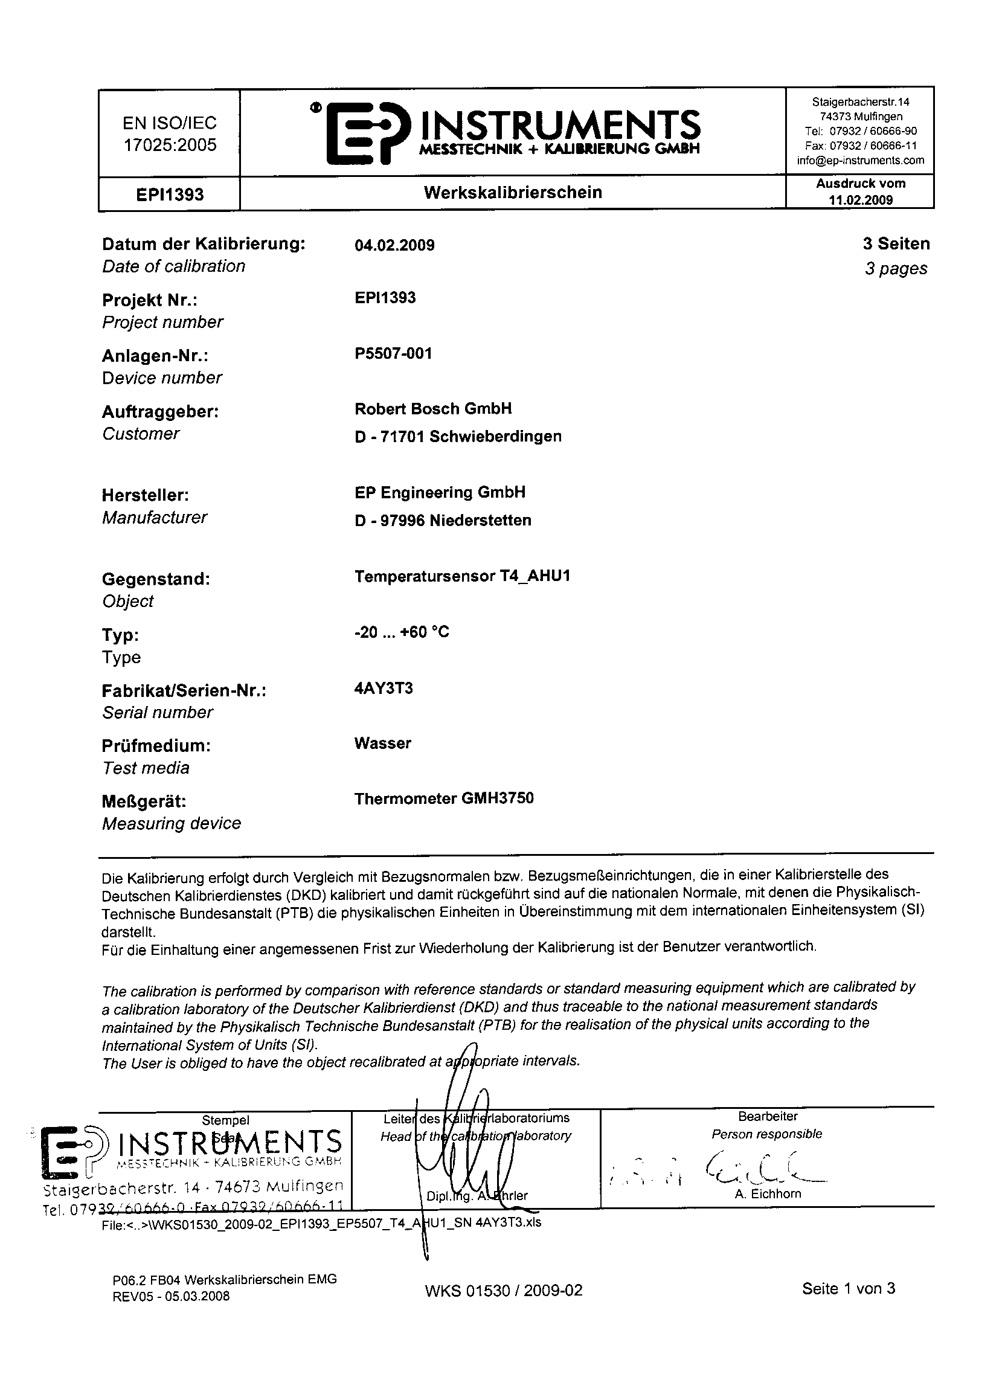
[picture p127: page 1]
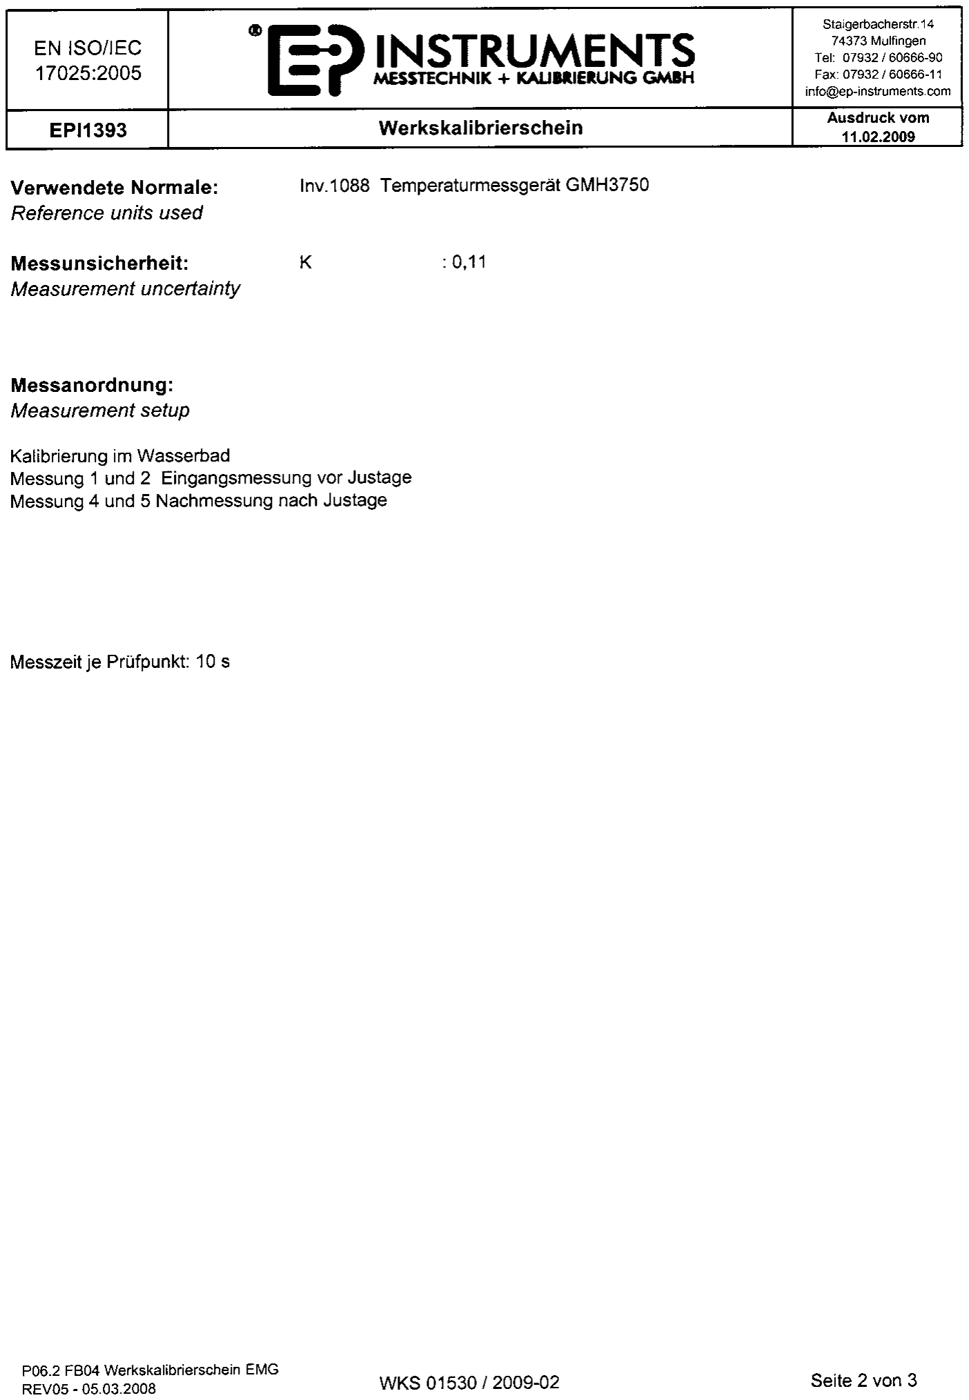
[picture p128: page 2]
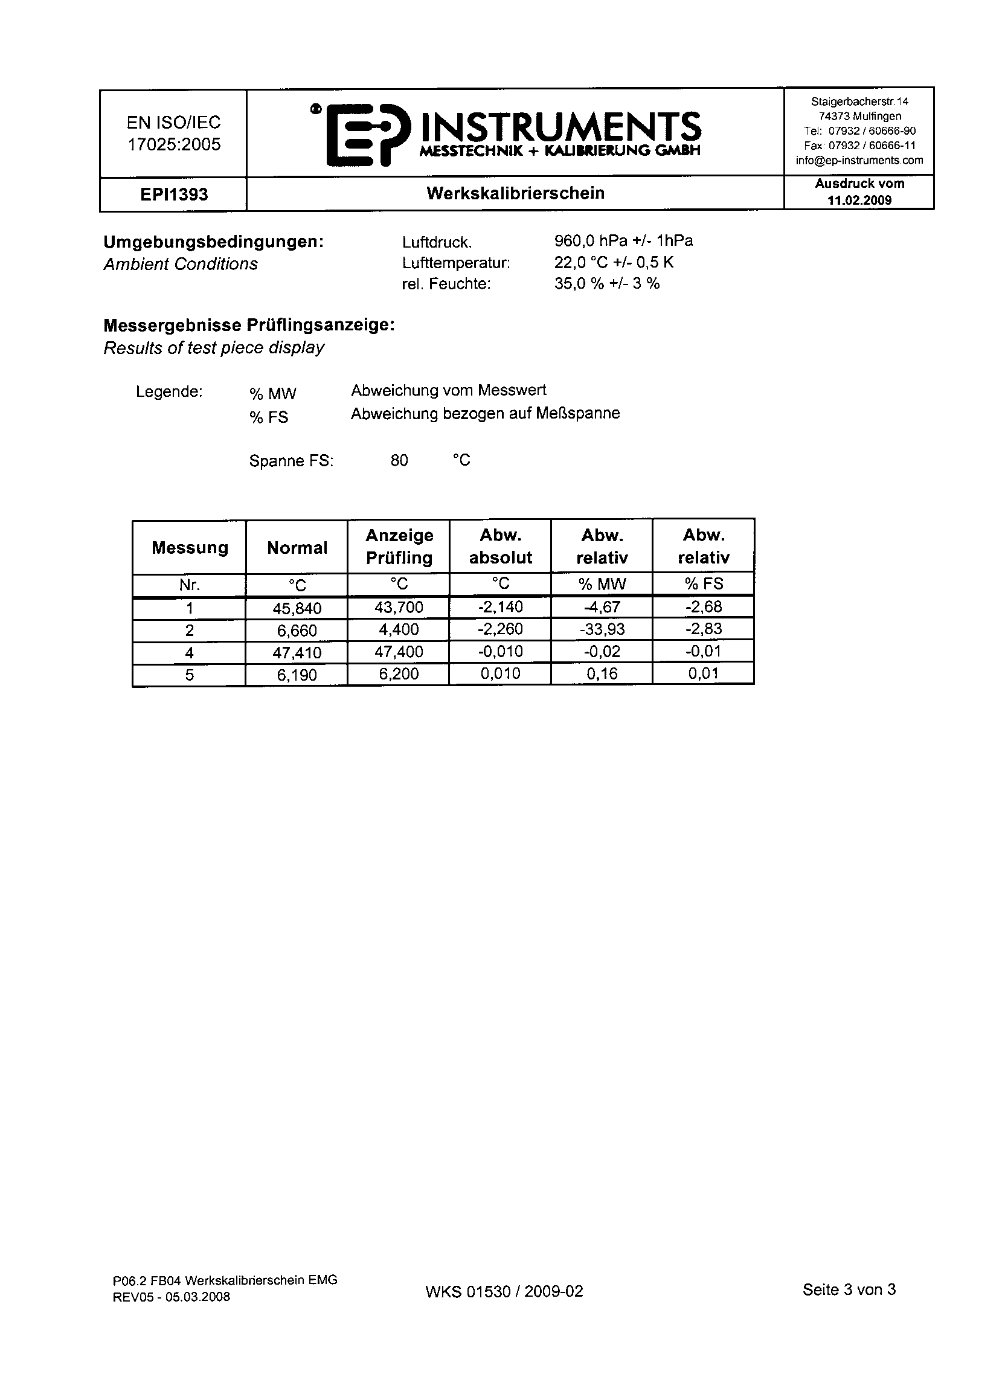
[picture p129: page 3]
