mho-jwi/MA/(B) Klimaprüfstand/Steuerung/P5507/Doku/Kalibrierung/WKS01531-2009-02_EPI1393_P5507-001_TemperatursensorT1_AHU1.pdf

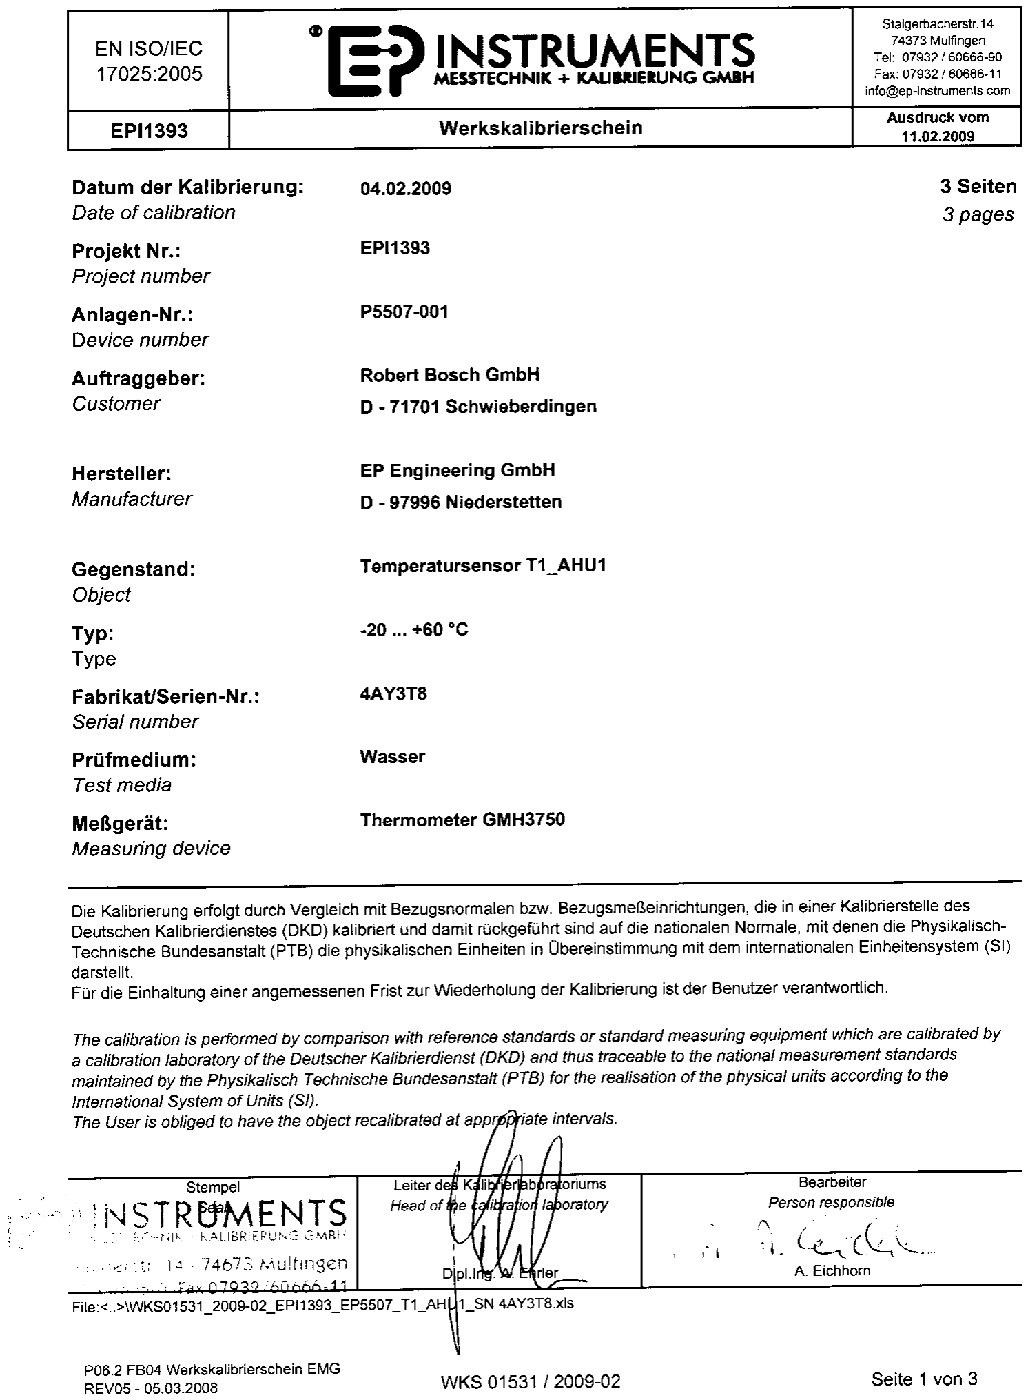
[picture p130: page 1]
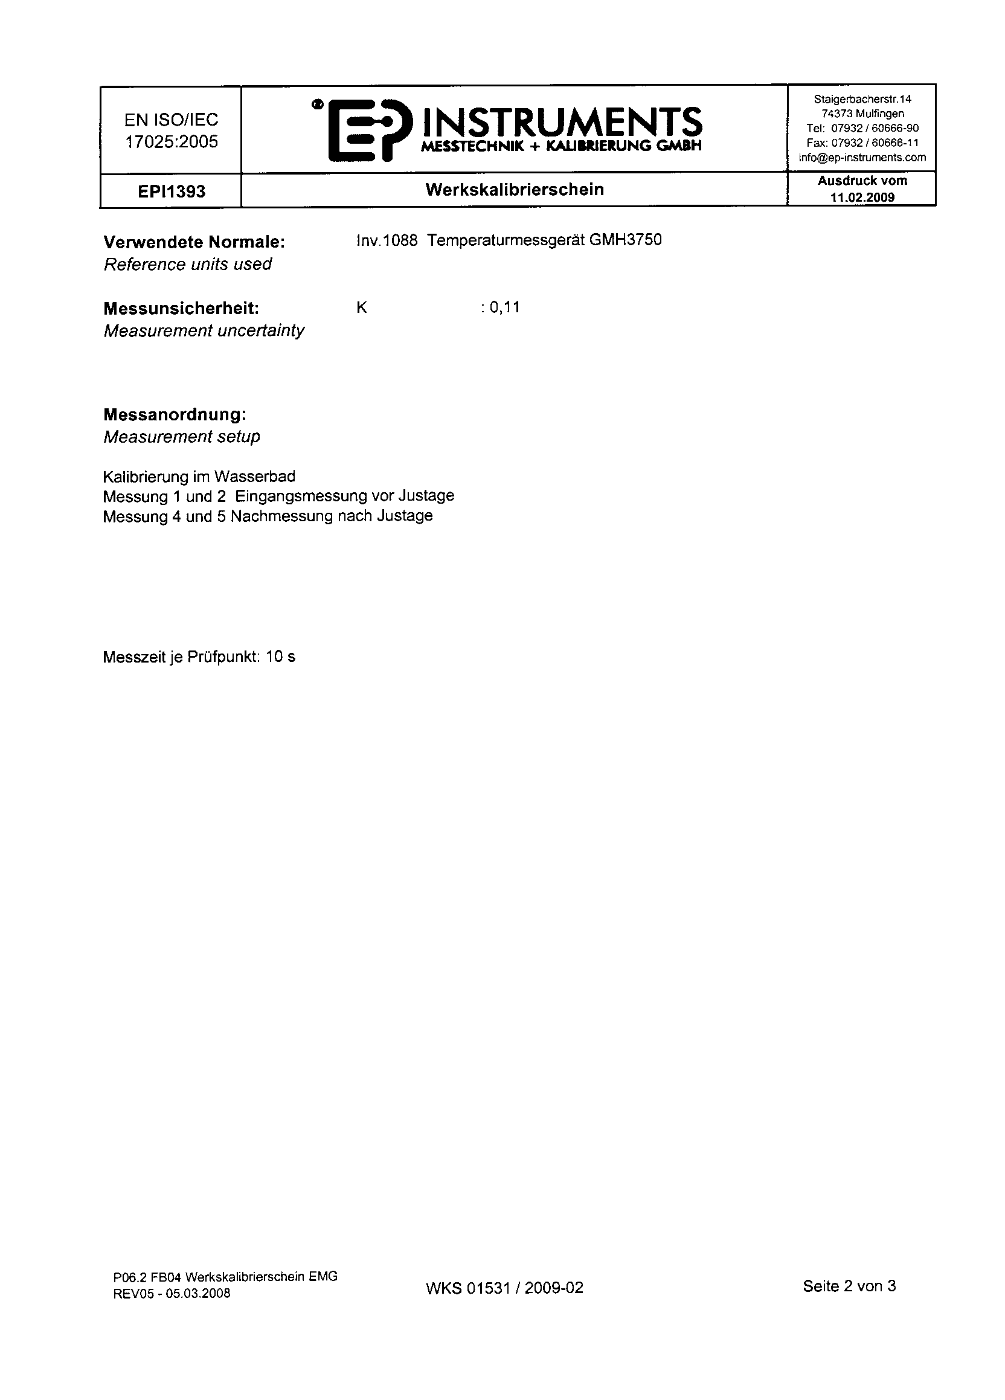
[picture p131: page 2]
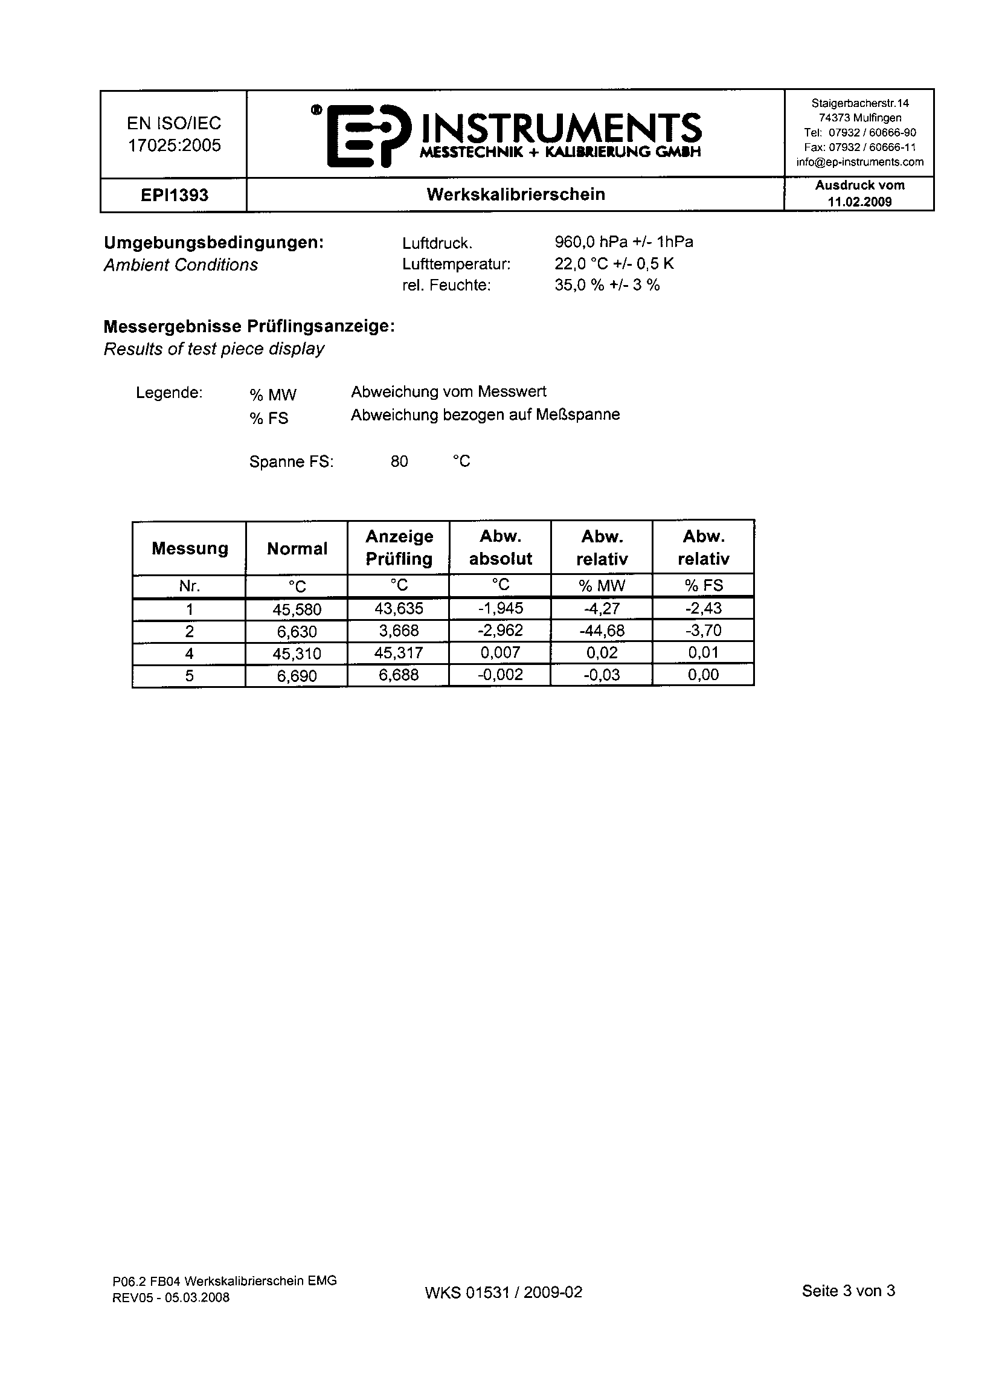
[picture p132: page 3]
