mho-jwi/MA/(B) Klimaprüfstand/Steuerung/P5507/Doku/Kalibrierung/WKS01532-2009-02_EPI1393_P5507-001_TemperatursensorT3_AHU2.pdf

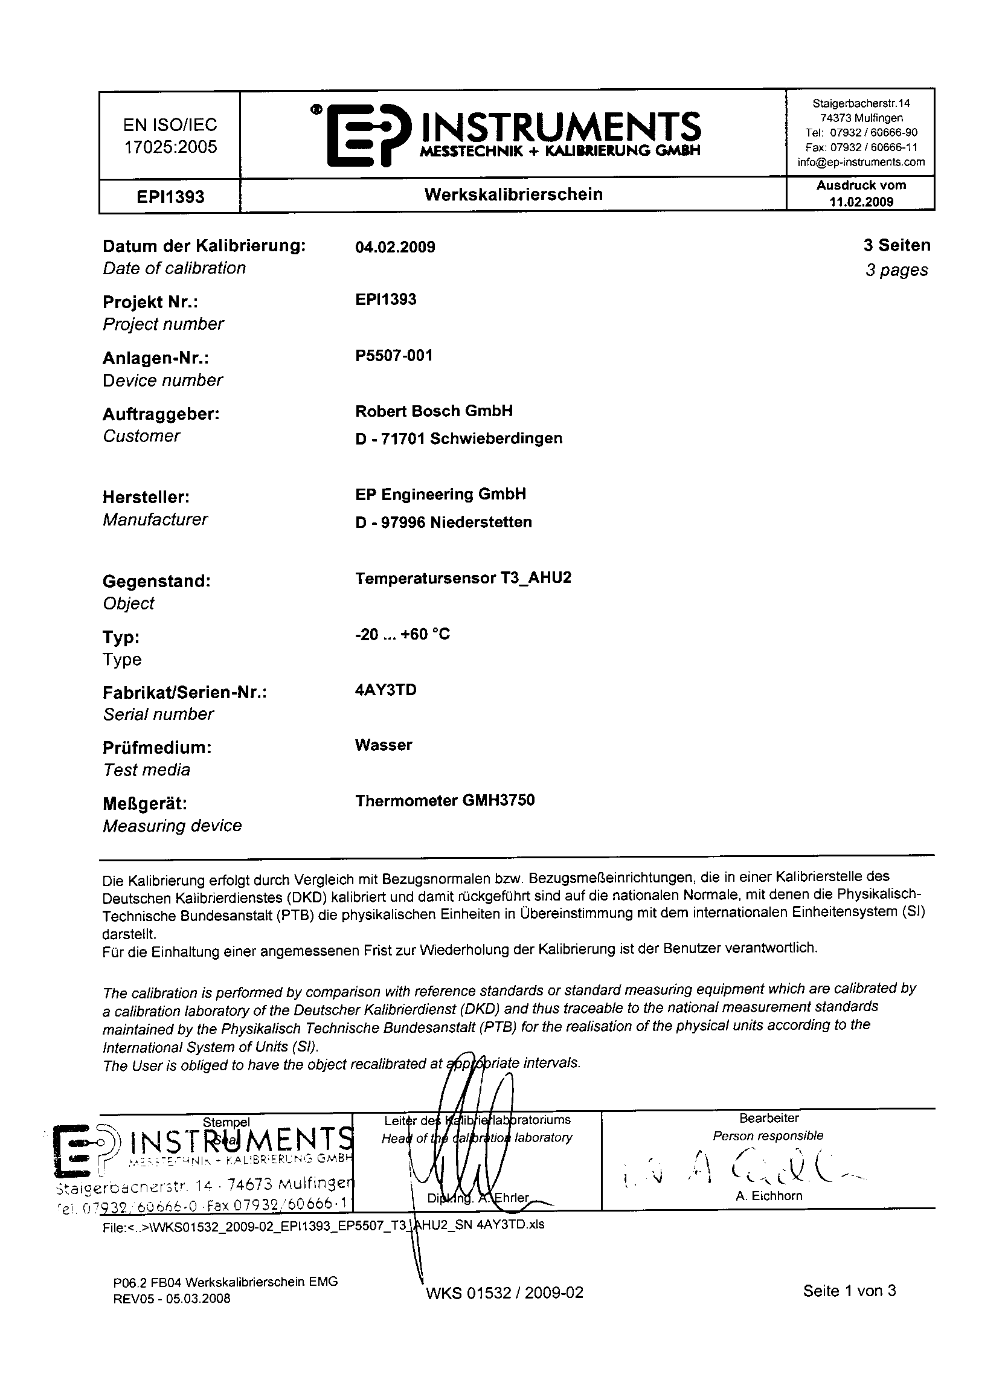
[picture p133: page 1]
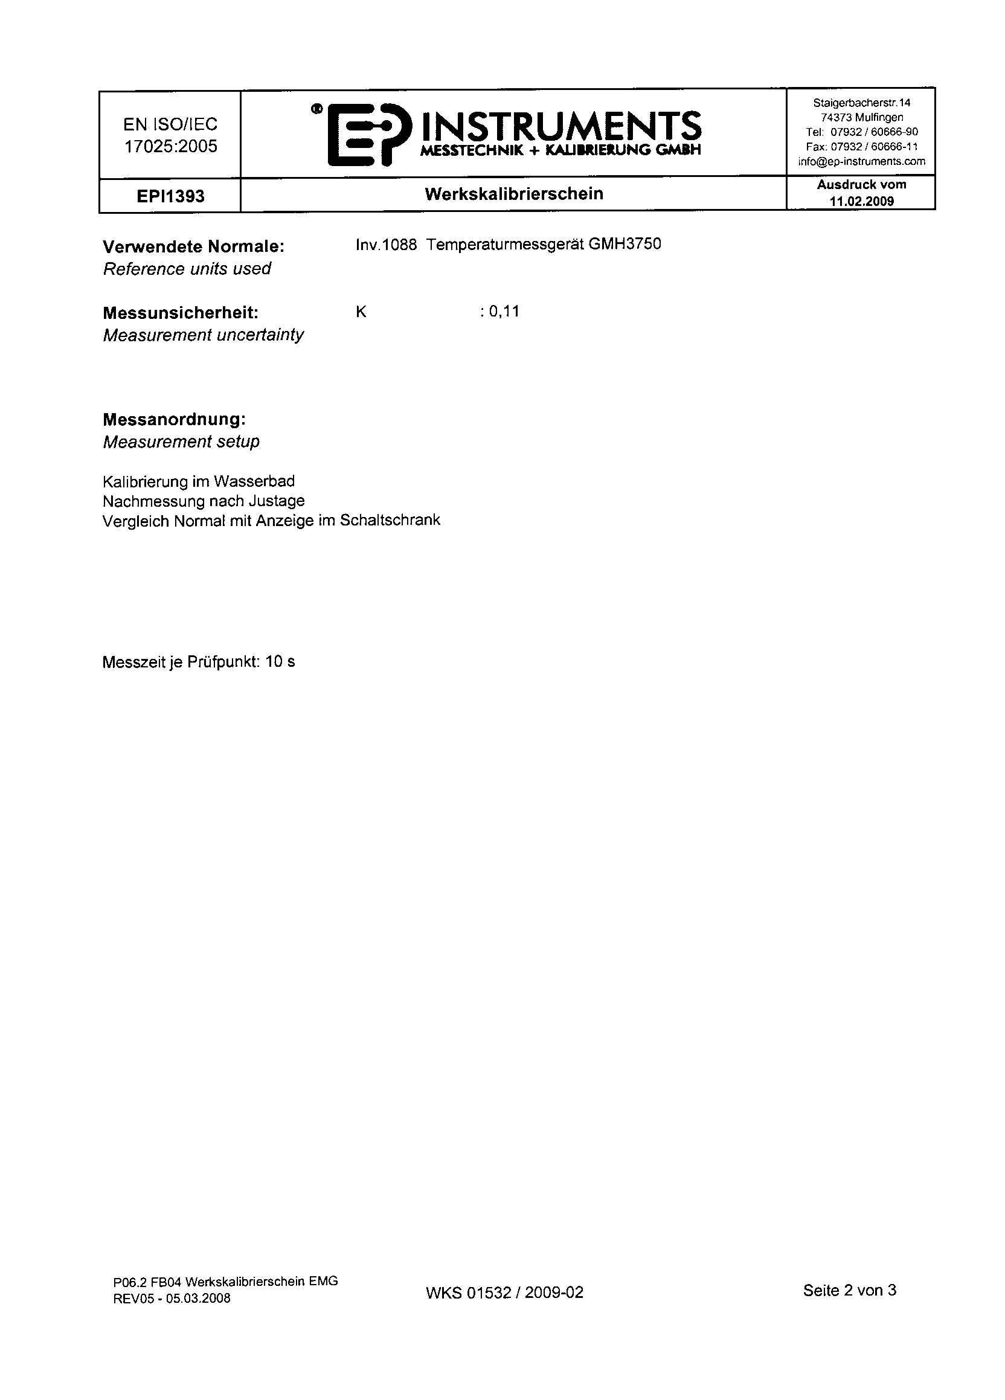
[picture p134: page 2]
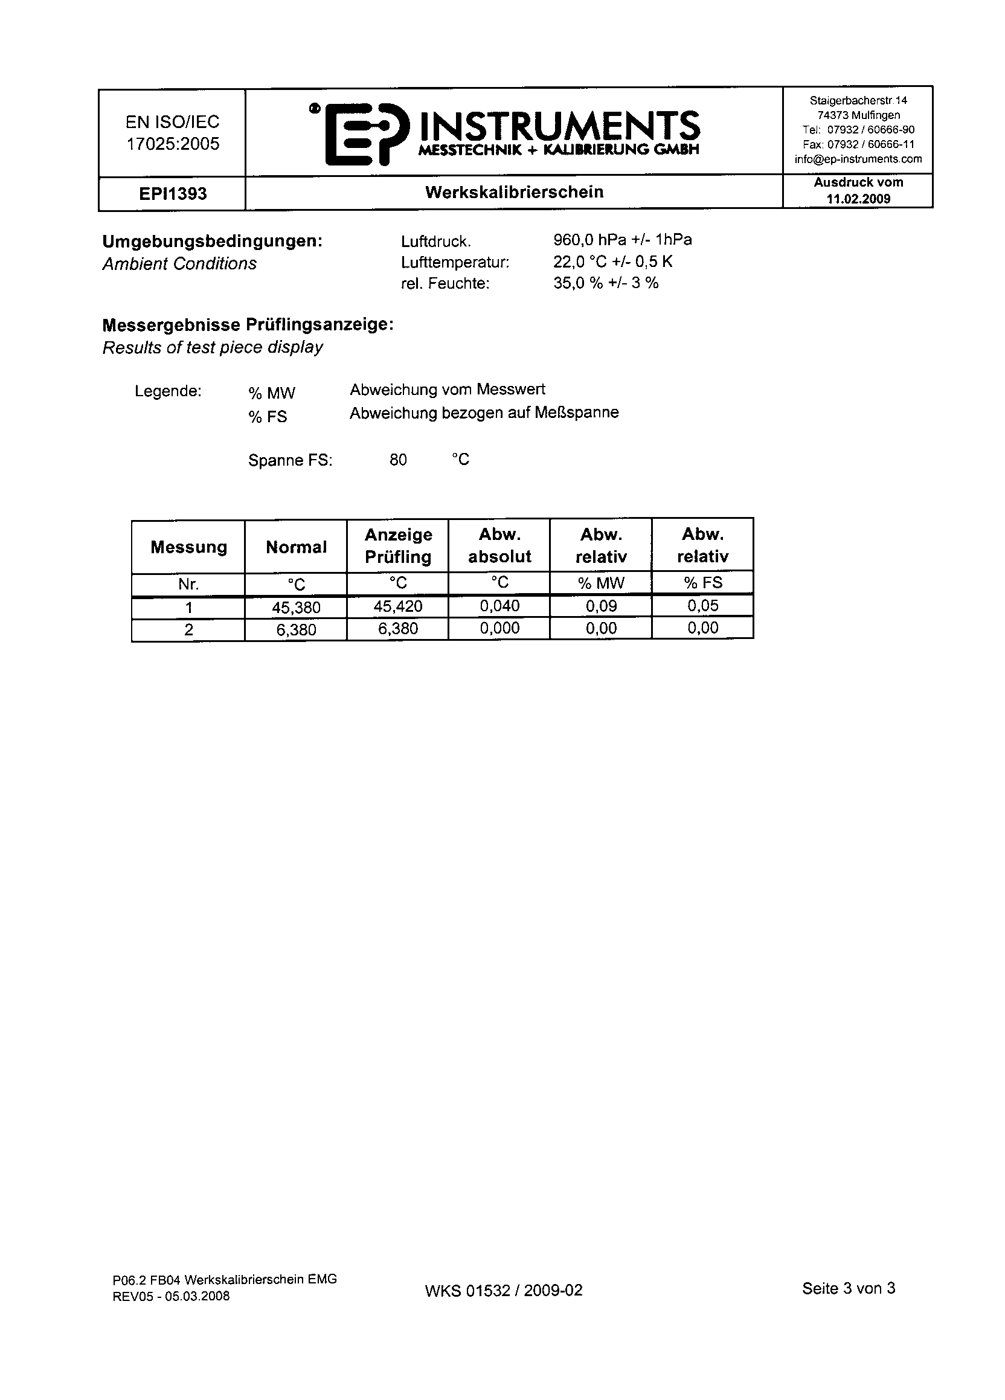
[picture p135: page 3]
