mho-jwi/MA/(B) Klimaprüfstand/Steuerung/P5507/Doku/Kalibrierung/WKS01533-2009-02_EPI1393_P5507-001_TemperatursensorT3_AHU1.pdf

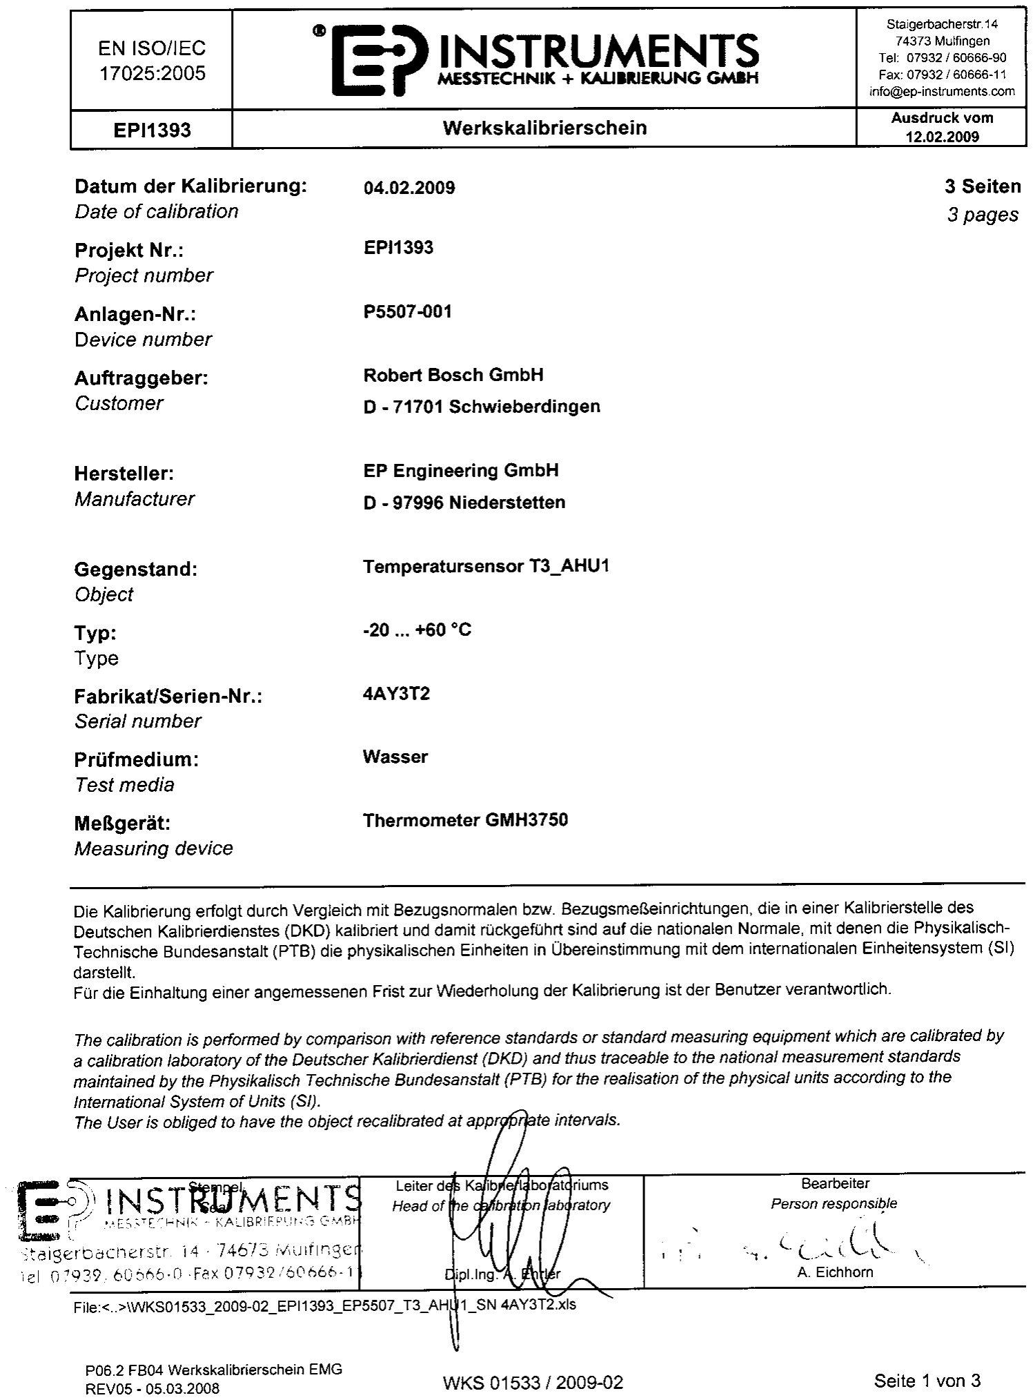
[picture p136: page 1]
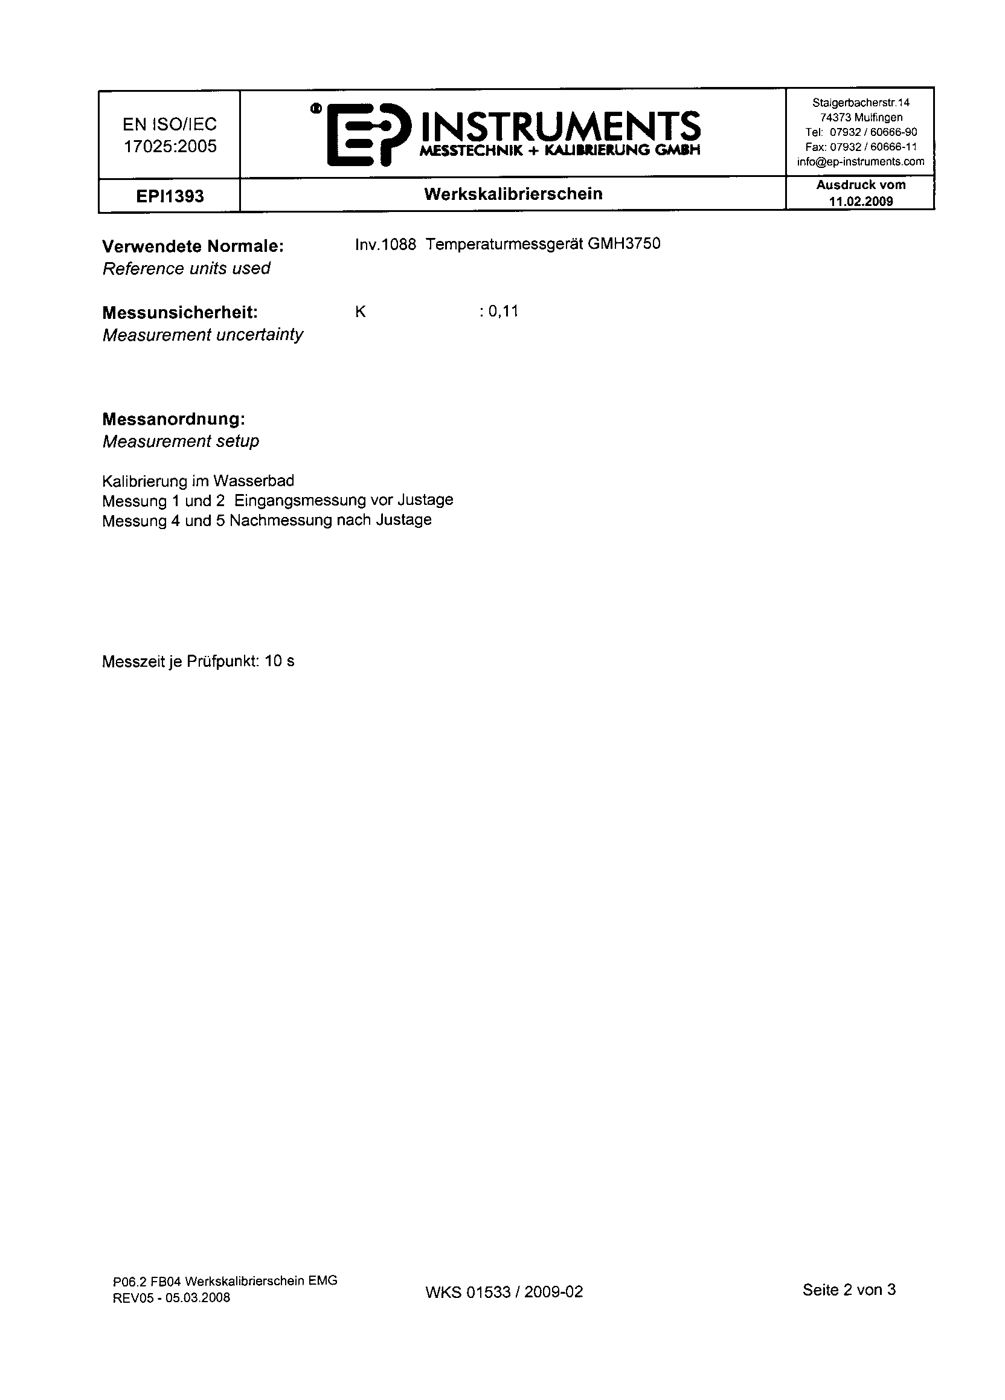
[picture p137: page 2]
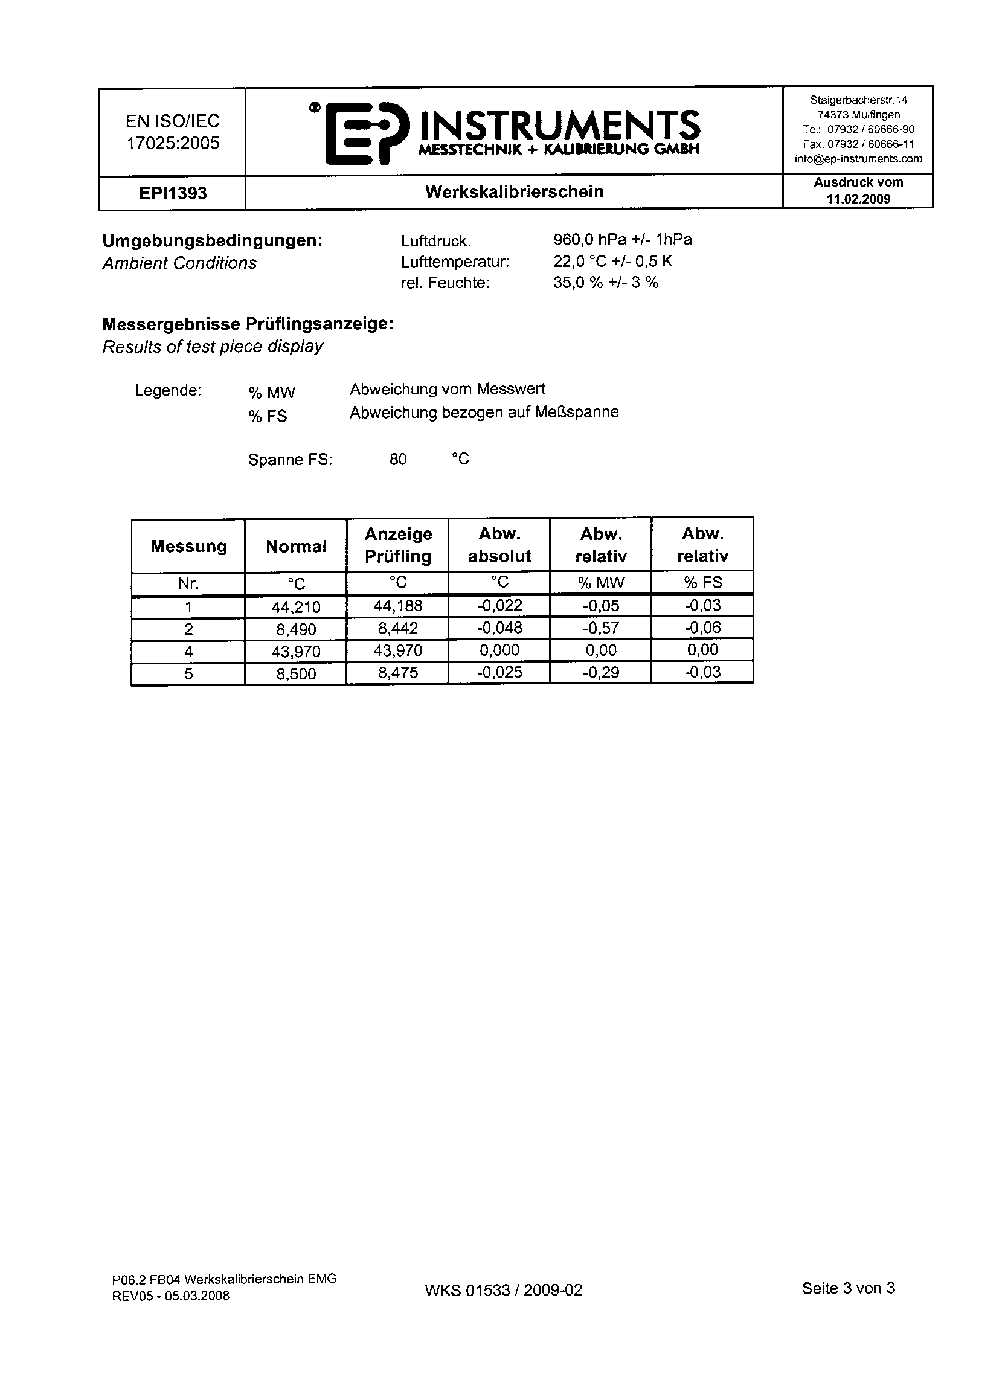
[picture p138: page 3]
