mho-jwi/MA/(B) Klimaprüfstand/Steuerung/P5507/Doku/Kalibrierung/WKS01534-2009-02_EPI1393_P5507-001_TempratursensorT2_AHU1.pdf

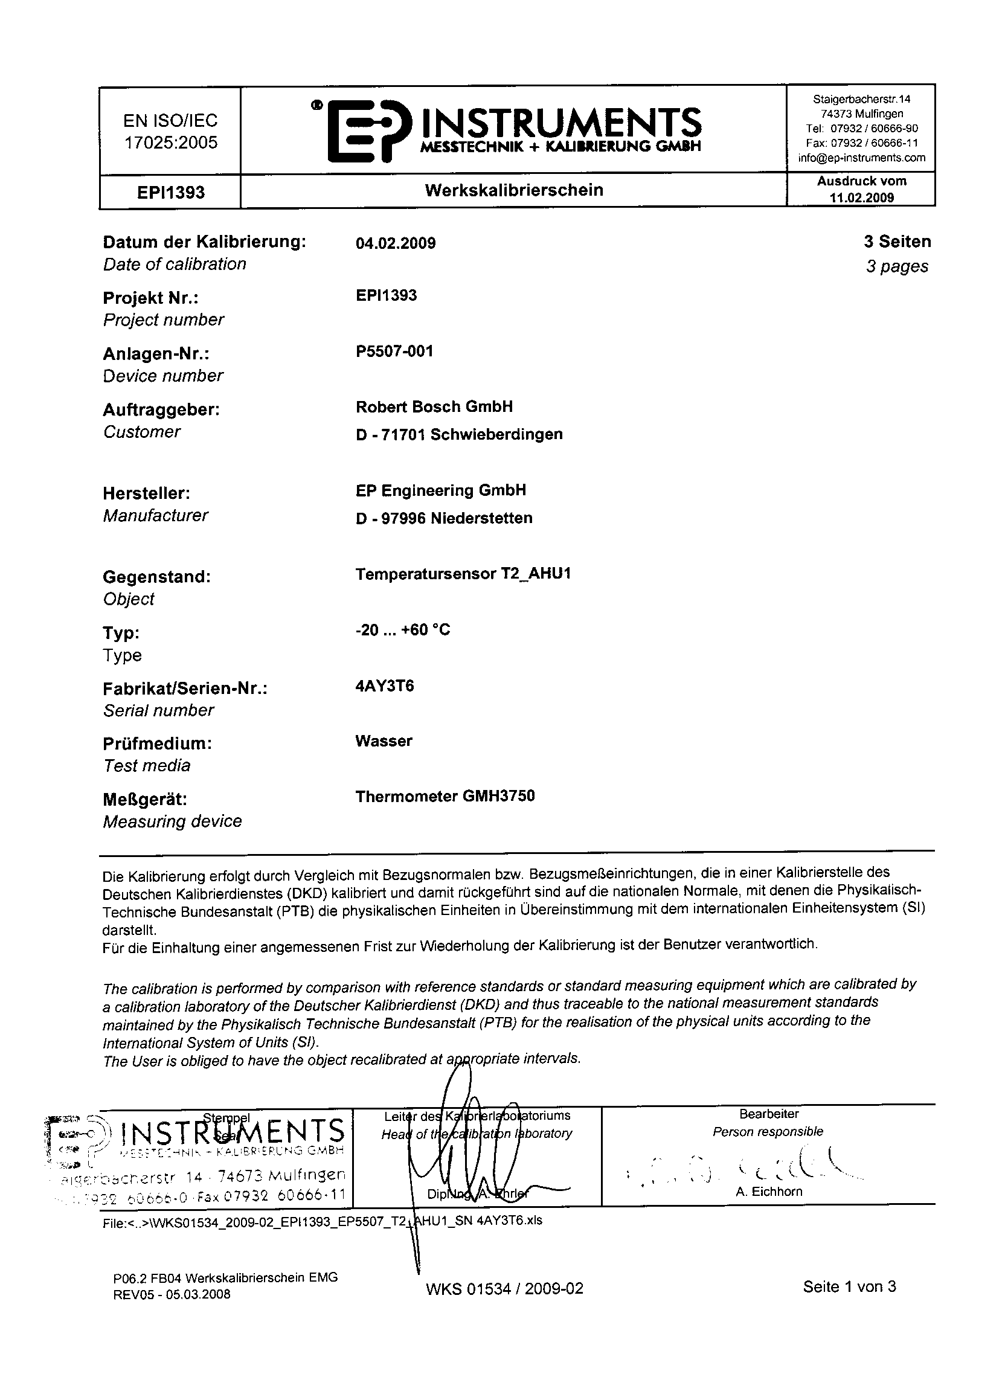
[picture p139: page 1]
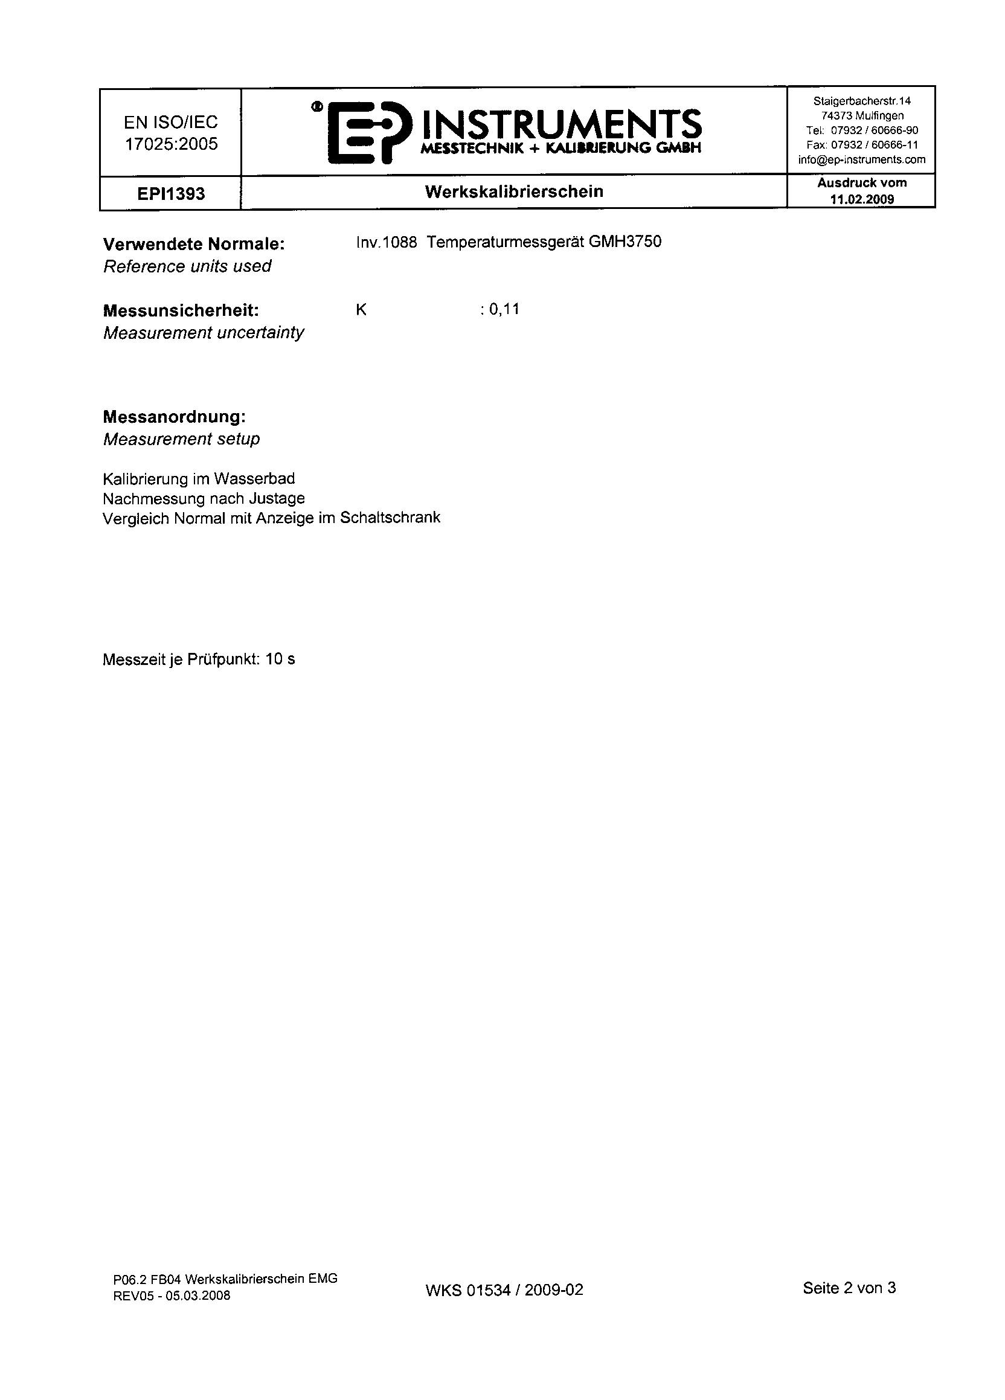
[picture p140: page 2]
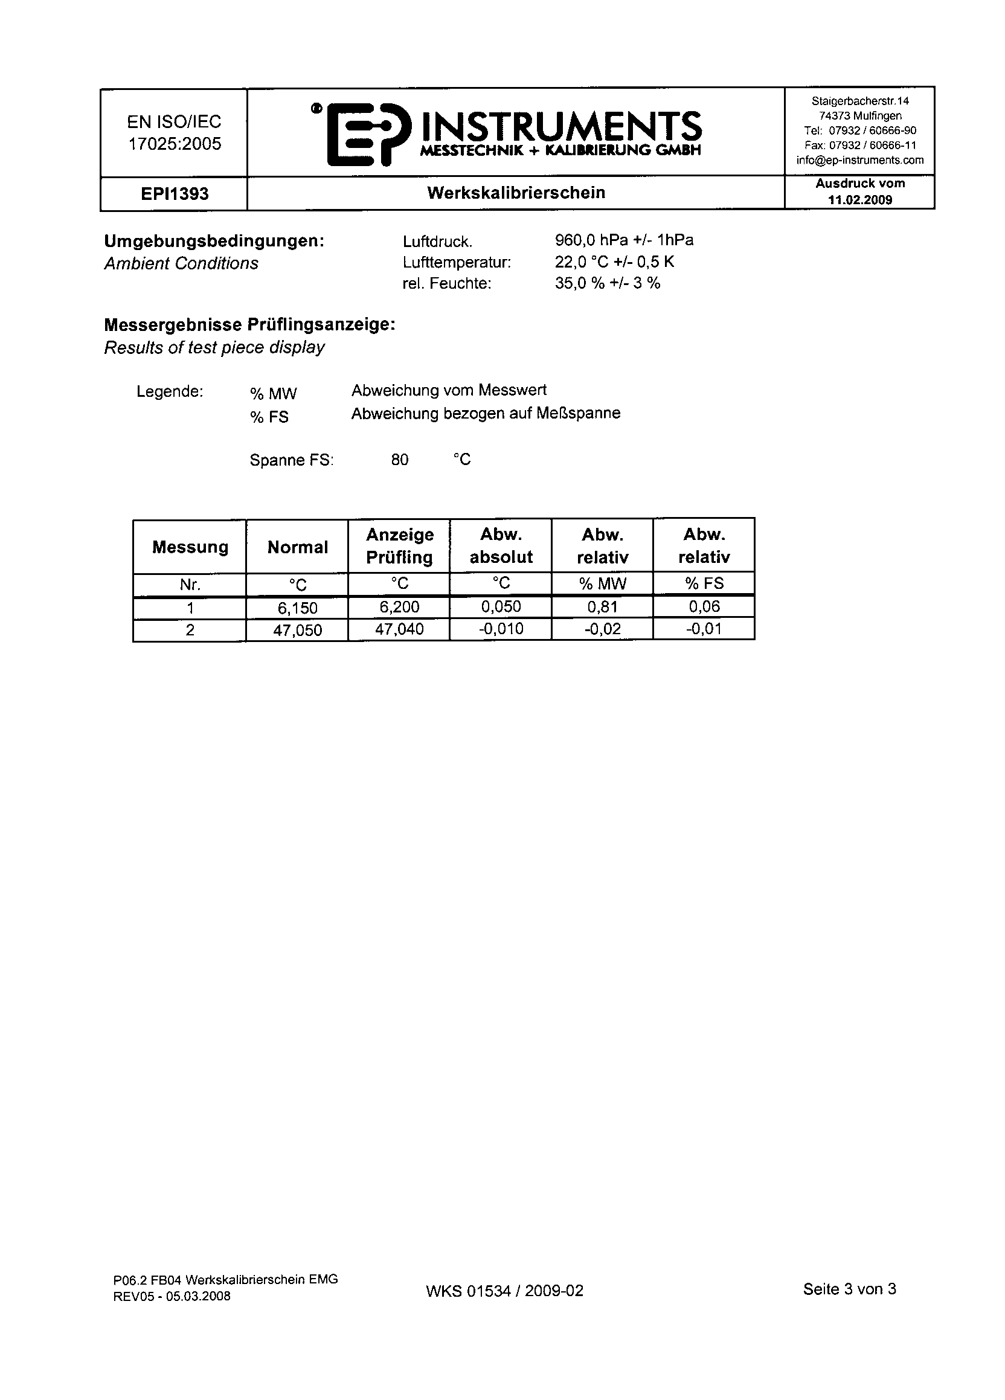
[picture p141: page 3]
