mho-jwi/MA/(B) Klimaprüfstand/Steuerung/P5507/Doku/Kalibrierung/WKS01535-2009-02_EPI1393_P5507-001_TemperatursensorT4_AHU2.pdf

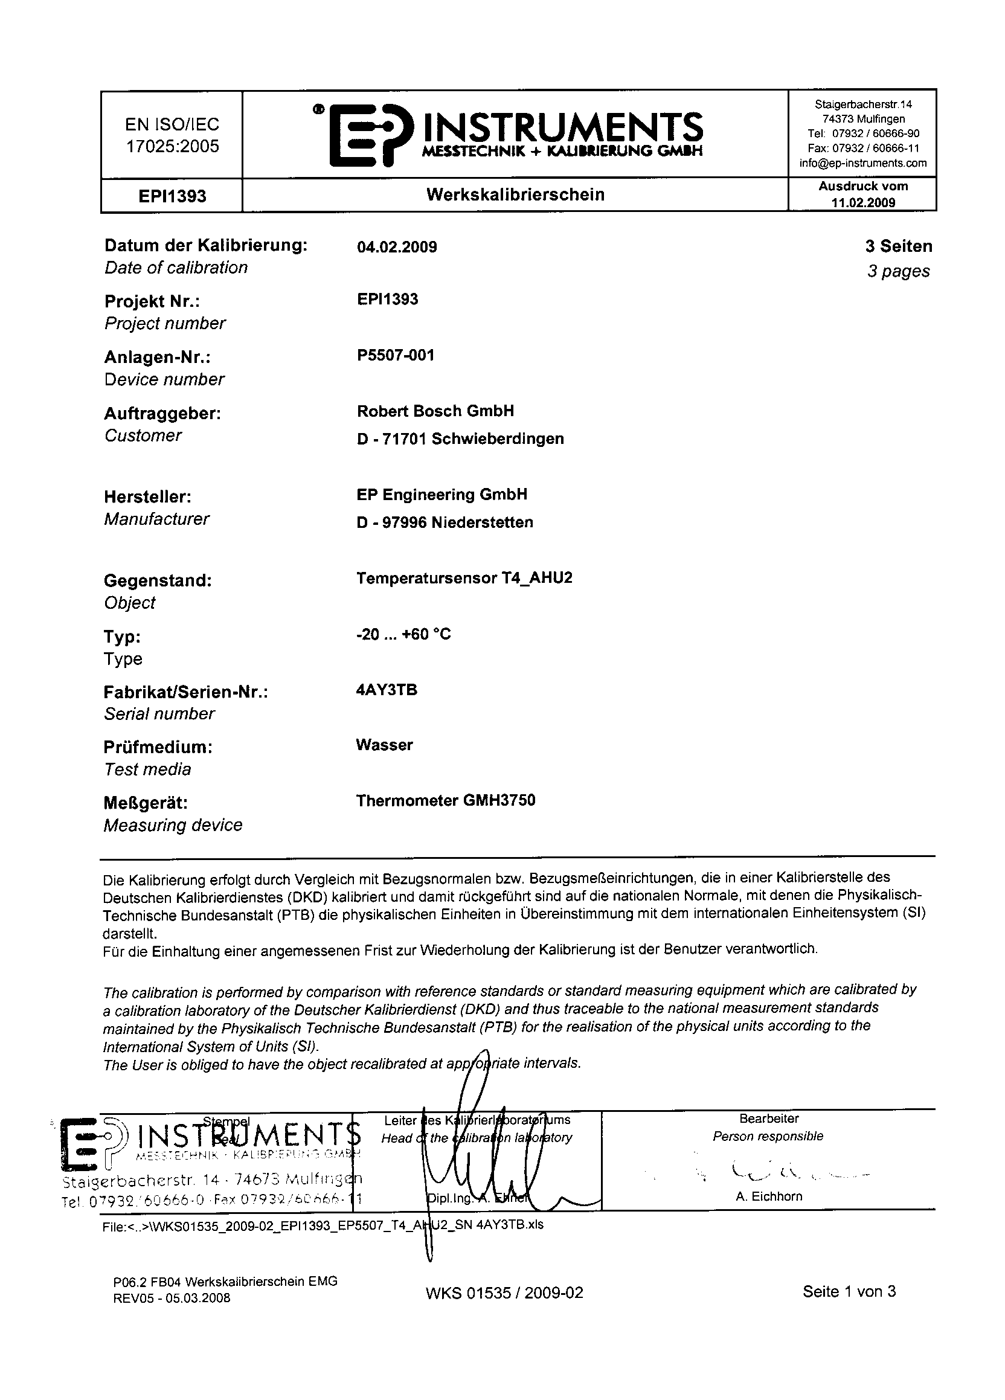
[picture p142: page 1]
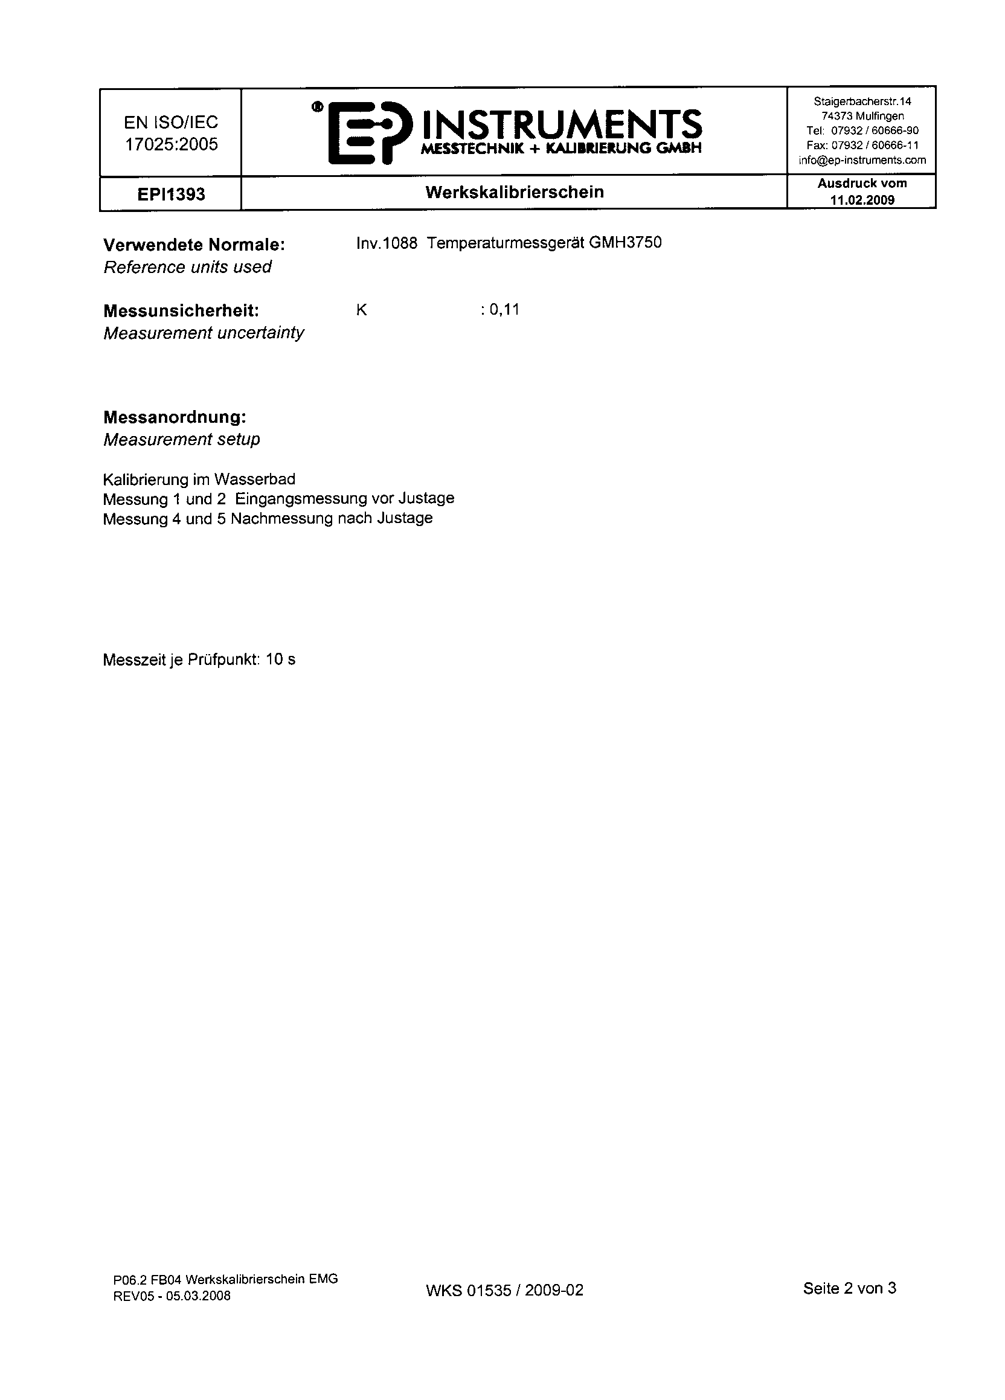
[picture p143: page 2]
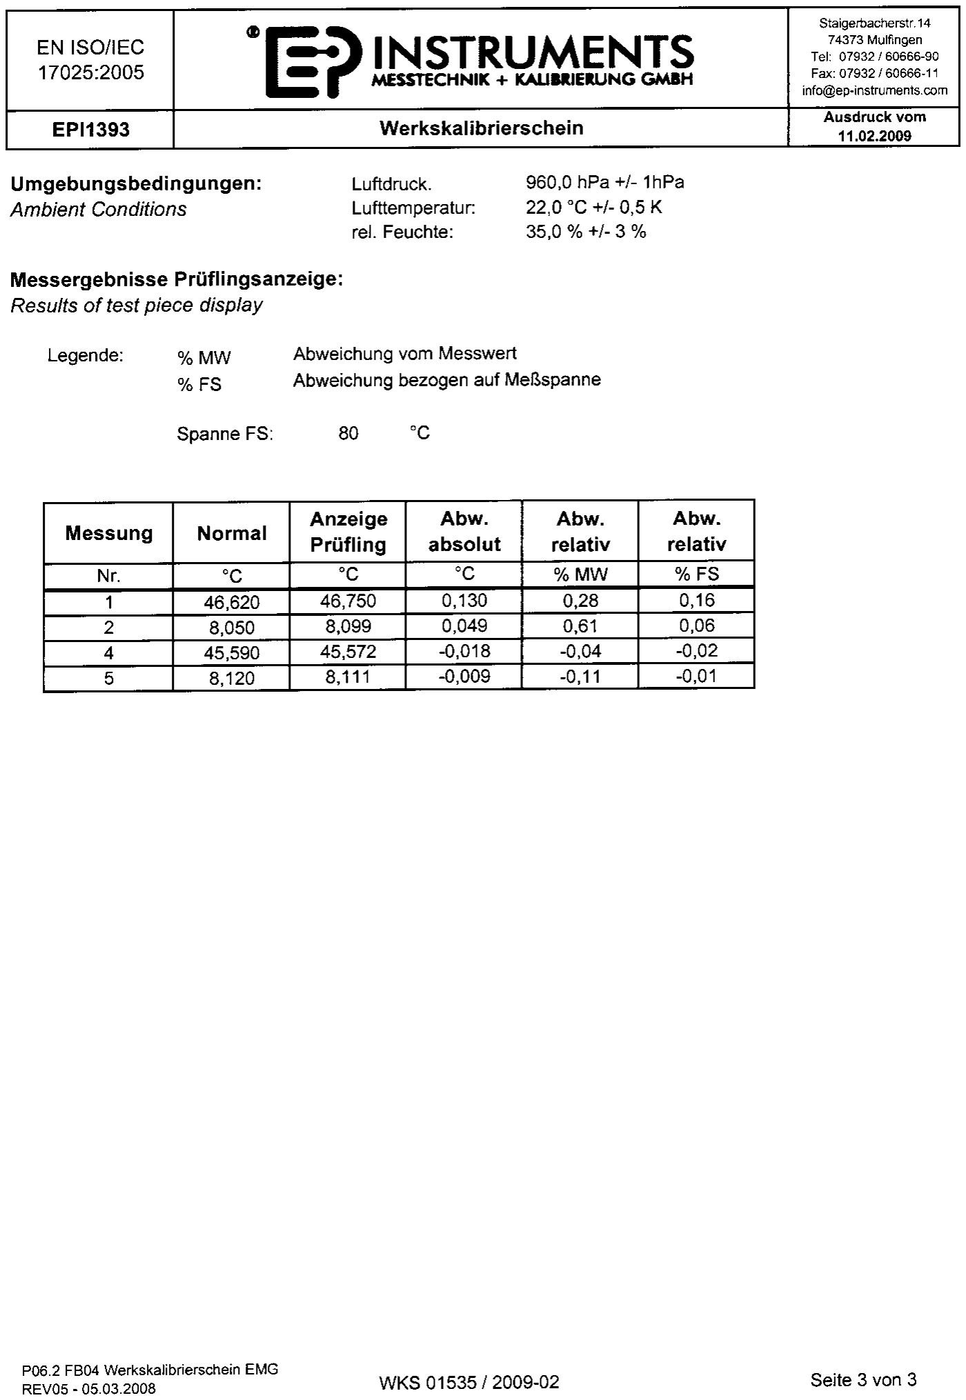
[picture p144: page 3]
