mho-jwi/MA/(B) Klimaprüfstand/Steuerung/P5507/Doku/Kalibrierung/WKS01536-2009-02_EPI1393_P5507-001_TemperatursensorT1_AHU2.pdf

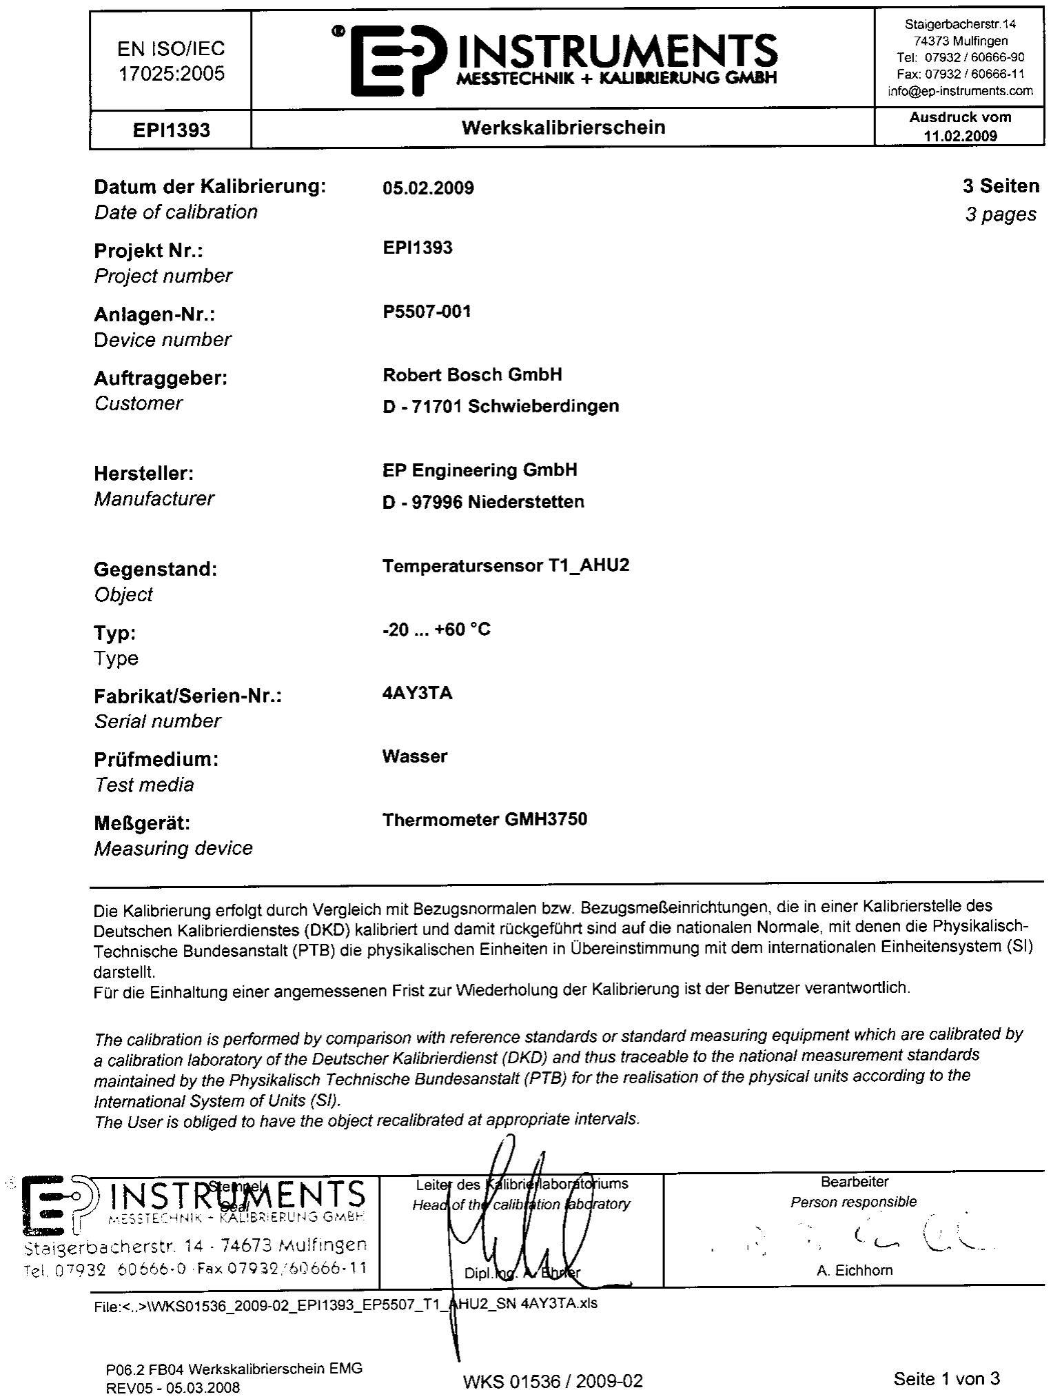
[picture p145: page 1]
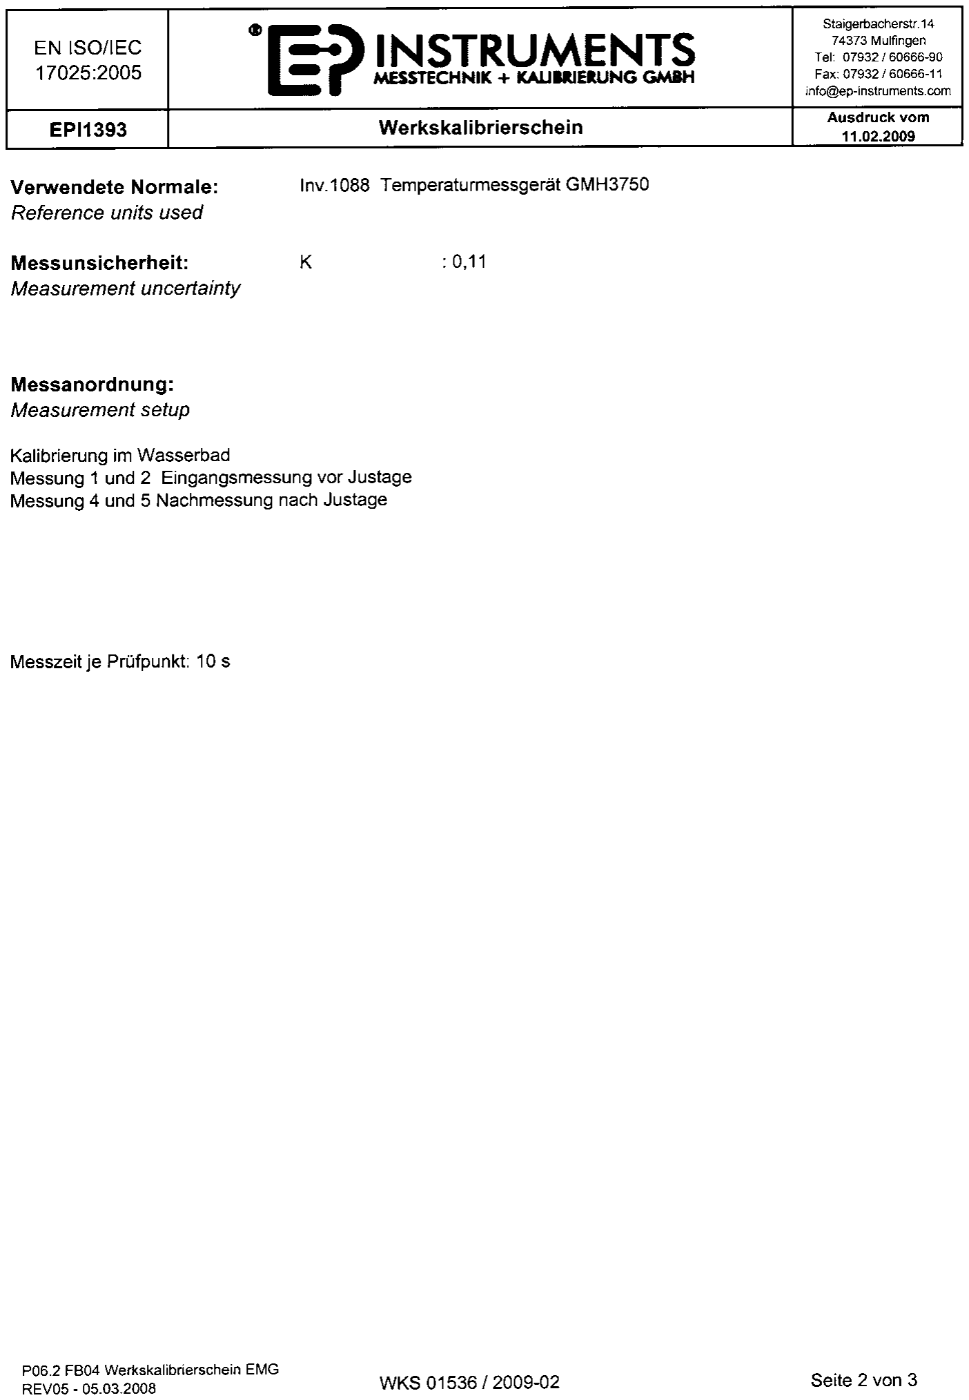
[picture p146: page 2]
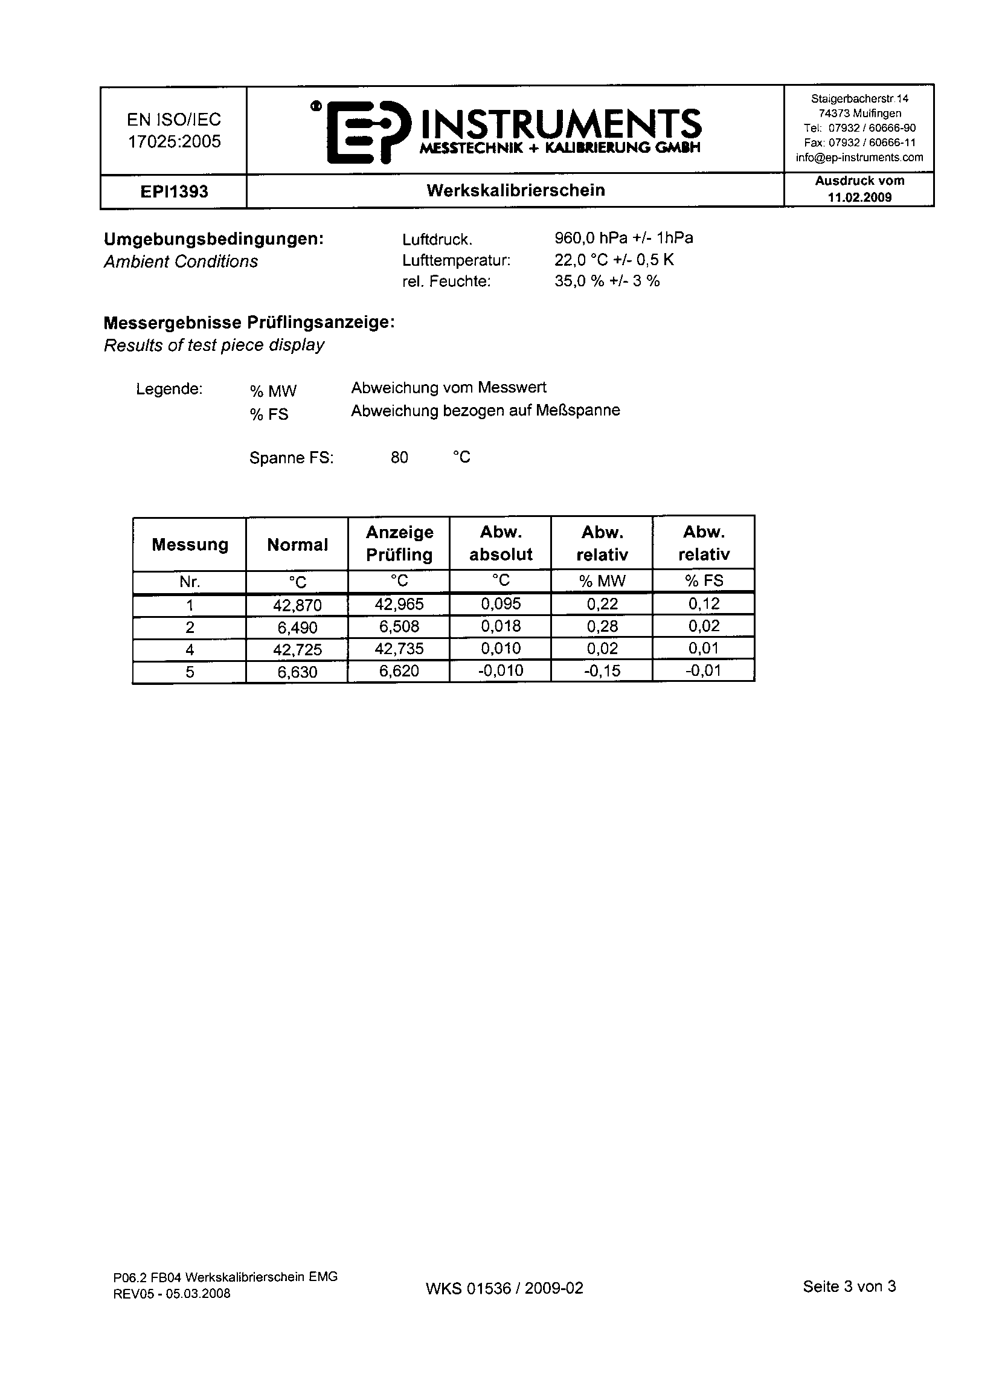
[picture p147: page 3]
