mho-jwi/MA/(B) Klimaprüfstand/Steuerung/P5507/Doku/Kalibrierung/WKS01537-2009-02_EPI1393_P5507-001_TemperatursensorT2_AHU2.pdf

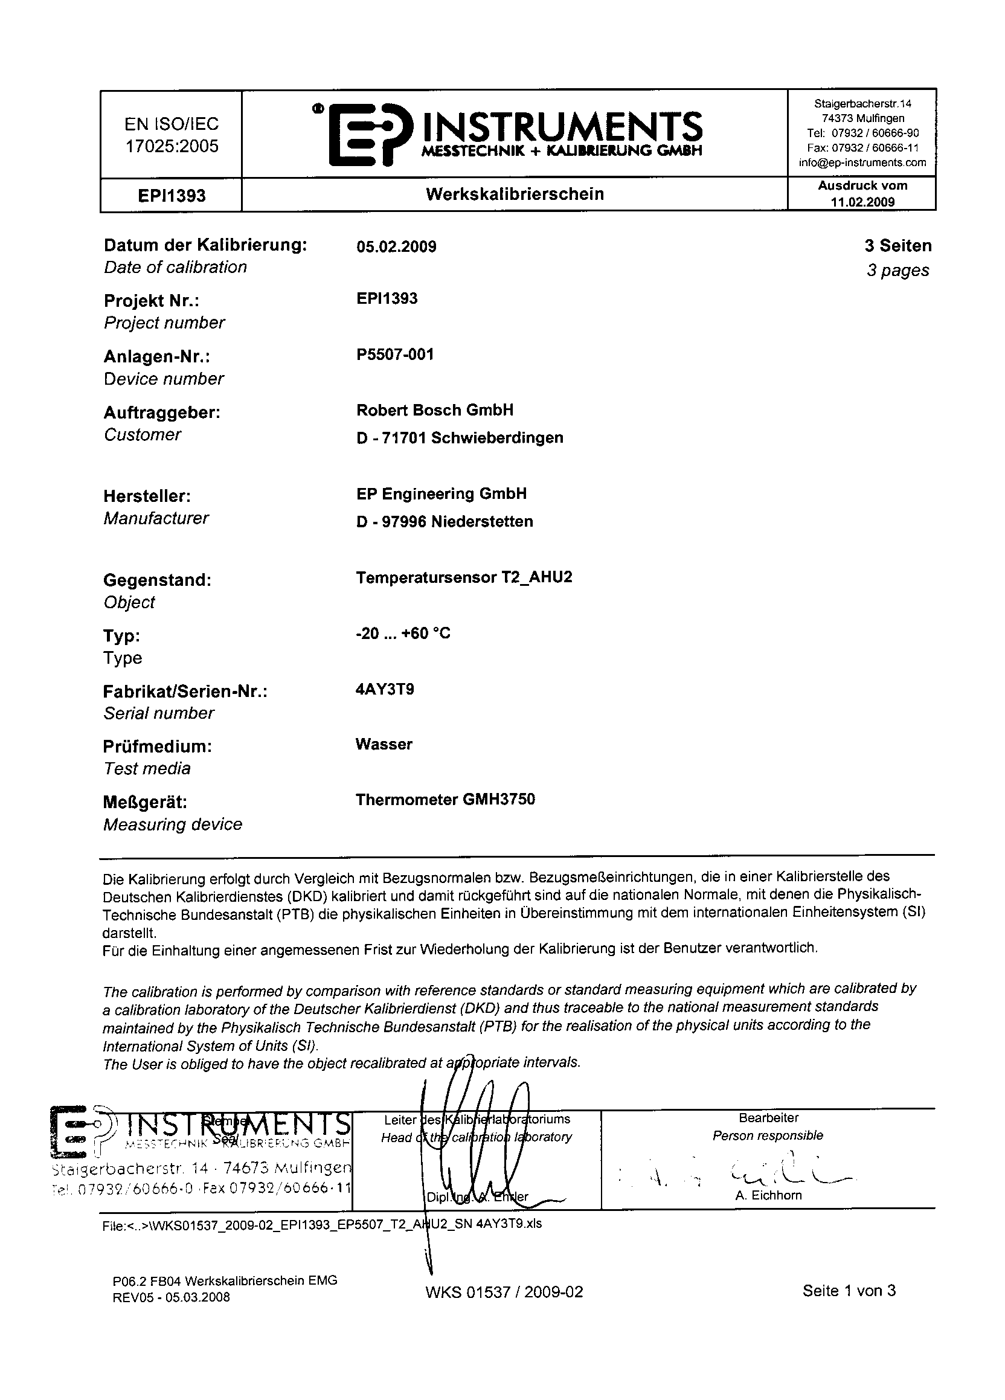
[picture p148: page 1]
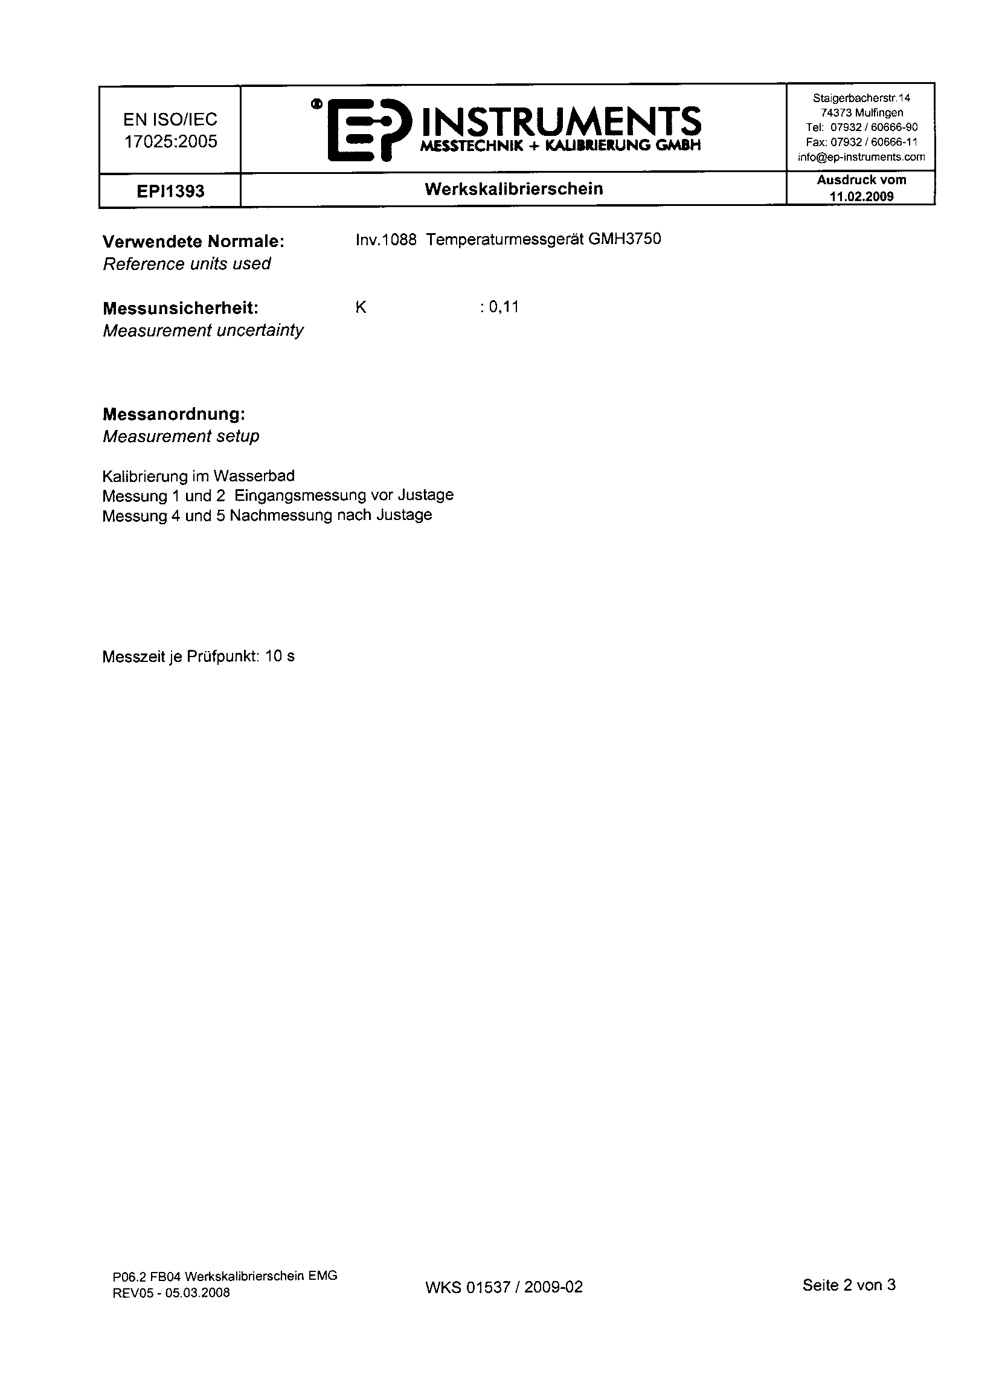
[picture p149: page 2]
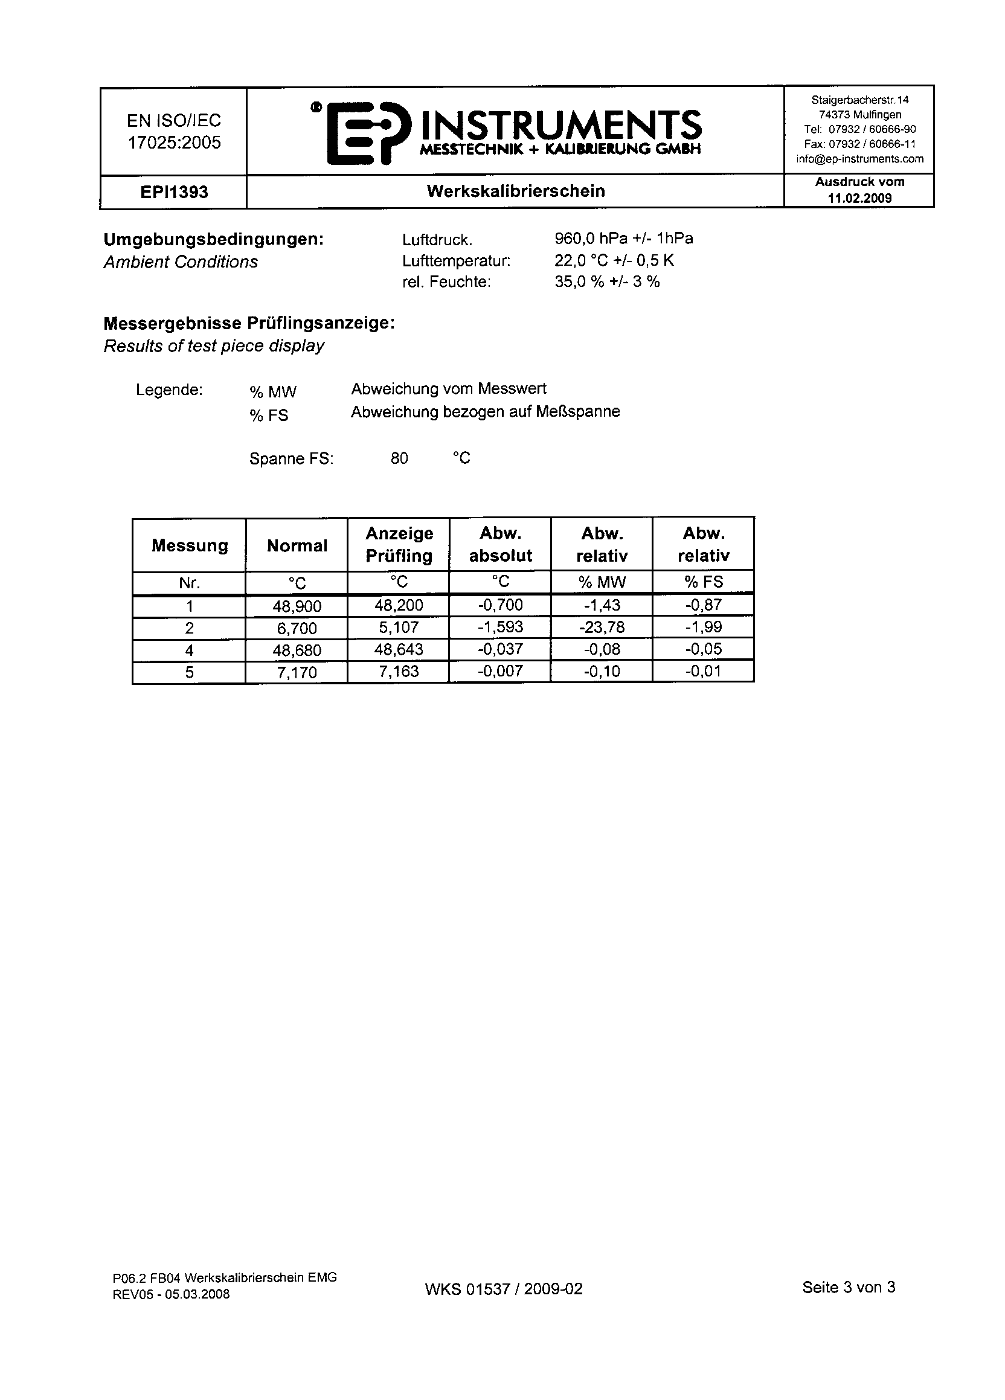
[picture p150: page 3]
