mho-jwi/MA/(B) Klimaprüfstand/Steuerung/P5507/Doku/Kalibrierung/WKS01538-2009-02_EPI1393_P5507-001_TemperatursensorT_TPA1.pdf

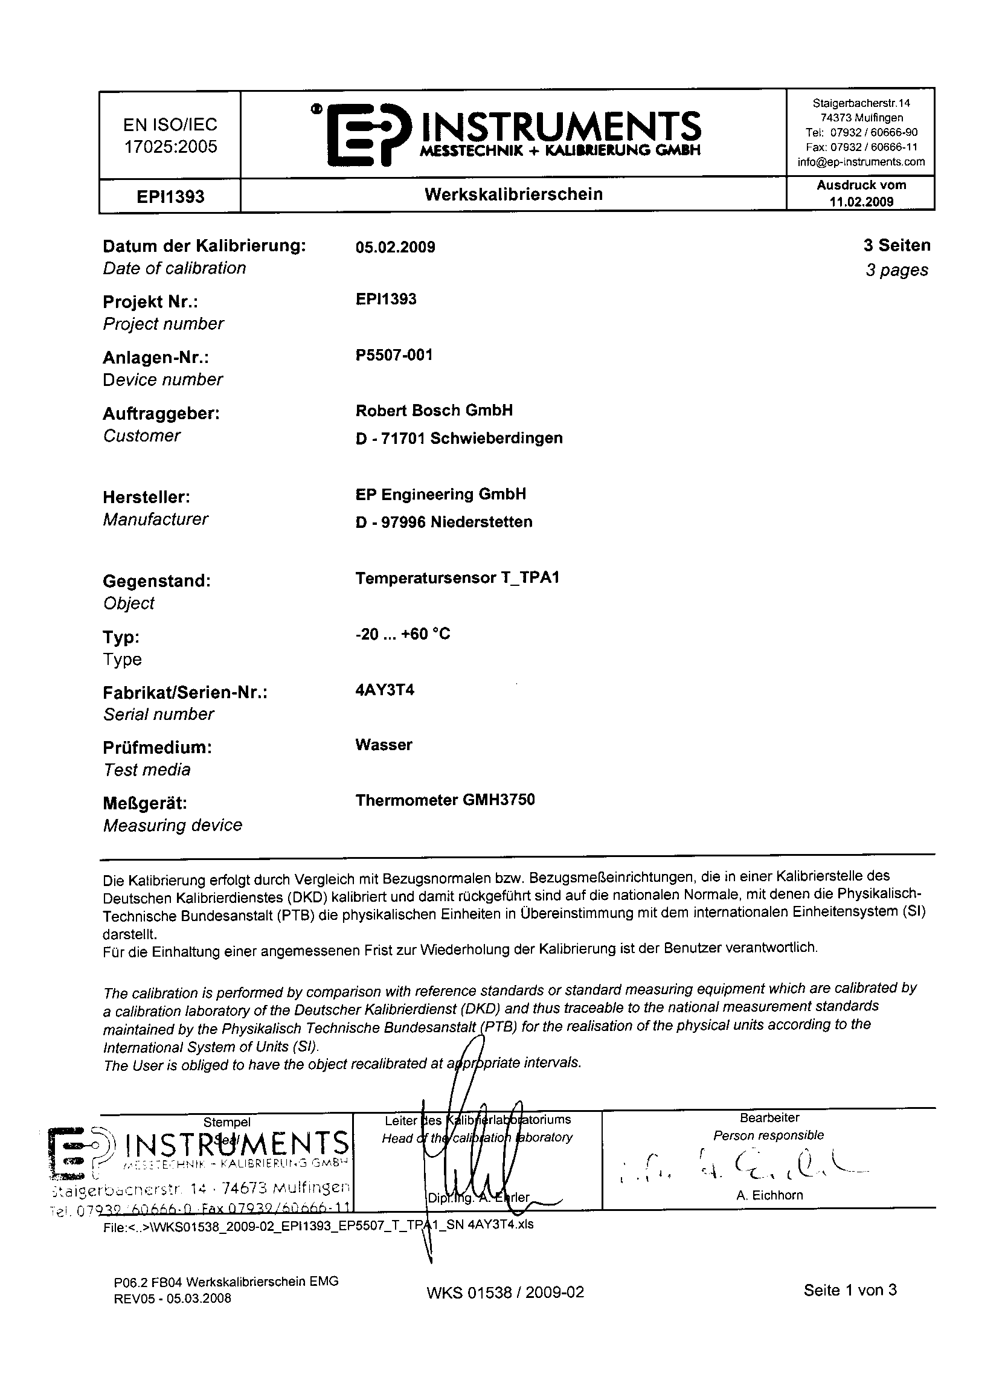
[picture p151: page 1]
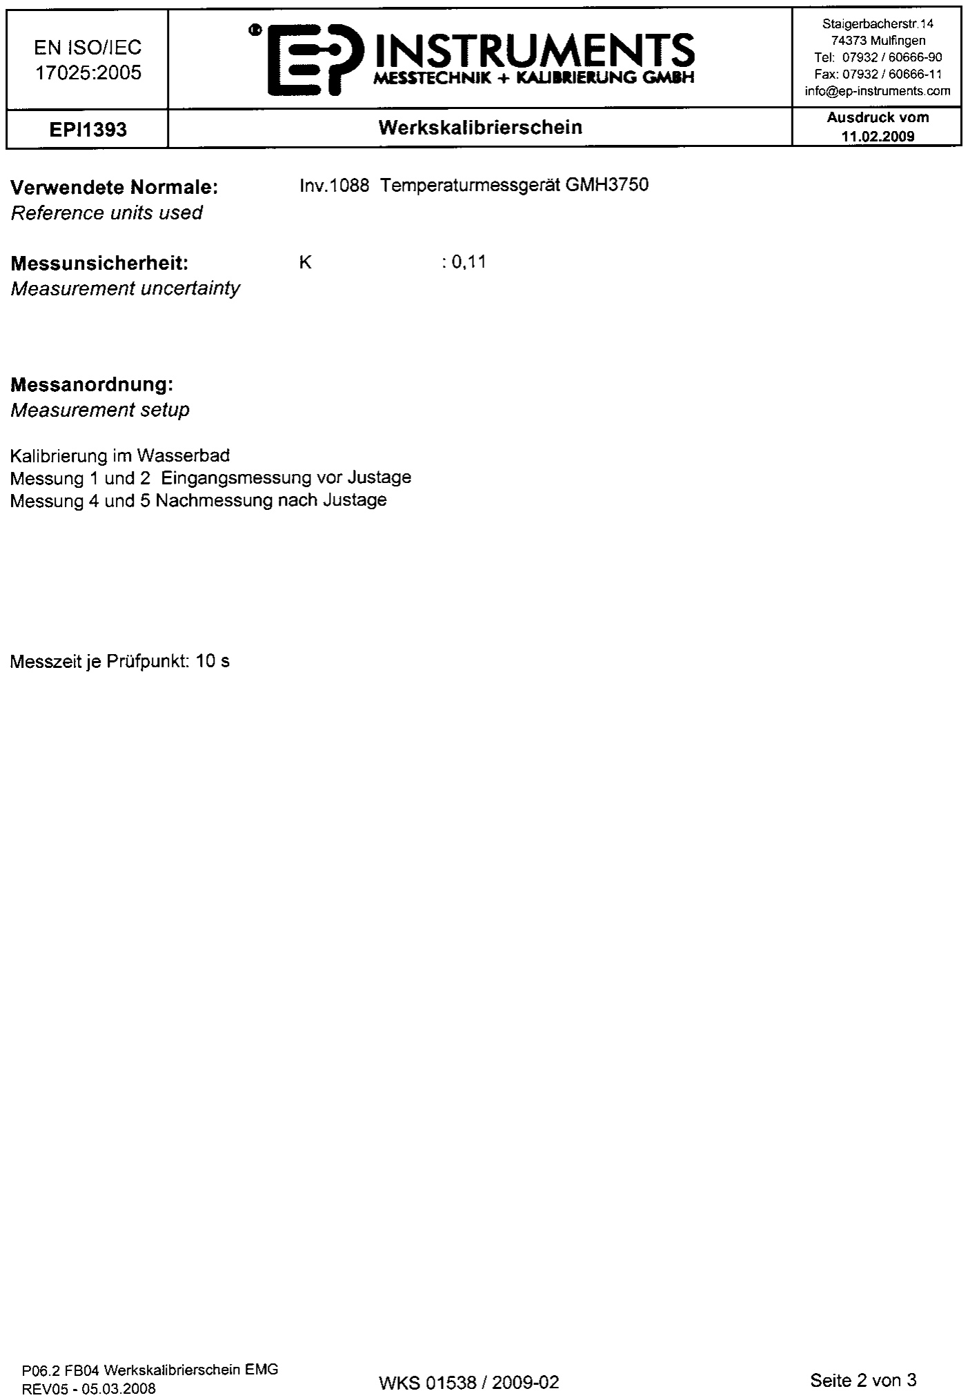
[picture p152: page 2]
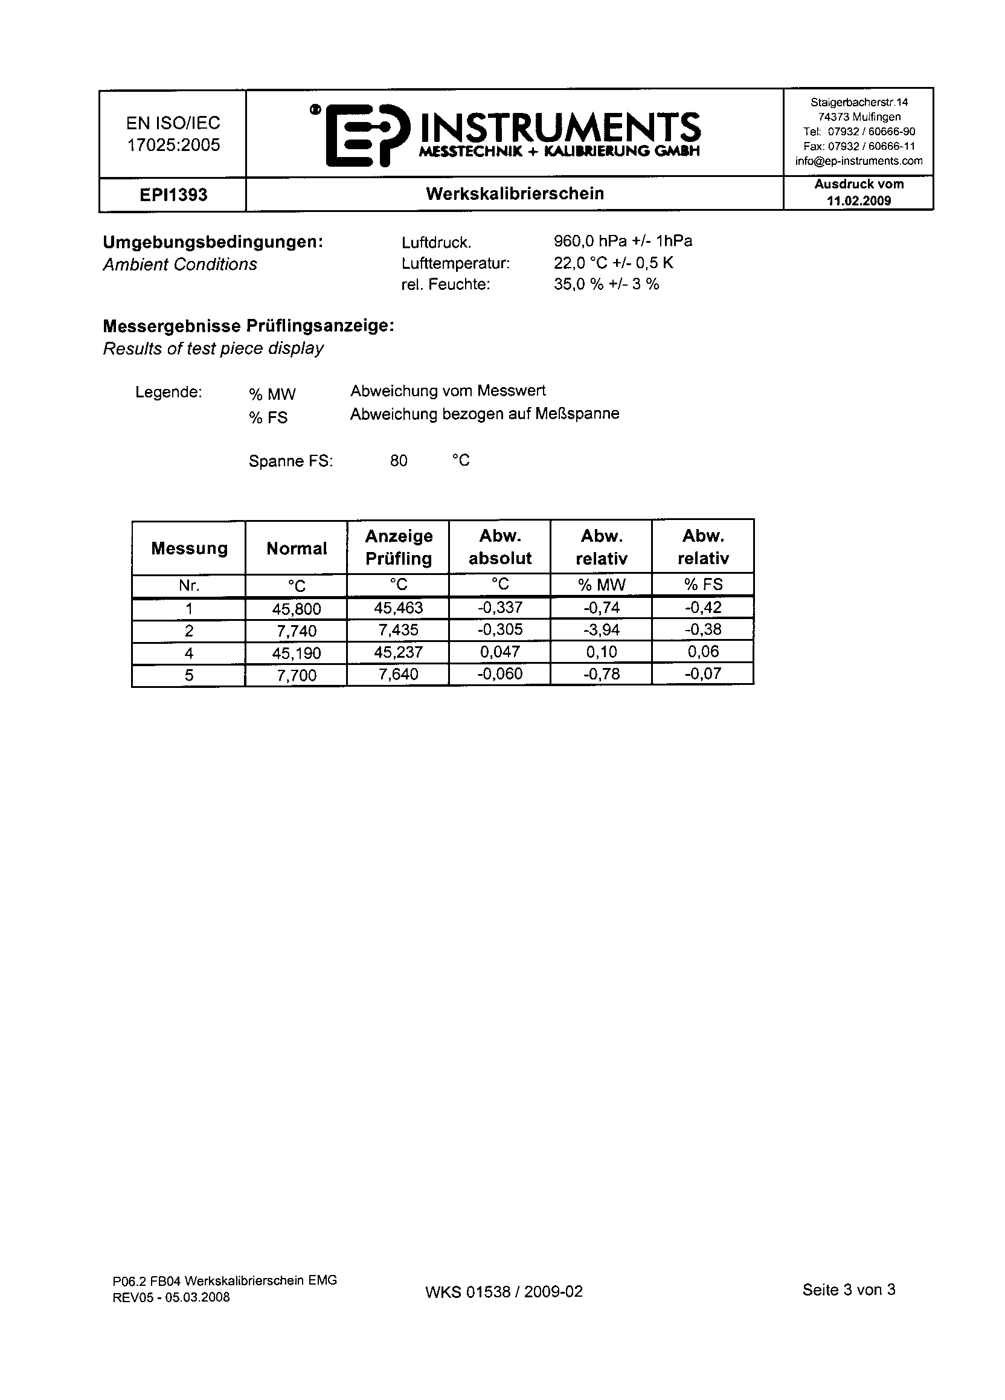
[picture p153: page 3]
