mho-jwi/MA/(B) Klimaprüfstand/Steuerung/P5507/Doku/Kalibrierung/WKS01539-2009-02_EPI1393_P5507-001_TemperatursensorT_AMB.pdf

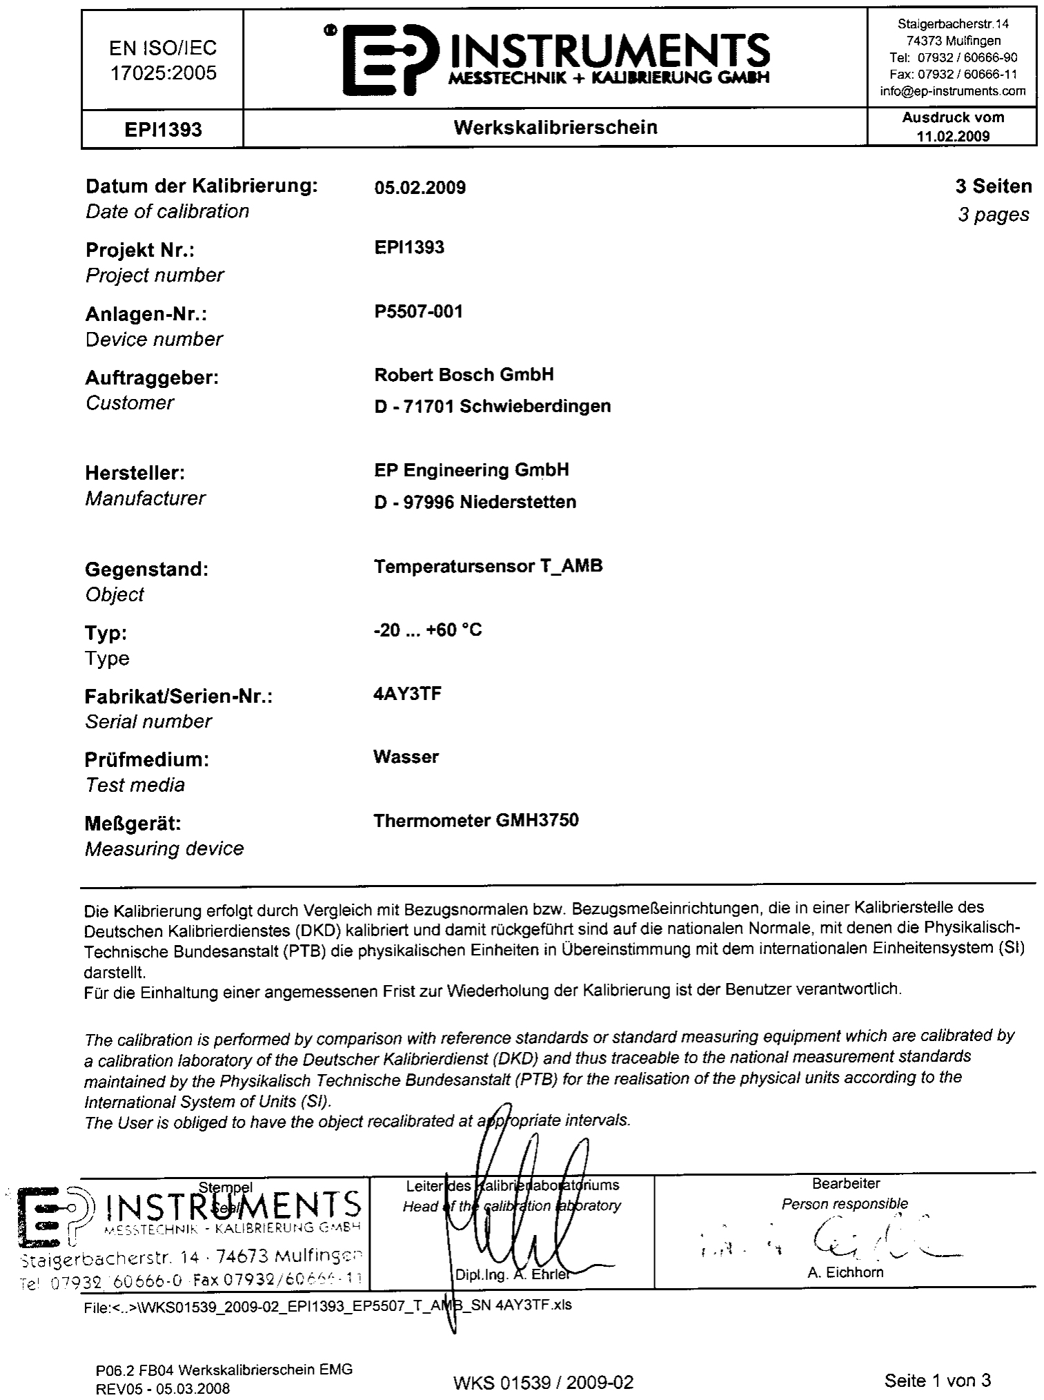
[picture p154: page 1]
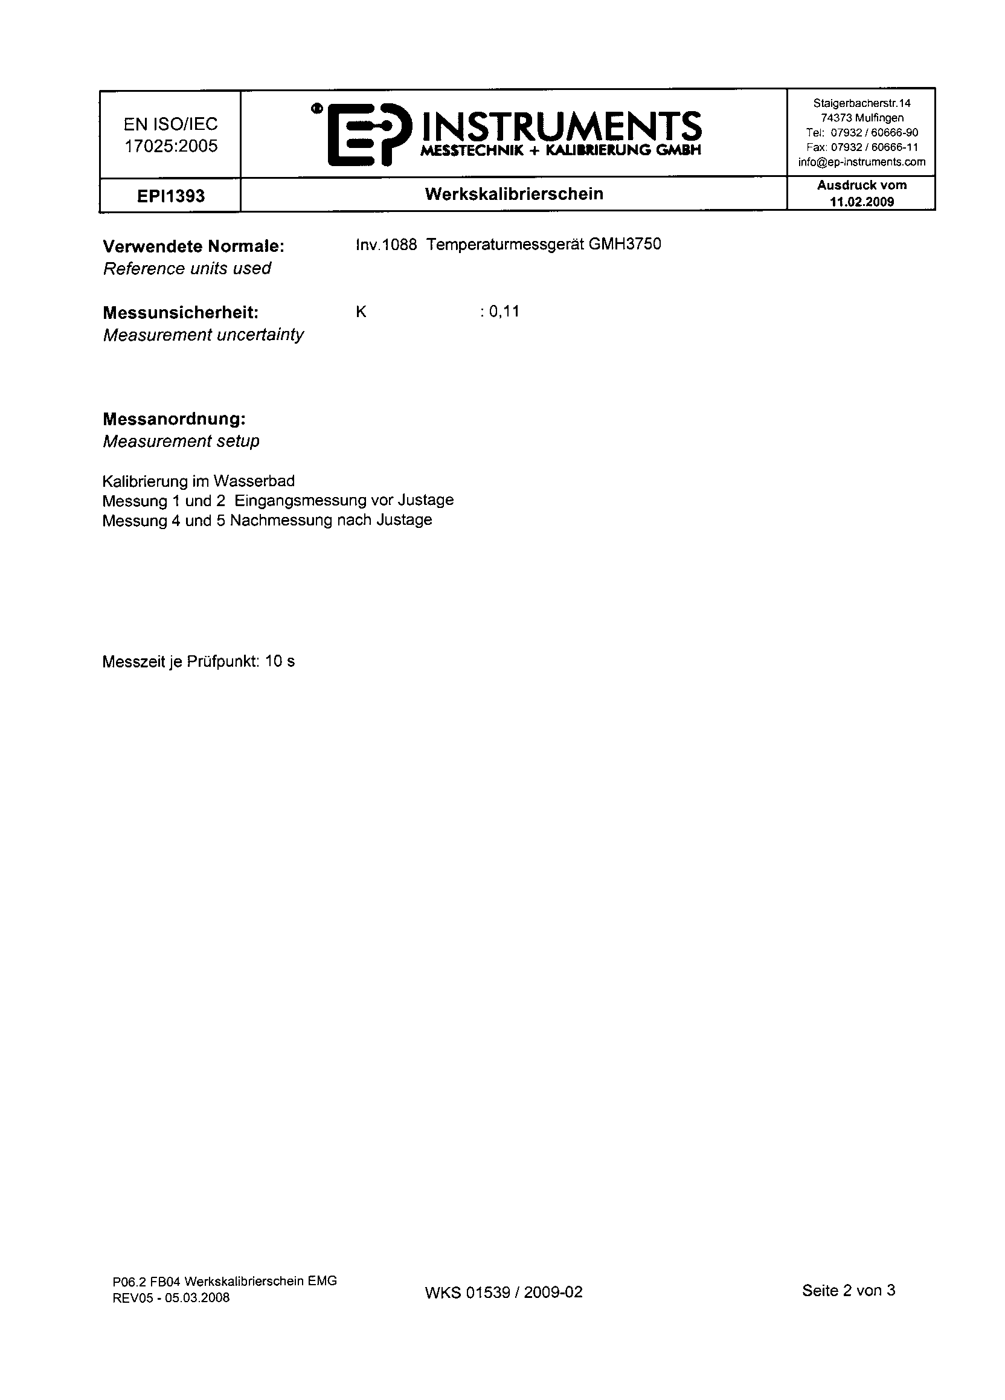
[picture p155: page 2]
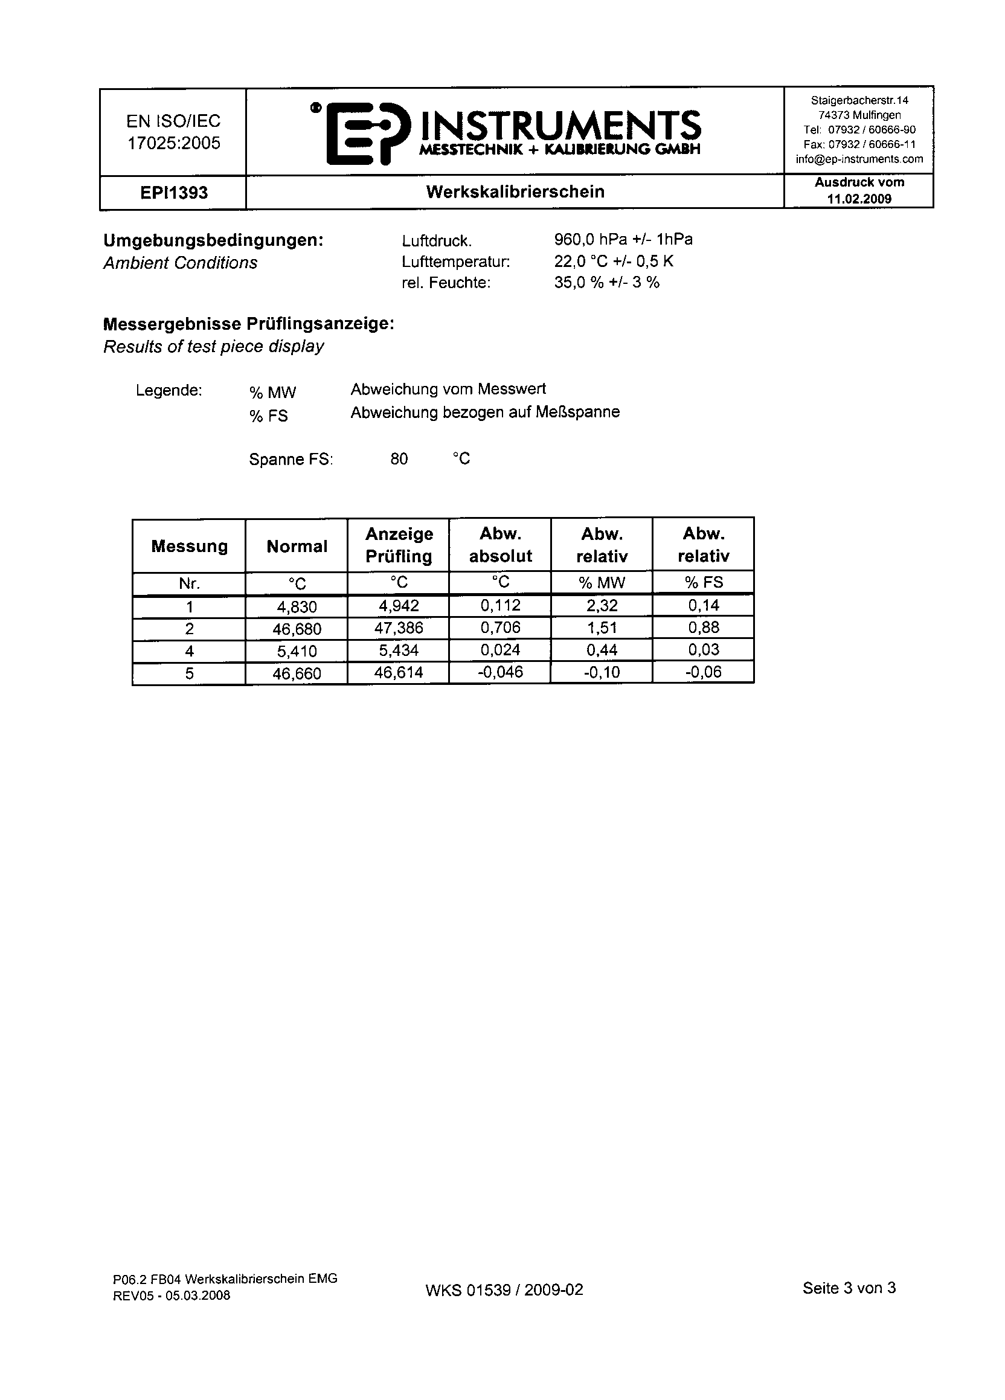
[picture p156: page 3]
