mho-jwi/MA/(B) Klimaprüfstand/Steuerung/P5507/Doku/Kalibrierung/WKS01540-2009-02_EPI1393_P5507-001_TemperatursensorT5_AHU2.pdf

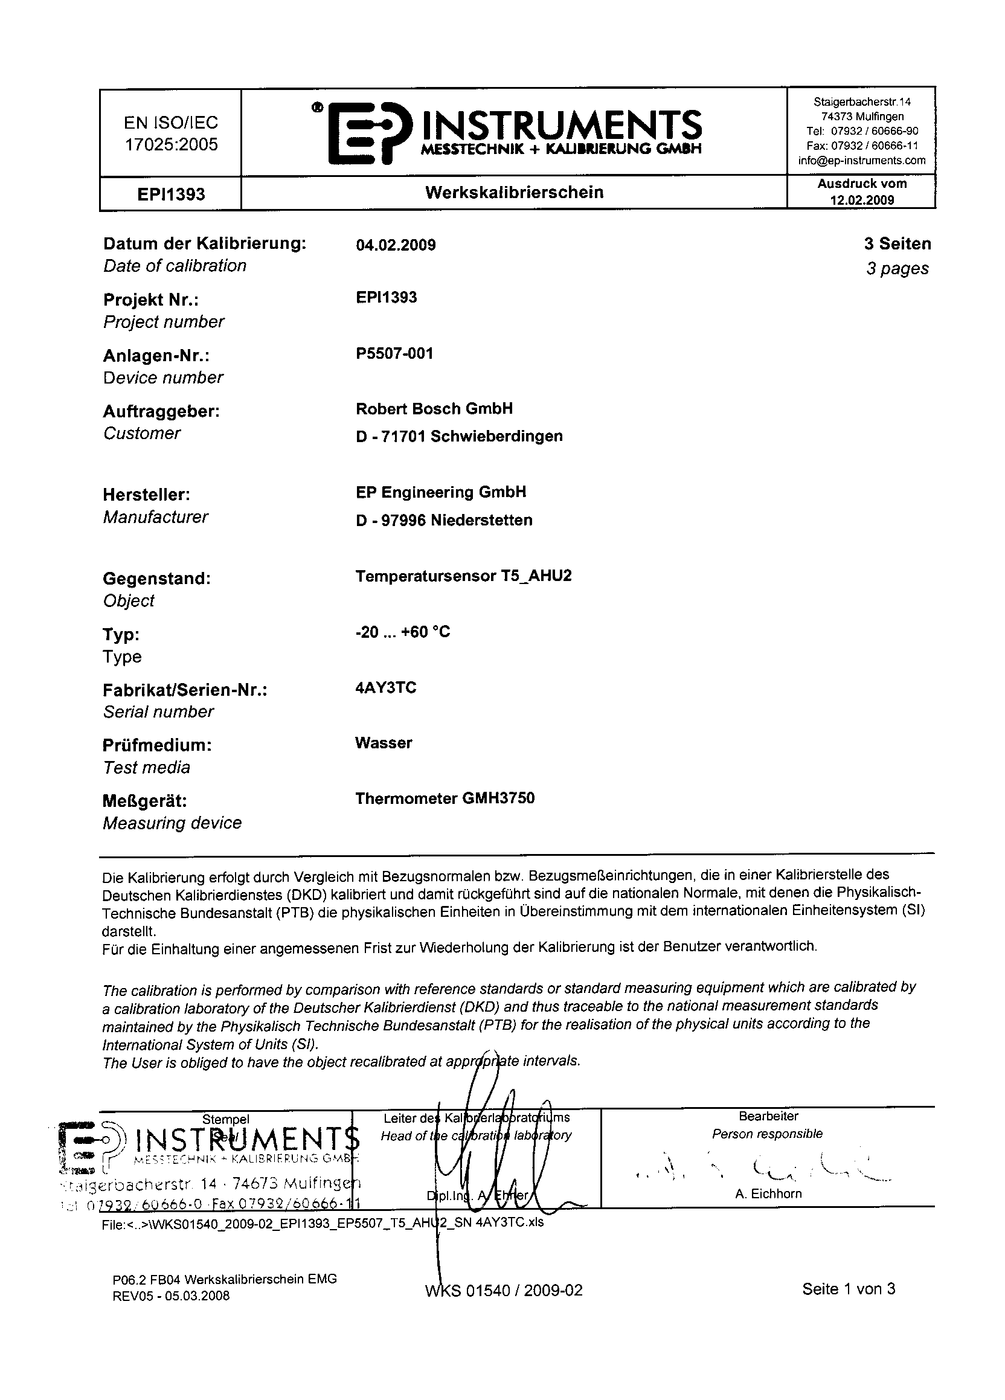
[picture p157: page 1]
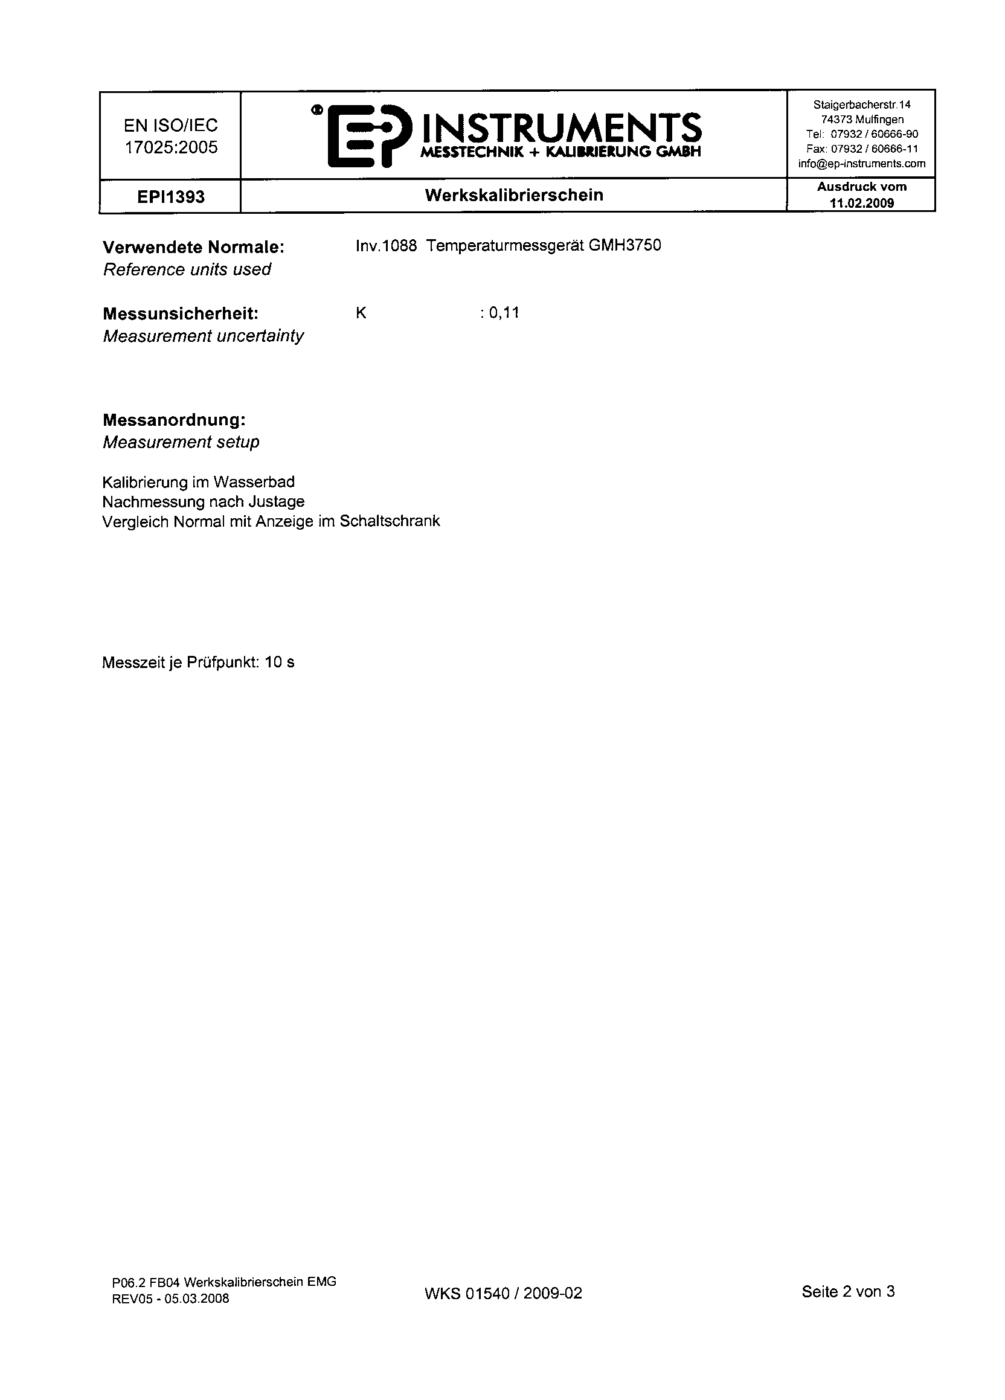
[picture p158: page 2]
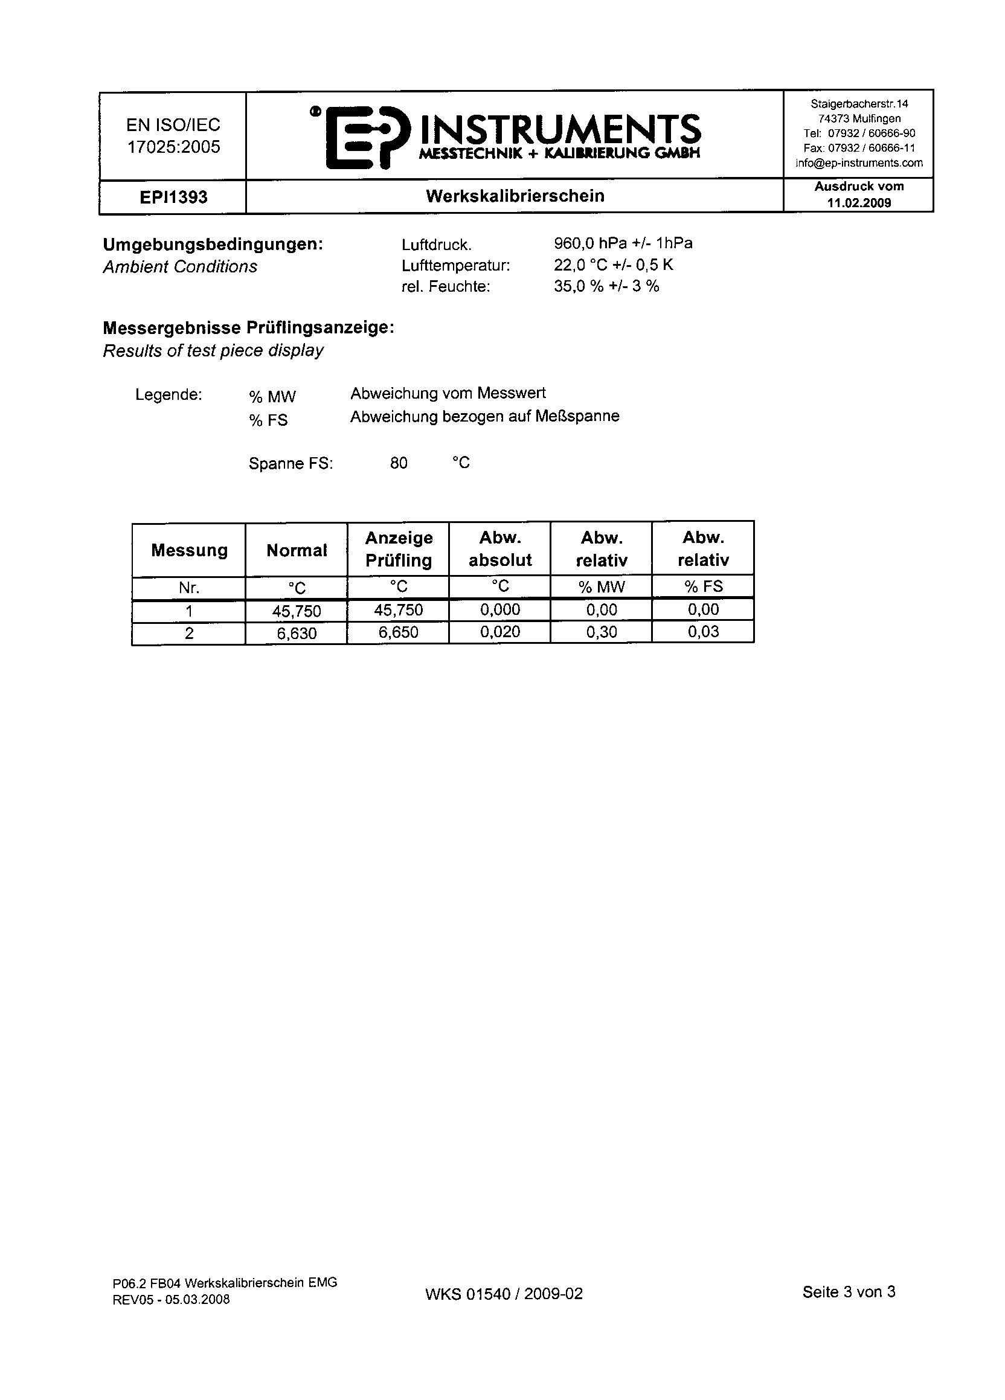
[picture p159: page 3]
