mho-jwi/MA/(B) Klimaprüfstand/Steuerung/P5507/Doku/Kalibrierung/WKS01541-2009-02_EPI1393_P5507-001_FeuchtesensorH_TPA2.pdf

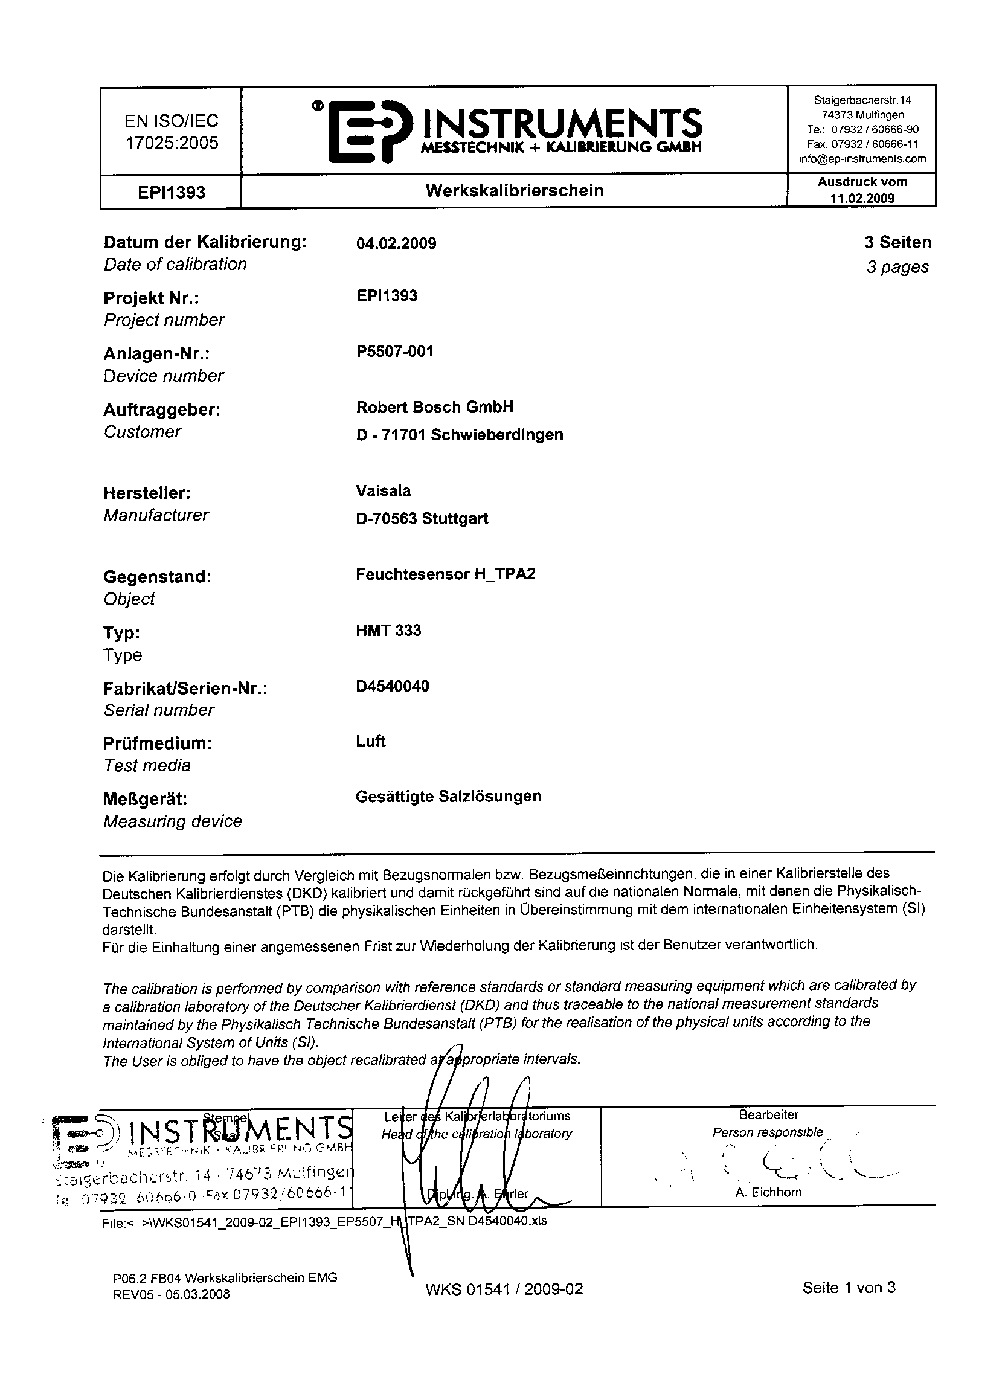
[picture p160: page 1]
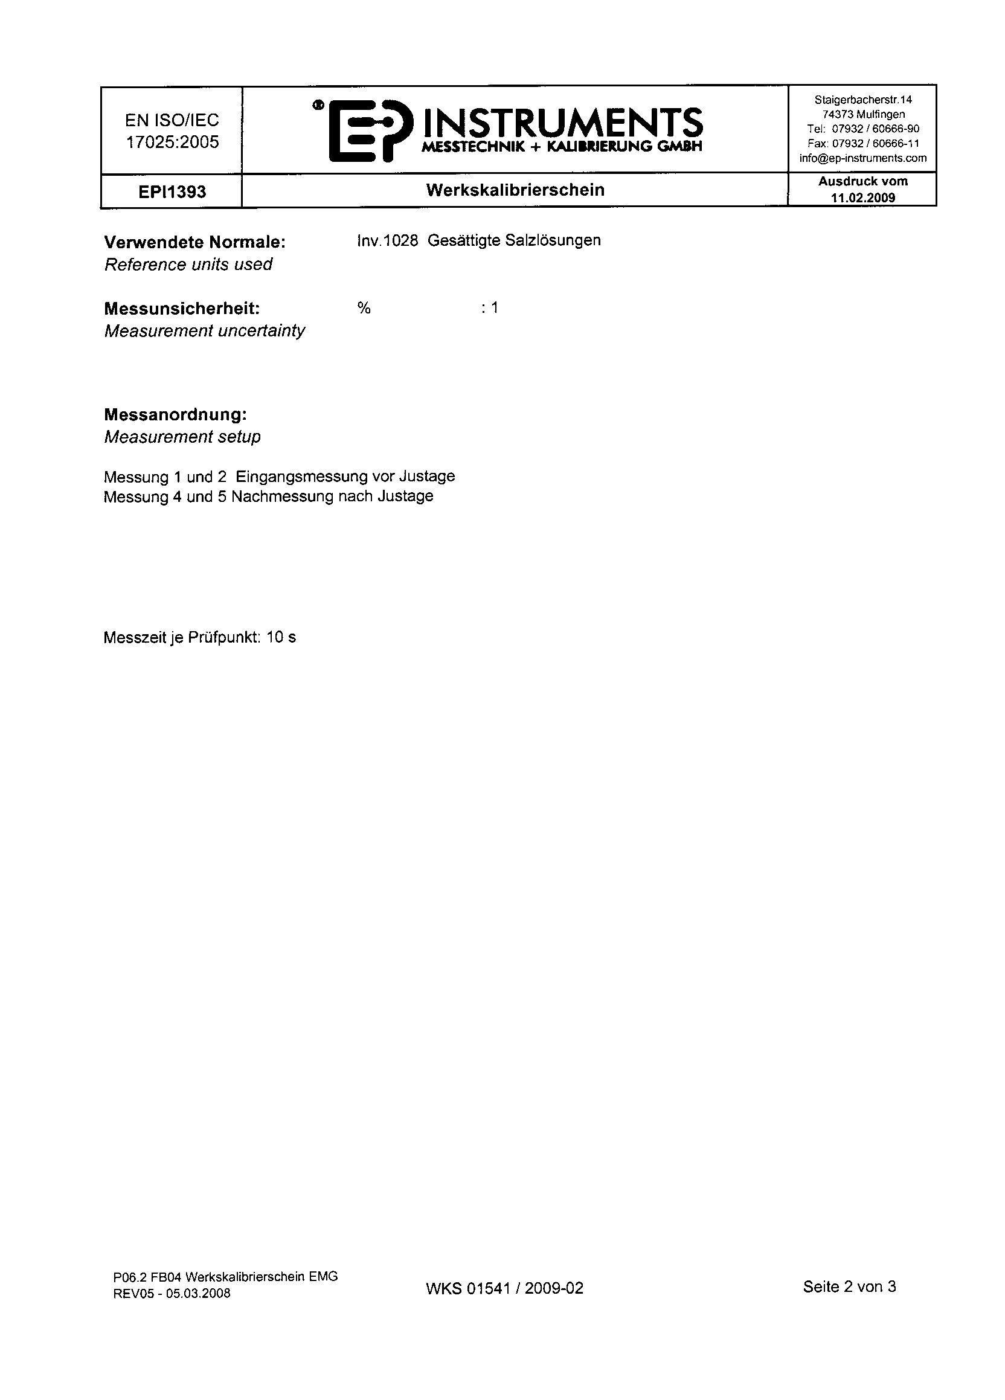
[picture p161: page 2]
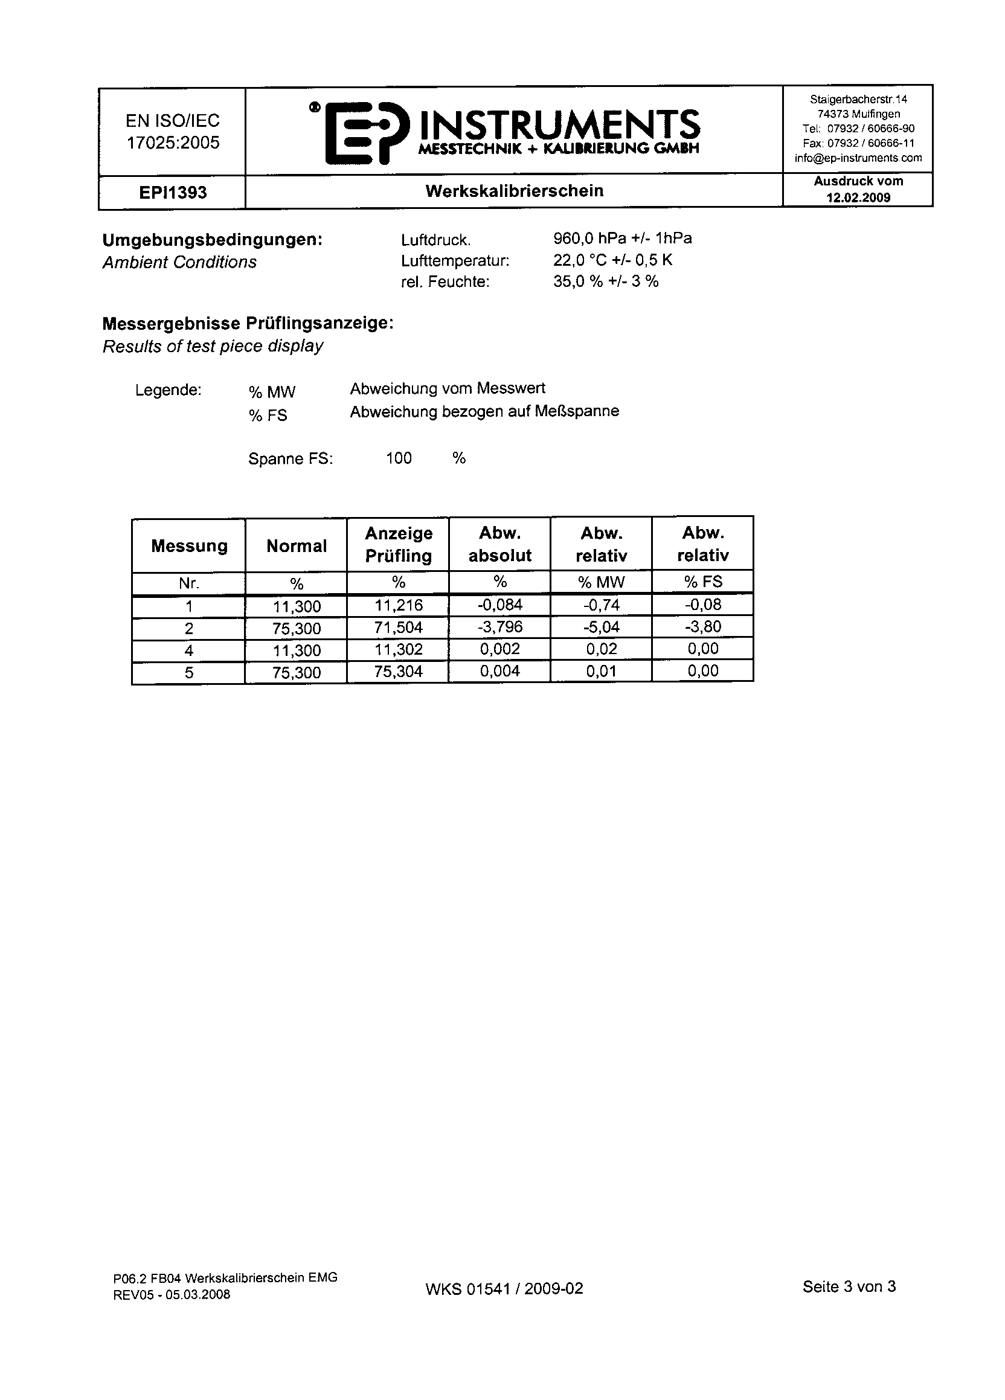
[picture p162: page 3]
