mho-jwi/MA/(B) Klimaprüfstand/Steuerung/P5507/Doku/Kalibrierung/WKS01542-2009-02_EPI1393_P5507-001_FeuchtesensorH_TPB1.pdf

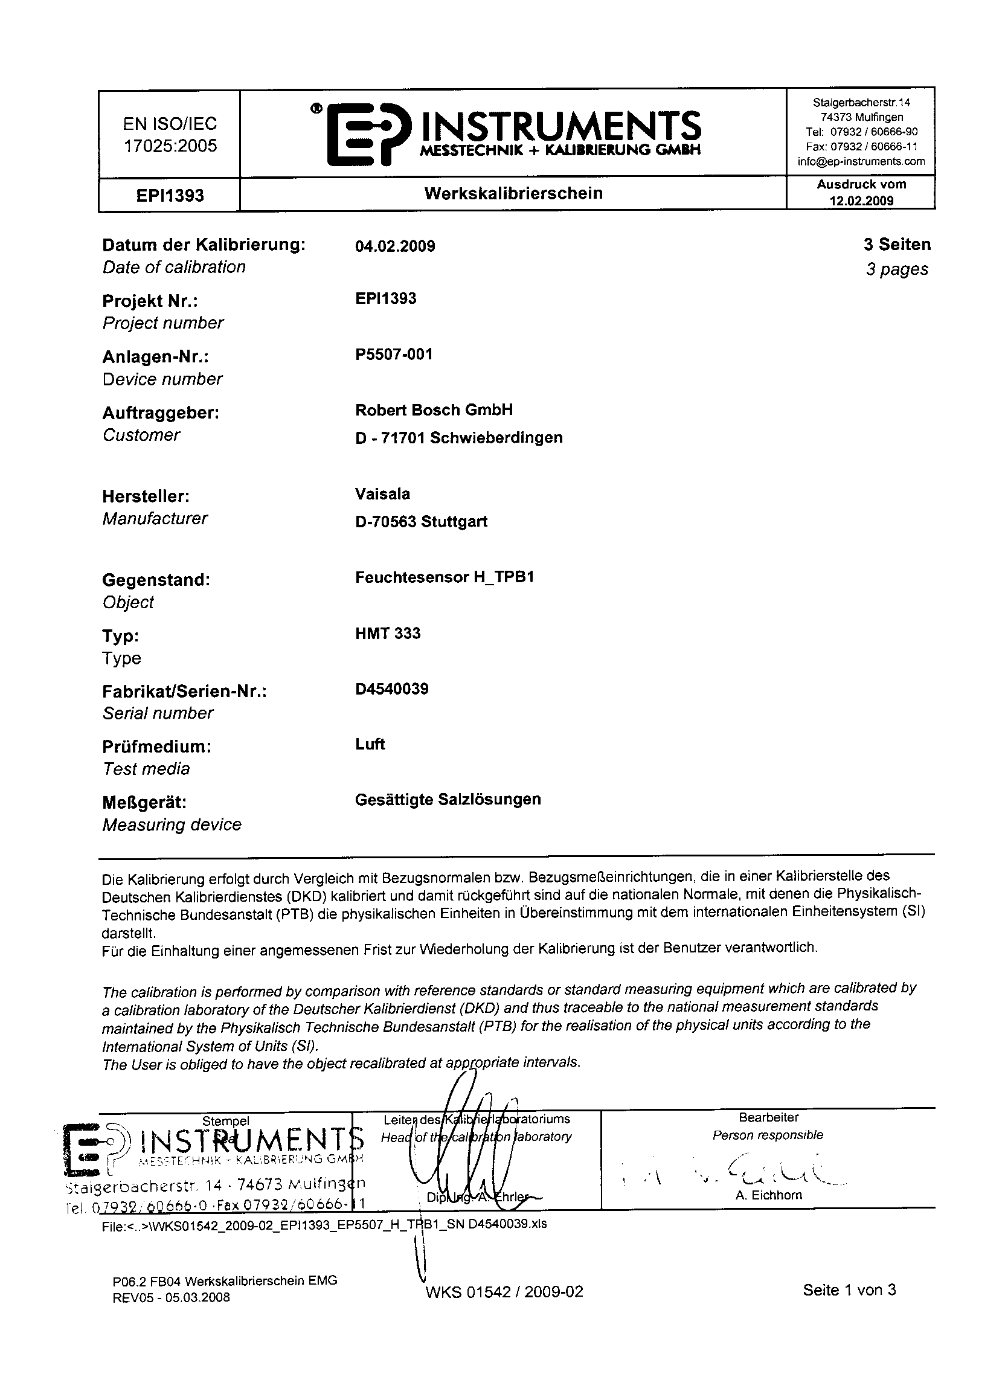
[picture p163: page 1]
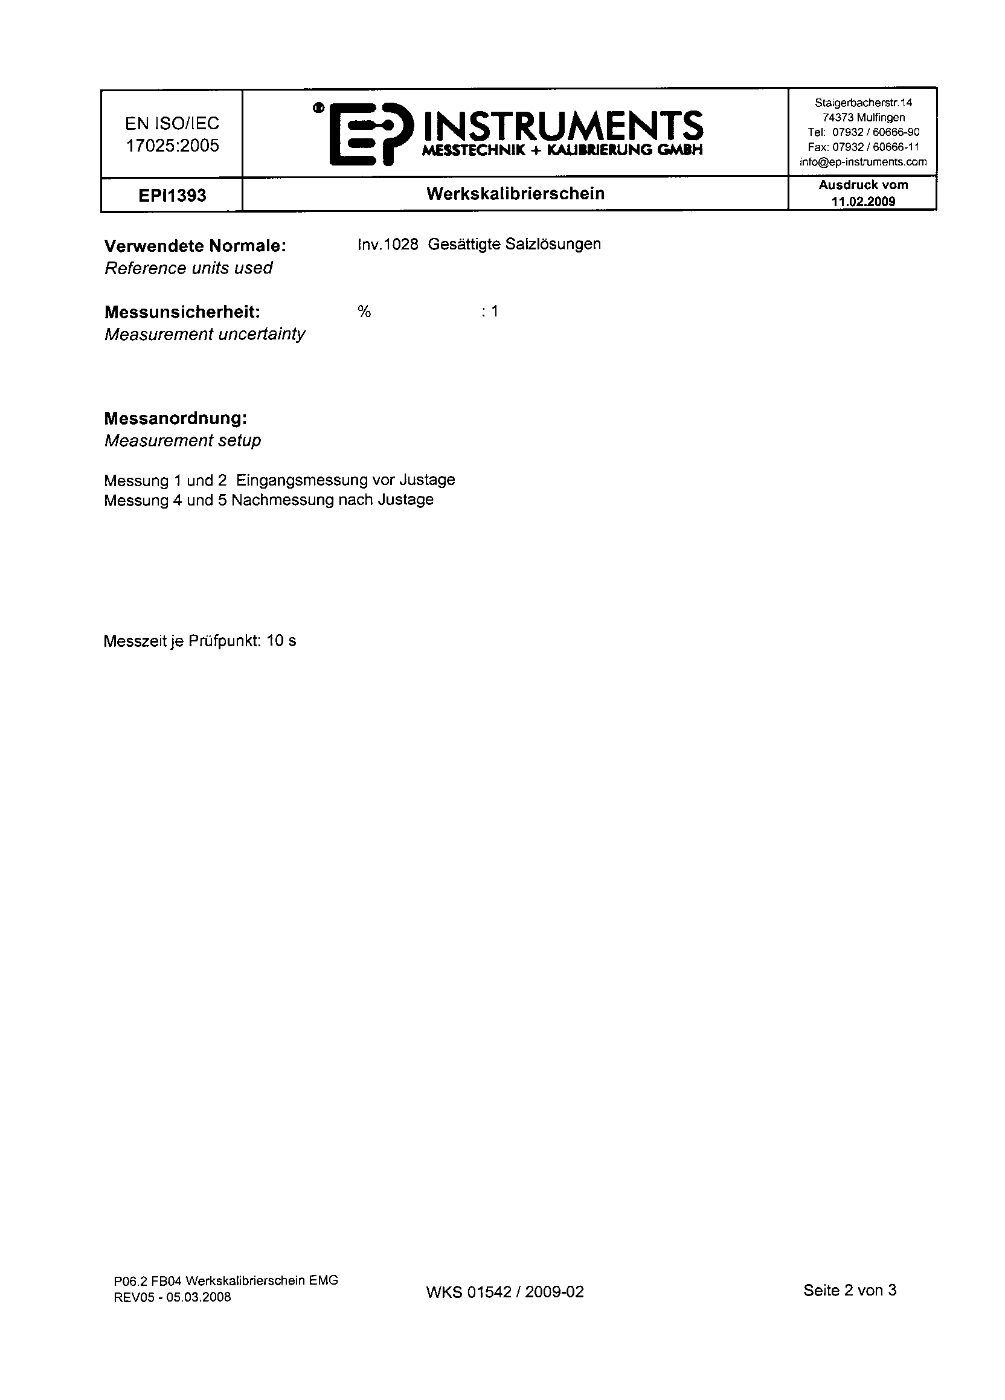
[picture p164: page 2]
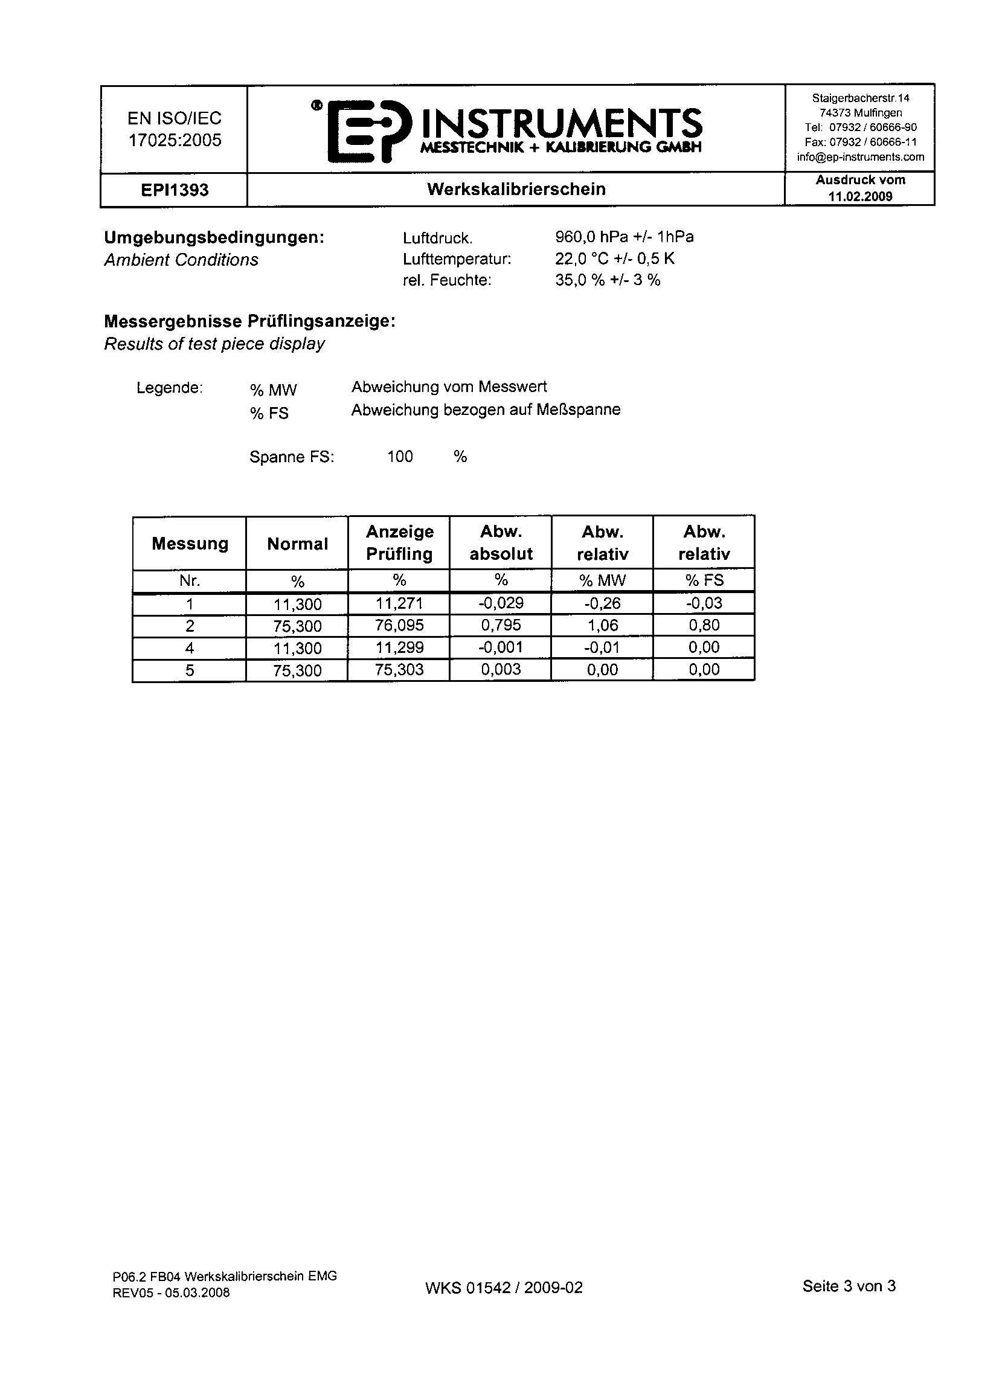
[picture p165: page 3]
