mho-jwi/MA/(B) Klimaprüfstand/Steuerung/P5507/Doku/Kalibrierung/WKS01543-2009-02_EPI1393_P5507-001_FeuchtesensorH1_AHU1.pdf

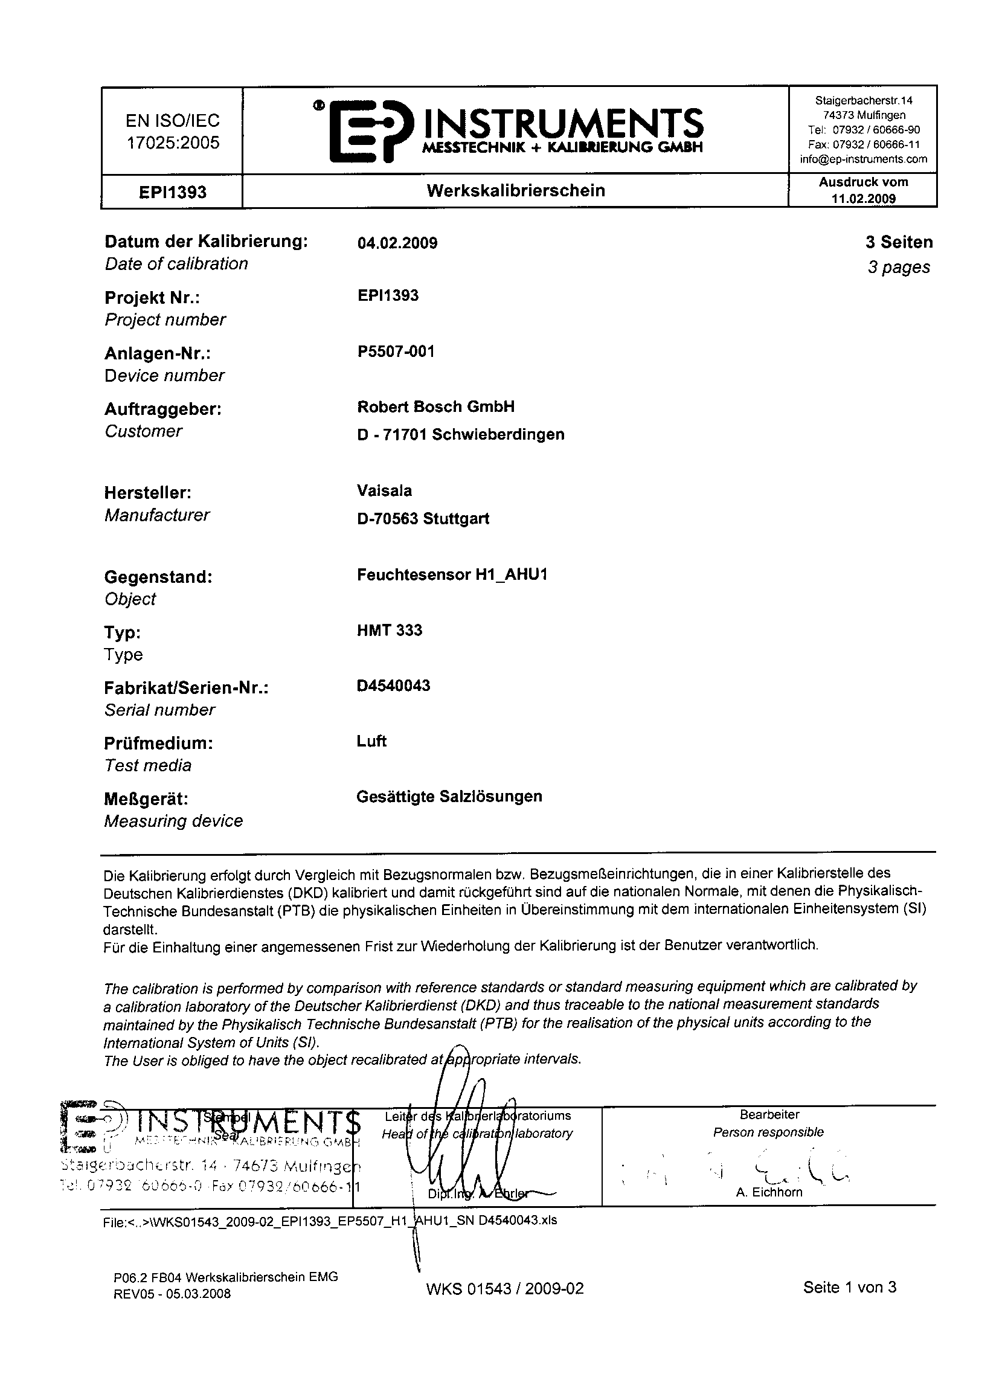
[picture p166: page 1]
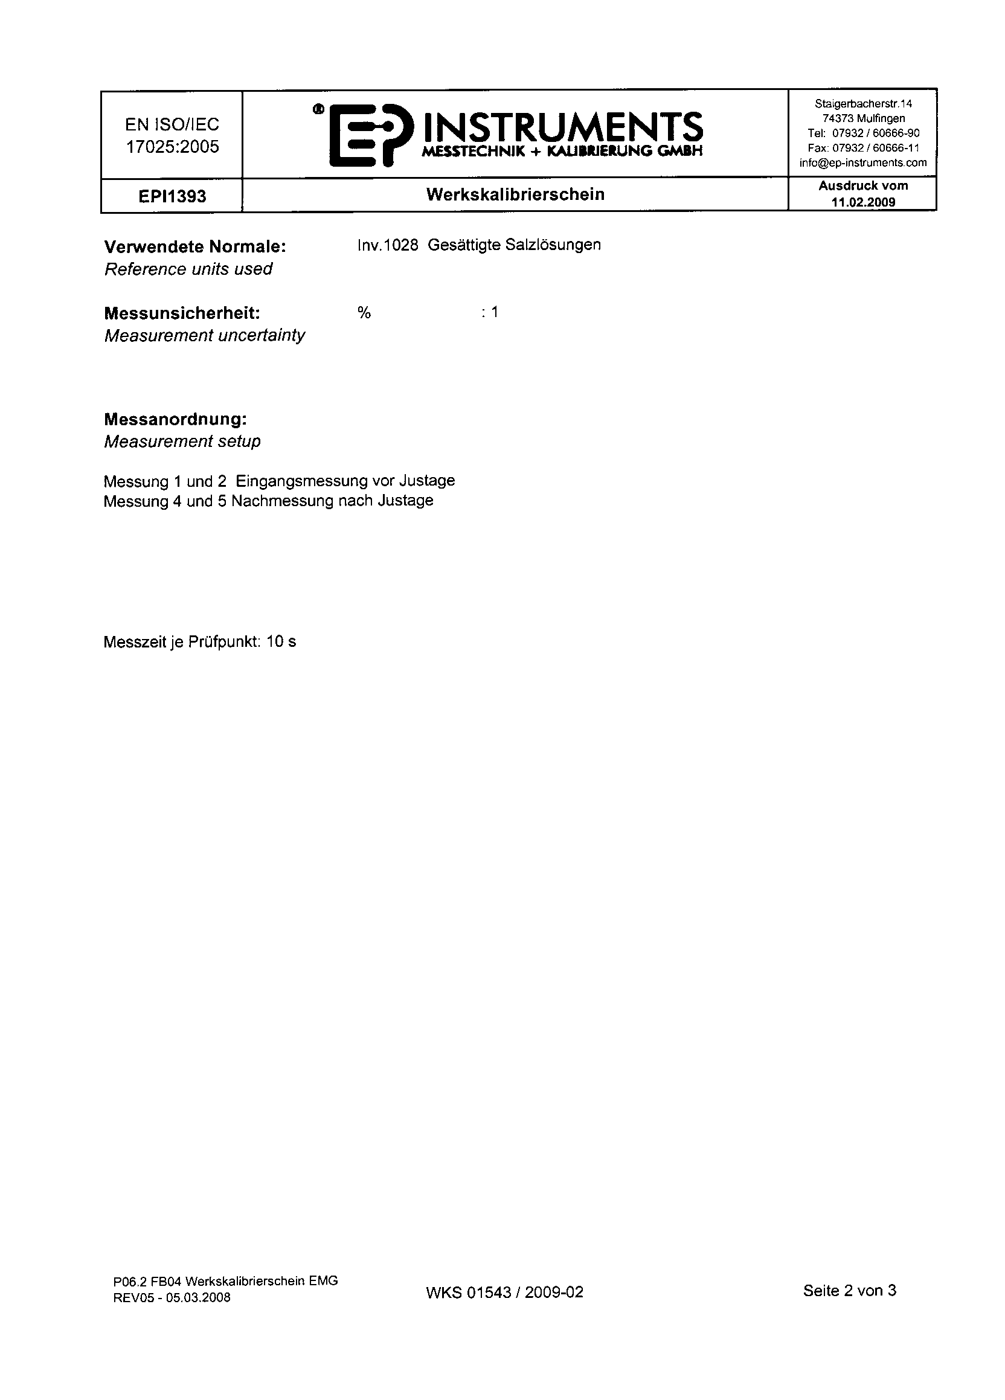
[picture p167: page 2]
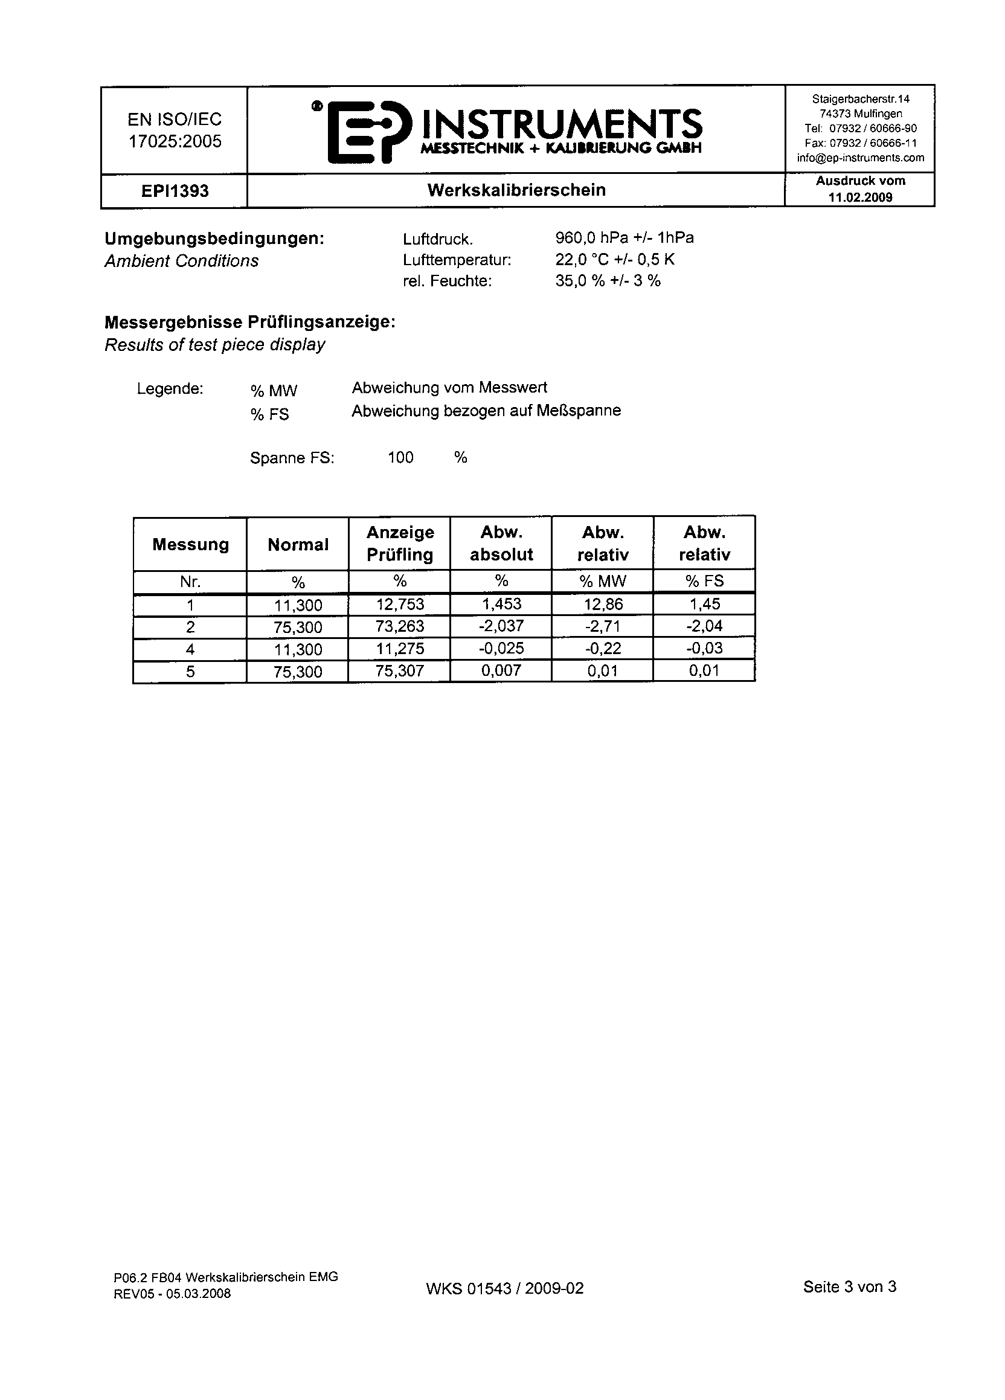
[picture p168: page 3]
