mho-jwi/MA/(B) Klimaprüfstand/Steuerung/P5507/Doku/Kalibrierung/WKS01544-2009-02_EPI1393_P5507-001_FeuchtesensorH_TPA1.pdf

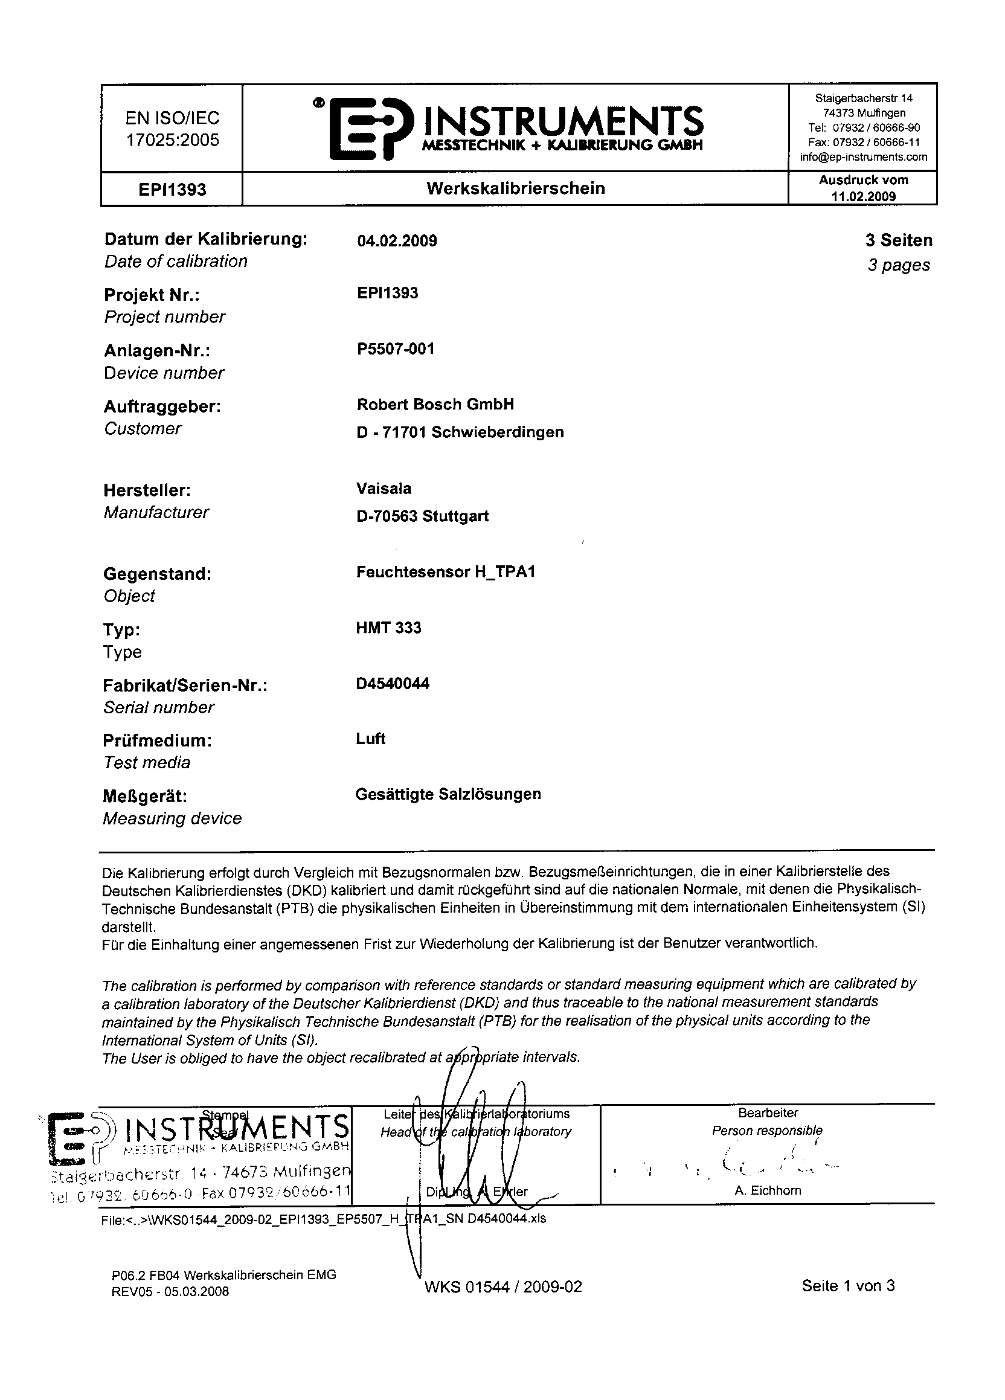
[picture p169: page 1]
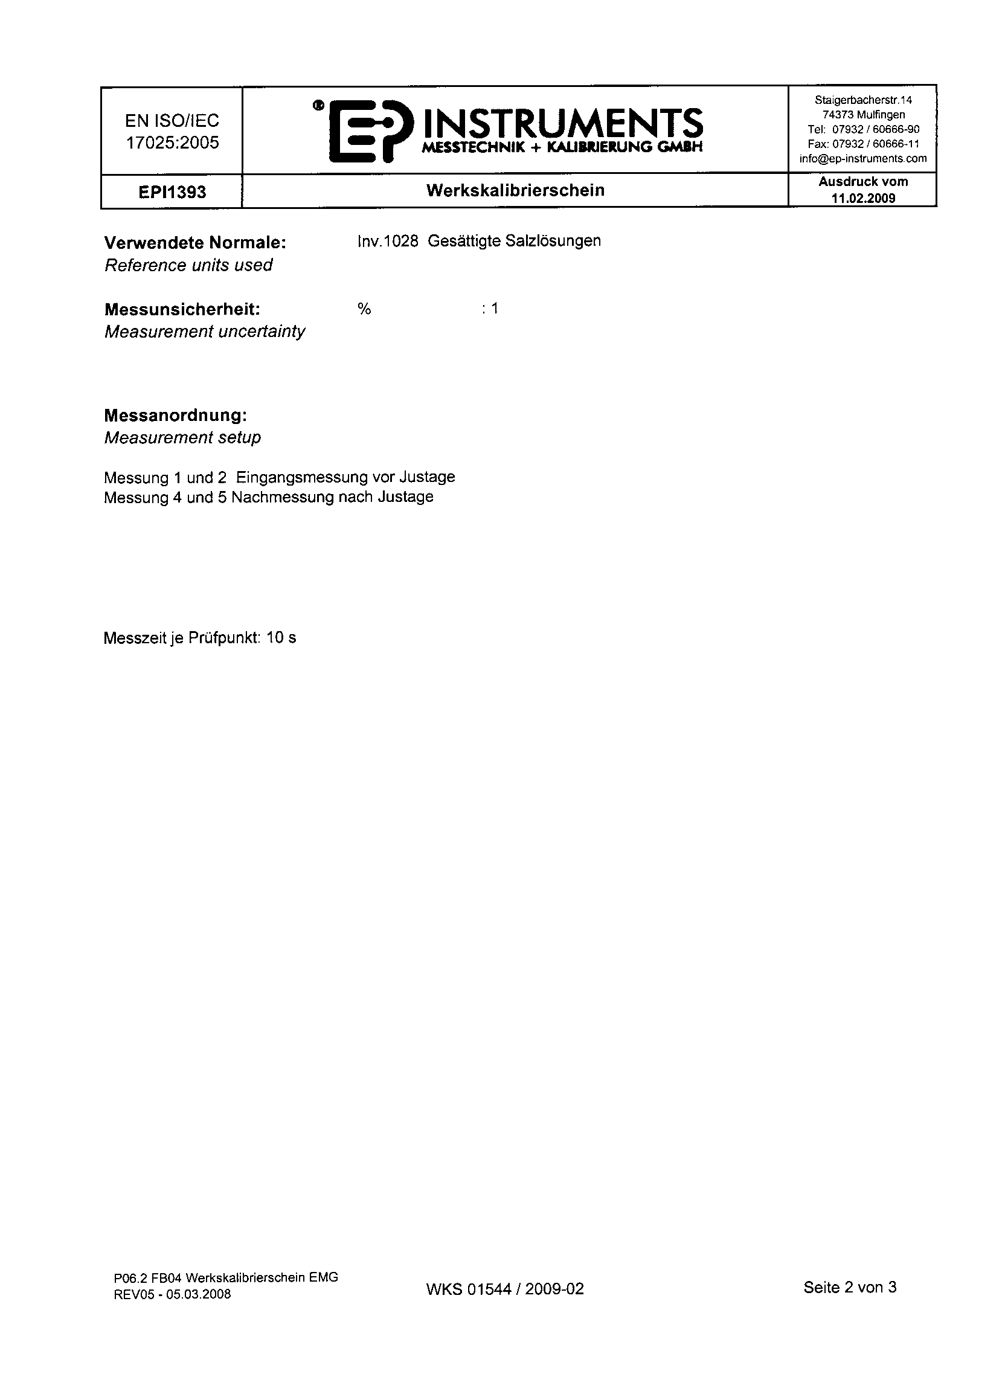
[picture p170: page 2]
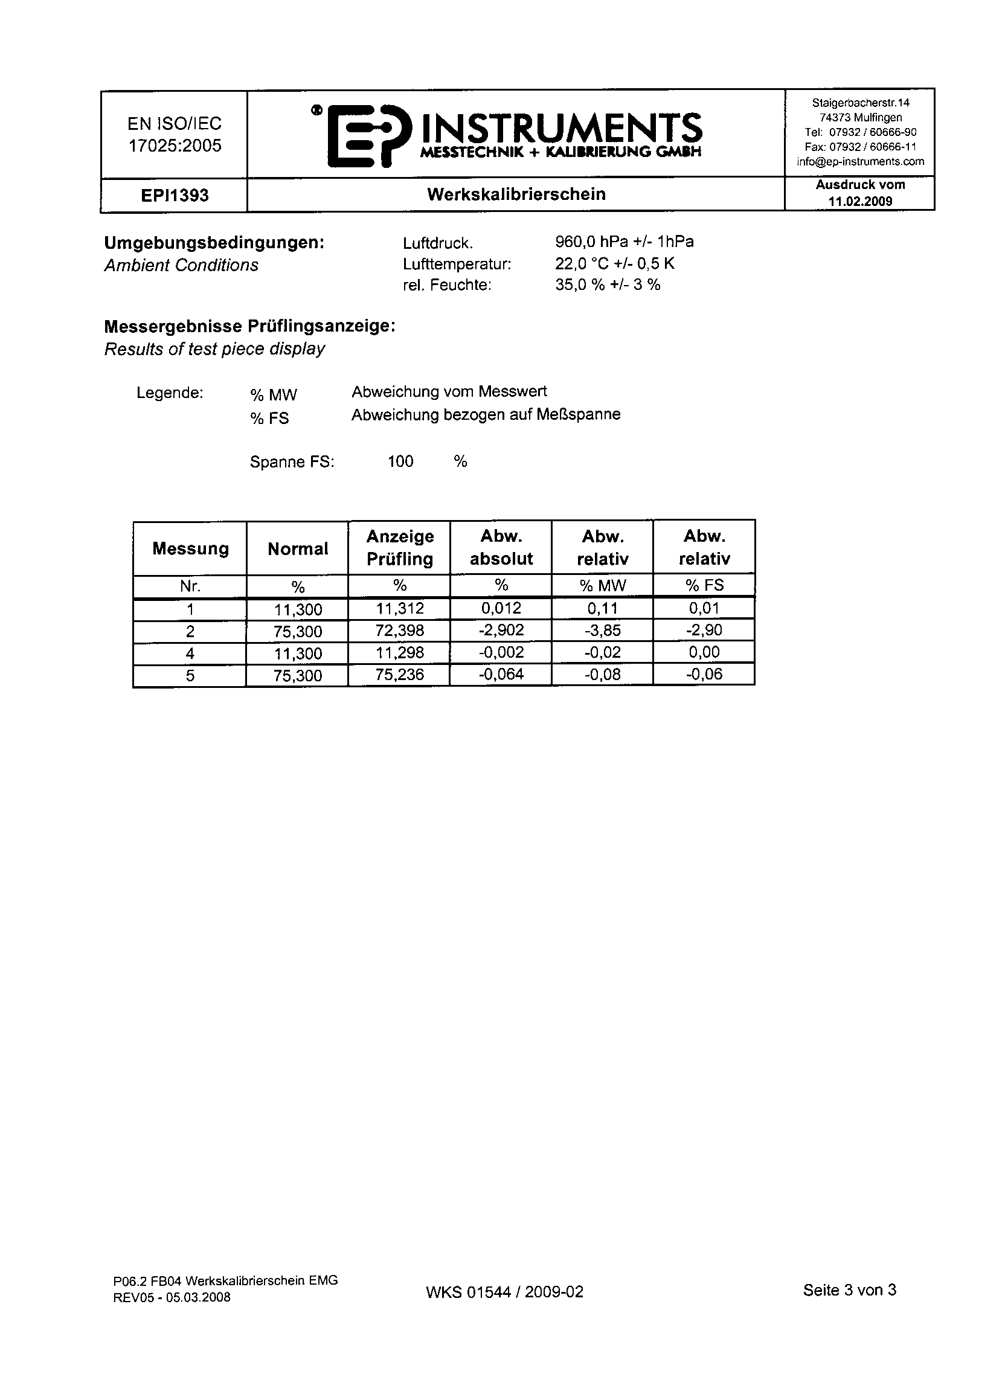
[picture p171: page 3]
