mho-jwi/MA/(B) Klimaprüfstand/Steuerung/P5507/Doku/Kalibrierung/WKS01545-2009-02_EPI1393_P5507-001_FeuchtesensorH1_AHU2.pdf

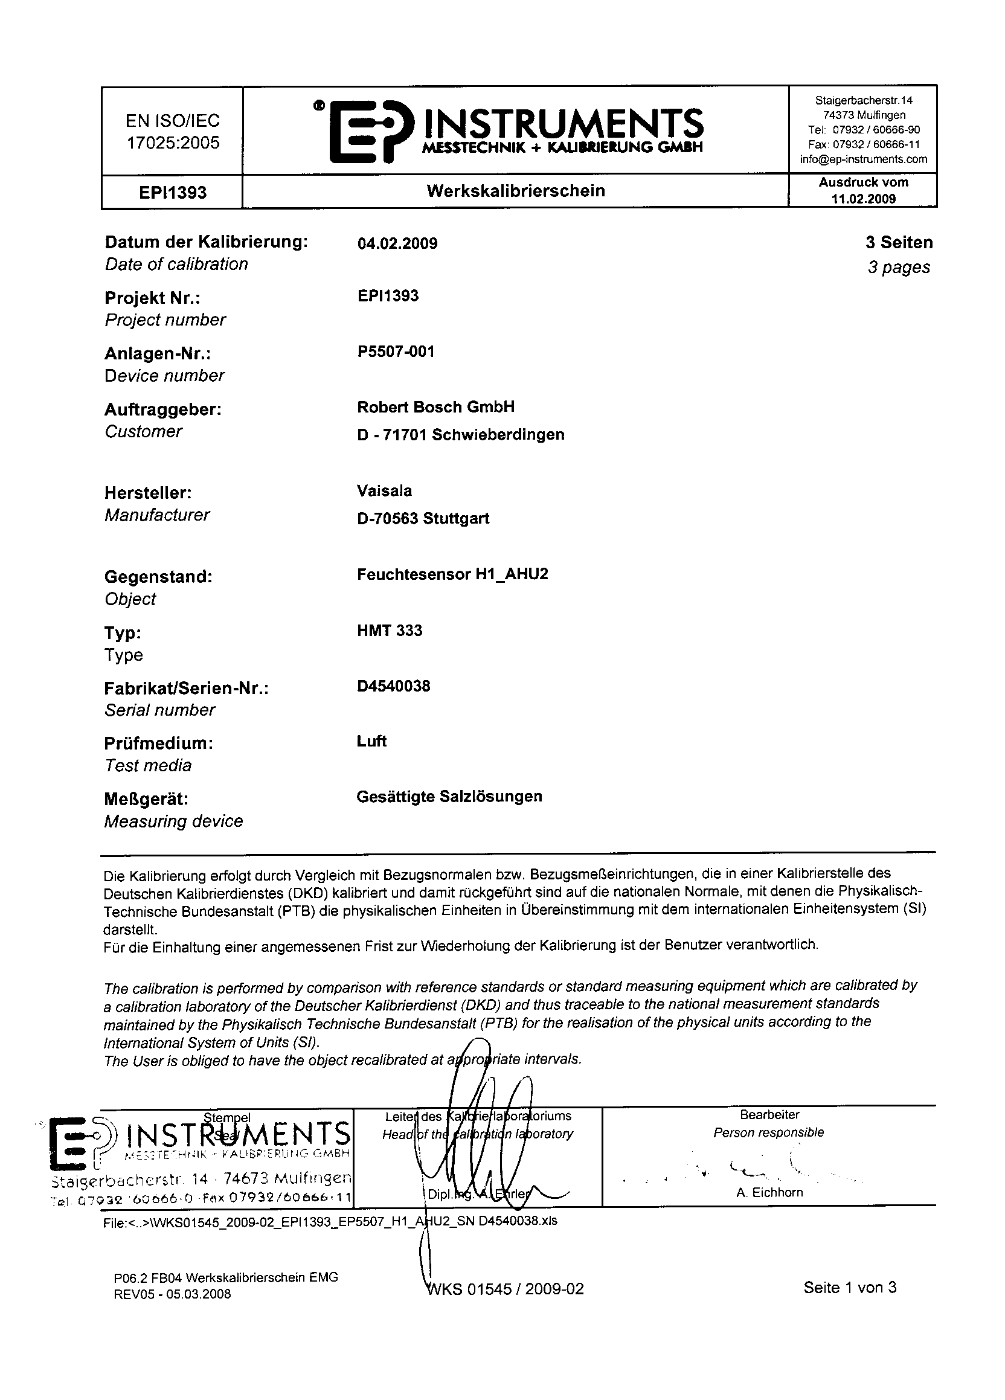
[picture p172: page 1]
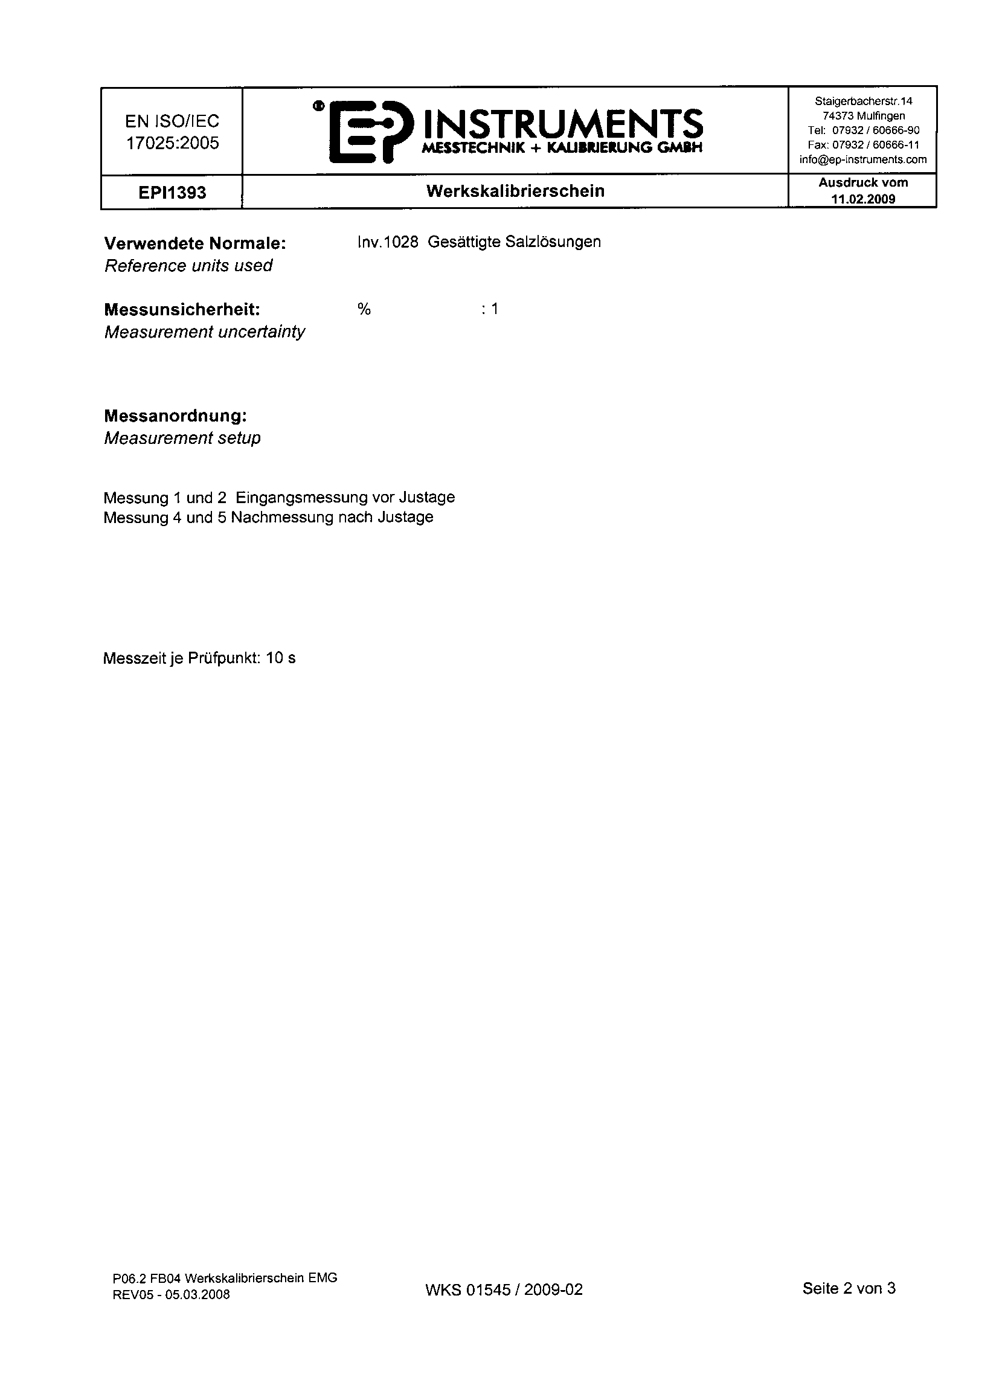
[picture p173: page 2]
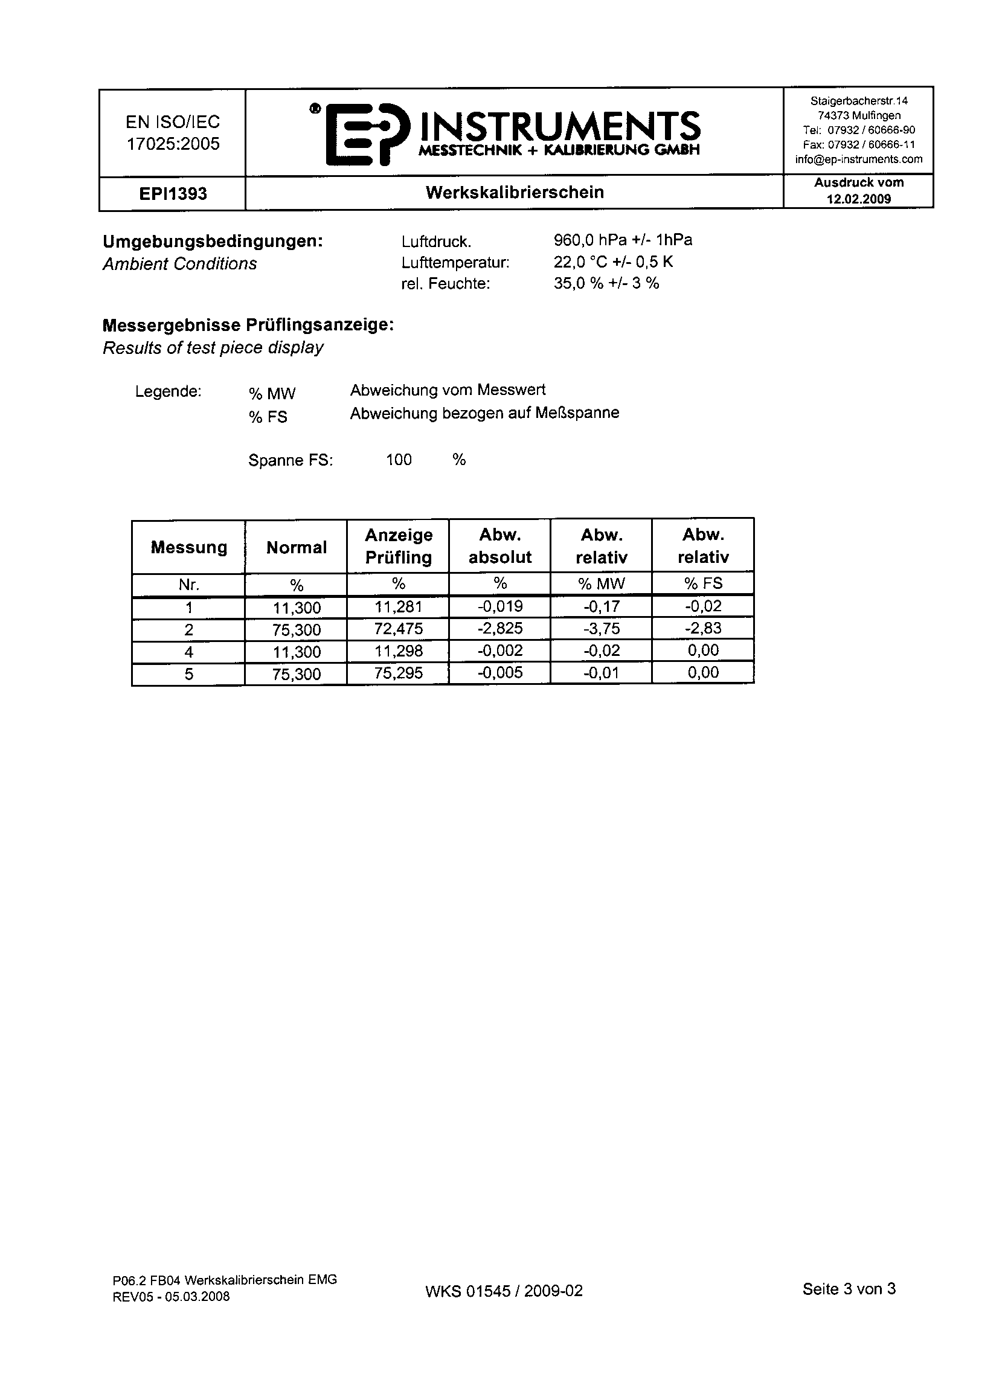
[picture p174: page 3]
