mho-jwi/MA/(B) Klimaprüfstand/Steuerung/P5507/Doku/Kalibrierung/WKS01546-2009-02_EPI1393_P5507-001_FeuchtesensorH2_AHU2.pdf

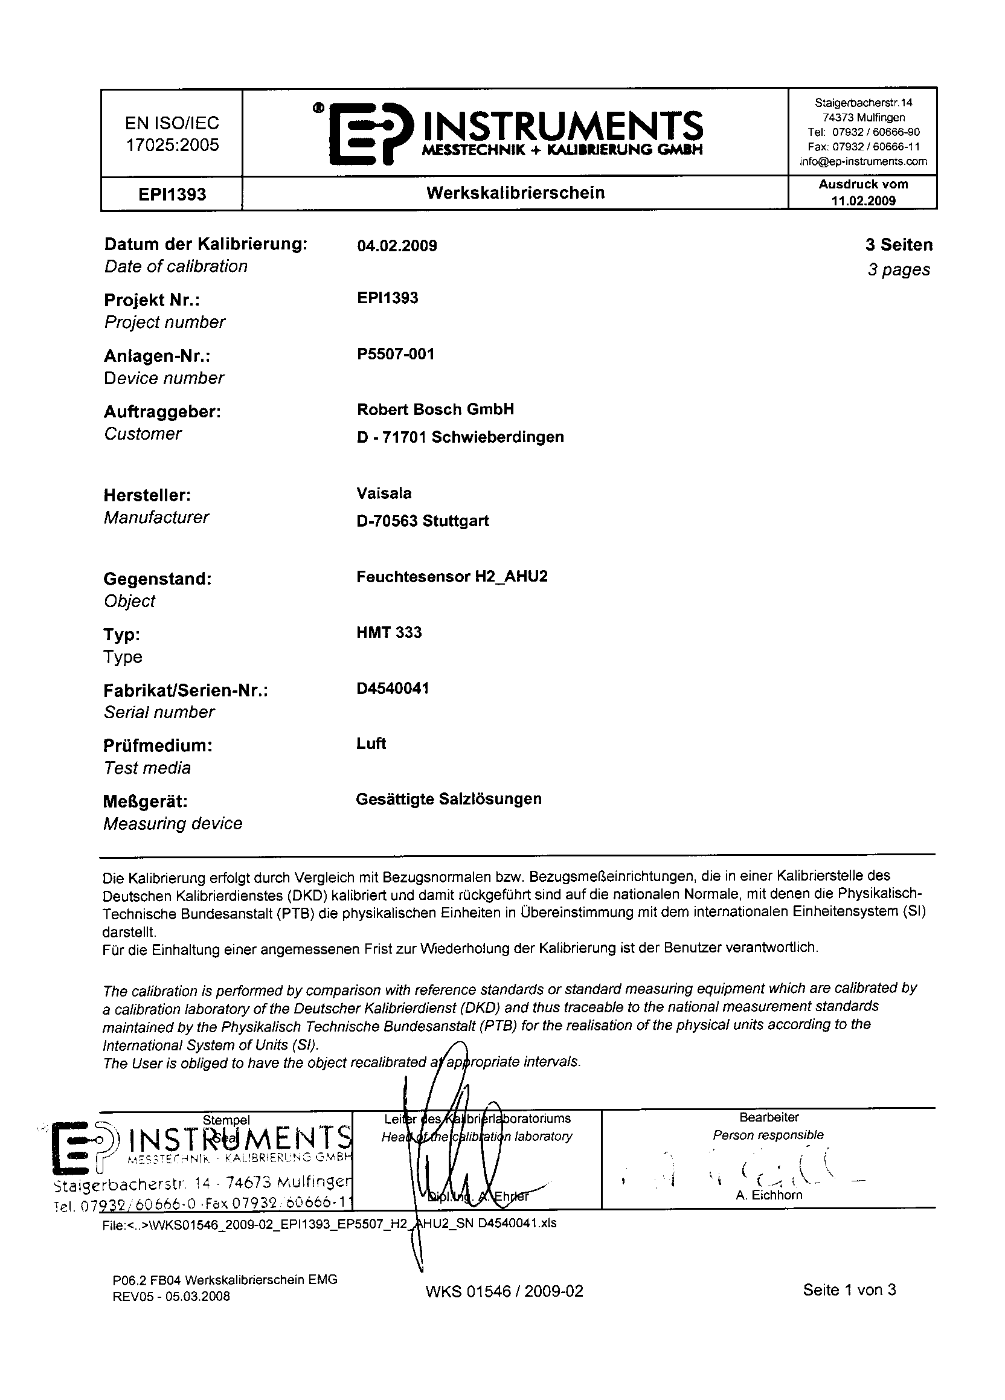
[picture p175: page 1]
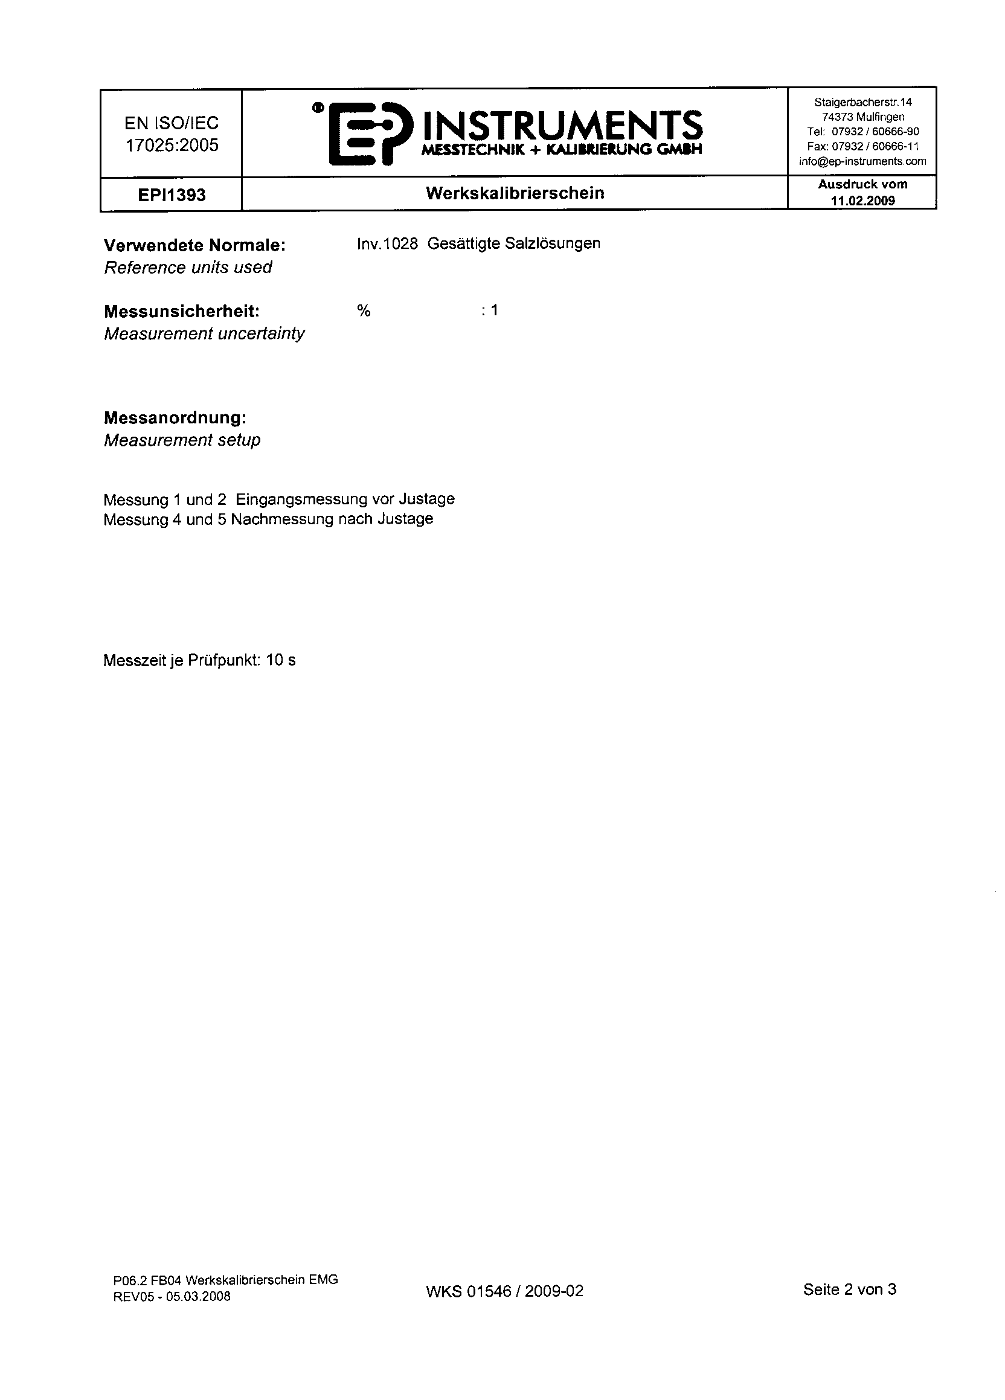
[picture p176: page 2]
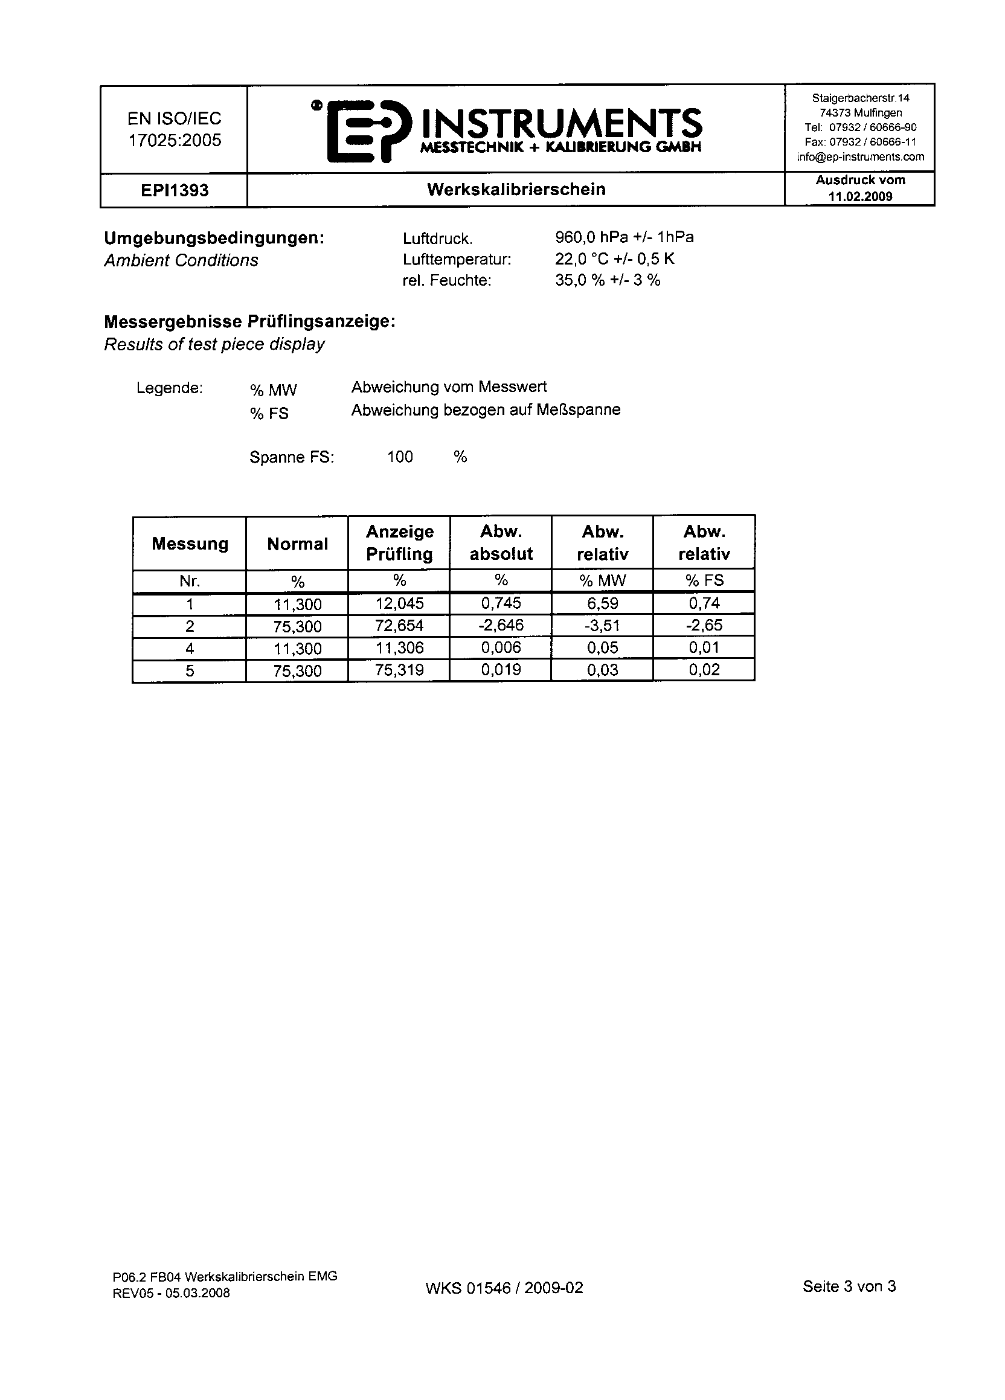
[picture p177: page 3]
