mho-jwi/MA/(A) Literatur/List of relevant Journals.docx

List of relevant Journals:

Journal of Membrane Science

Renewable and sustainable Energy Reviews

Journal of heat transfer-transactions of the ASME

Indoor and built environment

Energy and Buildings

Applied thermal Engineering

Energy and conservation Management

Journal of Building Physics
