mho-jwi/MA/(B) Klimaprüfstand/Steuerung/P5507/Debugging/OffenePunkte_Kunde_2009-05-06.xls

 | offene Punkte des Klimaprüfstands in 404B Raum 01
Eingabe | Thema | Kommentar / Abhängigkeiten | Maßnahme | erledigt | status
2009-04-21 | Zahlenformat Druckregler nicht ausreichend |  | 1V06 | 2009-04-28 | erledigt
2009-04-21 | Qv in der Meßmaske in Fließkomma ändern |  | 1V06 | 2009-04-28 | erledigt
2009-04-21 | WT-Haus ????? |  |  |  | unklar
2009-04-21 | M1_AHU2 von V auf % ändern; Zahlenwert nur 1/10 | in Diag. kann nur die Einheit geändert werden |  |  | erledigt
2009-04-21 | Bilder von Venturis fehlen |  | 1V06 | 2009-04-28 | erledigt
2009-04-21 | Sollwerteingabe über Meßmaske |  |  |  | erledigt
2009-04-21 | T4_AHU2 ?????? |  |  |  | unklar
2009-04-21 | Leistung der WT in Watt wird falsch angezeigt |  | 1V06 |  | erledigt
2009-04-21 | V1.2_TPA ???? |  |  |  | unklar
2009-04-21 | y-Achsen der Regler kein auotscale |  | 1V06 |  | erledigt
2009-04-21 | Volumenstromregler NTPB anhalten wenn Klappe zu | mit 1V06 gehen die Regler aus; anhalten wäre besser; bei öffnen der Klappe auch wieder aktivieren |  |  | offen | CHL
2009-04-21 | Volumenstromregler NTPA anhalten wenn Klappe zu | mit 1V06 gehen die Regler aus; anhalten wäre besser; bei öffnen der Klappe auch wieder aktivieren |  |  | offen | CHL
2009-04-21 | Strömungserkennung Gebäude machbar? | Regler aus wenn Vorwarnung ansteht |  |  | offen | CHL | Bei Vorwarnmeldung Heizer Sollwert auf -20 setzen..
2009-04-21 | ungewollte Initialisierung der T-regler, beim Masken-Umschalten |  | evtl. von vor 1V06 |  | unklar
2009-04-21 | noch keine Sollwertkorrektur der T-Regler | erst mit Isolierung sinnvoll |  |  | offen |  | vertagt bis nach Isolierung, dann evtl. überlagerter I-Regler
2009-04-21 | Pumpe für Rückkühlung der Kältemaschine | in Klärung mit KKT und FCM |  |  | offen
2009-04-22 | Schleppregler werden nicht immer mitgenommen (Flanke?) |  |  |  | erledigt
2009-04-23 | Volumenstromregler beeinflussen sich |  | 1V06 |  | erledigt
2009-04-27 | Genauigkeit der Feuchtefühler fraglich |  |  |  | offen
2009-04-27 | Monitorkabel nachrüsten |  |  |  | offen
2009-05-04 | Isolierung | kann beauftragt werden; Meßstellen müssen eh zugänglich bleiben |  |  | offen
2009-05-05 | analoge Ausgänge schalten sich ab bei Wechsel in Diag.Maske | seit 1V06 |  |  | offen |  | Absicht !
2009-05-05 | Fehler im Namestring des Datenprotokoll | Details in Datei mit Musterstring |  |  | erledigt |  | kann Kunde selbst ändern über Kanaldefinition
2009-05-05 | Gavurschilder an Feuchtemesser falsch: "A_AMB" | evtl. egal |  |  | offen
2009-05-05 | alle Aktoren abstellen wenn Regler aus | Momentan macht der "Haus-WT" voll auf |  |  | offen | CHL
2009-05-05 | Algorithmus für V1_AHU2 | Regler für Durchfluss NAHU2 zum Laufen bringen |  |  | offen | CHL | Grober Regler (3-Punkt) Default festwert 2000 m³/h
2009-05-05 | Algorithmus für V2_AHU2 |  |  |  | offen | CHL | Ähnlicher Algo wie bei NTPx-Regelklappen
2009-05-05 | Algorithmus für Trockner |  |  |  | offen
2009-05-05 | Algorithmus für Druck PD_TP |  | wird immer von Hand vorgegeben |  | erledigt
2009-05-05 | Zahlenformat für WT-Haus springt bei 100 in Scientific | Zahlenformat auf floating ändern |  |  | offen | CHL
2009-05-05 | Evtl. Reglerschalter (aus;an;stop;auf;zu;…??) in Meßmaske | zu diskutieren |  |  | offen |  | nice to have...
2009-05-05 | Differenzregelung des Gebäude "springt raus" bei Maskenwechsel | vermutlich von Diag -> Mess |  |  | offen | CHL | prinzipiell erstmal implementieren ! | Differnzregelung H auf abs. Feuchten.
2009-05-05 | Fernsteuerung über Softwareschnittstelle offen |  |  |  | offen | CHL
2009-05-05 | Istwertanzeige der E-Gasklappen immer 0,0% |  | Entfernen da kein Kanal |  | offen | CHL
2009-05-05 | Eurotherm-Werte bleiben wenn Softregler abgeschaltet wird |  |  |  | offen | CHL | kontrollieren
2009-05-05 | Umschaltung für Diff./Abs.-Regelung für T und H unabhängig |  |  |  | offen | CHL | Regler aufbohren für Differenzregelung
2009-05-05 | Evtl. "Überlapp" der T-Sollwerte einstellbar? | zu diskutieren |  |  | unklar |  | betrifft das den Offset unterkühlung ???
2009-05-05 | Reglerparameter teils ungünstig | zu diskutieren; evtl. erst am Schluß nochmal sinnvoll |  |  | offen
2009-05-05 | 32Q1 fliegt 5 min nach Einschalten raus | evtl. einmalig | Grenzwert erhöht auf 11,4 A |  | erledigt
2009-05-05 | Blatt 44 in Schaltplan: rechts oben steht "Enstellung" | evtl. einmalig | siehe nächste Version |  | erledigt
2009-05-05 | Befeuchter-Haus zeigt noch mehr als 100% an; der andere tuts nicht | evtl. einmalig | Reglerparameter "Ausgangsbegrenzung" |  | erledigt
2009-05-05 | Evtl. Warnungen einführen, wenn Sollzustände nicht erreichbar sind | evtl. einmalig |  |  | offen |  | nice to have...
2009-05-05 | Differenzregelung Haus: keine Anpassung von rH bei Änderung von T |  | bei nur T-Änderung rH nachziehen |  | offen | CHL | prinzipiell Differenzregelung erstmal implementieren ! |  | rel. Wird immer nachgezogen, außer bei direkter Eingabe rH
2009-05-05 | Heizer AHU1: laut Schaltplan 4kW / laut Maske 3kW ?? |  |  |  | offen | CHL | Ist 4kW-Heizung !
2009-05-06 | Beschriftung NAHU2 1250-4000 m³/h |  |  |  | offen | CHL
2009-05-06 | T Gebäude bei Regler aus hoher Sollwert an Kühler | sonst Kühler in Vollast -20..+60° |  |  | offen | CHL | Handling Diagnose (manuelles Setzen) ?? / T Umgebung mit prüfen
2009-05-06 | Analogausgänge VIPA zu T-reglern zappeln in Diagnose | konst wenn AA "eingeschaltet" | Überschreiber in Diag ? |  | offen | CHL | Überschreiber in Diag ?
2009-05-06 | Störmeldungen Texte der DI korrigieren | DI 08 Störung T-Regler |  |  | offen | CHL
2009-05-06 | Befeuchter Meldung Wasser nachfüllen im Regler berücksichtigen |  |  |  | offen | CHL
2009-05-06 | Sammelstörmeldung in Messmaske |  |  |  | offen | CHL
2009-05-06 | FU koppeln mit DP-Regler aktiv |  |  |  | offen | CHL
2009-05-06 | Istwert Trockner und EGAS weg, da keine Rückmeldung | Messmaske |  |  | offen | CHL
2009-05-06 | Sollwert M1 AHU2 als Leistung bezeichnen und grau |  |  |  | offen | CHL
2009-05-06 | Sollwert Trockner als Stufenschalter oder Toggle 0-25-50-75-100% |  |  |  | offen | CHL
2009-05-06 | AI-Simulator weg wenn hardware da |  |  |  | offen | CHL
