mho-jwi/MA/(B) Klimaprüfstand/Steuerung/P5507/Debugging/prellendes_Nachfuellsignal.JPG

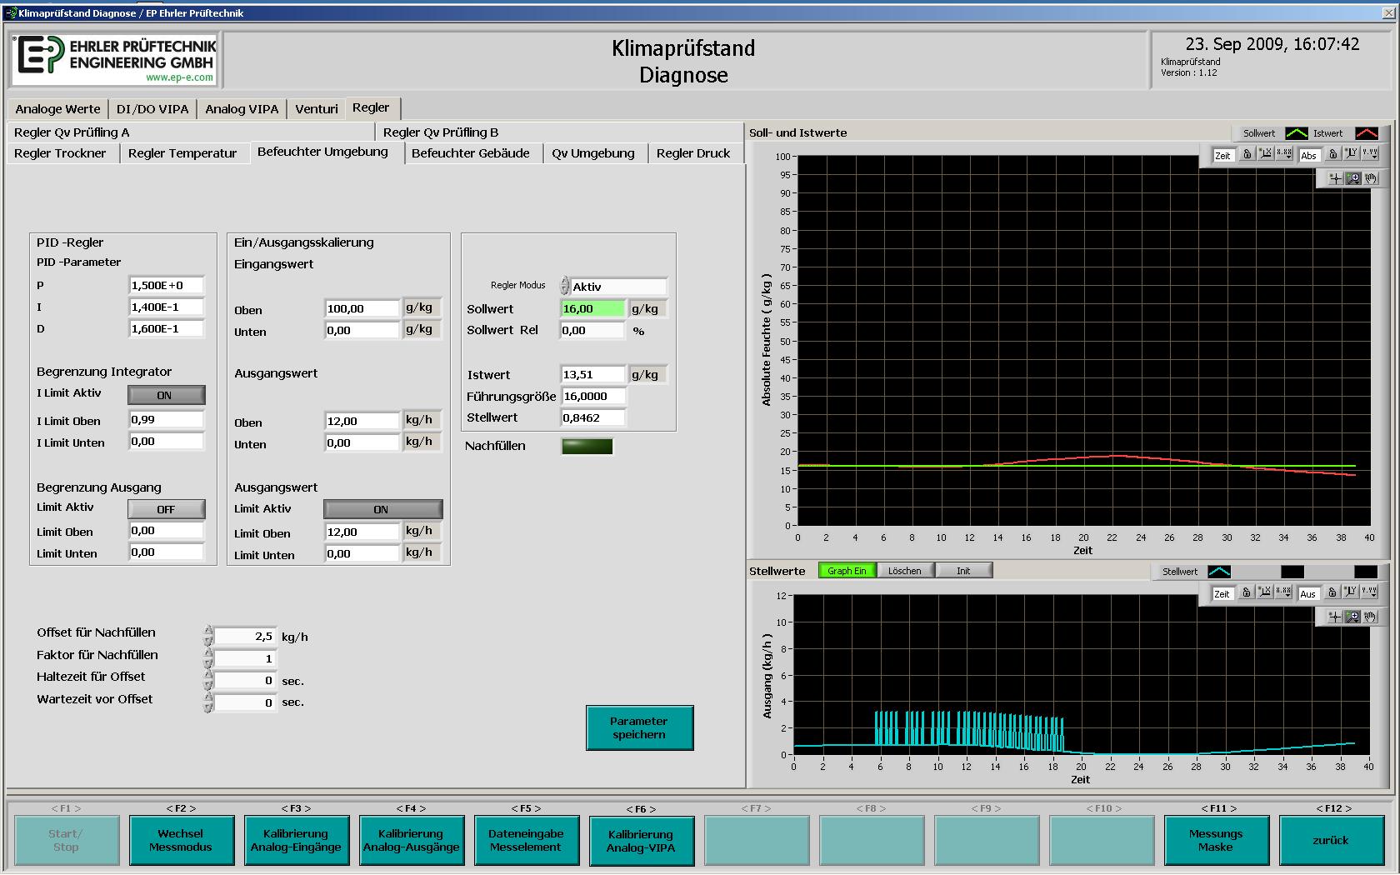
(B) Klimaprüfstand/Steuerung/P5507/Debugging/prellendes_Nachfuellsignal.JPG
