mho-jwi/MA/(B) Klimaprüfstand/Doku/Komponenten/Belimo/TR..A_LR..A_NR..A_SR..A_mounting_instruction.pdf

TR..A.. / LR..A.. / NR..A.. / SR..A..

1 2

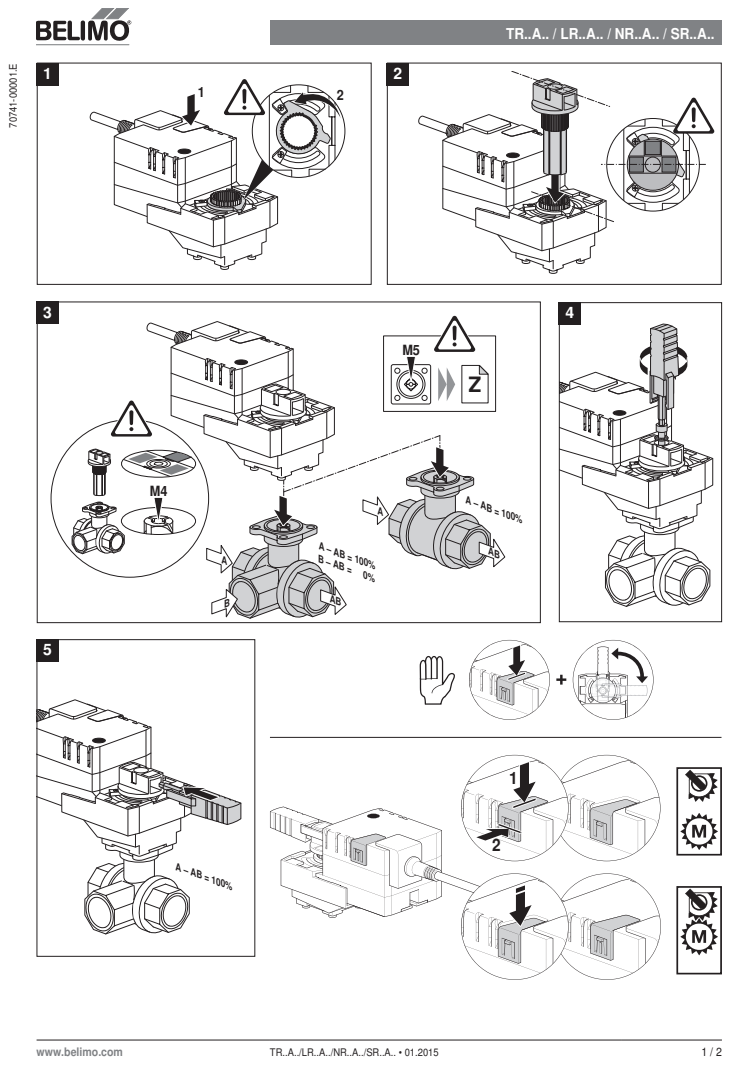
[picture p179: page 1]
www.belimo.com

TR..A.. / LR..A.. / NR..A.. / SR..A..

Y2

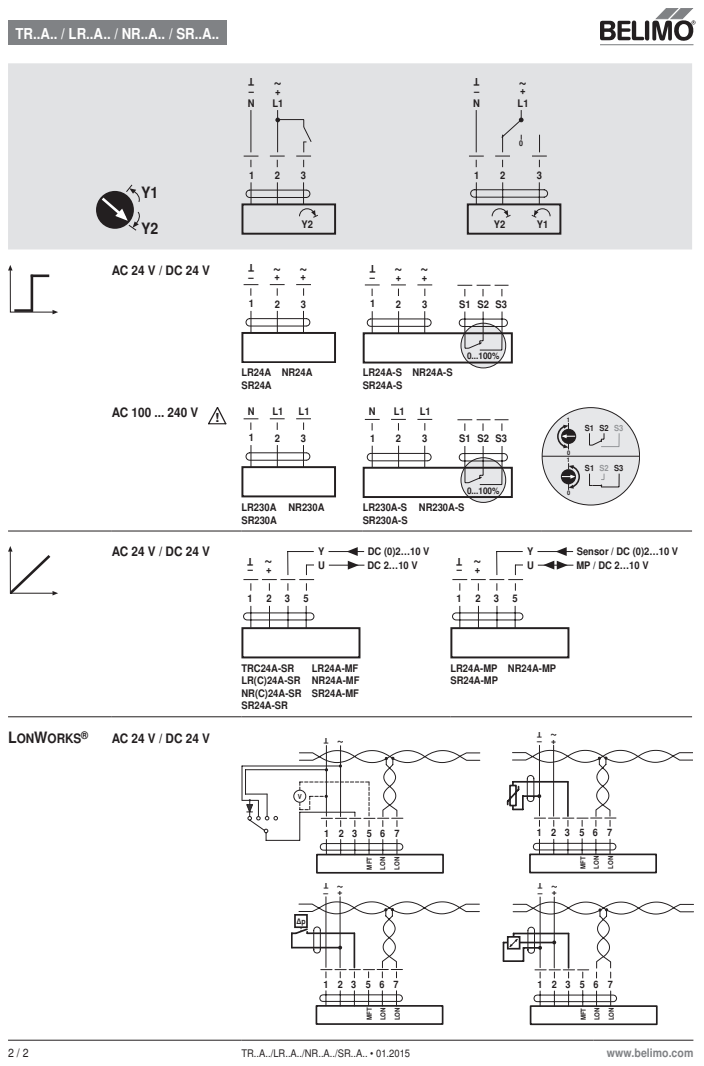
[picture p180: page 2]
www.belimo.com; Sensor / DC (0)2…10 V MP / DC 2…10 V; TRC24A-SR; LONWORKS®; 1 2 3 56 7 MFT; LON LON
