mho-jwi/MA/(commit log)

2016-06-21 first input
    [Herstelleriste.xlsx, Normenliste.xlsx, Versuchsplan.xlsx]
2016-06-21 beginn der Prüfstandbeschreibung für die Ausarbeitung
2016-06-22 infos vom Institutsrechner
    [Arbeitsmappe.xlsx, Baugruppe.SLDASM, Baugruppe2.SLDASM, Bodenplatte.SLDPRT, Bodenplatte2.SLDPRT, Deckenplatte.SLDPRT, Diagonalplatte1.SLDPRT, Diagonalplatte2.SLDPRT]
2016-06-27 Messreihen zur Feuchtesensorkalibrierung
    [20160624_Feuchtesensormessung.csv, 20160624_Feuchtesensormessung.csv.xlsx, 20160627_Feuchtesensormessungen.xlsx]
2016-06-28 update Kalibriermessungen
    [20160624_Feuchtesensormessung.csv.xlsx, 20160627_Feuchtesensormessungen.xlsx]
2016-07-30 aktuelle updates vom Laptop zur Masterarbeit
    [20160624_Feuchtesensormessung.csv.xlsx, 20160624_Feuchtesensormessung.xlsx, 20160627_Feuchtesensormessungen.xlsx, 20160701_V1.xlsx, 20160701_V1_Auswertung.xlsx, 20160701_V1_Auswertung0.xlsx, 20160701_V1_Auswertung2.xlsx, 20160701_V1_AuswertungM1.xlsx]
2016-08-06 current updates Laptop, 20160806
    [20160701_gemittelt_zusammengefasst.xlsx, 20160701_gemittelt_zusammengefasst_Auswertung_050816.xlsx, 20160701_gemittelt_zusammengefasst_Auswertung_0508162.xlsx, 20160701_gemittelt_zusammengefasst_Auswertung_Zhang1.xlsx, 20160701_gemittelt_zusammengefasst_Auswertung_Zhang_ue.xlsx, Fehler_ABL.xlsx, Fehler_ABL_din.xlsx, Fehler_AUL.xlsx]
2016-08-10 safety first
    [20160701_gemittelt_zusammengefasst_Auswertung_0508162.xlsx]
